pacman314159/OISP-Drone-Research/firmware/FC_v01/graphify-out/2026-10-23/GRAPH_REPORT.md

# Graph Report - FC_v01  (2026-10-23)

## Corpus Check
- 937 files · ~997,079 words
- Verdict: corpus is large enough that graph structure adds value.
- Unclassified: 425 file(s) not represented in the graph (top: .S 259, (none) 68, .defaults 16)

## Summary
- 7746 nodes · 16134 edges · 385 communities (295 shown, 90 thin omitted)
- Extraction: 85% EXTRACTED · 15% INFERRED · 0% AMBIGUOUS · INFERRED: 2412 edges (avg confidence: 0.85)
- Token cost: 0 input · 0 output

## Graph Freshness
- Built from commit: `1df59b29`
- Run `git rev-parse HEAD` and compare to check if the graph is stale.
- Run `graphify update .` after code changes (no API cost).

## Community Hubs (Navigation)
- dsp_err.h
- dsps_fft2r_sc16_ansi.c
- WS2812
- Mat
- string
- Image3DMatrix
- ESP32_I2C_ASYNC
- INA226
- Zettel 0013: Unified HAL_SPI Abstraction, 100 Hz Snapshot Logging & Multi-Rate MicroSD Storage
- BMP180
- FC_v01 Firmware Architecture & Structure Specification
- dl_tensor_base.cpp
- dl_image_define.hpp
- app.cpp
- Magnetometer Full Rotated Ellipsoid Calibration via SIMD-Accelerated Symmetric Gradient Descent
- Zettel 0016: Layer 4 Core Directory Compaction, Submodule Consolidation & Task Renaming Specification
- ESP32_SPI
- fsm.cpp
- Zettel 0032: Dual-Core 7-State Quaternion Extended Kalman Filter (EKF), SIMD Hardware Acceleration, Unit-Sphere Geomagnetic Fusion, and Inter-Task Attitude Ring Buffers
- HMC5883L
- stdint
- TensorBase
- tst_parser.cpp
- test_mat_sub_f32.cpp
- SDCardDriver
- Zettel 0008: Layer 4 LPF Filter & Calibration Task Architecture
- ipc.h
- dsps_fird_init_s16.c
- Vec3
- Attitude Outer Loop Task (100Hz)
- ekf
- MPU6050
- matrix.h
- ArgsType
- LowPassFilter2ndOrder
- kalman_filter_demo.cpp
- HAL_PulseRX
- dl_image_pixel_cvt_traits.hpp
- BlePowerPacket
- cJSON_bool
- HAL_Flash
- unity.c
- init_display.c
- ble_driver.cpp
- ESP-DSP Applications Layout
- arithArgsType
- Pad
- ESP-DSP Basic Math Example Guide
- cJSON.c
- RakefileHelpers
- HAL_PWM
- 3d_kalman_demo.cpp
- dsps_biquad_gen_f32.c
- cbor.h
- RingBuffer
- Firmware Coding Conventions & Architecture Rules
- IMU 9-DOF Sensor Fusion via Kalman Filter
- ESP-DSP Library Overview
- ESP-DSP FFT Window Example Guide
- Usage
- ESP-DSP SIMD Assembly Optimization
- ConvArgsType
- cstdint
- math
- ConvArgsType
- DetectPostprocessor
- unity.h
- cJSON_Delete
- tst_tojson.cpp
- m_test_data_s
- Zettel 0000: Firmware 5-Layer Architectural Decision & Directory Layout
- dl_module_lut.hpp
- elemwiseArgsType
- FC_v01 Architectural & Codebase Context Analysis Skill
- Rect
- sd_logger_task.cpp
- Zettel 0002: System 4 Priority Levels & Target-Agnostic HAL Decision
- FbsModel
- Zettel 0001: Centralized Task Config, Middleware ISR Callbacks & RMT PPM Decoding Decision
- rgb8882hsv
- ESP-DSP Examples Overview and Structure
- ESP-DSP FIR Filter Example Guide
- dl_module_base.hpp
- dl_image_jpeg.cpp
- PRelu
- resizeArgsType
- CPU Logo Converted 3D Matrix Image
- HSVTablesSingleton
- FFT
- cJSON_Utils.c
- Dual-Channel Audio FFT Processing Flow
- ESP-DSP Library Component Specification
- dl_audio_common.cpp
- dl_image_ppa.hpp
- module_forward_dual_core
- .get_element_ptr
- M5Stack CoreS3 Kalman Demo Component Registration
- build_all.sh
- value_to_pretty
- dspi_dotprod_off_s16_ansi
- dspi_dotprod_off_s8_ansi
- dspi_dotprod_off_u16_ansi
- dspi_dotprod_off_u8_ansi
- dspi_dotprod_s16_ansi
- dspi_dotprod_s8_ansi
- dspi_dotprod_u16_ansi
- dspi_dotprod_u8_ansi
- dspi_dotprod_f32_ansi
- dspi_dotprod_off_f32_ansi
- Model
- PixelKernel
- algorithm
- compile_finalize.py
- dsps_biquad_f32_ansi
- dl_model_base.cpp
- dl_base_add2d.cpp
- tst_Encoder
- Toolset Customization
- dl_base_div.cpp
- TensorInfo
- cborparser.c
- parse_number.c
- DetectImpl
- dsps_add_s16_ansi.c
- dl_base_sub2d.cpp
- dl_memory_manager.hpp
- fbs_loader.cpp
- bmp_file_header_t
- bmp_info_header_t
- SpeechFeatureConfig
- dl_fft_s16.c
- dsps_sub_s8_ansi.c
- dsps_sub_f32_ansi.c
- FeatImpl
- dl_detect_postprocessor.hpp
- dsps_dotprod.h
- compilersupport_p.h
- encoder/data.cpp
- ImageTransformer
- PoolArgsType
- dl_image_color_common.hpp
- FC_v01 CMake Project
- I2C1 Bus Mutex Guard
- Spectrum Box Lite CMake Project Definition
- dl_fbank.cpp
- MemoryChunk
- Usage
- .operator()
- cborencoder.c
- dl_fft_base.c
- HardSigmoid
- MemoryManagerGreedy
- cbortojson.c
- main
- AveragePool
- DataBase
- dl_power_of_two
- assembly.h
- LessOrEqual
- validate_value
- Dequantize
- ClsPostprocessor
- cJSON_Compare
- ClsImpl
- Integer Less Than / Greater Than
- ekf_imu13states.cpp
- process_frame
- cborinternal_p.h
- json2cbor.c
- dl_rfft_s32_run
- MULSHIFT32
- dl_base_max2d.cpp
- LSTM
- ESP32_PWM_LEDC
- parse_examples.c
- GRU
- dl_tool.hpp
- encodeVariant
- FbsLoader
- MP3Decode
- CMpaDecObj
- dumprecursive
- LpNormalization
- dl_base_conv_loop.cpp
- ReduceBase
- DualCoreWorkerRuntime
- ImagePreprocessor
- Transpose
- UnityToJUnit
- Arrays
- Each Equal (Arrays to Single Value)
- MatMulArgs
- dl_conv_args.hpp
- Matrix
- flash.cpp
- dl_base_norm.cpp
- Resize
- FeatImagePreprocessor
- ThrowTheSwitch.org Coding Standard
- Background and Overview
- dl_base_activate_output.hpp
- Latency
- pack_espdl_models.py
- MaxPool
- dl_model_context.cpp
- RMSNormalization
- dl_tool.cpp
- bitstream.c
- ActivationLUT
- Integer Ranges (of all sizes)
- SigmoidLUT
- LayerNormalization
- dl_module_reduce_log_sum_exp.hpp
- NormQuant<QuantType, 3>
- xy_map_t
- dl_fft2r_sc16_ansi.c
- dl_module_matmul.hpp
- dl_base_dwconv_loop.cpp
- dl_math.hpp
- Concat
- ScatterND
- ReduceMean
- unity_to_junit.py
- cJSON_Minify
- The Assertions in All Their Blessed Glory
- requantizeArgsType
- Slice
- ESP-DL
- ble_ota_uploader.py
- dl_base_avg_pool2d.cpp
- dl_module_reduce_base.hpp
- HAL_SPI
- Signed and Unsigned Integers (of all sizes)
- ESP-DL Audio Processing Module
- dl_base_min2d.cpp
- dl_base_mul2d.cpp
- array
- FbankS32
- dl_base_leakyrelu.cpp
- ReduceProd
- quant_type_to_string
- dl_base_prelu.cpp
- RGB8882RGB565
- Elu
- ParseOutput
- Double (If enabled)
- Floating Point (If enabled)
- Overview of the Documents
- dl_c_conv_tail.cpp
- Div
- Mod
- Less
- .print
- print_value.c
- Options accepted by generate_test_runner.rb:
- dl_base_pad.cpp
- dl_math_matrix.cpp
- Max
- And
- dl_base_relu.cpp
- HardSwish
- Greater
- GreaterOrEqual
- Sqrt
- Module
- Mul
- Not
- Swish
- ModelContext
- ReduceL2
- ReduceLogSum
- ReduceMin
- ReduceSum
- ReduceSumSquare
- feature_t
- Xor
- result_t
- LyraT Audio Processing Demo Guide
- dl_recognition_database.cpp
- dl_base_greater.cpp
- dl_base_pow.cpp
- dl_base_xor.cpp
- package.json
- dl_base_reduce.cpp
- UnityModuleGenerator
- Bmp180Calib
- RGB5652Gray<RGB565BE, RGBSwap, void>
- dl_audio_wav.cpp
- CBOR Example
- UnityTestSummary
- dl_base_pool2d.hpp
- dl_base_dotprod.cpp
- dl_base_isa.hpp
- Gray2Gray<ExtraProcess>
- RGB8882RGB888<RGBSwap, ExtraProcess>
- YUYV2Gray<YUYVOrUYVY, ExtraProcess>
- parse_simple_yaml
- pytest_cbor.py
- Boolean
- XtensaConvParams
- GlobalAveragePool
- esp_dsp.h
- RGB5652Gray<RGB565BE, RGBSwap, ExtraProcess>
- RGB5652HSV<RGB565BE, RGBSwap, ExtraProcess>
- RGB8882Gray<RGBSwap, ExtraProcess>
- YUYV2RGB888<YUYVOrUYVY, RGBSwap, ExtraProcess>
- bg_t
- Min
- Zettel 0015: BLE OTA Lifecycle Architecture, Resource Stewardship & Host Stack Decoupling
- ESP-DSP Complex FFT Example Guide
- misc_tests.c
- cJSON
- Masked and Bit-level Assertions
- dl_base_shape.cpp
- Gray2Gray<void>
- RGB5652RGB565
- RGB8882RGB888<RGBSwap, void>
- YUYV2Gray<YUYVOrUYVY, void>
- Or
- Sigmoid
- Sub
- ExponentInfo
- DecodeHuffman
- RGB5652RGB888<RGB565BE, RGBSwap, ExtraProcess>
- LogFileHeader
- dl_base_max_pool2d.cpp
- print_number.c
- YUYV2HSV<YUYVOrUYVY, ExtraProcess>
- dl_fft2r_sc16_dif_ansi.c
- Zettel 0007: SystemView Instrumentation & RTOS Profiling Conventions
- Security Policy
- RakefileHelpers
- Security Policy
- Building
- chmorgan__esp-libhelix-mp3/README.md
- update-docs.sh
- afl-prepare-linux.sh
- afl.sh script
- ossfuzz.sh
- dsps_conv_f32_ref
- FbsLoader::calc_package_sha256
- hand_gesture_cls_postprocessor.cpp
- dl_base_greaterorequal.cpp
- imagenet_cls_postprocessor.cpp
- dl_base_max.cpp
- RGB5652RGB888<RGB565BE, RGBSwap, void>
- dl_image_draw.cpp
- dsps_resampler_ph.c
- m5stack_core_s3/apps/3d_graphics/main/3d_graphics_demo.cpp
- dl_base_equal.cpp
- dl_base_min.cpp
- dl_base_mod.cpp
- dl_base_or.cpp
- dl_base_sub.cpp
- mem_info_s
- ChannelTracker
- dsps_add_s8_ansi.c
- dsps_add_f32_ansi.c
- dsps_mul_s8_ansi.c
- dsps_mul_f32_ansi.c
- dsps_sub_s16_ansi.c
- dspm_mult_ex_f32_ansi.c

## God Nodes (most connected - your core abstractions)
1. `Module` - 168 edges
2. `ModelContext` - 163 edges
3. `TensorBase` - 146 edges
4. `FbsModel` - 137 edges
5. `cJSON_Delete()` - 118 edges
6. `Mat` - 98 edges
7. `ArgsType` - 83 edges
8. `ConvArgsType` - 74 edges
9. `arithArgsType` - 73 edges
10. `ConvArgsType` - 71 edges

## Surprising Connections (you probably didn't know these)
- `EKF Process & UpdateRefMeasurement Recursion` --semantically_similar_to--> `EKF Roll & Pitch Task (100Hz)`  [INFERRED] [semantically similar]
  managed_components/espressif__esp-dsp/modules/kalman/ekf_imu13states/docs/README.md → documents/RTOS Architecture.pdf
- `4. Cross-References & Traceability` --references--> `motor_task()`  [INFERRED]
  documents/notes/0034-motorDriverLedcHalQuadxActuatorTaskArchitecture.md → src/core/actuator/motor_tasks.cpp
- `Zero Dynamic Allocation Flight Rule` --implements--> `accel_gyro_daq_task()`  [INFERRED]
  .agents/AGENTS.md → src/core/sensor/daq_tasks.cpp
- `System Life Cycle Document (Placeholder)` --conceptually_related_to--> `dspm_mult_ex_f32_aexx_functionality_in_cycle()`  [INFERRED]
  documents/System Life Cycle.md → managed_components/espressif__esp-dsp/modules/matrix/mul/test/test_mmult_ex_f32_aexx.cpp
- `Principle 2: Mediator & Composition Root Pattern (GoF)` --references--> `app_disarm_motors()`  [INFERRED]
  documents/notes/0035-emergencyMotorDisarmMediatorAndLawOfDemeterDecision.md → src/app/app.cpp

## Import Cycles
- None detected.

## Hyperedges (group relationships)
- **Cascaded Attitude Control Architecture** — documents_rtos_architecture_attitude_outer_loop, documents_rtos_architecture_attitude_inner_loop, documents_rtos_architecture_motor_mixer [EXTRACTED 0.95]
- **IMU Multi-Sensor Fusion Pipeline** — documents_rtos_architecture_accel_gyro_calib_filter, documents_rtos_architecture_mag_calib_filter, documents_rtos_architecture_ekf_roll_pitch, documents_rtos_architecture_ekf_yaw [EXTRACTED 0.95]
- **Sensor Data Acquisition and Ring Buffer Decoupling** — documents_rtos_architecture_accel_gyro_daq, documents_rtos_architecture_mag_daq, documents_rtos_architecture_baro_daq, documents_rtos_architecture_ring_buffer_newest_index_rule [EXTRACTED 0.95]
- **ESP-DSP Azure IoT Kit 3D Graphics Visualization Flow** — managed_components_espressif__esp_dsp_applications_azure_board_apps_apps_3d_graphics_3d_graphics_demo_animation, managed_components_espressif__esp_dsp_applications_azure_board_apps_apps_3d_graphics_3d_graphics_matrix_rendering, managed_components_espressif__esp_dsp_applications_azure_board_apps_apps_3d_graphics_readme_app_guide [EXTRACTED 1.00]
- **ESP-DSP Azure IoT Kit Kalman Filter Visualization Flow** — managed_components_espressif__esp_dsp_applications_azure_board_apps_apps_kalman_filter_kalman_filter_demo_animation, managed_components_espressif__esp_dsp_applications_azure_board_apps_apps_kalman_filter_kalman_filter_attitude_estimation, managed_components_espressif__esp_dsp_applications_azure_board_apps_apps_kalman_filter_readme_imu_sensor_fusion [EXTRACTED 1.00]
- **ESP-DSP Core Digital Signal Processing Primitives** — managed_components_espressif__esp_dsp_readme_matrix_operations, managed_components_espressif__esp_dsp_readme_fft, managed_components_espressif__esp_dsp_readme_iir_filter, managed_components_espressif__esp_dsp_readme_fir_filter, managed_components_espressif__esp_dsp_readme_vector_math, managed_components_espressif__esp_dsp_readme_kalman_filter [EXTRACTED 1.00]
- **Dual-Microphone Real-Time Audio Visualizer Pipeline** — managed_components_espressif__esp_dsp_applications_spectrum_box_lite_readme_overview, managed_components_espressif__esp_dsp_applications_spectrum_box_lite_readme_audio_pipeline, managed_components_espressif__esp_dsp_applications_spectrum_box_lite_main_idf_component_lvgl_dep [EXTRACTED 1.00]
- **ESP-DSP 3D Matrix Transformation and Projection Pipeline** — managed_components_espressif__esp_dsp_applications_azure_board_apps_readme_mat_3d_projection, managed_components_espressif__esp_dsp_applications_azure_board_apps_graphics_img_to_3d_matrix_example_readme_img_to_3d_pipeline, managed_components_espressif__esp_dsp_applications_m5stack_core_s3_apps_3d_graphics_main_cmakelists_component [INFERRED 0.95]
- **ESP-DSP Digital Filtering and Estimation Examples** — managed_components_espressif__esp_dsp_examples_fir_readme_windowed_sinc_fir, managed_components_espressif__esp_dsp_examples_iir_readme_biquad_iir_filter, managed_components_espressif__esp_dsp_examples_kalman_readme_13_state_ekf [INFERRED 0.95]
- **ESP-DSP IMU Kalman Filter Sensor Fusion Demonstrations** — managed_components_espressif__esp_dsp_readme_kalman_filter, managed_components_espressif__esp_dsp_applications_azure_board_apps_apps_kalman_filter_readme_imu_sensor_fusion, managed_components_espressif__esp_dsp_applications_m5stack_core_s3_apps_kalman_filter_readme_bmi270_bmm150_fusion [INFERRED 0.95]
- **ESP-DSP SIMD Vector and Matrix Operations Examples** — managed_components_espressif__esp_dsp_examples_dotprod_readme_vector_dot_product, managed_components_espressif__esp_dsp_examples_basic_math_readme_vector_multiplication, managed_components_espressif__esp_dsp_examples_conv2d_readme_2d_convolution, managed_components_espressif__esp_dsp_examples_matrix_cmakelists_matrix_acceleration, managed_components_espressif__esp_dsp_readme_simd_assembly_optimization [INFERRED 0.95]
- **ESP-DSP Frequency Analysis and FFT Windowing Examples** — managed_components_espressif__esp_dsp_examples_fft_readme_complex_fft_split, managed_components_espressif__esp_dsp_examples_fft4real_readme_real_fft, managed_components_espressif__esp_dsp_examples_fft_window_readme_windowing_functions, managed_components_espressif__esp_dsp_readme_fft [INFERRED 0.95]

## Communities (385 total, 90 thin omitted)

### Community 0 - "dsp_err.h"
Cohesion: 0.04
Nodes (13): dspi_conv_f32_ansi(), dsps_ccorr_f32_ansi(), dsps_conv_f32_ansi(), dsps_corr_f32_ansi(), dsps_cplx2real_fc32_ae32_(), dsps_addc_f32_ansi(), dsps_mulc_s16_ansi(), dsps_sqrt_f32_ansi() (+5 more)

### Community 1 - "dsps_fft2r_sc16_ansi.c"
Cohesion: 0.06
Nodes (43): microphone_read_task(), app_main(), ShowIIRfilter(), dsp_is_power_of_two(), dsp_power_of_two(), dsps_bit_rev_sc16_ansi(), dsps_cplx2real_sc16_ansi(), dsps_cplx2reC_sc16() (+35 more)

### Community 2 - "WS2812"
Cohesion: 0.05
Nodes (44): status_led_task(), Color, b, g, r, get_palette_color(), WS2812, brightness (+36 more)

### Community 3 - "Mat"
Cohesion: 0.04
Nodes (64): ekf::dFdq(), ekf::dFdq_inv(), ekf::eul2rotm(), ekf::qProduct(), ekf::quat2eul(), ekf::quat2rotm(), ekf::rotm2eul(), ekf::SkewSym4x4() (+56 more)

### Community 4 - "string"
Cohesion: 0.08
Nodes (20): "ekf_imu13states functionality gyro and magn", "ekf_imu13states functionality gyro only", "dspm_add_f32_ae32 benchmark", "dspm_add_f32_ae32 functionality", "dspm_add_f32_ansi benchmark", "dspm_add_f32_ansi functionality", "dspm_addc_f32_ansi benchmark", "Mat class " (+12 more)

### Community 5 - "Image3DMatrix"
Cohesion: 0.09
Nodes (6): convert_img(), create_matrix(), fromat_comas_spaces(), Image3DMatrix, main(), ouptput_files_gen()

### Community 6 - "ESP32_I2C_ASYNC"
Cohesion: 0.09
Nodes (22): ESP32_I2C_ASYNC, ESP32_I2C_ASYNC::ESP32_I2C_ASYNC(), _frequency_hz, init, _initialized, _port, read_reg_async, read_reg_multi_async (+14 more)

### Community 7 - "INA226"
Cohesion: 0.08
Nodes (31): INA226, calibrate, _current_lsb_ma, _dev_addr, get_all_data, get_all_data_raw, INA226::INA226(), init (+23 more)

### Community 8 - "Zettel 0013: Unified HAL_SPI Abstraction, 100 Hz Snapshot Logging & Multi-Rate MicroSD Storage"
Cohesion: 0.15
Nodes (11): 4-Digit Incremental File Scheme (LOG_0001.BIN) & LogFileHeader, Zettel 0013: Unified HAL_SPI Abstraction, 100 Hz Snapshot Logging & Multi-Rate MicroSD Storage, 512-Byte Self-Describing Sector-Aligned Binary Log Header (LogFileHeader), Hardware USER Button 3-Second Hold Graceful Shutdown Protocol, Zettel 0018: MicroSD Flight Logging Architecture, POSIX Metadata Sync, User Button Shutdown & Binary Log Specification, Multi-Rate Binary Telemetry Timestamp Alignment and Interpolation, Universal Flight Data Analyzer Offline Multi-Channel Processing Pipeline, Zettel 0019: Universal Flight Data Analyzer Architecture, Binary Telemetry 4-Byte Struct Alignment & Offline Multi-Rate Signal Processing Pipeline (+3 more)

### Community 9 - "BMP180"
Cohesion: 0.12
Nodes (18): baro_daq_task(), BMP180, _b5, BMP180::BMP180(), calculate_b5, calculate_pressure, calculate_temperature, _calib (+10 more)

### Community 10 - "FC_v01 Firmware Architecture & Structure Specification"
Cohesion: 0.17
Nodes (7): Deterministic Periodic Delay Policy via vTaskDelayUntil, ESP-DSP Hardware SIMD Primitive Integration, ESP32-S3 RMT Hardware PPM RC Receiver Decoding, Layer 1 SIMD HAL Zero-Fallback Hardware Purity Rule, FC_v01 Firmware Architecture & Structure Specification, Centralized Task Parameter Enums in config.h, Firmware Structure Zettelkasten Traceability Index

### Community 11 - "dl_tensor_base.cpp"
Cohesion: 0.09
Nodes (25): analyze_transpose_2d(), dtype_sizeof(), dtype_to_string(), _flip(), is_compact_row_major(), is_nan(), quantize(), _slice() (+17 more)

### Community 12 - "dl_image_define.hpp"
Cohesion: 0.10
Nodes (14): read_bmp(), write_bmp(), write_bmp_base(), align_up(), get_pix_byte_size(), get_pix_channel_num(), img_s, data (+6 more)

### Community 13 - "app.cpp"
Cohesion: 0.06
Nodes (21): Dedicated Task Mapping in src/core/telemetry/ble_telem_tasks.cpp, app_start(), fsm_init(), motor_task(), user_button_init(), ekf_roll_pitch_task(), ekf_yaw_task(), calib_save_to_nvs() (+13 more)

### Community 14 - "Magnetometer Full Rotated Ellipsoid Calibration via SIMD-Accelerated Symmetric Gradient Descent"
Cohesion: 0.14
Nodes (15): Empirical Flight Data Calibration Results & Universal Flight Analyzer Verification, ESP32-S3 128-Bit PIE SIMD Vector Dot Product Acceleration, Multivariate Analytical Gradient Derivation for Ellipsoid Optimization, Magnetometer Full Rotated Ellipsoid Calibration via SIMD-Accelerated Symmetric Gradient Descent, Real-Time Flight Loop Matrix-Vector Ellipsoid Correction, 6-Parameter Symmetric Soft-Iron Matrix Formulation, 3D Rotated Ellipsoid to Unit-Sphere Mapping Formulation, Time-Sliced SIMD Adam Gradient Descent Optimizer for Ellipsoid Fitting (+7 more)

### Community 15 - "Zettel 0016: Layer 4 Core Directory Compaction, Submodule Consolidation & Task Renaming Specification"
Cohesion: 0.13
Nodes (14): Centralized UUID Service & Characteristic Series (include/config.h), Zettel 0009: Distinct BLE GATT Characteristic UUID Isolation per Telemetry & OTA Stream Decision, Centralized Frequency Floor (BLE_TELEM_MIN_PACKET_FREQ_HZ = 10), Zettel 0010: BLE Minimum Packet Frequency and Dual-Trigger Transmission Protocol, Dynamic User-Configured Sample Stride Architecture in FCDatMon, Zettel 0011: Variable BLE Telemetry Packet Parsing and Zero-Handshake Design, Layer 4 Core Consolidation into 6 Unified Functional Domains, Zettel 0016: Layer 4 Core Directory Compaction, Submodule Consolidation & Task Renaming Specification (+6 more)

### Community 16 - "ESP32_SPI"
Cohesion: 0.15
Nodes (16): ESP32_SPI, ESP32_SPI::ESP32_SPI(), get_free_bytes, get_total_bytes, init, _initialized, is_card_inserted, is_fatfs_mounted (+8 more)

### Community 17 - "fsm.cpp"
Cohesion: 0.13
Nodes (32): Rule 5: Immediate Emergency Motor Disarm & FSM Integration, 3. Core Architectural Decisions & Governing Principles, Principle 1: Law of Demeter (Principle of Least Knowledge), Principle 2: Mediator & Composition Root Pattern (GoF), Principle 3: Single Responsibility Principle (SRP), Principle 4: Fail-Safe Defaults (Saltzer & Schroeder / Aviation Safety), app_disarm_motors(), check_match_policy() (+24 more)

### Community 18 - "Zettel 0032: Dual-Core 7-State Quaternion Extended Kalman Filter (EKF), SIMD Hardware Acceleration, Unit-Sphere Geomagnetic Fusion, and Inter-Task Attitude Ring Buffers"
Cohesion: 0.11
Nodes (19): Zettel 0003: Layer 1 SIMD HAL Architecture & Zero-Fallback Rule, ESP-DSP Multi-Type SIMD Integration, Layer 1 hal_simd Multi-Type Hardware SIMD Acceleration (float, int16_t, int8_t), Zettel 0004: Multi-Type SIMD Acceleration & ESP-DSP Build Integration, Persistent Storage of Sensor Calibration Offsets and Matrices in NVS Flash, Layer 1 Target-Decoupled HAL_Flash and Layer 2 FlashStorageDriver, Hardware SIMD Vector Hadamard Product Sensor Bias and Scale Correction, Zettel 0024: Internal Flash NVS Storage HAL, FlashStorageDriver & Diagonal Soft-Iron SIMD Calibration Persistence (+11 more)

### Community 19 - "HMC5883L"
Cohesion: 0.10
Nodes (17): Real-Time Flight Loop Calibration (m_calib = W * (m_raw - v0)), HMC5883L, _dev_addr, get_all_data, get_all_data_raw, HMC5883L::HMC5883L(), init, _inv_mag_sens (+9 more)

### Community 20 - "stdint"
Cohesion: 0.05
Nodes (17): image_3d_matrix_s, matrix_len, audio_read_task(), convert_float2short(), convert_short2float(), digitalLimiter(), convert_to_rgb(), image_display_task() (+9 more)

### Community 21 - "TensorBase"
Cohesion: 0.03
Nodes (39): cjson_array_foreach_should_loop_over_arrays(), forward_template(), Gather, m_axis, m_indices, forward_template(), forward_template(), Reshape (+31 more)

### Community 22 - "tst_parser.cpp"
Cohesion: 0.04
Nodes (79): cbor_error_string(), addChunkedStringData(), addColumns(), addEmptyContainersData(), addFixedData(), addIntegers(), addMapMixedData(), addNonChunkedStringsData() (+71 more)

### Community 23 - "test_mat_sub_f32.cpp"
Cohesion: 0.16
Nodes (28): System Life Cycle Document (Placeholder), Copy, Get, getROI, inverse, pinv, test_assert_check_area_mat_mat(), test_assert_equal_mat_mat() (+20 more)

### Community 24 - "SDCardDriver"
Cohesion: 0.12
Nodes (20): Autonomous 100 Hz Periodic Task & Zero-Overhead Ring Buffer Snapshot Draining (sd_logger_task), append_packet(), sd_logger_task(), SDCardDriver, _bytes_written, _cd_pin, close, _cs_pin (+12 more)

### Community 25 - "Zettel 0008: Layer 4 LPF Filter & Calibration Task Architecture"
Cohesion: 0.15
Nodes (11): BLE Characteristic UUID Isolation Reference, Dual Execution Engine (SIMD vs Scalar LPF), IPC Clean Variable Naming & Ring Buffer Consolidation, Layer 4 DSP Filter & Calibration Scoping Rule, Zettel 0008: Layer 4 LPF Filter & Calibration Task Architecture, Harmonized Sensor Ring Buffer Architecture (accel, gyro, mag), Unification of Barometer Pressure Ring Buffer, Zettel 0022: Unified Pressure Ring Buffer, Filtered Sensor Variable Consolidation & Phantom Attitude Task Removal (+3 more)

### Community 26 - "ipc.h"
Cohesion: 0.06
Nodes (26): CalibReportMsg, current_step, progress_pct, status, target, timestamp_us, FlashStorageDriver, LedCommand (+18 more)

### Community 27 - "dsps_fird_init_s16.c"
Cohesion: 0.06
Nodes (16): dsps_16_array_rev(), dsps_fird_init_s16(), dsps_fird_s16_aexx_free(), dsps_firmr_init_s16(), dsps_fir_f32_ansi(), dsps_fir_f32_free(), dsps_fir_init_f32(), dsps_firmr_init_f32() (+8 more)

### Community 28 - "Vec3"
Cohesion: 0.12
Nodes (23): Layer 4 Matrix<T, ROWS, COLS> Template Architecture, Unified Matrix<T, ROWS, COLS> Template Architecture, AttitudeEKF, AttitudeEKF::AttitudeEKF(), _earth_bx, _earth_bz, get_euler_angles, get_gyro_bias (+15 more)

### Community 29 - "Attitude Outer Loop Task (100Hz)"
Cohesion: 0.12
Nodes (19): Accel Gyro Calib & Filter Task (250Hz), Accel Gyro DAQ Task (500Hz), Altitude & Vz Estimator Task (100Hz), Attitude Inner Loop Task (250Hz, 4 Pri), Attitude Outer Loop Task (100Hz), Barometer Calib & Filter Task, Barometer DAQ Task, EKF Roll & Pitch Task (100Hz) (+11 more)

### Community 30 - "ekf"
Cohesion: 0.06
Nodes (36): image_3d_matrix_kalman_s, ekf13, matrix_len, ekf::RungeKutta(), ekf_imu13states::Test(), ekf_imu13states, accel0, Init (+28 more)

### Community 31 - "MPU6050"
Cohesion: 0.05
Nodes (33): 500 Hz Core IMU Loop Frequency Rule, BLE Telemetry 500 Hz Non-Blocking Data Flow, GyroTelemetrySample IPC Data Contract, 5-Layer Decoupled Firmware Architecture, Layer 1: Platform HAL & Hardware Target Drivers, Layer 2: Sensor & Peripheral Drivers Layer, Layer 4: Flight Core & Algorithms Layer, Layer 5: Application Layer (+25 more)

### Community 32 - "matrix.h"
Cohesion: 0.28
Nodes (8): dot(), hadamard(), inverse3x3(), Matrix, norm(), norm_sq(), normalize(), operator+()

### Community 33 - "ArgsType"
Cohesion: 0.03
Nodes (64): ArgsType, activation_alpha, activation_alpha_ptr, activation_shift, activation_type, auto_split, bias_element, c_div_x_1 (+56 more)

### Community 34 - "LowPassFilter2ndOrder"
Cohesion: 0.09
Nodes (26): Tustin Bilinear 1st-Order Low-Pass Filter State (LowPassFilter1stOrder), ButterworthFilter, LowPassFilter1stOrder, a, b, initialized, x_prev, y_prev (+18 more)

### Community 35 - "kalman_filter_demo.cpp"
Cohesion: 0.18
Nodes (14): app_fbm320_init(), app_mag3110_init(), app_main(), app_ssd1306_init(), display_3d_image(), draw_3d_image(), get_initial_pressure(), get_pressure_task() (+6 more)

### Community 36 - "HAL_PulseRX"
Cohesion: 0.09
Nodes (21): PktRc, channels, _pad, timestamp_us, type, FS_iA6B, FS_iA6B::FS_iA6B(), init (+13 more)

### Community 37 - "dl_image_pixel_cvt_traits.hpp"
Cohesion: 0.02
Nodes (96): hsv_mask_extra_traits, hsv_mask_extra_traits<DL_IMAGE_PIX_CVT_BGR565BE2HSV_MASK, Across>, hsv_mask_extra_traits<DL_IMAGE_PIX_CVT_BGR565LE2HSV_MASK, Across>, hsv_mask_extra_traits<DL_IMAGE_PIX_CVT_BGR8882HSV_MASK, Across>, hsv_mask_extra_traits<DL_IMAGE_PIX_CVT_RGB565BE2HSV_MASK, Across>, hsv_mask_extra_traits<DL_IMAGE_PIX_CVT_RGB565LE2HSV_MASK, Across>, hsv_mask_extra_traits<DL_IMAGE_PIX_CVT_RGB8882HSV_MASK, Across>, hsv_mask_extra_traits<DL_IMAGE_PIX_CVT_UYVY2HSV_MASK, Across> (+88 more)

### Community 38 - "BlePowerPacket"
Cohesion: 0.25
Nodes (6): BlePowerPacket, current_ma, energy_mah, power_mw, timestamp, voltage_mv

### Community 39 - "cJSON_bool"
Cohesion: 0.19
Nodes (23): buffer_skip_whitespace(), cJSON_ParseWithLengthOpts(), cJSON_PrintBuffered(), compare_double(), ensure(), get_decimal_point(), parse_array(), parse_hex4() (+15 more)

### Community 40 - "HAL_Flash"
Cohesion: 0.16
Nodes (14): FlashStorageDriver, calculate_crc32, erase_namespace, erase_record, init, _initialized, read_record, write_record (+6 more)

### Community 41 - "unity.c"
Cohesion: 0.08
Nodes (63): announceTestRun(), groupSelected(), isOverrun(), release_memory(), selected(), testSelected(), unity_calloc(), unity_free() (+55 more)

### Community 42 - "init_display.c"
Cohesion: 0.19
Nodes (9): bsp_display_lcd_init(), bsp_enable_feature(), bsp_i2c_init(), bsp_spi_init(), display_init(), dsp_display_brightness_init(), dsp_display_new(), dsp_display_start_with_config() (+1 more)

### Community 43 - "ble_driver.cpp"
Cohesion: 0.08
Nodes (24): Layer 4 Task Identity Preservation (TASK_BLE_OTA_ID), app_suspend_all_tasks(), ble_ota_task(), BleTelemetryChannel, _last_ingested_ts, _last_send_tick, _mask_bit, _payload_buf (+16 more)

### Community 45 - "ESP-DSP Applications Layout"
Cohesion: 0.24
Nodes (11): esp-dsp-azure-board-app-3d-graphics Project, Azure 3D Graphics Demo Application Guide, ImgTo3D Generation Example Guide, ImgTo3D 2D to 3D Matrix Generator Pipeline, ESP-DSP Azure IoT Kit Demo Applications, ESP-DSP Mat Matrix 3D Projection & Transformation, esp-dsp-m5stack-3d-graphics Project, M5Stack Core S3 3D Graphics Main Component (+3 more)

### Community 46 - "arithArgsType"
Cohesion: 0.04
Nodes (49): arithArgsType, activation_alpha, activation_alpha_ptr, activation_shift, activation_type, c_div_2x_1, c_div_x_1, c_left_x_1 (+41 more)

### Community 47 - "Pad"
Cohesion: 0.18
Nodes (5): Pad, m_constant_value, m_mode, m_pads, pad

### Community 48 - "ESP-DSP Basic Math Example Guide"
Cohesion: 0.15
Nodes (11): ESP-DSP Basic Math Example Project, ESP-DSP Basic Math Main Component, ESP-DSP Basic Math Component Dependency Manifest, ESP-DSP Basic Math Example Guide, ESP-DSP Vector Multiplication Operations (dsps_mul_f32, dsps_mulc_f32), ESP-DSP Dot Product Example Project, ESP-DSP Dot Product Main Component, ESP-DSP Dot Product Component Dependency Manifest (+3 more)

### Community 49 - "cJSON.c"
Cohesion: 0.09
Nodes (78): add_item_to_array(), add_item_to_object(), case_insensitive_strcmp(), cast_away_const(), cJSON_AddItemReferenceToArray(), cJSON_AddItemReferenceToObject(), cJSON_AddItemToArray(), cJSON_AddItemToObject() (+70 more)

### Community 50 - "RakefileHelpers"
Cohesion: 0.05
Nodes (9): colour_print(), colour_puts(), ColourCommandLine, report(), UnityTestRunnerGenerator, TypeSanitizer, UnityTestSummary, RakefileHelpers (+1 more)

### Community 51 - "HAL_PWM"
Cohesion: 0.07
Nodes (35): 1. Metadata & Scope, 2. Problem Statement & Motivation, 3. Core Architectural Decisions, 4. Cross-References & Traceability, Rule 1: Layer 1 Platform HAL Abstraction (`HAL_PWM` & `ESP32_PWM_LEDC`), Rule 2: Layer 2 Motor Peripheral Driver (`MotorDriver`), Rule 3: Layer 3 Inter-Task IPC (`IndiControllerOutput`), Rule 4: Layer 4 Actuator Domain (`src/core/actuator/motor_tasks.cpp/.h`) (+27 more)

### Community 52 - "3d_kalman_demo.cpp"
Cohesion: 0.10
Nodes (25): ESP-DSP Changelog Document, app_main(), app_ssd1306_init(), dispaly_esp_text(), display_3d_image(), draw_3d_image_task(), init_3d_matrix_struct(), init_perspective_matrix() (+17 more)

### Community 53 - "dsps_biquad_gen_f32.c"
Cohesion: 0.26
Nodes (12): audio_process_task(), buttons_process_task(), dsps_biquad_gen_allpass180_f32(), dsps_biquad_gen_allpass360_f32(), dsps_biquad_gen_bpf0db_f32(), dsps_biquad_gen_bpf_f32(), dsps_biquad_gen_highShelf_f32(), dsps_biquad_gen_hpf_f32() (+4 more)

### Community 54 - "cbor.h"
Cohesion: 0.11
Nodes (47): dumpbytes(), example_dump_cbor_buffer(), indent(), _cbor_encoder_get_buffer_pointer(), cbor_value_begin_string_iteration(), cbor_value_copy_byte_string(), cbor_value_copy_text_string(), cbor_value_dup_byte_string() (+39 more)

### Community 55 - "RingBuffer"
Cohesion: 0.23
Nodes (3): RingBuffer, _buffer, _head

### Community 56 - "Firmware Coding Conventions & Architecture Rules"
Cohesion: 0.15
Nodes (12): Firmware Coding Conventions & Architecture Rules, Single-Line Control Flow & No-Space Bracing Style, Centralized Task Parameters Rule, Coding Conventions & Architecture Rules, Explicit Physical SI Units Rule, SystemView Tracing & RTOS Timing Conventions, FreeRTOS Task Scoping Architecture Rule, Max Ducson (Chief Mechatronics Engineer) (+4 more)

### Community 57 - "IMU 9-DOF Sensor Fusion via Kalman Filter"
Cohesion: 0.17
Nodes (12): ESP32-Azure IoT Kit 3D Graphics Demo Animation, 3D Matrix Transformation and Projection on LCD, esp-dsp-azure-board-app-kalman-filter Project, Real-Time 3D Attitude Estimation and Sensor Fusion Display, ESP32-Azure IoT Kit Kalman Filter IMU Demo Animation, Azure Kalman Filter Main Component, Azure Kalman Filter IDF Component Manifest, Azure Kalman Filter Demo Application Guide (+4 more)

### Community 58 - "ESP-DSP Library Overview"
Cohesion: 0.25
Nodes (8): ESP-DSP Pre-Commit Hook Configurations, Azure 3D Graphics Main Component, Azure 3D Graphics IDF Component Manifest, LyraT Audio App Project, LyraT Audio Main Component, LyraT Audio IDF Component Manifest, ESP-DSP Contribution Guide, ESP-DSP Library Overview

### Community 59 - "ESP-DSP FFT Window Example Guide"
Cohesion: 0.15
Nodes (11): ESP-DSP Real Input FFT Example Project, ESP-DSP Real Input FFT Main Component, ESP-DSP Real Input FFT Component Dependency Manifest, ESP-DSP Real Input FFT Example Guide, Real Input Fast Fourier Transform (dsps_fft4r_fc32), ESP-DSP FFT Window Example Project, ESP-DSP FFT Window Main Component, ESP-DSP FFT Window Component Dependency Manifest (+3 more)

### Community 60 - "Usage"
Cohesion: 0.08
Nodes (24): Building, C Standard, Case Sensitivity, Caveats, Character Encoding, cJSON, CMake, copying the source (+16 more)

### Community 61 - "ESP-DSP SIMD Assembly Optimization"
Cohesion: 0.29
Nodes (5): ESP-DSP 2D Convolution Example Project, ESP-DSP 2D Convolution Main Component, ESP-DSP 2D Convolution Component Dependency Manifest, ESP-DSP 2D Convolution Image Processing (dspi_conv_f32), ESP-DSP 2D Convolution Example Guide

### Community 62 - "ConvArgsType"
Cohesion: 0.03
Nodes (65): ConvArgsType, activation_alpha, activation_alpha_ptr, activation_shift, activation_type, auto_split, bias_element, c_div_x_1 (+57 more)

### Community 63 - "cstdint"
Cohesion: 0.05
Nodes (32): Layer 3: Middleware & Centralized Inter-Task IPC Layer, Centralized Inter-Task IPC in Layer 3 (src/middleware/), FlashRecordHeader, crc32, magic, payload_len, schema_ver, BleAttQuatPacket (+24 more)

### Community 64 - "math"
Cohesion: 0.04
Nodes (27): WinMain(), void(), AssertEqualExampleStruct(), app_main(), process_and_show(), app_main(), app_main(), app_main() (+19 more)

### Community 65 - "ConvArgsType"
Cohesion: 0.03
Nodes (85): can_split_conv_width(), conv_1x1_body_view(), conv_buffer_bytes(), conv_each_1x1_pad(), conv_feature_bytes(), conv_filter_bytes(), conv_full_window_end(), conv_has_padding() (+77 more)

### Community 66 - "DetectPostprocessor"
Cohesion: 0.15
Nodes (8): DetectPostprocessor, m_box_list, m_image_preprocessor, m_model, m_nms_thr, m_score_thr, m_top_k, postprocess

### Community 67 - "unity.h"
Cohesion: 0.05
Nodes (59): reset(), sort_tests(), assert_is_array(), assert_not_array(), assert_parse_array(), parse_array_should_not_parse_non_arrays(), parse_array_should_parse_arrays_with_multiple_elements(), parse_array_should_parse_arrays_with_one_element() (+51 more)

### Community 68 - "cJSON_Delete"
Cohesion: 0.06
Nodes (84): cJSON_AddArrayToObject(), cJSON_AddBoolToObject(), cJSON_AddFalseToObject(), cJSON_AddNullToObject(), cJSON_AddNumberToObject(), cJSON_AddObjectToObject(), cJSON_AddRawToObject(), cJSON_AddStringToObject() (+76 more)

### Community 69 - "tst_tojson.cpp"
Cohesion: 0.08
Nodes (40): addByteStringsData(), addColumns(), addEmptyContainersData(), addFixedData(), addNonJsonData(), addTextStringsData(), compareMetaData(), compareOne_real() (+32 more)

### Community 70 - "m_test_data_s"
Cohesion: 0.18
Nodes (11): m_test_data_s, A_start_col, A_start_row, B_start_col, B_start_row, C_start_col, C_start_row, k (+3 more)

### Community 71 - "Zettel 0000: Firmware 5-Layer Architectural Decision & Directory Layout"
Cohesion: 0.17
Nodes (9): Custom Dual OTA Partition Scheme (8MB Layout), Project: FC_v01 Firmware & 5-Layer RTOS Architecture, 5-Layer Decoupled RTOS Architecture Project Scope, Centralized Interface Contracts (config.h, ipc.h, ble_driver.h), Sarah Thueson (Embedded Software Architect), 5-Layer Decoupled Firmware Architecture Decision, FreeRTOS Task Scoping Restricted to Layer 4 (core/) or Layer 5 (app/), Zettel 0000: Firmware 5-Layer Architectural Decision & Directory Layout (+1 more)

### Community 72 - "dl_module_lut.hpp"
Cohesion: 0.03
Nodes (22): Clip, forward_template(), Exp, forward_template(), forward_template(), forward_template(), LeakyRelu, alpha (+14 more)

### Community 73 - "elemwiseArgsType"
Cohesion: 0.08
Nodes (50): elemwise_add(), elemwise_and(), elemwise_div(), calculate_elemwise_stride(), elemwise_loop_1d(), elemwise_loop_2d(), elemwise_loop_3d(), elemwise_loop_4d() (+42 more)

### Community 74 - "FC_v01 Architectural & Codebase Context Analysis Skill"
Cohesion: 0.25
Nodes (7): Graphify Knowledge Graph Rule, Graphify Query Before Grep Rule, FC_v01 Architectural & Codebase Context Analysis Skill, Codebase Graph Traversal Workflow, Zettelkasten Note Vault & ADR Scan Workflow, Workflow: analyze-context, analyze-context Execution Pipeline

### Community 75 - "Rect"
Cohesion: 0.12
Nodes (17): a, b, app_main(), ekf_imu13states::StateXdot(), SkewSym4x4, Rect, areaRect, height (+9 more)

### Community 76 - "sd_logger_task.cpp"
Cohesion: 0.04
Nodes (42): PktAttEuler, euler, timestamp_us, type, PktAttQuat, q, timestamp_us, type (+34 more)

### Community 77 - "Zettel 0002: System 4 Priority Levels & Target-Agnostic HAL Decision"
Cohesion: 0.11
Nodes (16): Adam Optimizer Monotonic Convergence & 3-Plane Projection Verification, Quadric Mean Squared Error Cost Function e(v0, W), Magnetometer Full Rotated Ellipsoid Calibration via SIMD-Accelerated Symmetric Gradient Descent, ESP32-S3 128-Bit SIMD Inner-Loop Acceleration (Vec4f Alignment), Multivariate Matrix Calculus Gradient Derivations for v0 and W, Hard-Iron Bias and Soft-Iron Distortion Problem Formulation, 6-Parameter Symmetric Soft-Iron Matrix Formulation (9-Parameter General Ellipsoid), Centralized Inter-Task Communication in src/middleware/ipc.h and ipc.cpp (+8 more)

### Community 78 - "FbsModel"
Cohesion: 0.04
Nodes (47): FbsModel, clear_map, get_graph_inputs, get_graph_outputs, get_model_doc_string, get_model_metadata_prop, get_model_name, get_model_size (+39 more)

### Community 79 - "Zettel 0001: Centralized Task Config, Middleware ISR Callbacks & RMT PPM Decoding Decision"
Cohesion: 0.10
Nodes (20): Zettel 0001: Centralized Task Config, Middleware ISR Callbacks & RMT PPM Decoding Decision, Centralized Enum Task Parameter Declarations (include/config.h), Zettel 0006: Centralized Task Parameter Enums & Direct Driver Passing, Deterministic Bitmask Event-Driven State Transition Engine, Pre-Flight Sensor Health Verification and Stationary Detection Gating, Non-Blocking User Button ISR and Decoupled FreeRTOS Queue Event Flow, Zettel 0020: Finite State Machine Backbone, Pre-Flight Sensor Checks & Active Calibration Architecture, Multi-Rate Timestamp Freshness and Inter-Arrival Latency Verification (+12 more)

### Community 80 - "rgb8882hsv"
Cohesion: 0.11
Nodes (8): rgb8882hsv(), yuv2rgb888(), RGB8882HSV<RGBSwap, void>, dst_bpp, src_bpp, YUYV2RGB888<YUYVOrUYVY, RGBSwap, void>, dst_bpp, src_bpp

### Community 81 - "ESP-DSP Examples Overview and Structure"
Cohesion: 0.20
Nodes (10): ESP-DSP Extended Kalman Filter Example Project, ESP-DSP Extended Kalman Filter Main Component, ESP-DSP Extended Kalman Filter Component Dependency Manifest, 13-State Extended Kalman Filter for IMU Attitude Estimation, ESP-DSP Extended Kalman Filter Example Guide, ESP-DSP Matrix Multiply and Inversion SIMD Operations (dspm_mult_f32), ESP-DSP Matrix Operations Example Project, ESP-DSP Examples Overview and Structure (+2 more)

### Community 82 - "ESP-DSP FIR Filter Example Guide"
Cohesion: 0.29
Nodes (6): ESP-DSP FIR Filter Example Project, ESP-DSP FIR Filter Main Component, ESP-DSP FIR Filter Component Dependency Manifest, ESP-DSP FIR Filter Example Guide, Windowed-Sinc Finite Impulse Response (FIR) Filter with Decimation (dsps_fird_f32), ESP-DSP Finite Impulse Response (FIR) Filter

### Community 83 - "dl_module_base.hpp"
Cohesion: 0.07
Nodes (5): lut_s8(), lut_s8_c(), depth_to_space_crd(), depth_to_space_dcr(), space_to_depth()

### Community 84 - "dl_image_jpeg.cpp"
Cohesion: 0.18
Nodes (8): hw_decode_jpeg(), hw_encode_jpeg(), hw_encode_jpeg_base(), read_jpeg(), sw_decode_jpeg(), sw_encode_jpeg(), sw_encode_jpeg_base(), write_jpeg()

### Community 85 - "PRelu"
Cohesion: 0.16
Nodes (3): forward_template(), PRelu, m_alpha

### Community 86 - "resizeArgsType"
Cohesion: 0.06
Nodes (44): bilinear_weight_q14(), dequant_inline(), get_resize_operation_args(), linear_coeffs(), load_resize_nearest_2x2_c1_s8(), load_resize_nearest_c1_s8(), quant_inline(), resize() (+36 more)

### Community 87 - "CPU Logo Converted 3D Matrix Image"
Cohesion: 0.33
Nodes (6): CPU Logo Converted 3D Matrix Image, Monochrome CPU Microcontroller Dot-Matrix Representation, CPU Logo Inverted Color Monochromatic Preview (64x64), Inverted Monochromatic Dot-Matrix Display Buffer, 2D Chip Graphic Input for 3D Matrix Transformation, CPU Microcontroller 2D Logo Source Image (PNG)

### Community 88 - "HSVTablesSingleton"
Cohesion: 0.09
Nodes (13): HSVTablesSingleton, hsv_shift, m_hdiv_table, m_sdiv_table, RGB5652HSV<RGB565BE, RGBSwap, void>, dst_bpp, src_bpp, RGB8882HSV<RGBSwap, ExtraProcess> (+5 more)

### Community 89 - "FFT"
Cohesion: 0.10
Nodes (12): FFT, clearing_, cv_, fft_f32_handles, fft_s16_handles, fft_s32_handles, in_flight_, m_caps (+4 more)

### Community 90 - "cJSON_Utils.c"
Cohesion: 0.16
Nodes (41): cJSON_free(), cJSON_IsArray(), cJSON_malloc(), apply_patch(), cJSONUtils_AddPatchToArray(), cJSONUtils_ApplyPatches(), cJSONUtils_ApplyPatchesCaseSensitive(), cJSONUtils_FindPointerFromObjectTo() (+33 more)

### Community 91 - "Dual-Channel Audio FFT Processing Flow"
Cohesion: 0.40
Nodes (4): LVGL Graphics Integration for Spectrum Display, Spectrum Box Lite Component Dependencies, Dual-Channel Audio FFT Processing Flow, ESP32-S3-BOX-Lite Spectrum Demo Overview

### Community 92 - "ESP-DSP Library Component Specification"
Cohesion: 0.40
Nodes (4): Matrix Example Component Manifest, ESP-DSP Library Component Specification, Main Firmware Component Build Configuration, Firmware ESP-DSP Component Dependency

### Community 93 - "dl_audio_common.cpp"
Cohesion: 0.10
Nodes (23): dl_rfft_f32_deinit(), dl_rfft_f32_init(), hz2mel(), mel2hz(), mel_dotprod(), mel_filter_deinit(), mel_filter_init(), mel_filter_q30_deinit() (+15 more)

### Community 94 - "dl_image_ppa.hpp"
Cohesion: 0.15
Nodes (3): get_ppa_scale(), register_ppa_srm_client(), resize_ppa()

### Community 95 - "module_forward_dual_core"
Cohesion: 0.04
Nodes (26): ConvOpArgs, m_args, forward_args, Conv, activation, is_bias_reseted, m_dilations, m_fn (+18 more)

### Community 96 - ".get_element_ptr"
Cohesion: 0.04
Nodes (15): insert, MemoryManagerGreedy::alloc_internal_tensor(), MemoryManagerGreedy::alloc_tensor(), sort_memory_list(), forward_template(), Log, LogSoftmax, m_axis (+7 more)

### Community 97 - "M5Stack CoreS3 Kalman Demo Component Registration"
Cohesion: 0.50
Nodes (3): M5Stack CoreS3 Kalman Demo Component Registration, M5Stack CoreS3 Board Support Package Dependency, M5Stack CoreS3 Kalman Demo Component Manifest

### Community 98 - "build_all.sh"
Cohesion: 0.83
Nodes (3): build_for_targets(), die(), build_all.sh script

### Community 99 - "value_to_pretty"
Cohesion: 0.17
Nodes (13): cbor_value_to_pretty_stream(), container_to_pretty(), convertToUint64(), get_indicator(), hexDump(), printRecursionLimit(), resolve_indicator(), cbor_fprintf() (+5 more)

### Community 110 - "Model"
Cohesion: 0.07
Nodes (25): Model, build, get_input, get_intermediate, get_output, load, m_doc_string, m_execution_plan (+17 more)

### Community 111 - "PixelKernel"
Cohesion: 0.07
Nodes (29): c, bind_thunk(), hsv_param_t, max, min, set, make_hsv_mask_extra_kernel(), make_hsv_mask_extra_kernel_impl() (+21 more)

### Community 112 - "algorithm"
Cohesion: 0.11
Nodes (25): conv_c_requant_s16(), conv_c_requant_s16_i32(), conv_c_scratch_alloc(), conv_c_sum_from_sh(), conv2d_11cn(), conv2d_1x1_s16_fast(), conv2d_1x1_s8_fast(), conv2d_33cn() (+17 more)

### Community 113 - "compile_finalize.py"
Cohesion: 0.12
Nodes (27): _c_intern(), conv_rule_slots(), conv_select_rows(), conv_slot_name(), intern_names(), kernel_if(), kernel_name_set(), kernel_symbol_list() (+19 more)

### Community 114 - "dsps_biquad_f32_ansi"
Cohesion: 0.33
Nodes (3): dsps_biquad_f32_ansi(), main(), test_iir_biquad()

### Community 115 - "dl_model_base.cpp"
Cohesion: 0.06
Nodes (28): get_memory_info, get_metadata_prop, get_module_info, print_module_info, gen_sep_str(), Model::build(), Model::get_input(), Model::get_intermediate() (+20 more)

### Community 116 - "dl_base_add2d.cpp"
Cohesion: 0.18
Nodes (5): add2d(), add2d_11c(), add2d_11c_rescale(), load_add2d_11c_s16(), load_add2d_11c_s8()

### Community 117 - "tst_Encoder"
Cohesion: 0.10
Nodes (24): addColumns(), addStringsData(), raw(), compare(), encodeOne(), tst_Encoder, arrays, arraysAndMaps_data (+16 more)

### Community 118 - "Toolset Customization"
Cohesion: 0.05
Nodes (38): C Standards, Compilers and Microcontrollers, Floating Point Types, Getting Into The Guts, Happy Porting, Integer Types, `main()`, `RUN_TEST`, The Options (+30 more)

### Community 119 - "dl_base_div.cpp"
Cohesion: 0.31
Nodes (5): c_impl_div_1_n(), c_impl_div_n_1(), c_impl_div_n_n(), create_div_lut(), get_elemwise_div_args()

### Community 120 - "TensorInfo"
Cohesion: 0.06
Nodes (20): TensorInfo, call_times, create_tensor, dtype, exponent, internal_offset, is_internal, m_follower_clean_tensor (+12 more)

### Community 121 - "cborparser.c"
Cohesion: 0.18
Nodes (31): cbor_value_is_container(), advance_bytes(), advance_internal(), advance_recursive(), cbor_parser_init(), cbor_parser_init_reader(), cbor_value_advance(), cbor_value_advance_fixed() (+23 more)

### Community 122 - "parse_number.c"
Cohesion: 0.26
Nodes (10): assert_is_number(), assert_parse_big_number(), assert_parse_number(), parse_number_should_parse_big_numbers(), parse_number_should_parse_negative_integers(), parse_number_should_parse_negative_reals(), parse_number_should_parse_positive_integers(), parse_number_should_parse_positive_reals() (+2 more)

### Community 123 - "DetectImpl"
Cohesion: 0.13
Nodes (13): Detect, get_raw_model, DetectImpl, get_raw_model, m_image_preprocessor, m_model, m_postprocessor, DetectWrapper (+5 more)

### Community 125 - "dl_base_sub2d.cpp"
Cohesion: 0.18
Nodes (5): load_sub2d_11c_s16(), load_sub2d_11c_s8(), sub2d(), sub2d_11c(), sub2d_11c_rescale()

### Community 126 - "dl_memory_manager.hpp"
Cohesion: 0.22
Nodes (3): MemoryManagerBase, alignment, alloc

### Community 127 - "fbs_loader.cpp"
Cohesion: 0.17
Nodes (18): create_fbs_model(), fbs_aes_crypt_ctr(), FbsLoader::FbsLoader(), FbsLoader::get_model_format(), FbsLoader::get_model_name(), FbsLoader::get_model_num(), FbsLoader::get_package_sha256(), FbsLoader::get_package_version() (+10 more)

### Community 128 - "bmp_file_header_t"
Cohesion: 0.33
Nodes (6): bmp_file_header_t, file_size, file_type, offset_data, reserved1, reserved2

### Community 129 - "bmp_info_header_t"
Cohesion: 0.17
Nodes (12): bmp_info_header_t, bit_count, colors_important, colors_used, compression, height, planes, size (+4 more)

### Community 130 - "SpeechFeatureConfig"
Cohesion: 0.05
Nodes (35): get_frame_num(), next_power_of_2(), Spectrogram, m_cache, m_fft_config, m_win_func, print_speech_feature_config(), SpeechFeatureBase (+27 more)

### Community 131 - "dl_fft_s16.c"
Cohesion: 0.13
Nodes (15): dl_is_power_of_two(), dl_fft_table_acquire(), dl_fft_table_release(), dl_fft_f32_deinit(), dl_fft_f32_init(), dl_fft_f32_run(), dl_ifft_f32_run(), dl_fft_s16_deinit() (+7 more)

### Community 134 - "FeatImpl"
Cohesion: 0.09
Nodes (22): Feat, get_feat_len, get_raw_model, run, FeatImpl, get_feat_len, get_raw_model, m_image_preprocessor (+14 more)

### Community 135 - "dl_detect_postprocessor.hpp"
Cohesion: 0.06
Nodes (29): dequantize(), ESPDetPostProcessor, ESPDetPostProcessor::parse_stage(), postprocess, MNPPostprocessor, MNPPostprocessor::parse_stage(), postprocess, MSRPostprocessor (+21 more)

### Community 136 - "dsps_dotprod.h"
Cohesion: 0.09
Nodes (7): dsps_dotprod_s16_ansi(), dsps_dp_s8_ansi(), dsps_dotprod_f32_ansi(), dsps_dotprode_f32_ansi(), dspm_mult_mxn_1xm_int8_ansi(), dspm_mult_s16_ansi(), dspm_mult_f32_ansi()

### Community 137 - "compilersupport_p.h"
Cohesion: 0.08
Nodes (9): _cbor_value_dup_string(), add_check_overflow(), mul_check_overflow(), open_memstream(), write_to_buffer(), dumpFile(), main(), printerror() (+1 more)

### Community 138 - "encoder/data.cpp"
Cohesion: 0.11
Nodes (24): addArraysAndMaps(), addFixedData(), addHalfFloat(), Float16Standin, val, IndeterminateLengthArray, IndeterminateLengthMap, make_ilarray() (+16 more)

### Community 139 - "ImageTransformer"
Cohesion: 0.12
Nodes (28): pix_cvt_is_2pix(), ImageTransformer, cvt_color, cvt_color_border, ensure_kernel, fill_warp_offset, gen_bg, gen_xy_map (+20 more)

### Community 140 - "PoolArgsType"
Cohesion: 0.06
Nodes (33): PoolArgsType, avg_pool_area, avg_pool_area_inv, c_div_x_1, c_remainder, filter_height, filter_width, input_channel (+25 more)

### Community 141 - "dl_image_color_common.hpp"
Cohesion: 0.14
Nodes (11): Gray2Gray, RGB5652Gray, RGB5652HSV, RGB5652RGB888, RGB8882Gray, RGB8882HSV, RGB8882RGB888, YUYV2Gray (+3 more)

### Community 145 - "dl_fbank.cpp"
Cohesion: 0.20
Nodes (13): ln_u64_q36(), mulhu(), sqrt_u64_q8(), bit_len32(), bit_len64(), process_frame_int16, linear_to_s16(), ln_add_q36() (+5 more)

### Community 146 - "MemoryChunk"
Cohesion: 0.09
Nodes (17): MemoryChunk, alignment, extend, is_free, merge_free_chunk, offset, size, tensor (+9 more)

### Community 147 - "Usage"
Cohesion: 0.14
Nodes (14): C Standard, Case Sensitivity, Caveats, Character Encoding, Deep Nesting Of Arrays And Objects, Duplicate Object Members, Example, Floating Point Numbers (+6 more)

### Community 148 - ".operator()"
Cohesion: 0.55
Nodes (6): extract_channel1_from_rgb565be(), extract_channel1_from_rgb565le(), extract_channel2_from_rgb565be(), extract_channel2_from_rgb565le(), extract_channel3_from_rgb565be(), extract_channel3_from_rgb565le()

### Community 149 - "cborencoder.c"
Cohesion: 0.19
Nodes (25): cbor_encode_double(), advance_ptr(), append_byte_to_buffer(), append_to_buffer(), cbor_encode_byte_string(), cbor_encode_floating_point(), cbor_encode_int(), cbor_encode_negative_int() (+17 more)

### Community 150 - "dl_fft_base.c"
Cohesion: 0.13
Nodes (17): dl_array_max_q_f32(), dl_bitrev2r_sc16(), dl_bitrev2r_sc16_ansi(), dl_fft_cfg_round(), dl_float_to_short(), dl_rfft_post_proc_sc16(), dl_rfft_post_proc_sc16_ansi(), dl_rfft_pre_proc_sc16() (+9 more)

### Community 151 - "HardSigmoid"
Cohesion: 0.18
Nodes (3): HardSigmoid, alpha, beta

### Community 152 - "MemoryManagerGreedy"
Cohesion: 0.11
Nodes (18): MemoryManagerGreedy, alloc, alloc_internal_tensor, alloc_tensor, free, free_memory_list, free_tensor, get_tensor_info_from_fbs (+10 more)

### Community 153 - "cbortojson.c"
Cohesion: 0.22
Nodes (18): cbor_value_at_end(), cbor_value_get_type(), cbor_value_to_json(), add_value_metadata(), append_hex(), array_to_json(), cbor_value_to_json_advance(), dump_bytestring_base16() (+10 more)

### Community 154 - "main"
Cohesion: 0.15
Nodes (12): DebugMemCheckEndPoint(), DebugMemCheckFree(), DebugMemCheckInit(), DebugMemCheckStartPoint(), FillReadBuffer(), main(), CalcTimeDifference(), FreeTimer() (+4 more)

### Community 155 - "AveragePool"
Cohesion: 0.15
Nodes (6): AveragePool, m_ceil_mode, m_kernel_shape, m_pads, m_strides, forward_template()

### Community 156 - "DataBase"
Cohesion: 0.18
Nodes (6): DataBase, cal_similarity, m_db_path, m_feats, m_meta, query_feat

### Community 157 - "dl_power_of_two"
Cohesion: 0.16
Nodes (18): dl_bitrev2r_fc32_ansi(), dl_fft2r_fc32_ansi(), dl_gen_bitrev2r_table(), dl_gen_fft2r_table_f32(), dl_gen_rfft_table_f32(), dl_ifft2r_fc32_ansi(), dl_rfft_post_proc_fc32_ansi(), dl_rfft_pre_proc_fc32_ansi() (+10 more)

### Community 158 - "assembly.h"
Cohesion: 0.20
Nodes (8): MADD64(), SAR64(), SHL64(), FDCT32(), ClipToShort(), PolyphaseMono(), PolyphaseStereo(), Subband()

### Community 160 - "validate_value"
Cohesion: 0.33
Nodes (9): cbor_value_validate(), validate_container(), validate_floating_point(), validate_number(), validate_simple_type(), validate_tag(), validate_utf8_string(), validate_value() (+1 more)

### Community 161 - "Dequantize"
Cohesion: 0.15
Nodes (7): CLZ(), Dequantize(), DequantBlock(), DequantChannel(), IntensityProcMPEG1(), IntensityProcMPEG2(), MidSideProc()

### Community 162 - "ClsPostprocessor"
Cohesion: 0.14
Nodes (12): ClsPostprocessor, ClsPostprocessor::ClsPostprocessor(), m_cat_names, m_cls_result, m_model_output, m_need_softmax, m_output, m_score_thr (+4 more)

### Community 163 - "cJSON_Compare"
Cohesion: 0.15
Nodes (18): cJSON_Compare(), cjson_compare_should_compare_arrays(), cjson_compare_should_compare_booleans(), cjson_compare_should_compare_invalid_as_not_equal(), cjson_compare_should_compare_null(), cjson_compare_should_compare_null_pointer_as_not_equal(), cjson_compare_should_compare_numbers(), cjson_compare_should_compare_objects() (+10 more)

### Community 164 - "ClsImpl"
Cohesion: 0.14
Nodes (13): Cls, get_raw_model, ClsImpl, get_raw_model, m_image_preprocessor, m_model, m_postprocessor, ClsWrapper (+5 more)

### Community 165 - "Integer Less Than / Greater Than"
Cohesion: 0.08
Nodes (25): Integer Less Than / Greater Than, `TEST_ASSERT_GREATER_THAN_HEX16 (threshold, actual)`, `TEST_ASSERT_GREATER_THAN_HEX32 (threshold, actual)`, `TEST_ASSERT_GREATER_THAN_HEX8 (threshold, actual)`, `TEST_ASSERT_GREATER_THAN_INT16 (threshold, actual)`, `TEST_ASSERT_GREATER_THAN_INT32 (threshold, actual)`, `TEST_ASSERT_GREATER_THAN_INT8 (threshold, actual)`, `TEST_ASSERT_GREATER_THAN_INT (threshold, actual)` (+17 more)

### Community 166 - "ekf_imu13states.cpp"
Cohesion: 0.17
Nodes (13): m, app_main(), ekf::CovariancePrediction(), ekf::rotm2quat(), SIGN(), ekf_imu13states::Init(), ekf_imu13states::LinearizeFG(), ekf_imu13states::TestFull() (+5 more)

### Community 167 - "process_frame"
Cohesion: 0.15
Nodes (14): apply_preemphasis(), apply_window(), compute_energy(), compute_spectrum(), Fbank, m_cache, m_fft_config, m_mel_filter (+6 more)

### Community 168 - "cborinternal_p.h"
Cohesion: 0.20
Nodes (14): cbor_encode_float_as_half_float(), can_read_bytes(), copy_current_position(), encode_half(), extract_number_checked(), read_bytes(), read_bytes_unchecked(), read_uint16() (+6 more)

### Community 169 - "json2cbor.c"
Cohesion: 0.18
Nodes (19): app_main(), cbor_encode_boolean(), cbor_encode_float(), cbor_encode_half_float(), cbor_encode_null(), cbor_encode_text_stringz(), cbor_encode_undefined(), cbor_encoder_get_buffer_size() (+11 more)

### Community 170 - "dl_rfft_s32_run"
Cohesion: 0.09
Nodes (23): dl_bitrev2r_sc32_ansi(), dl_fft2r_sc32_dif_ansi(), dl_gen_fft_table_sc32(), dl_rfft_post_proc_sc32_ansi(), half_even(), mulh_s32(), to_q31(), ESP32-C5 fft benchmark(dl_fft v0.8.0): (+15 more)

### Community 171 - "MULSHIFT32"
Cohesion: 0.31
Nodes (11): FASTABS(), MULSHIFT32(), AntiAlias(), FreqInvertRescale(), HybridTransform(), idct9(), IMDCT(), imdct12() (+3 more)

### Community 172 - "dl_base_max2d.cpp"
Cohesion: 0.18
Nodes (4): load_max2d_11c_s16(), load_max2d_11c_s8(), max2d(), max2d_11c()

### Community 173 - "LSTM"
Cohesion: 0.10
Nodes (13): LSTM, m_c_prev, m_direction_num, m_first_step, m_gate_exponent, m_gates, m_h_prev, m_hidden_cache (+5 more)

### Community 174 - "ESP32_PWM_LEDC"
Cohesion: 0.15
Nodes (10): ESP32_PWM_LEDC, _channel_initialized, _freq_hz, init_channel, init_timer, _resolution_bits, set_duty_ticks, set_pulse_us (+2 more)

### Community 175 - "parse_examples.c"
Cohesion: 0.16
Nodes (19): cJSON_ParseWithLength(), read_file(), do_test(), file_test10_should_be_parsed_and_printed(), file_test11_should_be_parsed_and_printed(), file_test1_should_be_parsed_and_printed(), file_test2_should_be_parsed_and_printed(), file_test3_should_be_parsed_and_printed() (+11 more)

### Community 176 - "GRU"
Cohesion: 0.10
Nodes (12): GRU, m_direction_num, m_first_step, m_gate_exponent, m_gates, m_h_prev, m_hidden_cache, m_hidden_size (+4 more)

### Community 177 - "dl_tool.hpp"
Cohesion: 0.13
Nodes (8): operator==(), PSRAMAllocator, rebind, round(), round_half_even(), round_half_up(), set_value(), truncate()

### Community 178 - "encodeVariant"
Cohesion: 0.18
Nodes (13): cbor_encoder_get_extra_bytes_needed(), cbor_encoder_init(), cbor_encoder_close_container_checked(), encodeVariant(), isOomError(), toString(), illegalSimpleType, shortBuffer (+5 more)

### Community 179 - "FbsLoader"
Cohesion: 0.10
Nodes (16): FbsLoader, calc_package_sha256, get_model_format, get_model_location_string, get_model_name, get_model_num, get_package_sha256, get_package_size (+8 more)

### Community 180 - "MP3Decode"
Cohesion: 0.17
Nodes (13): MP3ClearBadFrame(), MP3Decode(), MP3FindFreeSync(), MP3FindSyncWord(), MP3FreeDecoder(), MP3GetLastFrameInfo(), MP3GetNextFrameInfo(), MP3InitDecoder() (+5 more)

### Community 181 - "CMpaDecObj"
Cohesion: 0.10
Nodes (14): CMpaDecObj, DecodeFrame_v, GetPCMInfo_v, GetSamplesPerFrame_n, Init_n, m_bTrustPackets, m_bUseFrameSize, m_lastMP3FrameInfo (+6 more)

### Community 182 - "dumprecursive"
Cohesion: 0.17
Nodes (10): dumpbytes(), dumprecursive(), indent(), main(), readfile(), cbor_value_get_half_float(), cbor_value_is_half_float(), decode_half() (+2 more)

### Community 183 - "LpNormalization"
Cohesion: 0.16
Nodes (5): compute_quant_inv_norm(), compute_quant_inv_norm_strided(), LpNormalization, m_axis, m_p

### Community 184 - "dl_base_conv_loop.cpp"
Cohesion: 0.22
Nodes (13): conv2d(), conv_loop_c(), conv_loop_c_body(), conv_loop_c_grid(), conv_loop_pie(), conv_loop_pie_body(), conv_loop_pie_grid(), conv_loop_pie_tiled() (+5 more)

### Community 185 - "ReduceBase"
Cohesion: 0.14
Nodes (6): ReduceBase, m_axes_reduce_flag, m_keepdims, m_op_type, reduce(), ReduceMax

### Community 186 - "DualCoreWorkerRuntime"
Cohesion: 0.09
Nodes (16): DualCoreWorkerRuntime, args, completion, completion_buffer, dispatch_mutex, dispatch_mutex_buffer, op, task_args (+8 more)

### Community 187 - "ImagePreprocessor"
Cohesion: 0.15
Nodes (14): ImagePreprocessor, enable_letterbox, get_border_left, get_border_top, get_crop_area_top_left_x, get_crop_area_top_left_y, get_model_input, get_resize_scale_x (+6 more)

### Community 188 - "Transpose"
Cohesion: 0.18
Nodes (3): Transpose, m_perm, transpose

### Community 190 - "Arrays"
Cohesion: 0.11
Nodes (19): Arrays, `TEST_ASSERT_EQUAL_HEX16_ARRAY (expected, actual, num_elements)`, `TEST_ASSERT_EQUAL_HEX32_ARRAY (expected, actual, num_elements)`, `TEST_ASSERT_EQUAL_HEX64_ARRAY (expected, actual, num_elements)`, `TEST_ASSERT_EQUAL_HEX8_ARRAY (expected, actual, num_elements)`, `TEST_ASSERT_EQUAL_HEX_ARRAY (expected, actual, num_elements)`, `TEST_ASSERT_EQUAL_INT16_ARRAY (expected, actual, num_elements)`, `TEST_ASSERT_EQUAL_INT32_ARRAY (expected, actual, num_elements)` (+11 more)

### Community 191 - "Each Equal (Arrays to Single Value)"
Cohesion: 0.11
Nodes (19): Each Equal (Arrays to Single Value), `TEST_ASSERT_EACH_EQUAL_HEX16 (expected, actual, num_elements)`, `TEST_ASSERT_EACH_EQUAL_HEX32 (expected, actual, num_elements)`, `TEST_ASSERT_EACH_EQUAL_HEX64 (expected, actual, num_elements)`, `TEST_ASSERT_EACH_EQUAL_HEX8 (expected, actual, num_elements)`, `TEST_ASSERT_EACH_EQUAL_HEX (expected, actual, num_elements)`, `TEST_ASSERT_EACH_EQUAL_INT16 (expected, actual, num_elements)`, `TEST_ASSERT_EACH_EQUAL_INT32 (expected, actual, num_elements)` (+11 more)

### Community 192 - "MatMulArgs"
Cohesion: 0.18
Nodes (15): matmul(), matmul_c(), MatMulArgs, a_stride, activation, b_stride, c_stride, k (+7 more)

### Community 193 - "dl_conv_args.hpp"
Cohesion: 0.15
Nodes (16): conv_1x1_body_view(), conv_buffer_bytes(), conv_each_1x1_pad(), conv_feature_bytes(), conv_filter_bytes(), conv_has_padding(), conv_is_1x1(), conv_ptr_add() (+8 more)

### Community 194 - "Matrix"
Cohesion: 0.12
Nodes (10): Matrix, diagonal, h, inverse, matmul, slice, transpose, w (+2 more)

### Community 195 - "flash.cpp"
Cohesion: 0.15
Nodes (8): ESP32_Flash, erase_key, erase_namespace, init, _initialized, _partition_name, read_blob, write_blob

### Community 196 - "dl_base_norm.cpp"
Cohesion: 0.36
Nodes (9): rms_float_bits(), rms_mul24(), rms_mul_int(), rms_norm(), rms_norm_int_emulated(), rms_round_half_up(), scale_round(), scale_round_impl() (+1 more)

### Community 197 - "Resize"
Cohesion: 0.12
Nodes (7): forward_template(), Resize, m_align_corners, m_cache, m_resize_mode, m_scales, m_sizes

### Community 198 - "FeatImagePreprocessor"
Cohesion: 0.22
Nodes (4): FeatImagePreprocessor, m_image_preprocessor, preprocess, s_std_ldks_112

### Community 199 - "ThrowTheSwitch.org Coding Standard"
Cohesion: 0.11
Nodes (17): Braces, C and C++ Details, Case, Case, Comments, Consistent, Descriptive, Documentation (+9 more)

### Community 200 - "Background and Overview"
Cohesion: 0.11
Nodes (17): Advanced Asserting: Details On Tricky Assertions, Assertion Conventions and Configurations, Background and Overview, Configuration, Floating Point Support Is Optional, How do the EQUAL assertions work for FLOAT and DOUBLE?, How do we deal with targets with non-standard int sizes?, Maximum Data Type Width Is Configurable (+9 more)

### Community 201 - "dl_base_activate_output.hpp"
Cohesion: 0.40
Nodes (7): arith_output_leakyrelu(), arith_output_prelu(), arith_output_relu(), output_leakyrelu(), output_linear(), output_prelu(), output_relu()

### Community 202 - "Latency"
Cohesion: 0.12
Nodes (10): get_cycle(), Latency, count, next, period, queue, size, sum (+2 more)

### Community 203 - "pack_espdl_models.py"
Cohesion: 0.18
Nodes (6): collect_model_files(), get_model_format(), pack_models(), pack_models_pdl3(), read_data(), struct_pack_string()

### Community 204 - "MaxPool"
Cohesion: 0.14
Nodes (6): forward_template(), MaxPool, m_ceil_mode, m_filter_shape, m_padding, m_strides

### Community 205 - "dl_model_context.cpp"
Cohesion: 0.17
Nodes (10): get_tensor, ModelContext::add_tensor(), ModelContext::get_parameter_memory_size(), ModelContext::get_tensor(), ModelContext::get_tensor_index(), ModelContext::get_variable_index(), ModelContext::get_variable_memory_size(), ModelContext::has_tensor() (+2 more)

### Community 206 - "RMSNormalization"
Cohesion: 0.20
Nodes (3): RMSNormalization, m_axis, m_epsilon

### Community 207 - "dl_tool.cpp"
Cohesion: 0.17
Nodes (6): calloc_aligned(), malloc_aligned(), memory_addr_type(), shift_and_round(), shift_and_round_half_even(), shift_and_round_half_up()

### Community 208 - "bitstream.c"
Cohesion: 0.26
Nodes (8): CalcBitsUsed(), GetBits(), RefillBitstreamCache(), SetBitstreamPointer(), UnpackSideInfo(), UnpackScaleFactors(), UnpackSFMPEG1(), UnpackSFMPEG2()

### Community 209 - "ActivationLUT"
Cohesion: 0.14
Nodes (7): func, ActivationLUT, m_quant_max, m_quant_min, m_table, get_activation_function(), gen_lut_8bit()

### Community 210 - "Integer Ranges (of all sizes)"
Cohesion: 0.12
Nodes (16): Integer Ranges (of all sizes), `TEST_ASSERT_HEX16_WITHIN (delta, expected, actual)`, `TEST_ASSERT_HEX32_WITHIN (delta, expected, actual)`, `TEST_ASSERT_HEX64_WITHIN (delta, expected, actual)`, `TEST_ASSERT_HEX8_WITHIN (delta, expected, actual)`, `TEST_ASSERT_HEX_WITHIN (delta, expected, actual)`, `TEST_ASSERT_INT16_WITHIN (delta, expected, actual)`, `TEST_ASSERT_INT32_WITHIN (delta, expected, actual)` (+8 more)

### Community 211 - "SigmoidLUT"
Cohesion: 0.14
Nodes (10): sigmoid(), SigmoidLUT, m_quant_max, m_quant_min, m_table, tanh(), TanhLUT, m_quant_max (+2 more)

### Community 212 - "LayerNormalization"
Cohesion: 0.16
Nodes (5): forward_template(), LayerNormalization, m_axis, m_epsilon, m_stash_type

### Community 213 - "dl_module_reduce_log_sum_exp.hpp"
Cohesion: 0.16
Nodes (5): reduce(), reduce_op_exp_add, reduce_op_exp_add<V_T, int8_t>, ReduceLogSumExp, m_exp_table

### Community 214 - "NormQuant<QuantType, 3>"
Cohesion: 0.15
Nodes (10): NormQuant<QuantType, 1>, channels, m_lut1, m_lut_32, NormQuant<QuantType, 3>, channels, m_lut1, m_lut2 (+2 more)

### Community 215 - "xy_map_t"
Cohesion: 0.13
Nodes (13): xy_map_t, dirty, geom, inv_scale_x, inv_scale_y, scale_x, scale_y, x (+5 more)

### Community 216 - "dl_fft2r_sc16_ansi.c"
Cohesion: 0.32
Nodes (12): dl_cplx2real_sc16_hp_ansi(), dl_cplx2reC_sc16(), dl_fft2r_sc16_ansi(), dl_fft2r_sc16_hp_ansi(), dl_gen_fft_table_sc16(), dl_ifft2r_sc16_ansi(), dl_ifft2r_sc16_hp_ansi(), dl_xtfixed_bf_1() (+4 more)

### Community 217 - "dl_module_matmul.hpp"
Cohesion: 0.11
Nodes (14): dl_conv_bind_from_args(), dl_conv_ensure_kernels(), dl_conv_key_from_args(), dl_conv_pack_key(), dl_conv_sel_row, key, slot0, slot1 (+6 more)

### Community 218 - "dl_base_dwconv_loop.cpp"
Cohesion: 0.16
Nodes (11): depthwise_conv2d(), dwconv_loop_c(), dwconv_loop_c_body(), dwconv_loop_c_grid(), dwconv_loop_pie(), dwconv_loop_pie_body(), dwconv_loop_pie_grid(), dwconv_update_tie_offsets() (+3 more)

### Community 219 - "dl_math.hpp"
Cohesion: 0.23
Nodes (9): acos(), asin(), atan(), atan2(), dfl_integral(), power(), root_newton(), softmax() (+1 more)

### Community 220 - "Concat"
Cohesion: 0.15
Nodes (6): Concat, axis, copy_nums, loop_times, n_dims, forward_template()

### Community 221 - "ScatterND"
Cohesion: 0.15
Nodes (5): forward_template(), ScatterND, m_n_slices, m_reduction, m_slice_size

### Community 224 - "cJSON_Minify"
Cohesion: 0.21
Nodes (12): cJSON_Minify(), minify_string(), skip_multiline_comment(), skip_oneline_comment(), cjson_minify_should_minify_json(), cjson_minify_should_not_loop_infinitely(), cjson_minify_should_not_modify_strings(), cjson_minify_should_not_overflow_buffer() (+4 more)

### Community 225 - "The Assertions in All Their Blessed Glory"
Cohesion: 0.14
Nodes (14): Basic Fail and Ignore, Structs and Strings, `TEST_ASSERT_EQUAL_HEX16 (expected, actual)`, `TEST_ASSERT_EQUAL_HEX32 (expected, actual)`, `TEST_ASSERT_EQUAL_HEX64 (expected, actual)`, `TEST_ASSERT_EQUAL_HEX8 (expected, actual)`, `TEST_ASSERT_EQUAL_HEX (expected, actual)`, `TEST_ASSERT_EQUAL_MEMORY (expected, actual, len)` (+6 more)

### Community 226 - "requantizeArgsType"
Cohesion: 0.16
Nodes (11): get_requantize_operation_args(), load_requantize_linear_func(), requantize_linear(), requantizeArgsType, in_size_remainder, input_element, out_size_remainder, output_element (+3 more)

### Community 227 - "Slice"
Cohesion: 0.18
Nodes (6): Slice, m_axes, m_end, m_start, m_step, slice

### Community 228 - "ESP-DL"
Cohesion: 0.14
Nodes (13): Audio Processing (`audio/`), Core Components (`dl/`), Dual Core Scheduling, Efficient Operator Implementation, ESP-DL, ESP-DL Standard Model Format, [esp-ppq](https://github.com/espressif/esp-ppq), FlatBuffers Loader (`fbs_loader/`) (+5 more)

### Community 229 - "ble_ota_uploader.py"
Cohesion: 0.20
Nodes (3): BleOtaUploader, find_firmware_binary(), main()

### Community 230 - "dl_base_avg_pool2d.cpp"
Cohesion: 0.28
Nodes (8): avg_pool2d(), avgpool2d_hwc(), avgpool2d_hwc_sum(), load_avg_pool2d_hwc1_s16(), load_avg_pool2d_hwc1_s8(), scale_tie728_s16_qacc_8x40(), scale_tie728_s8_qacc_8x20(), sign_extend_20bit()

### Community 231 - "dl_module_reduce_base.hpp"
Cohesion: 0.27
Nodes (7): reduce(), reduce_l1(), reduce_l2(), reduce_max(), reduce_min(), reduce_sum(), try_inner()

### Community 232 - "HAL_SPI"
Cohesion: 0.17
Nodes (11): Unified HAL_SPI Abstraction & Shared Bus Decoupling (Layer 1), HAL_SPI, get_free_bytes, get_total_bytes, init, is_card_inserted, is_fatfs_mounted, mount_fatfs (+3 more)

### Community 233 - "Signed and Unsigned Integers (of all sizes)"
Cohesion: 0.15
Nodes (13): Signed and Unsigned Integers (of all sizes), `TEST_ASSERT_EQUAL (expected, actual)`, `TEST_ASSERT_EQUAL_INT16 (expected, actual)`, `TEST_ASSERT_EQUAL_INT32 (expected, actual)`, `TEST_ASSERT_EQUAL_INT64 (expected, actual)`, `TEST_ASSERT_EQUAL_INT8 (expected, actual)`, `TEST_ASSERT_EQUAL_INT (expected, actual)`, `TEST_ASSERT_EQUAL_UINT16 (expected, actual)` (+5 more)

### Community 234 - "ESP-DL Audio Processing Module"
Cohesion: 0.15
Nodes (12): Audio Common Functions, Common Audio Utilities, Configuration, Directory Structure, ESP-DL Audio Processing Module, Fbank (Filter Bank), Features, License (+4 more)

### Community 235 - "dl_base_min2d.cpp"
Cohesion: 0.18
Nodes (4): load_min2d_11c_s16(), load_min2d_11c_s8(), min2d(), min2d_11c()

### Community 236 - "dl_base_mul2d.cpp"
Cohesion: 0.18
Nodes (4): load_mul2d_11c_s16(), load_mul2d_11c_s8(), mul2d(), mul2d_11c()

### Community 237 - "array"
Cohesion: 0.12
Nodes (15): array, is_valid_hsv_thr(), HSV2HSVMask, dst_bpp, h_across_zero, m_hsv_max, m_hsv_min, src_bpp (+7 more)

### Community 238 - "FbankS32"
Cohesion: 0.17
Nodes (10): FbankS32, m_buf, m_eps_exp, m_eps_mant, m_fft_s32, m_log_eps_q36, m_mel_filter, m_power_bits (+2 more)

### Community 239 - "dl_base_leakyrelu.cpp"
Cohesion: 0.28
Nodes (4): leakyrelu(), leakyrelu_11c(), load_leakyrelu_11cn_s16(), load_leakyrelu_11cn_s8()

### Community 240 - "ReduceProd"
Cohesion: 0.19
Nodes (3): reduce(), reduce_op_mul, ReduceProd

### Community 241 - "quant_type_to_string"
Cohesion: 0.05
Nodes (12): DepthToSpace, m_blocksize, m_mode, Equal, forward_template(), StreamingCache, m_cache, m_cache_bytes (+4 more)

### Community 242 - "dl_base_prelu.cpp"
Cohesion: 0.28
Nodes (4): load_prelu_11cn_s16(), load_prelu_11cn_s8(), prelu(), prelu_11c()

### Community 243 - "RGB8882RGB565"
Cohesion: 0.15
Nodes (7): rgb8882rgb565(), RGB8882RGB565, dst_bpp, src_bpp, YUYV2RGB565, dst_bpp, src_bpp

### Community 244 - "Elu"
Cohesion: 0.17
Nodes (3): Elu, m_alpha, forward_template()

### Community 246 - "Double (If enabled)"
Cohesion: 0.17
Nodes (12): Double (If enabled), `TEST_ASSERT_DOUBLE_IS_DETERMINATE (actual)`, `TEST_ASSERT_DOUBLE_IS_INF (actual)`, `TEST_ASSERT_DOUBLE_IS_NAN (actual)`, `TEST_ASSERT_DOUBLE_IS_NEG_INF (actual)`, `TEST_ASSERT_DOUBLE_IS_NOT_DETERMINATE (actual)`, `TEST_ASSERT_DOUBLE_IS_NOT_INF (actual)`, `TEST_ASSERT_DOUBLE_IS_NOT_NAN (actual)` (+4 more)

### Community 247 - "Floating Point (If enabled)"
Cohesion: 0.17
Nodes (12): Floating Point (If enabled), `TEST_ASSERT_EQUAL_FLOAT_ARRAY (expected, actual, num_elements)`, `TEST_ASSERT_EQUAL_FLOAT (expected, actual)`, `TEST_ASSERT_FLOAT_IS_DETERMINATE (actual)`, `TEST_ASSERT_FLOAT_IS_INF (actual)`, `TEST_ASSERT_FLOAT_IS_NAN (actual)`, `TEST_ASSERT_FLOAT_IS_NEG_INF (actual)`, `TEST_ASSERT_FLOAT_IS_NOT_DETERMINATE (actual)` (+4 more)

### Community 248 - "Overview of the Documents"
Cohesion: 0.17
Nodes (11): How to Build and Run A Test File, How to Create A Test File, Overview of the Documents, Overview of the Folders, Unity Assertions Cheat Sheet, Unity Assertions reference, Unity Configuration Guide, Unity - Getting Started (+3 more)

### Community 249 - "dl_c_conv_tail.cpp"
Cohesion: 0.22
Nodes (11): ConvArgsType, buffer_0000_leakyrelu(), buffer_0000_linear(), buffer_0000_prelu(), buffer_0000_relu(), buffer_bias_leakyrelu(), buffer_bias_linear(), buffer_bias_prelu() (+3 more)

### Community 250 - "Div"
Cohesion: 0.16
Nodes (3): Div, m_args, forward_template()

### Community 251 - "Mod"
Cohesion: 0.16
Nodes (3): forward_template(), Mod, m_fmod

### Community 254 - "print_value.c"
Cohesion: 0.31
Nodes (9): assert_print_value(), print_value_should_print_array(), print_value_should_print_false(), print_value_should_print_null(), print_value_should_print_number(), print_value_should_print_object(), print_value_should_print_string(), print_value_should_print_true() (+1 more)

### Community 255 - "Options accepted by generate_test_runner.rb:"
Cohesion: 0.18
Nodes (10): `:enforce_strict_ordering`, `generate_test_runner.rb`, `:includes`, Options accepted by generate_test_runner.rb:, `:plugins`, `:suite_setup`, `:suite_teardown`, Unity Helper Scripts (+2 more)

### Community 256 - "dl_base_pad.cpp"
Cohesion: 0.47
Nodes (6): get_pad_shape(), pad1D(), pad2D(), pad3D(), pad4D(), pad_head_and_tail()

### Community 257 - "dl_math_matrix.cpp"
Cohesion: 0.38
Nodes (8): get_affine_transform(), get_perspective_transform(), get_similarity_transform(), Matrix<T>::diagonal(), Matrix<T>::inverse(), Matrix<T>::matmul(), Matrix<T>::slice(), Matrix<T>::transpose()

### Community 260 - "dl_base_relu.cpp"
Cohesion: 0.28
Nodes (4): load_relu_11cn_s16(), load_relu_11cn_s8(), relu(), relu_11c()

### Community 265 - "Module"
Cohesion: 0.03
Nodes (19): Module, inplace, m_inputs_index, m_outputs_index, name, quant_type, run, Flatten (+11 more)

### Community 269 - "ModelContext"
Cohesion: 0.04
Nodes (25): ModelContext, add_tensor, get_parameter_memory_size, get_tensor_index, get_variable_index, get_variable_memory_size, has_tensor, m_internal_root (+17 more)

### Community 275 - "feature_t"
Cohesion: 0.29
Nodes (6): activation_shell(), arith_operation_shell(), conv_operation_shell(), dwconv_operation_shell(), get_activation_args(), get_arith_operation_args()

### Community 277 - "result_t"
Cohesion: 0.17
Nodes (8): greater_box(), result_t, box, category, keypoint, mask, mask_coeff, score

### Community 278 - "LyraT Audio Processing Demo Guide"
Cohesion: 0.22
Nodes (8): LyraT Audio Processing Demo Guide, ESP-DSP IIR Biquad Equalizer & Digital Limiter, ESP-DSP IIR Filter Example Project, ESP-DSP IIR Filter Main Component, ESP-DSP IIR Filter Component Dependency Manifest, Biquad IIR Filter with Q-Factor Tuning (dsps_biquad_f32, dsps_biquad_gen_lpf_f32), ESP-DSP IIR Filter Example Guide, ESP-DSP Infinite Impulse Response (IIR) Filter

### Community 279 - "dl_recognition_database.cpp"
Cohesion: 0.35
Nodes (9): clear_all_feats, clear_all_feats_in_memory, create_empty_database_in_storage, DataBase::DataBase(), delete_feat, delete_last_feat, enroll_feat, load_database_from_storage (+1 more)

### Community 280 - "dl_base_greater.cpp"
Cohesion: 0.60
Nodes (3): c_impl_greater_1_n(), c_impl_greater_n_1(), c_impl_greater_n_n()

### Community 281 - "dl_base_pow.cpp"
Cohesion: 0.60
Nodes (3): c_impl_pow_1_n(), c_impl_pow_n_1(), c_impl_pow_n_n()

### Community 282 - "dl_base_xor.cpp"
Cohesion: 0.60
Nodes (3): c_impl_xor_1_n(), c_impl_xor_n_1(), c_impl_xor_n_n()

### Community 283 - "package.json"
Cohesion: 0.22
Nodes (8): bugs, description, homepage, keywords, license, name, repository, version

### Community 286 - "Bmp180Calib"
Cohesion: 0.17
Nodes (12): Bmp180Calib, ac1, ac2, ac3, ac4, ac5, ac6, b1 (+4 more)

### Community 287 - "RGB5652Gray<RGB565BE, RGBSwap, void>"
Cohesion: 0.40
Nodes (3): RGB5652Gray<RGB565BE, RGBSwap, void>, dst_bpp, src_bpp

### Community 288 - "dl_audio_wav.cpp"
Cohesion: 0.39
Nodes (5): decode_wav(), print_audio_info(), read_int16(), read_int32(), read_tag()

### Community 289 - "CBOR Example"
Cohesion: 0.25
Nodes (7): Build and Flash, CBOR Example, Example Output, Hardware Required, How to use example, Overview, Troubleshooting

### Community 291 - "dl_base_pool2d.hpp"
Cohesion: 0.32
Nodes (3): avg_pool_shell(), get_pool_args(), max_pool_shell()

### Community 292 - "dl_base_dotprod.cpp"
Cohesion: 0.32
Nodes (3): dotprod(), dotprod_c(), mat_vec_dotprod()

### Community 293 - "dl_base_isa.hpp"
Cohesion: 0.10
Nodes (18): c_impl_add_1_n(), c_impl_add_n_1(), c_impl_add_n_n(), c_impl_and_1_n(), c_impl_and_n_1(), c_impl_and_n_n(), c_impl_less_1_n(), c_impl_less_n_1() (+10 more)

### Community 294 - "Gray2Gray<ExtraProcess>"
Cohesion: 0.29
Nodes (3): Gray2Gray<ExtraProcess>, dst_bpp, src_bpp

### Community 295 - "RGB8882RGB888<RGBSwap, ExtraProcess>"
Cohesion: 0.29
Nodes (3): RGB8882RGB888<RGBSwap, ExtraProcess>, dst_bpp, src_bpp

### Community 296 - "YUYV2Gray<YUYVOrUYVY, ExtraProcess>"
Cohesion: 0.29
Nodes (3): YUYV2Gray<YUYVOrUYVY, ExtraProcess>, dst_bpp, src_bpp

### Community 297 - "parse_simple_yaml"
Cohesion: 0.21
Nodes (10): canonicalize_ops(), collect_spec_files(), _parse_flow_list(), _parse_scalar(), parse_simple_yaml(), parse_block(), resolve_srcs(), _strip_comment() (+2 more)

### Community 299 - "Boolean"
Cohesion: 0.29
Nodes (7): Boolean, `TEST_ASSERT (condition)`, `TEST_ASSERT_FALSE (condition)`, `TEST_ASSERT_NOT_NULL (pointer)`, `TEST_ASSERT_NULL (pointer)`, `TEST_ASSERT_TRUE (condition)`, `TEST_ASSERT_UNLESS (condition)`

### Community 300 - "XtensaConvParams"
Cohesion: 0.29
Nodes (7): XtensaConvParams, init_hi, init_lo, loops, relu_lo, sar, wq

### Community 302 - "esp_dsp.h"
Cohesion: 0.06
Nodes (13): dsps_dct_f32(), dsps_dct_f32_ref(), dsps_dct_inv_f32(), dsps_dct_inverce_f32_ref(), dsps_dctiv_f32(), dsps_dstiv_f32(), dsps_fird_s16_ansi(), dsps_firmr_s16_ansi() (+5 more)

### Community 303 - "RGB5652Gray<RGB565BE, RGBSwap, ExtraProcess>"
Cohesion: 0.33
Nodes (3): RGB5652Gray<RGB565BE, RGBSwap, ExtraProcess>, dst_bpp, src_bpp

### Community 304 - "RGB5652HSV<RGB565BE, RGBSwap, ExtraProcess>"
Cohesion: 0.33
Nodes (3): RGB5652HSV<RGB565BE, RGBSwap, ExtraProcess>, dst_bpp, src_bpp

### Community 305 - "RGB8882Gray<RGBSwap, ExtraProcess>"
Cohesion: 0.14
Nodes (7): rgb8882gray(), RGB8882Gray<RGBSwap, ExtraProcess>, dst_bpp, src_bpp, RGB8882Gray<RGBSwap, void>, dst_bpp, src_bpp

### Community 306 - "YUYV2RGB888<YUYVOrUYVY, RGBSwap, ExtraProcess>"
Cohesion: 0.33
Nodes (3): YUYV2RGB888<YUYVOrUYVY, RGBSwap, ExtraProcess>, dst_bpp, src_bpp

### Community 307 - "bg_t"
Cohesion: 0.29
Nodes (7): bg_t, dirty, ori, ori_n, pix, pix_size, same

### Community 309 - "Zettel 0015: BLE OTA Lifecycle Architecture, Resource Stewardship & Host Stack Decoupling"
Cohesion: 0.14
Nodes (10): Driver Isolation & Explicit Notification APIs (send_ble_*_notification), Client-Side ATT MTU Adaptation & Error Unblocking, Zettel 0015: BLE OTA Lifecycle Architecture, Resource Stewardship & Host Stack Decoupling, 1. Metadata & Scope, 2. Problem Statement & Context, 3. Dependency Mapping & Graphify Subgraph Analysis, 4. Audit Findings & Resolution, Affected Translation Units & Architectural Constraints: (+2 more)

### Community 310 - "ESP-DSP Complex FFT Example Guide"
Cohesion: 0.33
Nodes (5): ESP-DSP Complex FFT Example Project, ESP-DSP Complex FFT Main Component, ESP-DSP Complex FFT Component Dependency Manifest, Complex FFT with Real Spectrum Splitting (dsps_cplx2reals_split), ESP-DSP Complex FFT Example Guide

### Community 311 - "misc_tests.c"
Cohesion: 0.12
Nodes (25): cJSON_CreateBool(), cJSON_CreateFalse(), cJSON_CreateNull(), cJSON_CreateNumber(), cJSON_CreateString(), cJSON_CreateStringReference(), cJSON_CreateTrue(), cJSON_New_Item() (+17 more)

### Community 312 - "cJSON"
Cohesion: 0.33
Nodes (4): cJSON, Enjoy cJSON!, License, Table of contents

### Community 313 - "Masked and Bit-level Assertions"
Cohesion: 0.33
Nodes (6): Masked and Bit-level Assertions, `TEST_ASSERT_BIT_HIGH (bit, actual)`, `TEST_ASSERT_BIT_LOW (bit, actual)`, `TEST_ASSERT_BITS_HIGH (mask, actual)`, `TEST_ASSERT_BITS_LOW (mask, actual)`, `TEST_ASSERT_BITS (mask, expected, actual)`

### Community 314 - "dl_base_shape.cpp"
Cohesion: 0.47
Nodes (3): get_multidirectional_broadcasting_shape(), get_slice_shape(), get_unidirectional_broadcasting_shape()

### Community 315 - "Gray2Gray<void>"
Cohesion: 0.33
Nodes (3): Gray2Gray<void>, dst_bpp, src_bpp

### Community 316 - "RGB5652RGB565"
Cohesion: 0.33
Nodes (3): RGB5652RGB565, dst_bpp, src_bpp

### Community 317 - "RGB8882RGB888<RGBSwap, void>"
Cohesion: 0.33
Nodes (3): RGB8882RGB888<RGBSwap, void>, dst_bpp, src_bpp

### Community 318 - "YUYV2Gray<YUYVOrUYVY, void>"
Cohesion: 0.33
Nodes (3): YUYV2Gray<YUYVOrUYVY, void>, dst_bpp, src_bpp

### Community 322 - "ExponentInfo"
Cohesion: 0.22
Nodes (4): ExponentInfo, m_exponent, m_exponents, m_size

### Community 323 - "DecodeHuffman"
Cohesion: 0.60
Nodes (3): DecodeHuffman(), DecodeHuffmanPairs(), DecodeHuffmanQuads()

### Community 324 - "RGB5652RGB888<RGB565BE, RGBSwap, ExtraProcess>"
Cohesion: 0.33
Nodes (3): RGB5652RGB888<RGB565BE, RGBSwap, ExtraProcess>, dst_bpp, src_bpp

### Community 325 - "LogFileHeader"
Cohesion: 0.18
Nodes (11): LogFileHeader, board_name, boot_timestamp_us, circular_head_sector, limit_policy, magic, max_file_size_bytes, registered_packets_mask (+3 more)

### Community 328 - "print_number.c"
Cohesion: 0.31
Nodes (7): assert_print_number(), print_number_should_print_negative_integers(), print_number_should_print_negative_reals(), print_number_should_print_positive_integers(), print_number_should_print_positive_reals(), print_number_should_print_zero(), void()

### Community 329 - "YUYV2HSV<YUYVOrUYVY, ExtraProcess>"
Cohesion: 0.33
Nodes (3): YUYV2HSV<YUYVOrUYVY, ExtraProcess>, dst_bpp, src_bpp

### Community 330 - "dl_fft2r_sc16_dif_ansi.c"
Cohesion: 0.29
Nodes (9): dl_fft2r_sc16_dif(), dl_fft2r_sc16_dif_ansi(), dl_fft2r_sc16_dif_hp(), dl_fft2r_sc16_dif_hp_ansi(), dl_gen_dif_fft_table(), dl_ifft2r_sc16_dif(), dl_ifft2r_sc16_dif_ansi(), dl_ifft2r_sc16_dif_hp() (+1 more)

### Community 331 - "Zettel 0007: SystemView Instrumentation & RTOS Profiling Conventions"
Cohesion: 0.22
Nodes (7): Heinz Guderian (RTOS & DSP Lead), OpenOCD Dual-Core Trace Capture Syntax & Sizing Sweet Spot, Python SystemView Profiling & Visualization Suite (/analyzers), Standardized RTOS Timing Analysis Rules, Dual-Core Flight Loop Steady-State Benchmarks, Sub-Slice Fragmentation vs Full-Loop Boundary Timing Analysis, Zettel 0007: SystemView Instrumentation & RTOS Profiling Conventions

### Community 333 - "Security Policy"
Cohesion: 0.50
Nodes (3): Reporting a Vulnerability, Security Policy, Supported Versions

### Community 343 - "Building"
Cohesion: 0.33
Nodes (6): Building, CMake, copying the source, Makefile, Meson, Vcpkg

### Community 360 - "FbsLoader::calc_package_sha256"
Cohesion: 0.53
Nodes (5): FbsLoader::calc_package_sha256(), sha256_finish(), sha256_free(), sha256_init(), sha256_update()

### Community 362 - "dl_base_greaterorequal.cpp"
Cohesion: 0.60
Nodes (3): c_impl_greaterorequal_1_n(), c_impl_greaterorequal_n_1(), c_impl_greaterorequal_n_n()

### Community 364 - "dl_base_max.cpp"
Cohesion: 0.60
Nodes (3): c_impl_max_1_n(), c_impl_max_n_1(), c_impl_max_n_n()

### Community 365 - "RGB5652RGB888<RGB565BE, RGBSwap, void>"
Cohesion: 0.40
Nodes (3): RGB5652RGB888<RGB565BE, RGBSwap, void>, dst_bpp, src_bpp

### Community 369 - "dl_base_equal.cpp"
Cohesion: 0.60
Nodes (3): c_impl_equal_1_n(), c_impl_equal_n_1(), c_impl_equal_n_n()

### Community 371 - "dl_base_min.cpp"
Cohesion: 0.60
Nodes (3): c_impl_min_1_n(), c_impl_min_n_1(), c_impl_min_n_n()

### Community 372 - "dl_base_mod.cpp"
Cohesion: 0.60
Nodes (3): c_impl_mod_1_n(), c_impl_mod_n_1(), c_impl_mod_n_n()

### Community 373 - "dl_base_or.cpp"
Cohesion: 0.60
Nodes (3): c_impl_or_1_n(), c_impl_or_n_1(), c_impl_or_n_n()

### Community 374 - "dl_base_sub.cpp"
Cohesion: 0.60
Nodes (3): c_impl_sub_1_n(), c_impl_sub_n_1(), c_impl_sub_n_n()

### Community 375 - "mem_info_s"
Cohesion: 0.40
Nodes (4): mem_info_s, flash, internal, psram

### Community 378 - "ChannelTracker"
Cohesion: 0.50
Nodes (3): ChannelTracker, has_logged, last_ts

## Knowledge Gaps
- **1790 isolated node(s):** `m_pDec`, `m_pDecL1`, `m_pDecL2`, `m_pDecL3`, `m_lastMP3FrameInfo` (+1785 more)
  These have ≤1 connection - possible missing edges or undocumented components. (Counts symbols only; 3059 node(s) total have ≤1 connection when file, concept and rationale nodes are included.)
- **90 thin communities (<3 nodes) omitted from report** — run `graphify query` to explore isolated nodes.

## Suggested Questions
_Questions this graph is uniquely positioned to answer:_

- **Why does `TensorBase` connect `TensorBase` to `FeatImpl`, `dl_detect_postprocessor.hpp`, `dl_tensor_base.cpp`, `ModelContext`, `MemoryChunk`, `feature_t`, `dl_recognition_database.cpp`, `DataBase`, `ClsPostprocessor`, `dl_base_pool2d.hpp`, `LSTM`, `Pad`, `GRU`, `LpNormalization`, `ReduceBase`, `ImagePreprocessor`, `Transpose`, `math`, `ConvArgsType`, `ExponentInfo`, `Matrix`, `Resize`, `dl_module_lut.hpp`, `elemwiseArgsType`, `dl_model_context.cpp`, `RMSNormalization`, `PRelu`, `resizeArgsType`, `module_forward_dual_core`, `.get_element_ptr`, `requantizeArgsType`, `Slice`, `ESP-DL`, `dl_module_reduce_base.hpp`, `Model`, `quant_type_to_string`, `dl_model_base.cpp`, `dl_base_div.cpp`, `TensorInfo`?**
  _High betweenness centrality (0.121) - this node is a cross-community bridge._
- **Why does `memset` connect `TensorBase` to `Mat`, `ImageTransformer`, `ModelContext`, `dl_fbank.cpp`, `SDCardDriver`, `main`, `matrix.h`, `cJSON_Compare`, `cJSON_bool`, `process_frame`, `unity.c`, `GRU`, `cJSON.c`, `3d_kalman_demo.cpp`, `CMpaDecObj`, `misc_tests.c`, `unity.h`, `print_number.c`, `Rect`, `cborparser.c`, `parse_number.c`, `print_value.c`?**
  _High betweenness centrality (0.071) - this node is a cross-community bridge._
- **Why does `Module` connect `Module` to `Max`, `And`, `HardSwish`, `Greater`, `GreaterOrEqual`, `Sqrt`, `Mul`, `Not`, `Swish`, `ModelContext`, `ReduceL2`, `ReduceLogSum`, `ReduceMin`, `ReduceSum`, `ReduceSumSquare`, `Xor`, `TensorBase`, `HardSigmoid`, `MemoryManagerGreedy`, `AveragePool`, `LessOrEqual`, `GlobalAveragePool`, `LSTM`, `Pad`, `GRU`, `Min`, `LpNormalization`, `ReduceBase`, `DualCoreWorkerRuntime`, `Transpose`, `Or`, `Sigmoid`, `Sub`, `Resize`, `dl_module_lut.hpp`, `MaxPool`, `FbsModel`, `RMSNormalization`, `dl_module_base.hpp`, `LayerNormalization`, `PRelu`, `dl_module_reduce_log_sum_exp.hpp`, `Concat`, `ScatterND`, `ReduceMean`, `module_forward_dual_core`, `.get_element_ptr`, `Slice`, `ESP-DL`, `Model`, `ReduceProd`, `quant_type_to_string`, `dl_model_base.cpp`, `Elu`, `TensorInfo`, `Div`, `Mod`, `Less`, `.print`?**
  _High betweenness centrality (0.063) - this node is a cross-community bridge._
- **Are the 34 inferred relationships involving `TensorBase` (e.g. with `MemoryManagerGreedy::alloc_internal_tensor()` and `MemoryManagerGreedy::alloc_tensor()`) actually correct?**
  _`TensorBase` has 34 INFERRED edges - model-reasoned connections that need verification._
- **What connects `m_pDec`, `m_pDecL1`, `m_pDecL2` to the rest of the system?**
  _1790 weakly-connected nodes found - possible documentation gaps or missing edges._
- **Should `dsp_err.h` be split into smaller, more focused modules?**
  _Cohesion score 0.04055245371730826 - nodes in this community are weakly interconnected._
- **Should `dsps_fft2r_sc16_ansi.c` be split into smaller, more focused modules?**
  _Cohesion score 0.058653846153846154 - nodes in this community are weakly interconnected._
