pacman314159/OISP-Drone-Research/research_docs/Closing the gap between Stability and Schedulability presentation.pdf

## Jinkyu Lee

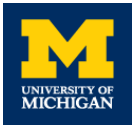
[picture p3: figure]
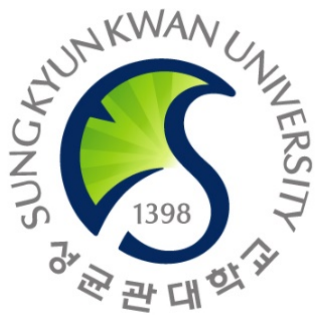
[picture p4: figure]

Sungkyunkwan University (SKKU)

## Closing the Gap between Stability and Schedulability: A New Task Model for Cyber-Physical systems

## Hoon Sung Chwa and Kang G. Shin

University of Michigan

## Cyber-Physical Systems

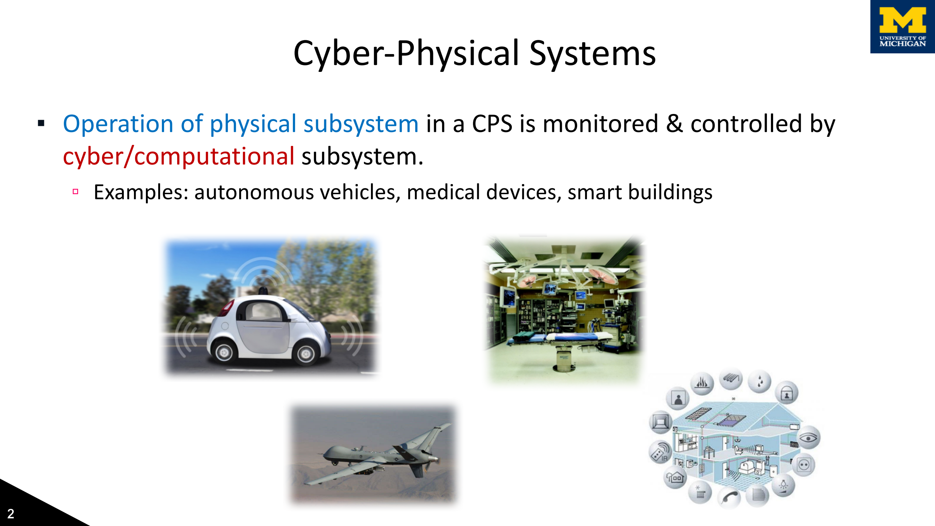
[picture p5: page 2]

- Operation of physical subsystem in a CPS is monitored & controlled by cyber/computational subsystem.
- Examples: autonomous vehicles, medical devices, smart buildings

## Cyber-Physical Systems

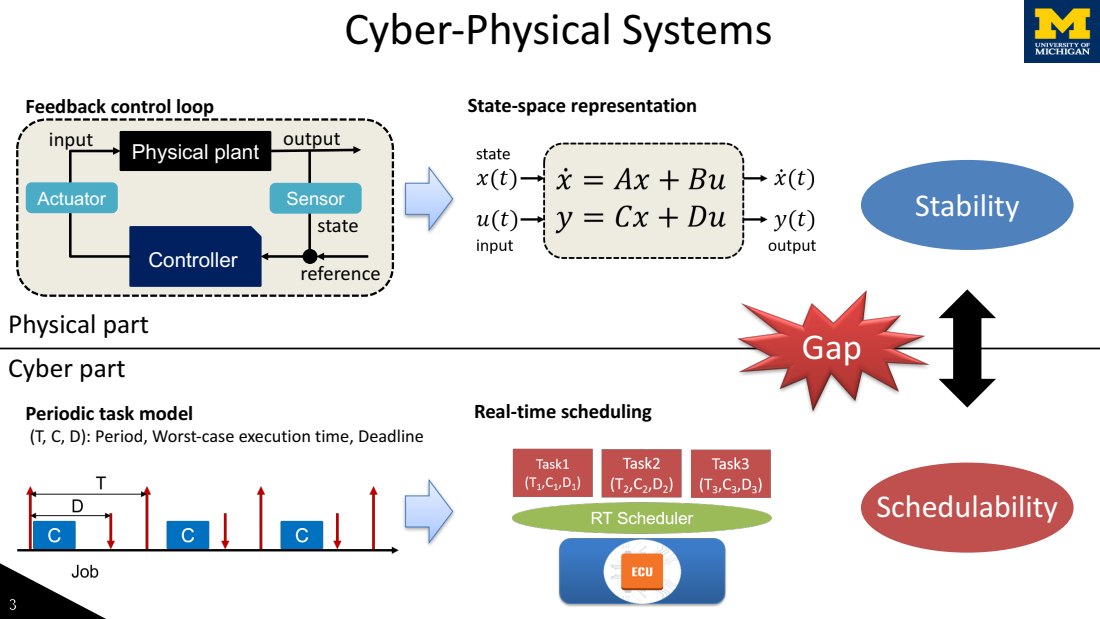
[picture p6: page 3]
Physical plant; Controller; reference; Actuator; Sensor; state; input; output; Stability; Schedulability; Physical part; Cyber part; Gap

Feedback control loop

State-space representation

Real-time scheduling

Periodic task model
(T, C, D): Period, Worst-case execution time, Deadline

## Motivation

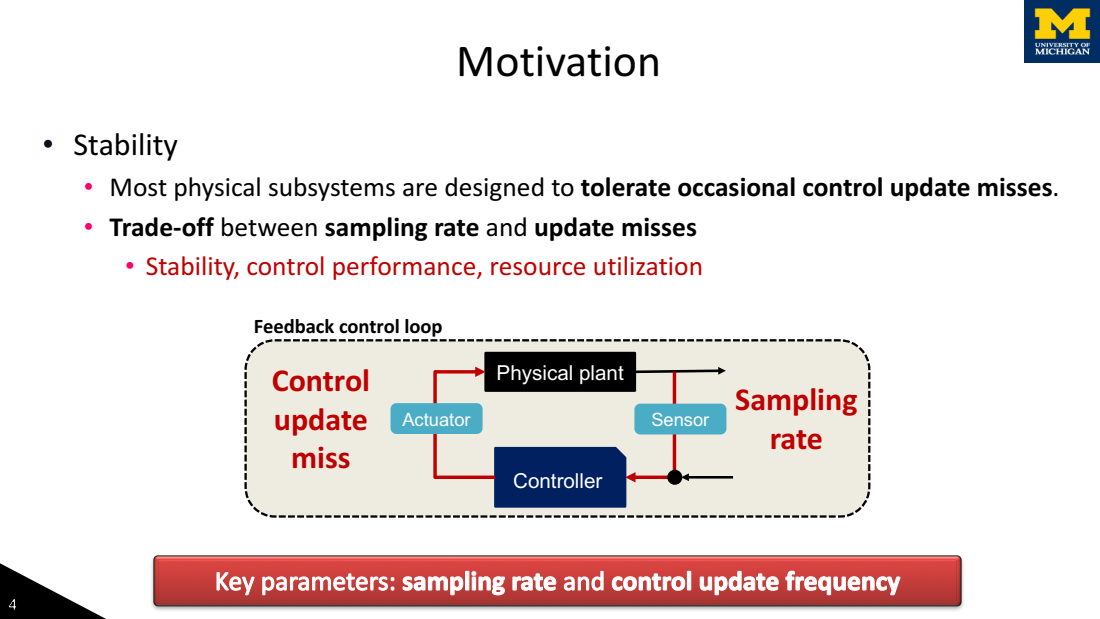
[picture p7: page 4]
Physical plant; Controller; Actuator; Sensor; Sampling; rate

• Stability
• Most physical subsystems are designed to tolerate occasional control update misses.
• Trade-off between sampling rate and update misses
• Stability, control performance, resource utilization

Feedback control loop
Control
update
miss

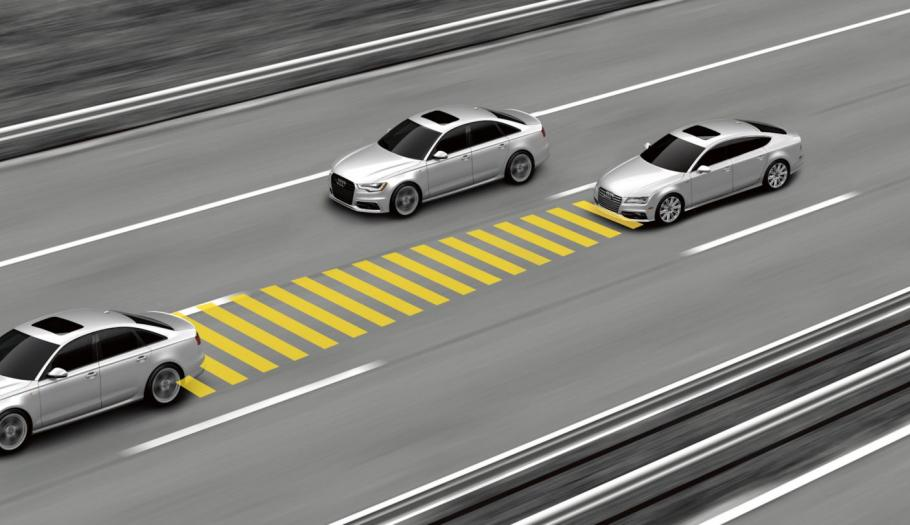
[picture p8: figure]

- Adaptive Cruise Control (ACC)
- Goal: maintain a safe distance

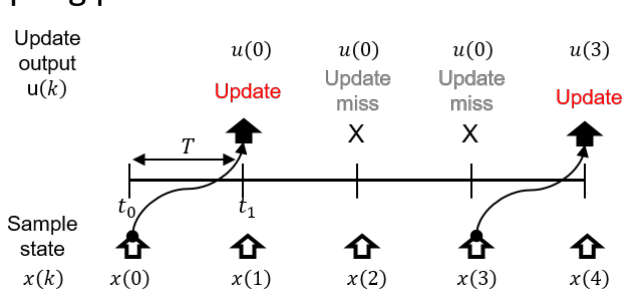
[picture p9: figure]
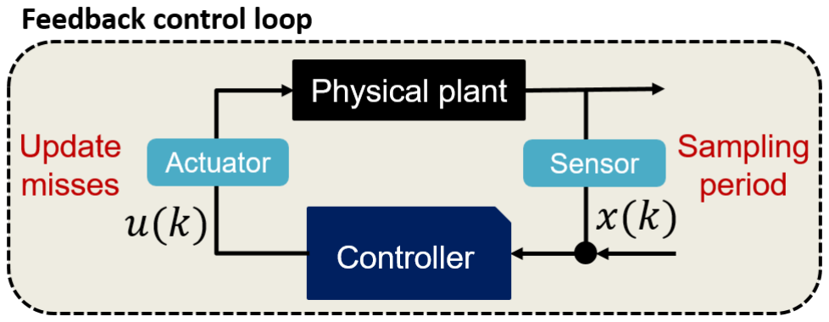
[picture p10: figure]

- Input: inter-vehicle distance (δ), velocity (∆v)
- Output: vehicle acceleration (a) <speed control>
- Periodic (feedback) control loop
- Sampling period: T

## Case Study: ADAS system

## Case Study: ADAS system

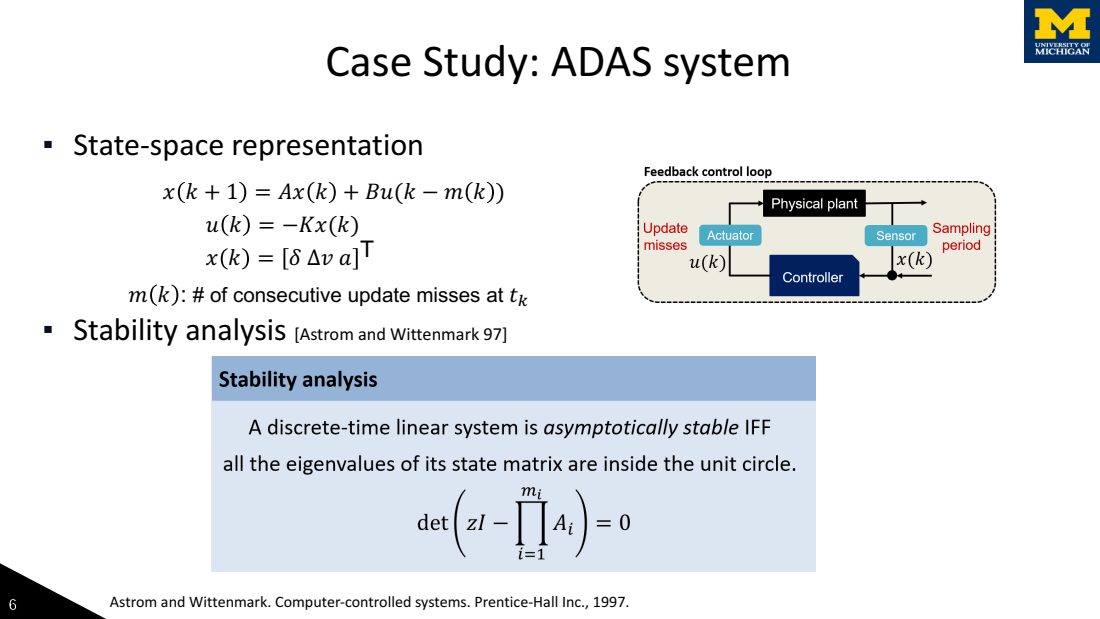
[picture p11: page 6]

▪ State-space representation

m k : # of consecutive update misses at t5

▪ Stability analysis [Astrom and Wittenmark 97]

Astrom and Wittenmark. Computer-controlled systems. Prentice-Hall Inc., 1997.

- Stability region

## Observation

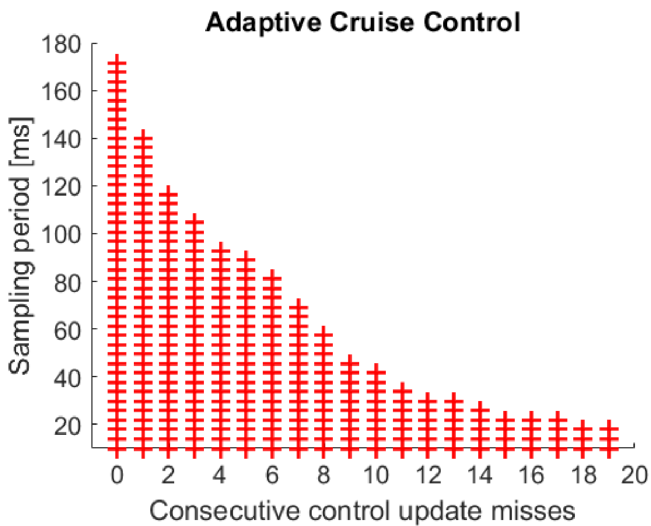
[picture p12: figure]

- Stability region

## Observation

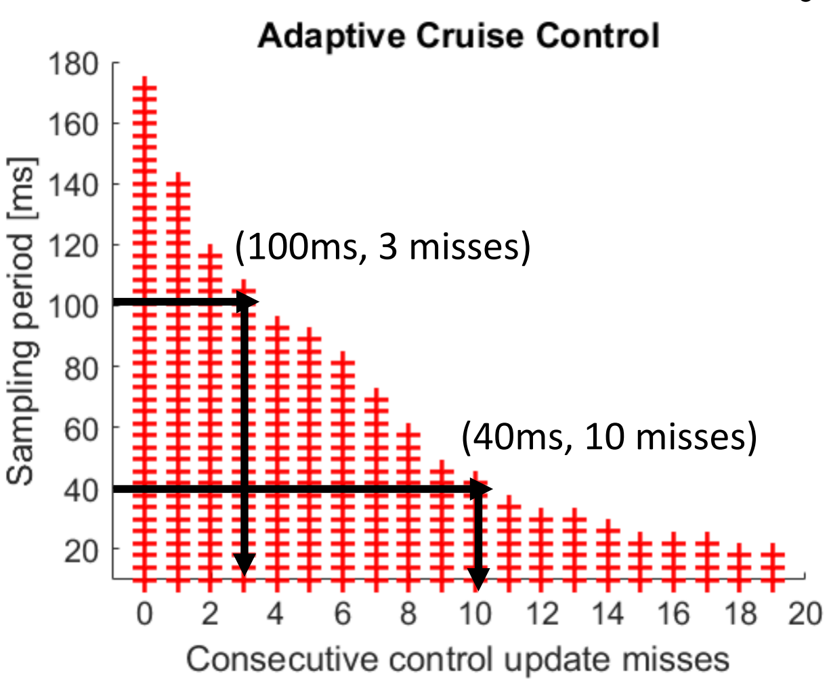
[picture p13: figure]
(100ms, 3 misses); (40ms, 10 misses)

- Shorter sampling period ->
more tolerable consecutive control update misses

- Stability region

## Observation

- Shorter sampling period ->
more tolerable consecutive control update misses

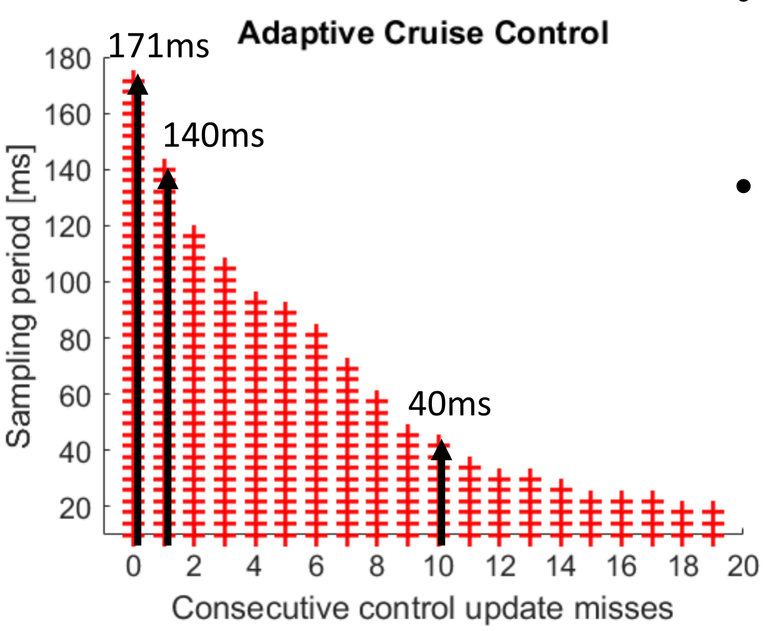
[picture p14: figure]

- Shorter period allowing more update misses -> Stability guarantee with much fewer resources

When m=0,

171ms

When m=1,

(1+1)140 = 280ms

When m=10,

(10+1) 40 = 440ms

Effective control update period

(m: consecutive control update misses)

- Stability region

## Observation

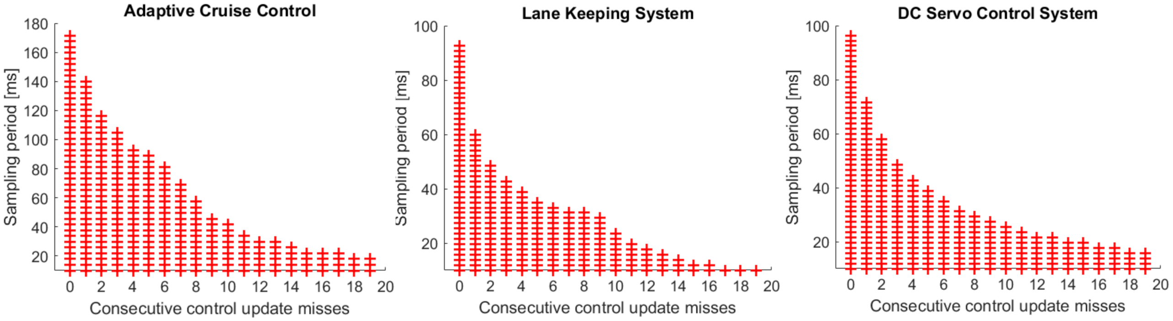
[picture p15: figure]

- Control performance (standard quadratic performance index)
- Deviation from the desired state

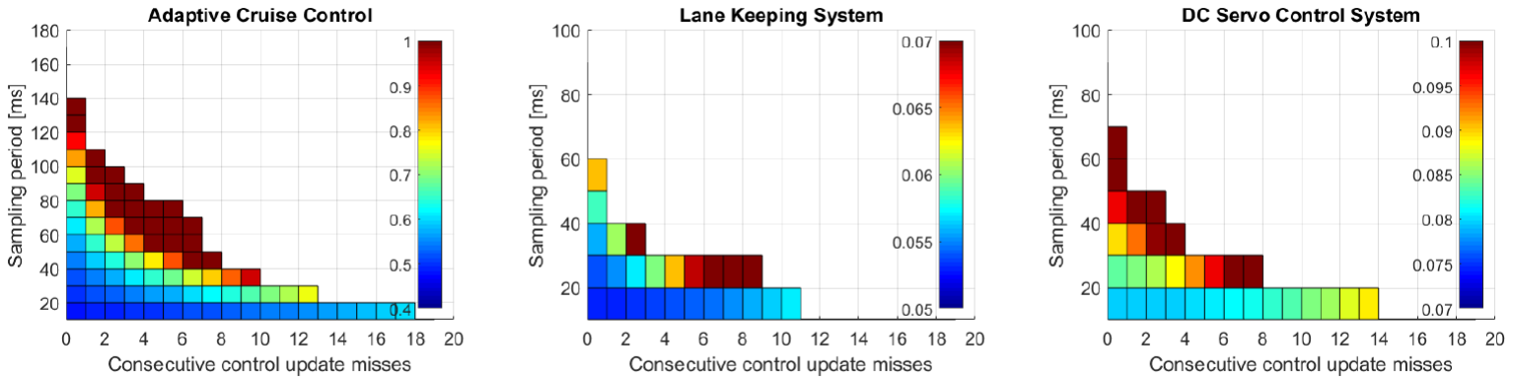
[picture p16: figure]

- Control performance degrades as both the sampling period and # update misses increase.

## Observation

## Observation

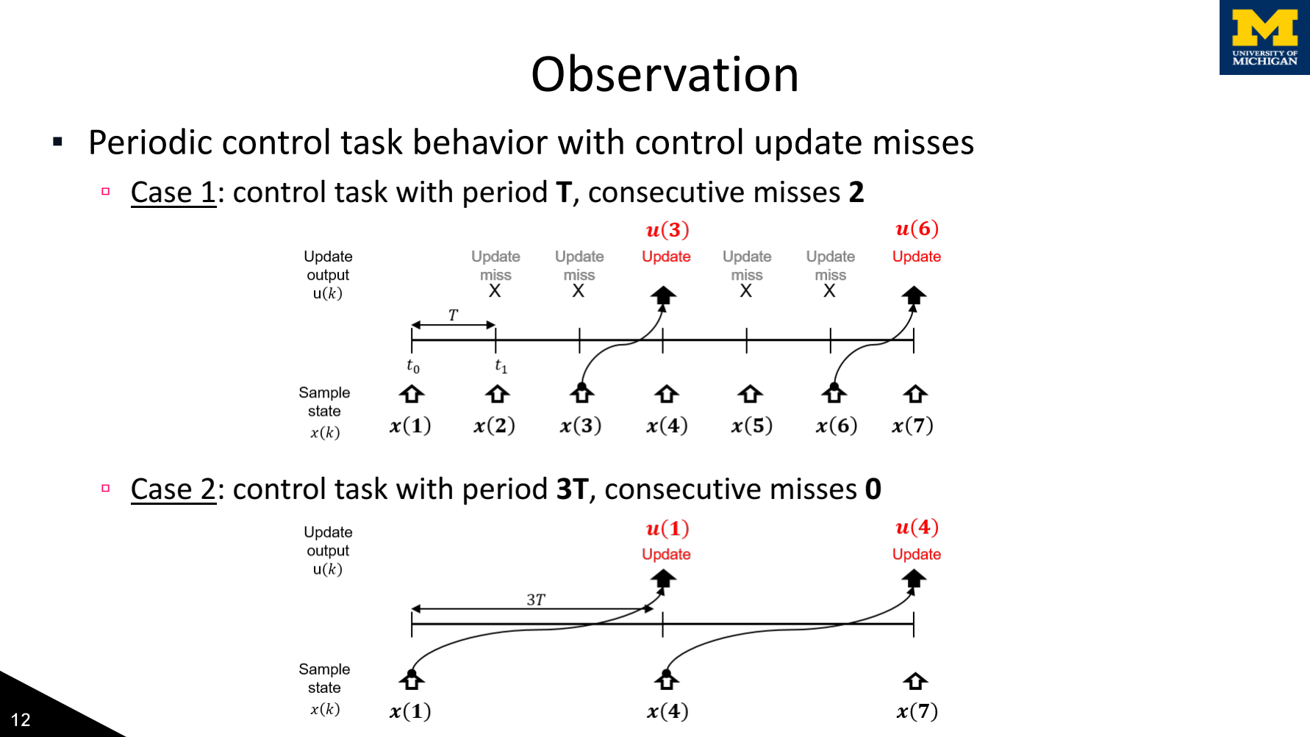
[picture p17: page 12]

- Periodic control task behavior with control update misses
- Case 1: control task with period T, consecutive misses 2
- Case 2: control task with period 3T, consecutive misses 0

## Implication

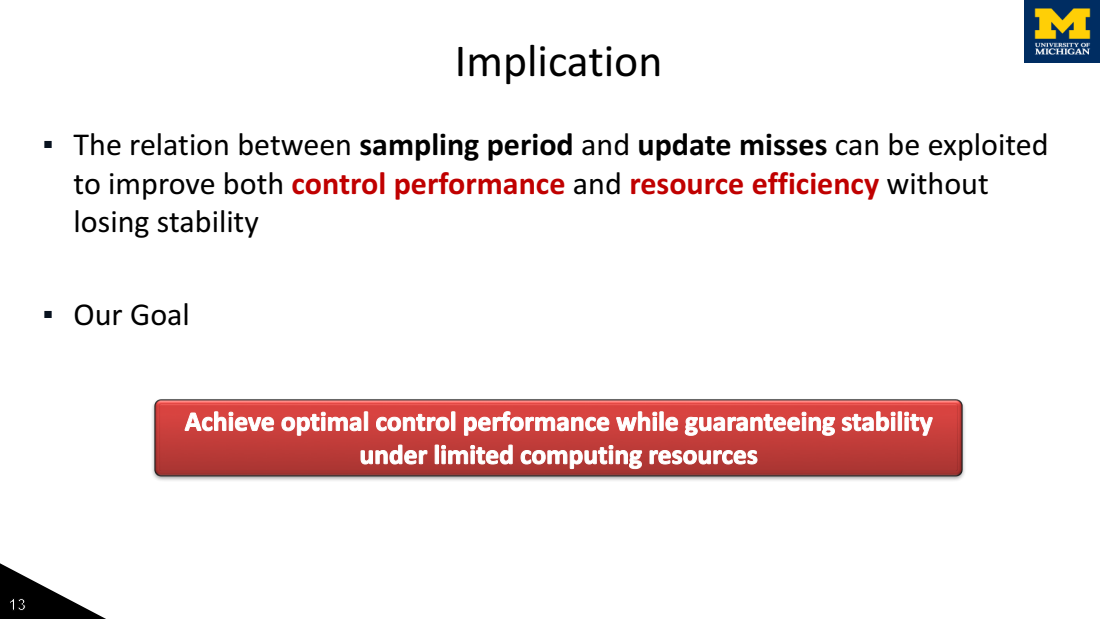
[picture p18: page 13]
▪ Our Goal

▪ The relation between sampling period and update misses can be exploited
to improve both control performance and resource efficiency without
losing stability

- Control-schedule co-design
- Optimal period assignment to maximize control performance
- Online period-adjustment schemes
- Assumption: strict hard guarantee of every deadline
- Fault-tolerant scheduling
- Relaxation of strict hard real-time guarantees
- (m,k)-firm deadline, skip-over model, weakly-hard task model
- Allow occasional control signal drops or skipping jobs
- Assumption: fixed or given task periods

## State of the Art

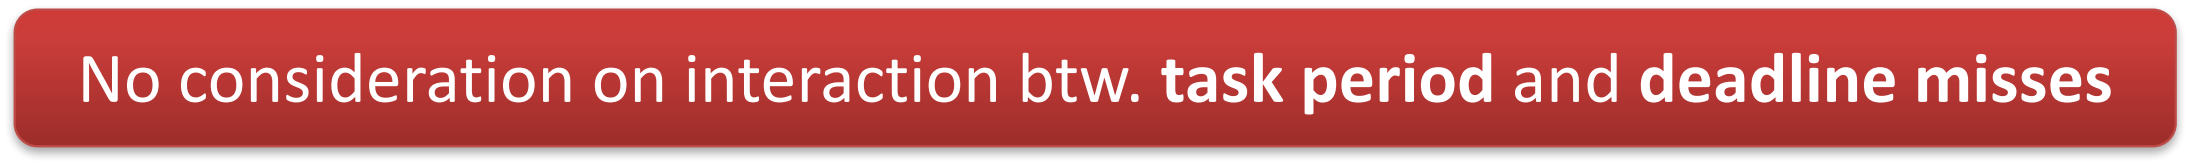
[picture p19: figure]

No consideration on interaction btw. task period and deadline misses

[Seto et al. 96] [Bini and Cervin 08] [Xu et al. 15] [Cervin et al. 04]
[Wu et al. 10] [Aminifar et al. 12] [Palopoli et al. 02] [Khatib et al. 17] [Cervin et al. 02] [Marti et al. 04] [Castane et al. 06]

[Palopoli et al. 00] [Branicky et al. 02] [Kauer et al. 14] [Goswami et al. 14] [Soudbakhsh et al. 13] [Majumdar et al. 11] [Yoshimoto et al. 11]

## Our Approach

New CPS task model

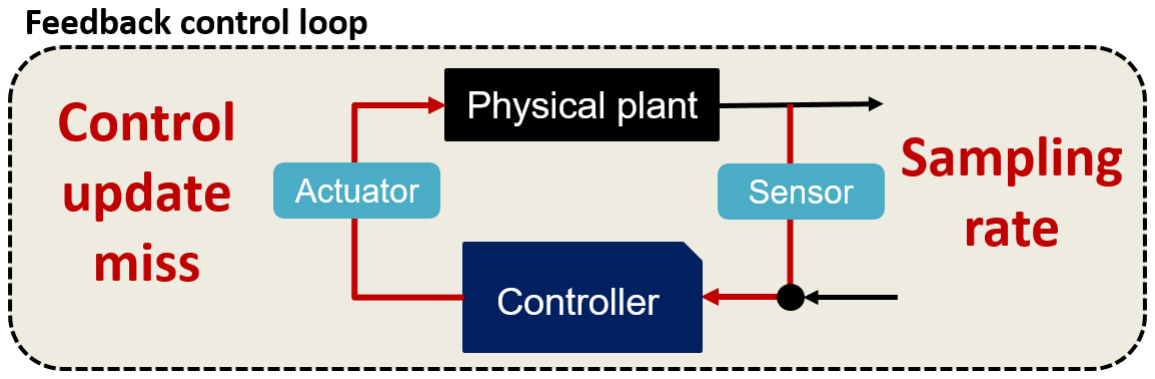
[picture p20: figure]

New scheduling mechanism

- captures the trade-off between sampling period and control update misses ü Stability, control performance
- Determines task periods and manage deadline misses
ü Improves control performance without losing stability
ü Utilizes limited resources efficiently

- For each control task τ7

## New CPS Task Model

(T7, C7,D7)

Classical
real-time task model
({(m7,[T7

=7> m7 , T7

=?@(m7)])}, C7,D7)

New
CPS task model

m7: maximum tolerable consecutive deadline misses

Generalize

Stable pair

- For a given set of control tasks,
- Step 1 [offline parameter assignment]
- Determine τ7: m7, T7, C7,D7 | ({(m7,[T7 =7> m7 , T7

=?@(m7)])}, C7,D7)
guaranteeing stability
- Step 2 [online state-aware scheduling]
- Generate actual schedule by dynamically controlling deadline misses (≤ m7)
- Consider plant state to maximize control performance without losing stability

## Problem

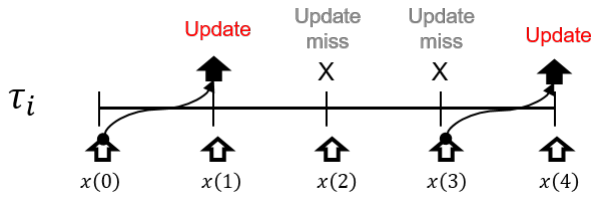
[picture p21: figure]

- How to find a stable parameter assignment?
- How to find a performance-optimal parameter assignment among stable parameter assignments?

## Offline Parameter Assignment

## Offline Parameter Assignment

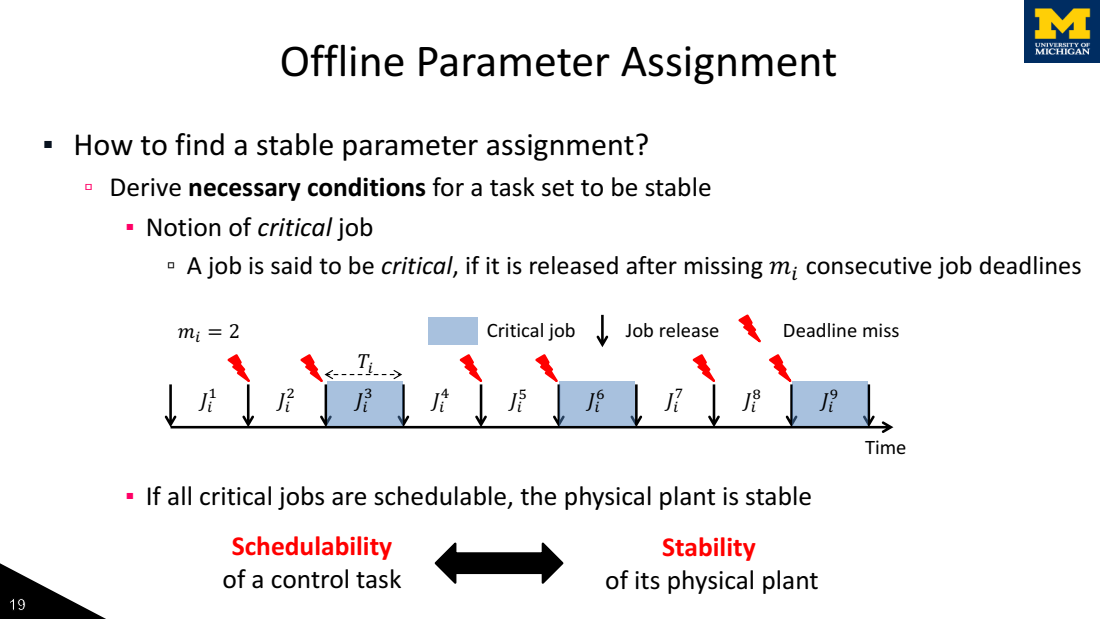
[picture p22: page 19]
Time; Critical job; Job release; Deadline miss

▪ How to find a stable parameter assignment?
▫ Derive necessary conditions for a task set to be stable
▪ Notion of critical job
▫ A job is said to be critical, if it is released after missing m7 consecutive job deadlines

▪ If all critical jobs are schedulable, the physical plant is stable

Schedulability
of a control task

Stability
of its physical plant

## Offline Parameter Assignment

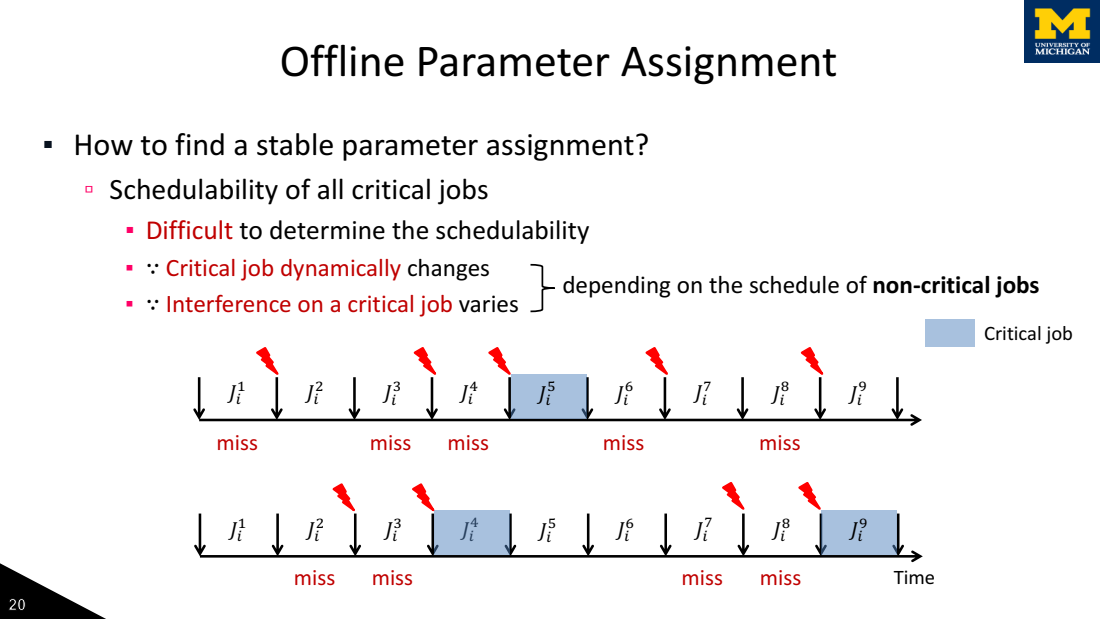
[picture p23: page 20]
Time; miss; Critical job

▪ How to find a stable parameter assignment?
▫ Schedulability of all critical jobs
▪ Difficult to determine the schedulability
▪ ∵ Critical job dynamically changes
▪ ∵ Interference on a critical job varies

depending on the schedule of non-critical jobs

## Offline Parameter Assignment

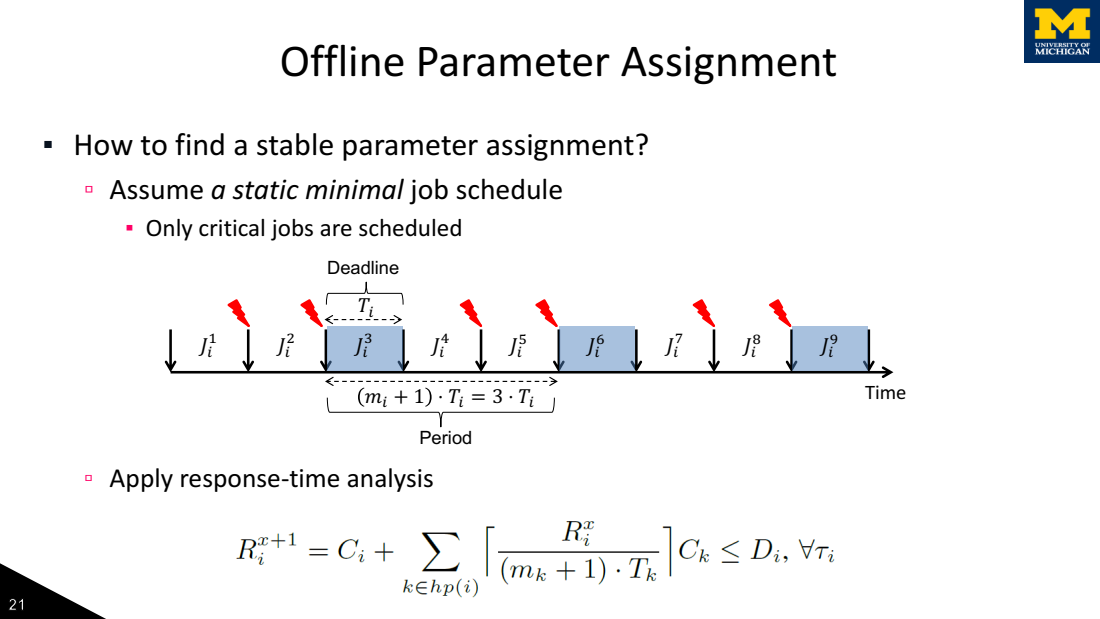
[picture p24: page 21]
Time; Period; Deadline T7

▪ How to find a stable parameter assignment?
▫ Assume a static minimal job schedule
▪ Only critical jobs are scheduled

▫ Apply response-time analysis

- How to find a performance-optimal parameter assignment among stable parameter assignments?
- Optimization problem

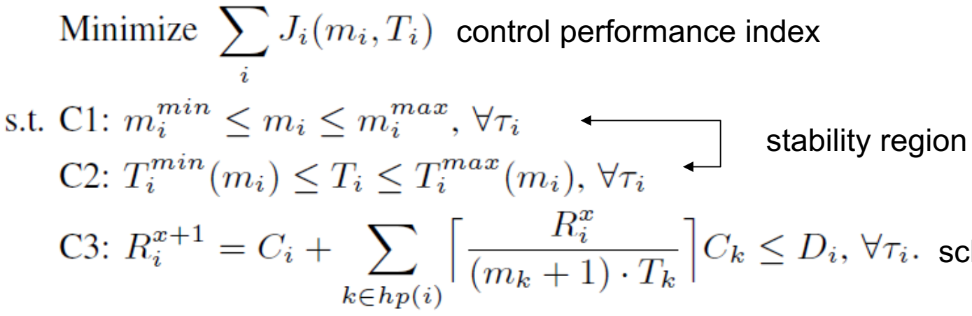
[picture p25: figure]
control performance index; stability region

- Exponentially increasing search space
- Two-step approach

## Offline Parameter Assignment

schedulability of critical jobs

## State-aware Online Scheduling

- Upon JOB-RELEASE or JOB-COMPLETION
- Maintain two types of queue: ready queue and wait queue
- Check the possibility of executing non-critical jobs

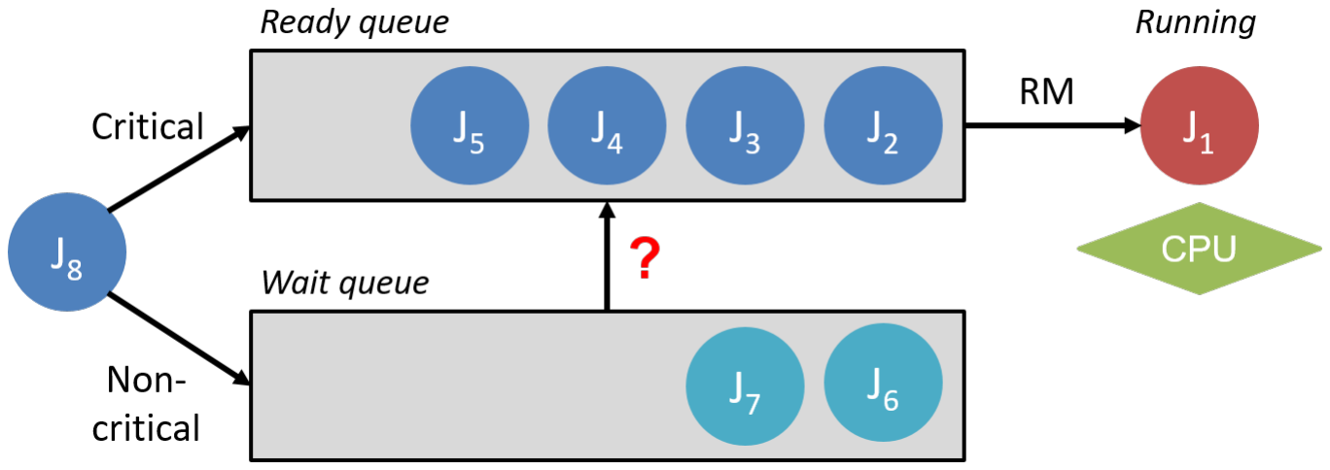
[picture p26: figure]

## State-aware Online Scheduling

- How to ensure deadline guarantees of all critical jobs?
- Challenge
- Infinite number of critical jobs will be released in future
- Synchronous release is no longer the critical instant
- Our approach
- Prove that sufficient to check only one critical job that will be released earliest
- Develop schedulability analysis

- Autonomous vehicle control system
- Adaptive cruise control, lane keeping control, DC-servo control
- 3 control tasks + hard real-time tasks

## Evaluation

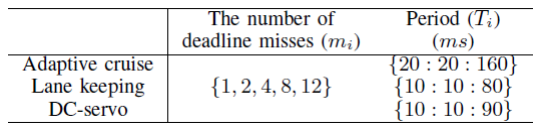
[picture p27: figure]

- Comparison

## Evaluation

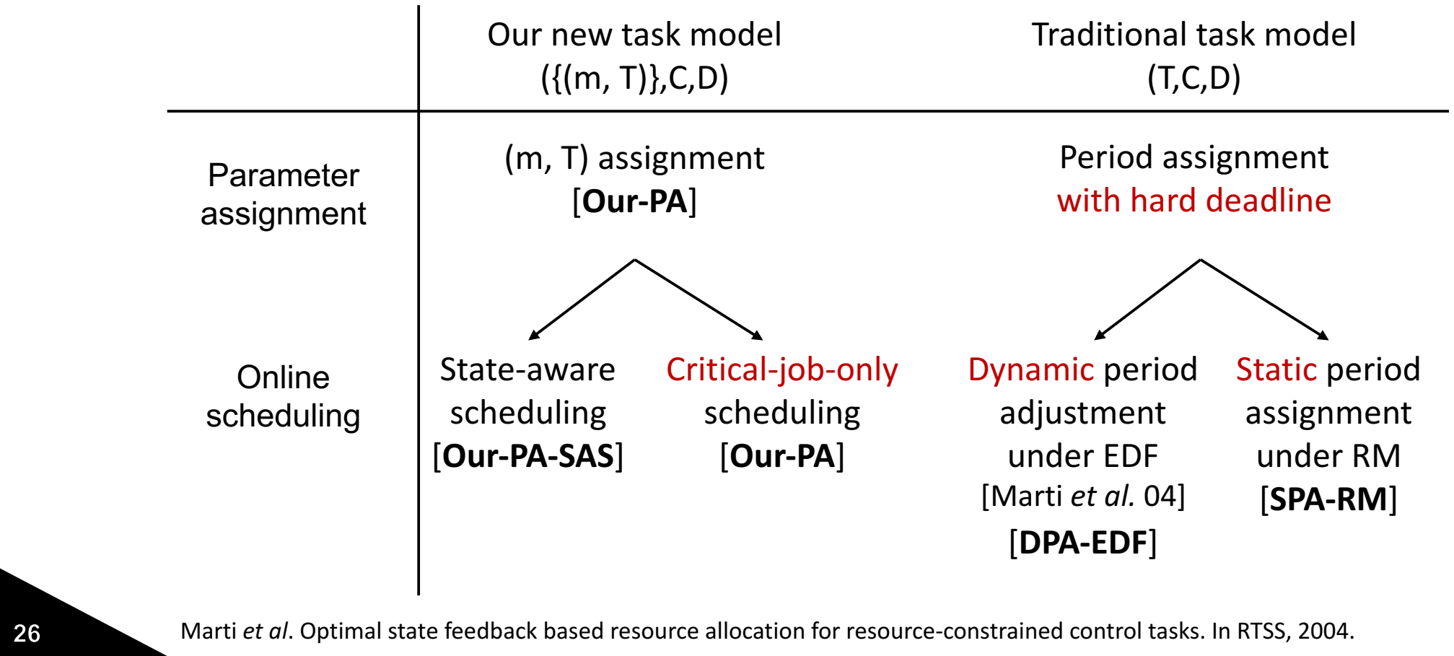
[picture p28: figure]
[Marti et al. 04]; Our new task model ({(m, T)},C,D); Traditional task model (T,C,D); Parameter assignment; Period assignment with hard deadline; (m, T) assignment [Our-PA]; Online scheduling; State-aware scheduling [Our-PA-SAS]; Critical-job-only scheduling [Our-PA]; Dynamic period adjustment under EDF; [DPA-EDF]; Static period assignment under RM [SPA-RM]

Marti et al. Optimal state feedback based resource allocation for resource-constrained control tasks. In RTSS, 2004.

- Evaluation criteria
- Scheduling performance (cyber part)
- The number of task sets schedulable by the proposed technique

## Evaluation

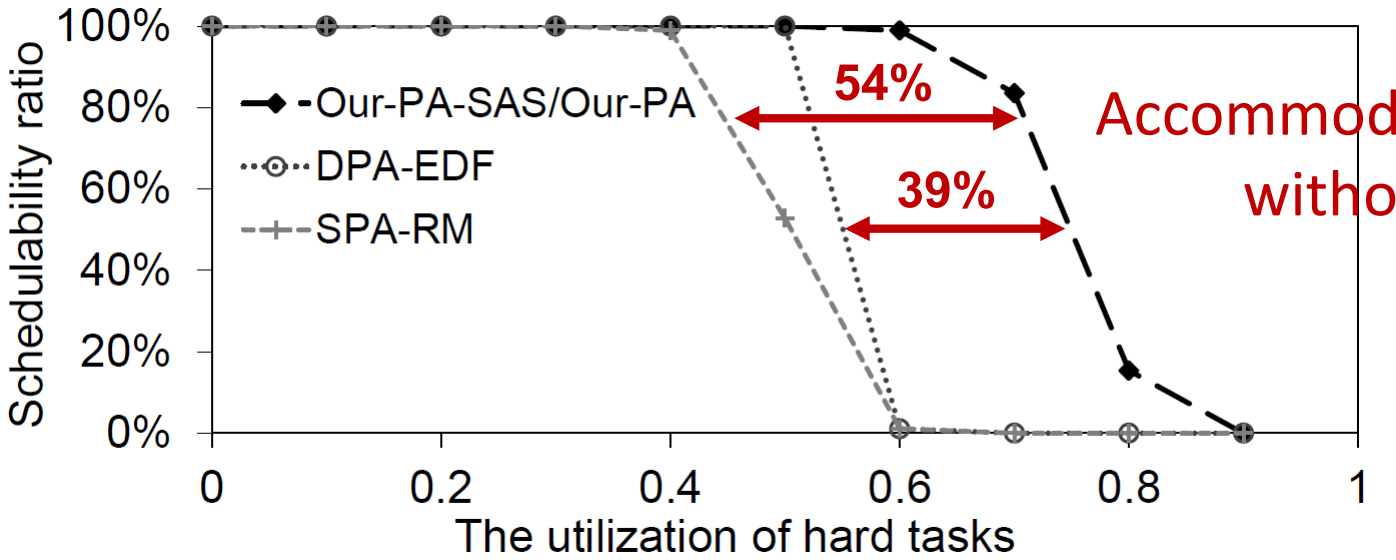
[picture p29: figure]

Accommodate more control tasks without losing stability

## Evaluation

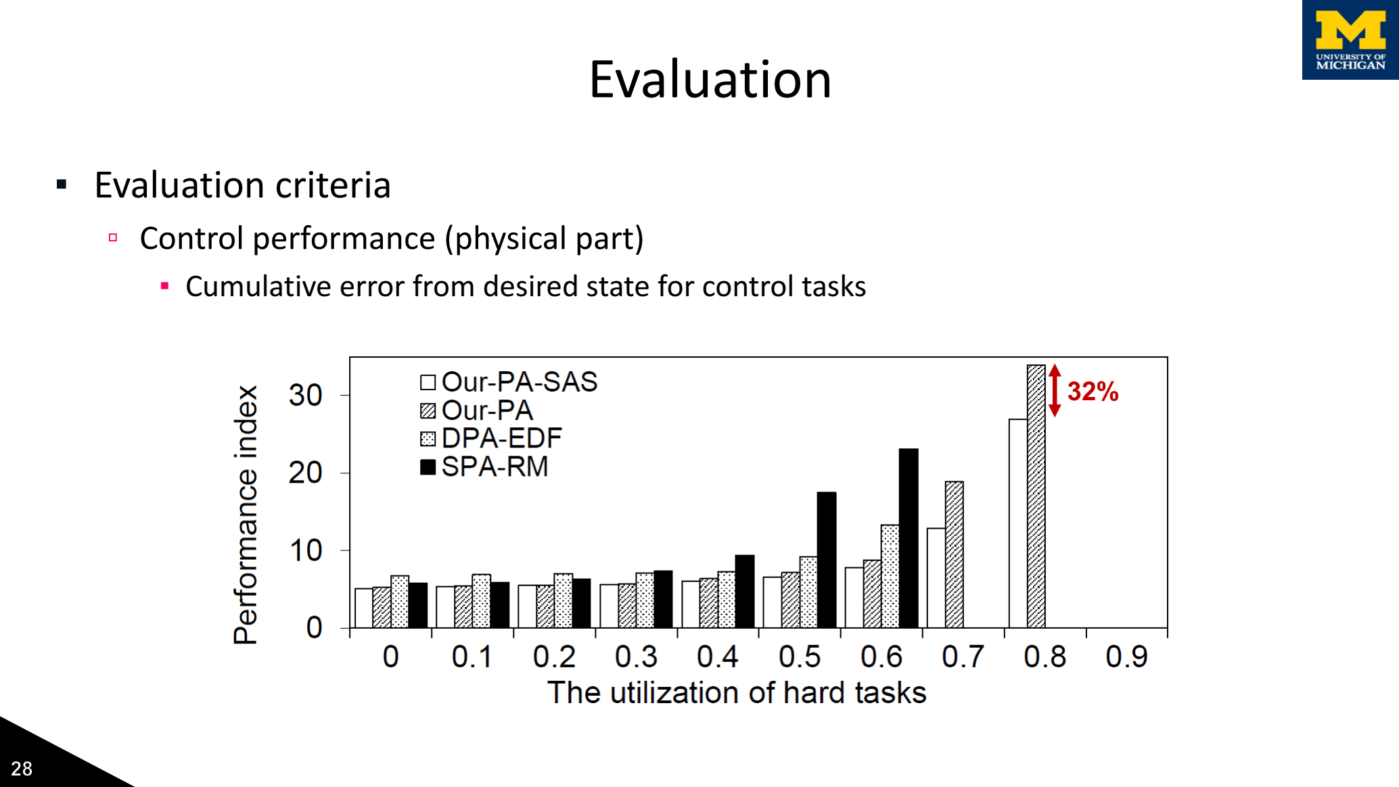
[picture p30: page 28]

- Evaluation criteria
- Control performance (physical part)
- Cumulative error from desired state for control tasks

32%

## Summary

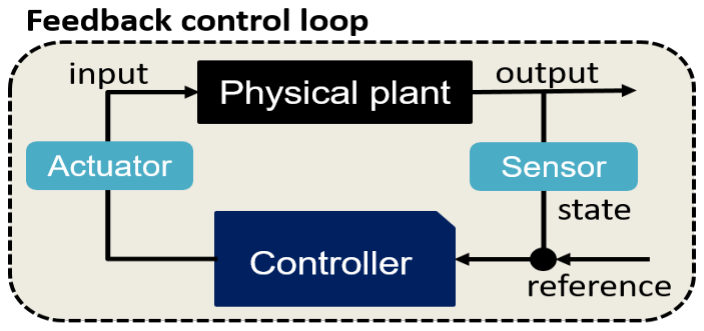
[picture p31: figure]
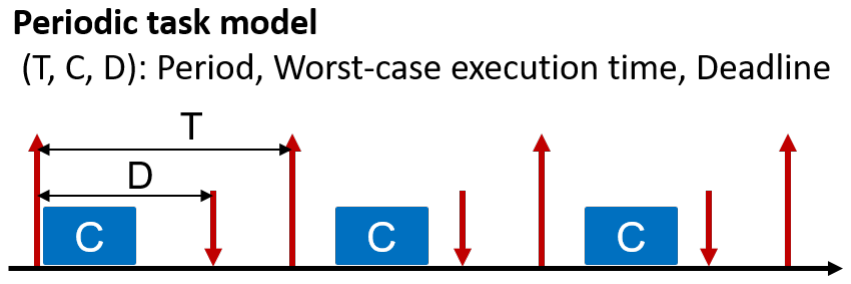
[picture p32: figure]

GAP

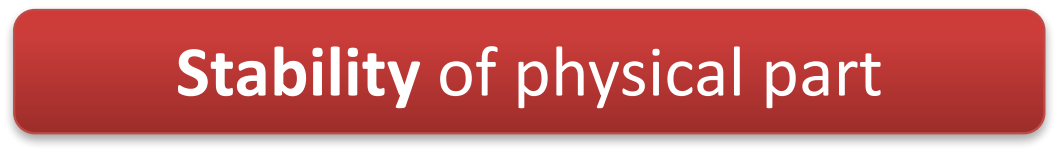
[picture p33: figure]
Stability of physical part
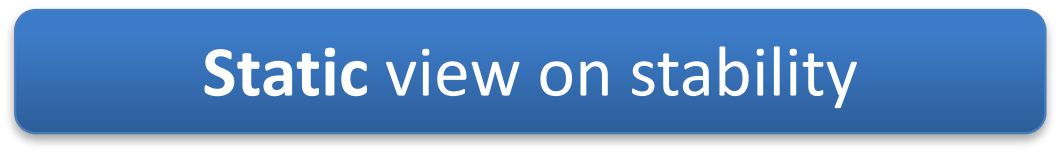
[picture p34: figure]
Static view on stability

<Physical part> | <Cyber part>
Tolerable update misses | No deadline miss allowed

Identify key parameters and their relationship Propose a new task model that captures the relationship Improve both control performance and resource utilization

## Reference

Seto et al. On task schedulability in real-time control systems. In RTSS, 1996.
Bini and Cervin. Delay-aware period assignment in control systems. In RTSS, 2008.
Xu et al. Exploiting job response-time information in the co-design of real-time control systems. In RTCSA, 2015.
Cervin et al. The jitter margin and its application in the design of real-time control systems. In RTCSA, 2004.
Wu et al. Parameter selection for real-time controllers in resource-constrained systems. In IEEE Transactions on Industrial Informatics, 2010. Aminifar et al. Designing high-quality embedded control systems with guaranteed stability. In RTSS, 2012.
Palopoli et al. Synthesis of robust control systems under resource constraints. In HSCC, 2002.
Khatib et al. Scheduling of embedded controllers under timing contracts. In HSCC, 2017.
Cervin et al. Feedback-feedforward scheduling of control tasks. In Real-Time Systems, 2002.
Marti et al. Optimal state feedback based resource allocation for resource-constrained control tasks. In RTSS, 2004.
Castane et al. Resource management for control tasks based on the transient dynamics of closed-loop systems. In ECRTS, 2006. Palopoli et al. Real-time control system analysis: an integrated approach. In RTSS, 2000.
Branicky et al. Scheduling and feedback co-design for networked control systems. In CDC, 2002.
Kauer et al. Fault-tolerant control synthesis and verification of distributed embedded systems. In DATE, 2014.
Goswami et al. Relaxing signal delay constraints in distributed embedded controllers. In IEEE Transactions on Control Systems Technology, 2014. Soudbakhsh et al. Co-design of control and platform with dropped signals. In ICCPS, 2013.
Majumdar et al. Performance-aware scheduler synthesis for control systems. In EMSOFT, 2011.
Yoshimoto et al. Optimal arbitration of control tasks by job skipping in cyber-physical systems. In ICCPS, 2011.

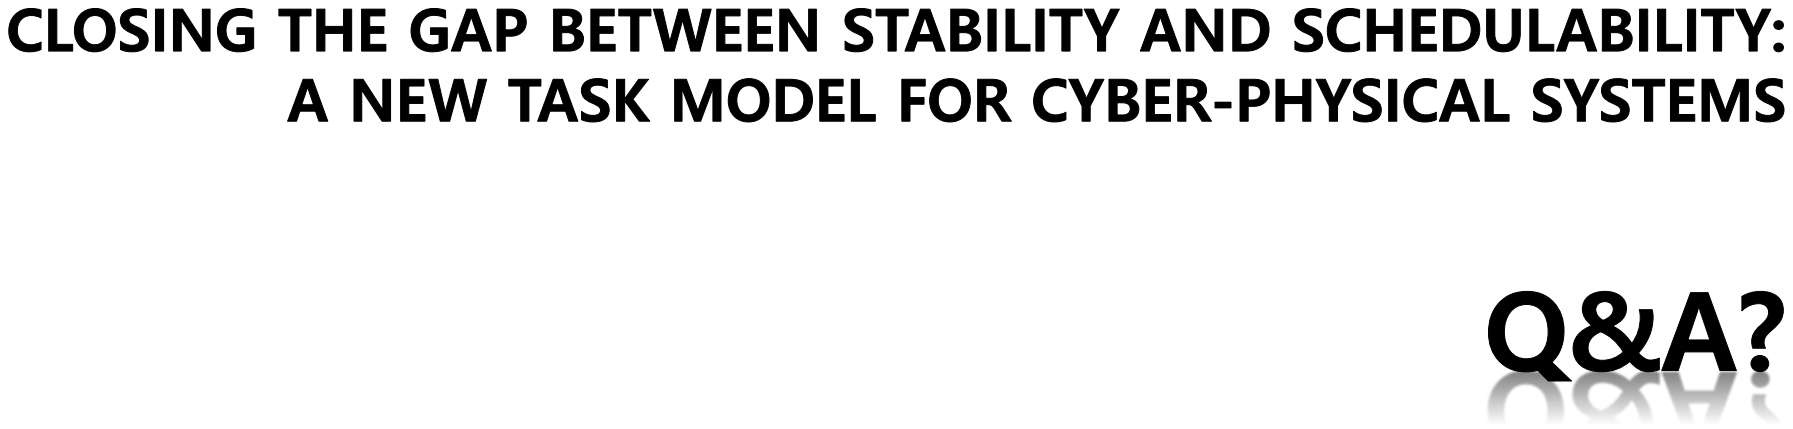
[picture p35: page 31]

- A linear system is asymptotically stable if all trajectories converge to the origin
- For any initial state x kS ,

## Stability

x k → 0 as k → ∞

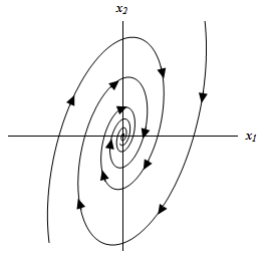
[picture p36: figure]

## State-aware Online Scheduling

- Which non-critical job to execute?
- Consider current state errors
- In steady state, no benefit by executing a non-critical job
- In transient state, control performance improvement by quick reaction to perturbation
- Choose a job with the largest error first

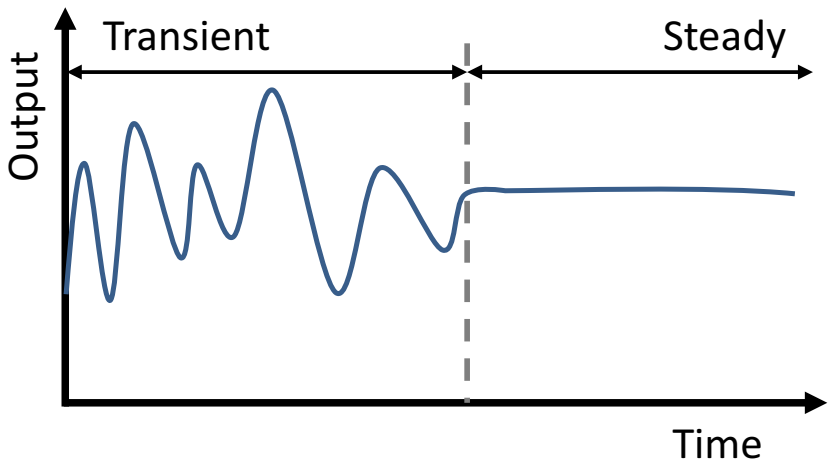
[picture p37: figure]
Time; Transient; Steady; Output

- Evaluation criteria
- Scheduling performance (cyber part)
- The number of task sets schedulable without losing stability
- Control performance (physical part)
- The sum of performance measures for control tasks
- Task set generation
- 3 control tasks + hard real-time tasks

## Evaluation
