pacman314159/OISP-Drone-Research/analyzers/baro_dist_oss0.png

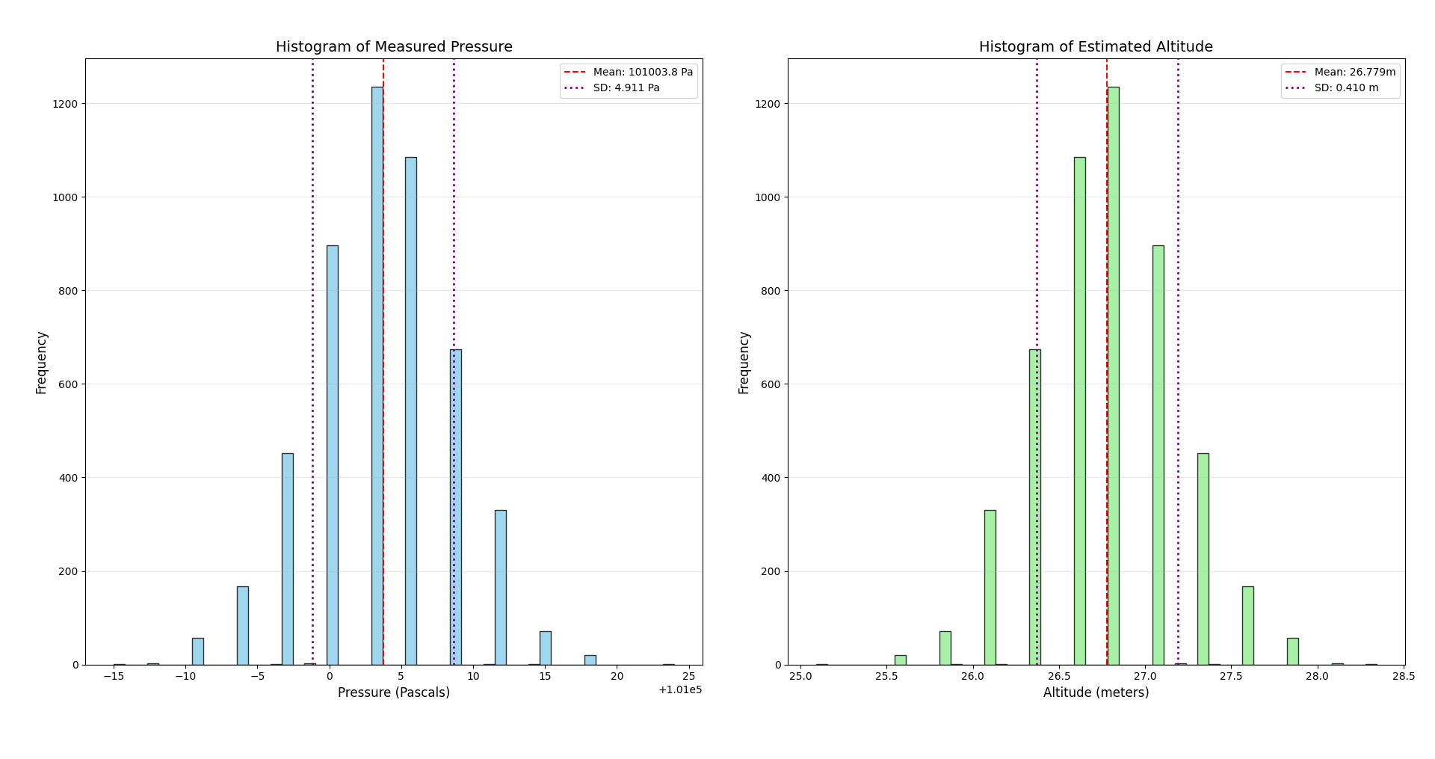
analyzers/baro_dist_oss0.png
