pacman314159/OISP-Drone-Research/analyzers/baro_dist_oss3.png

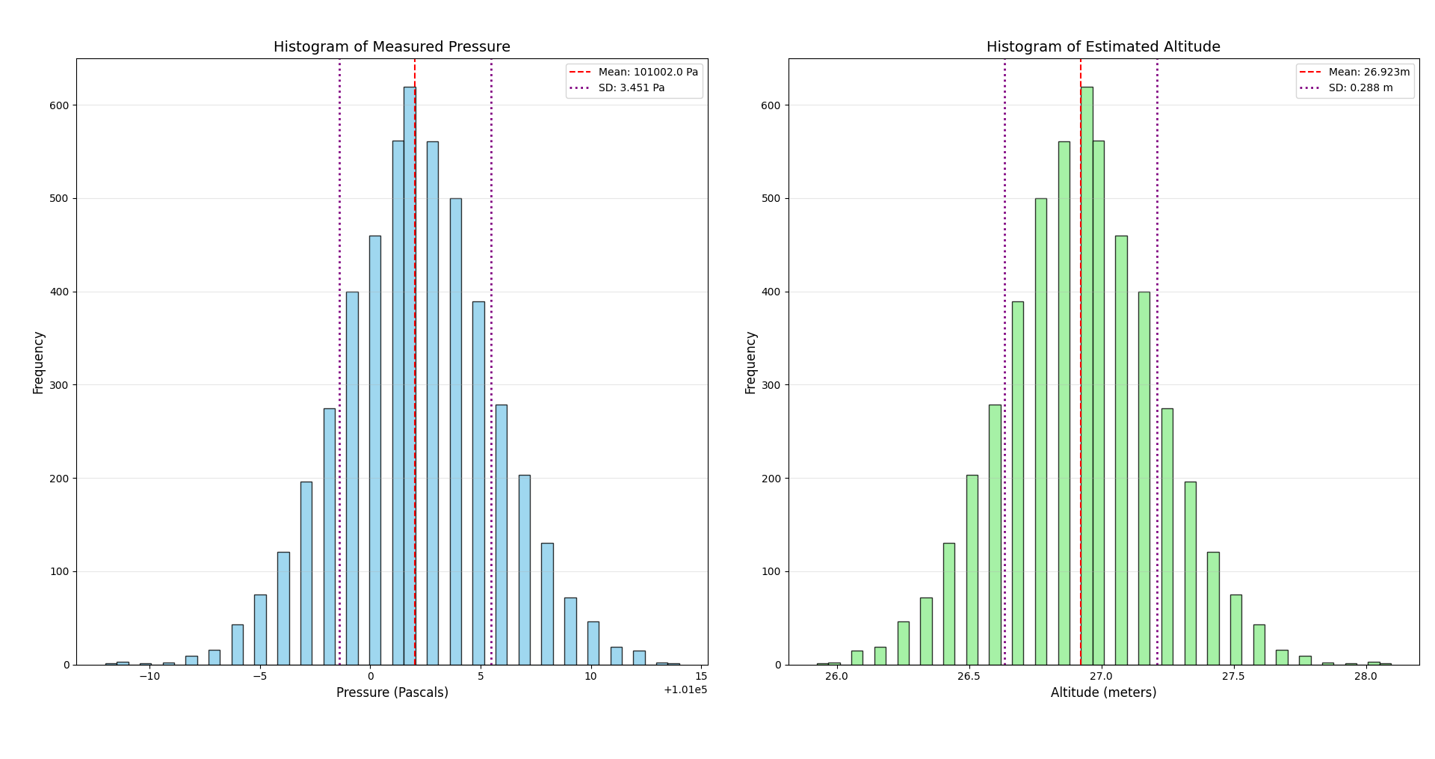
analyzers/baro_dist_oss3.png
