pacman314159/OISP-Drone-Research/analyzers/baro_fft_oss3.png

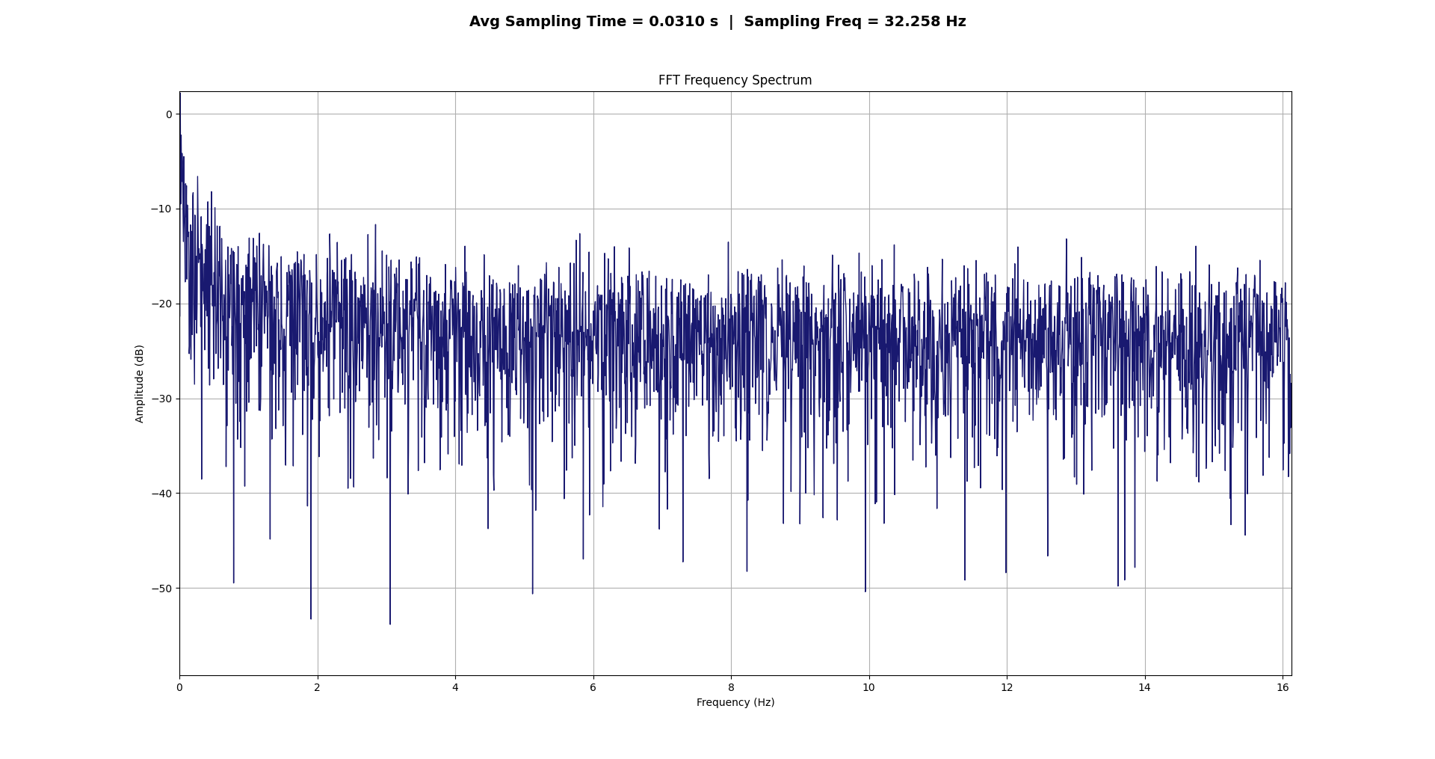
analyzers/baro_fft_oss3.png
