pacman314159/OISP-Drone-Research/analyzers/img/0000-FFT-Gyro_filt.png

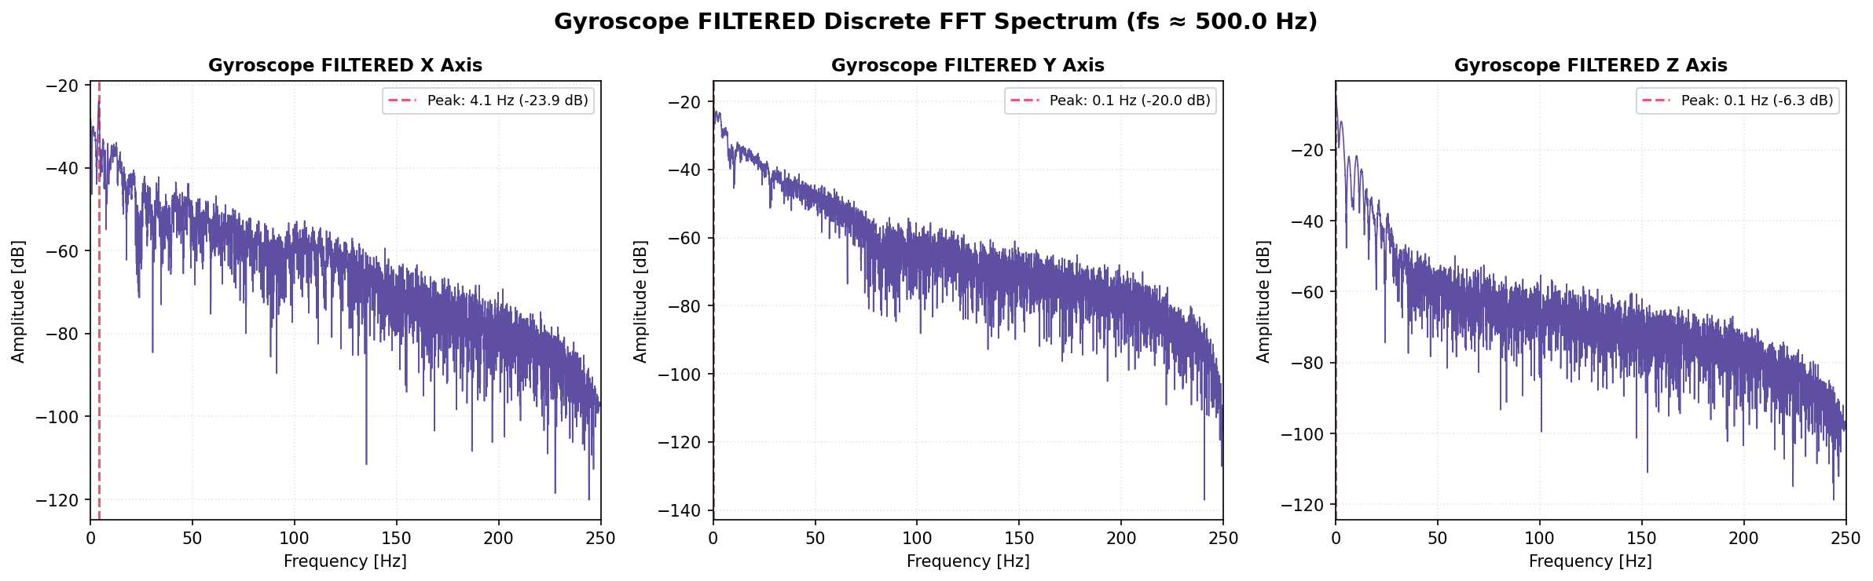
analyzers/img/0000-FFT-Gyro_filt.png
