pacman314159/OISP-Drone-Research/analyzers/img/0000-HIST-Mag_filt.png

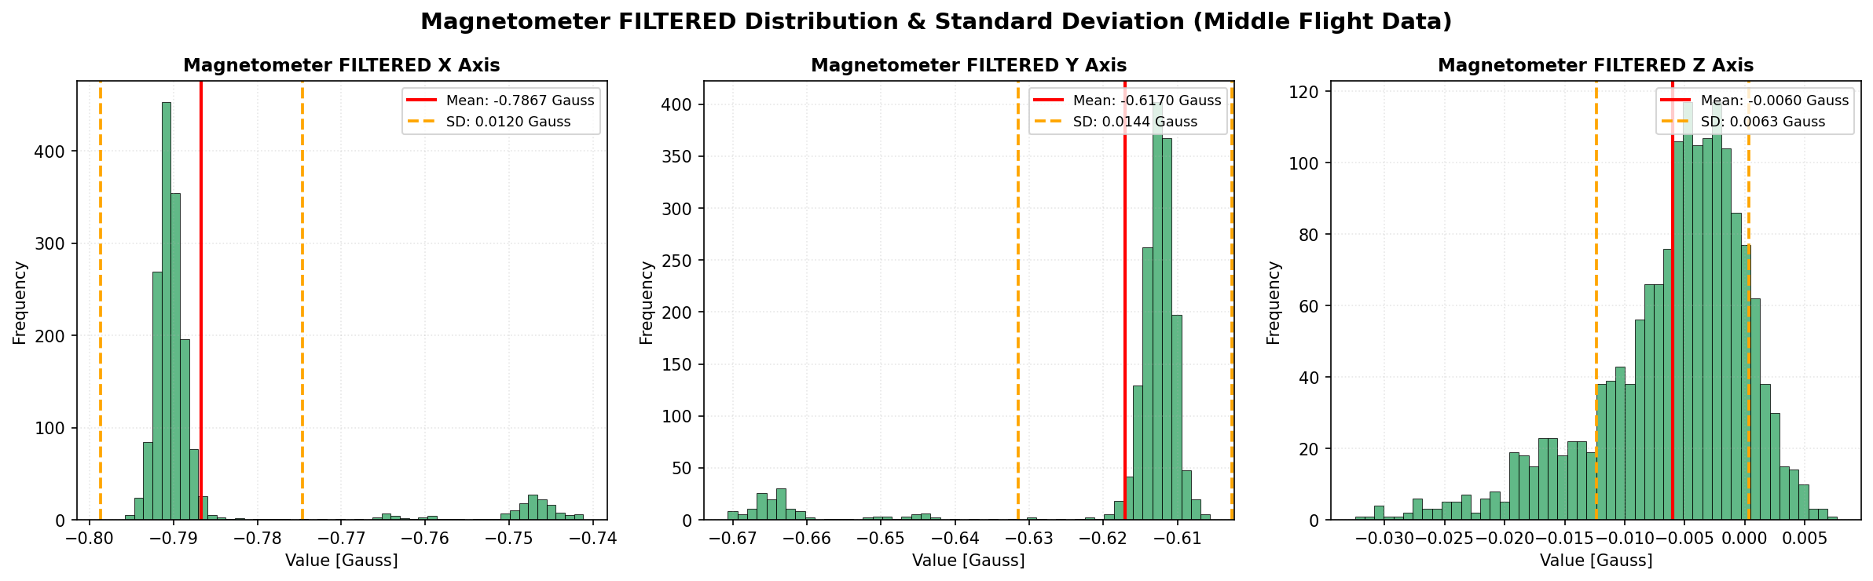
analyzers/img/0000-HIST-Mag_filt.png
