pacman314159/OISP-Drone-Research/analyzers/img/0001-FFT-Gyro_raw.png

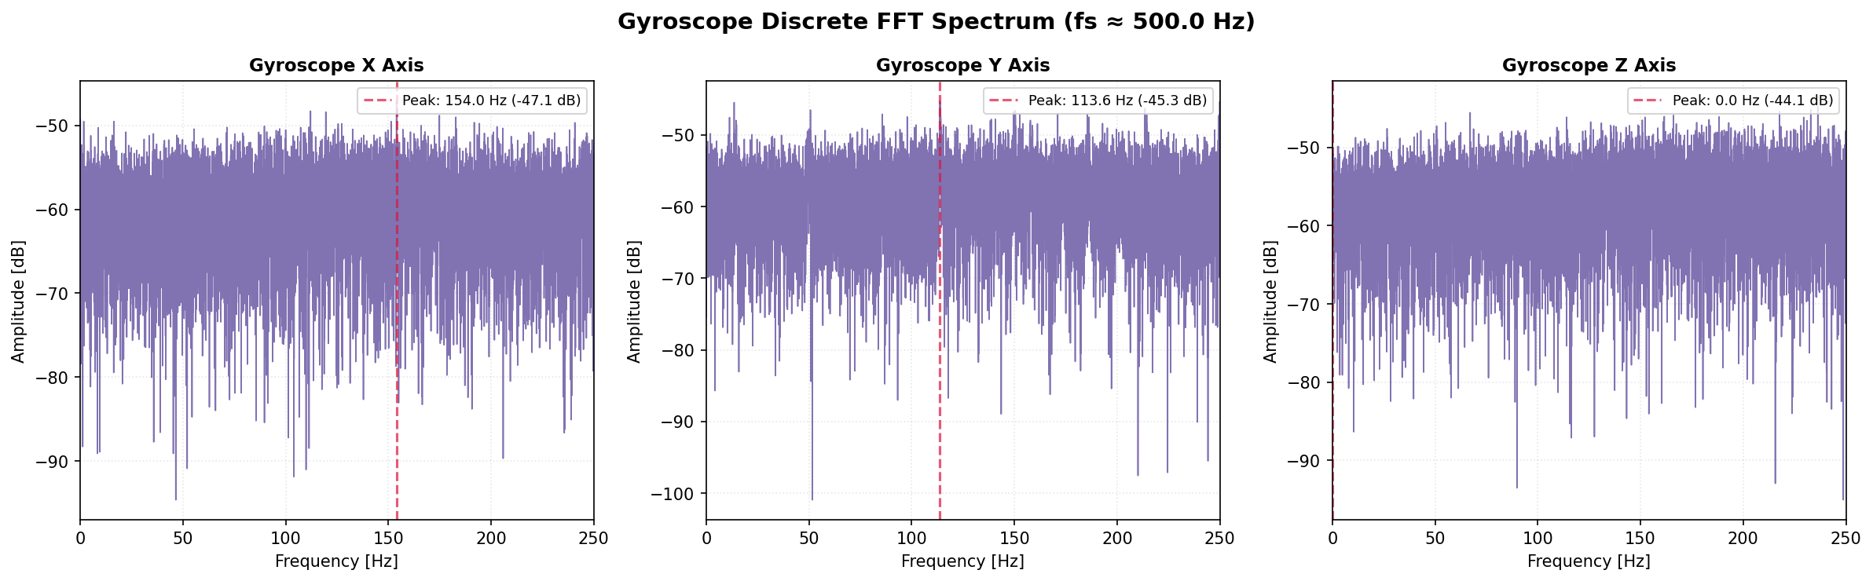
analyzers/img/0001-FFT-Gyro_raw.png
