pacman314159/OISP-Drone-Research/analyzers/img/0001-FFT-Mag_filt.png

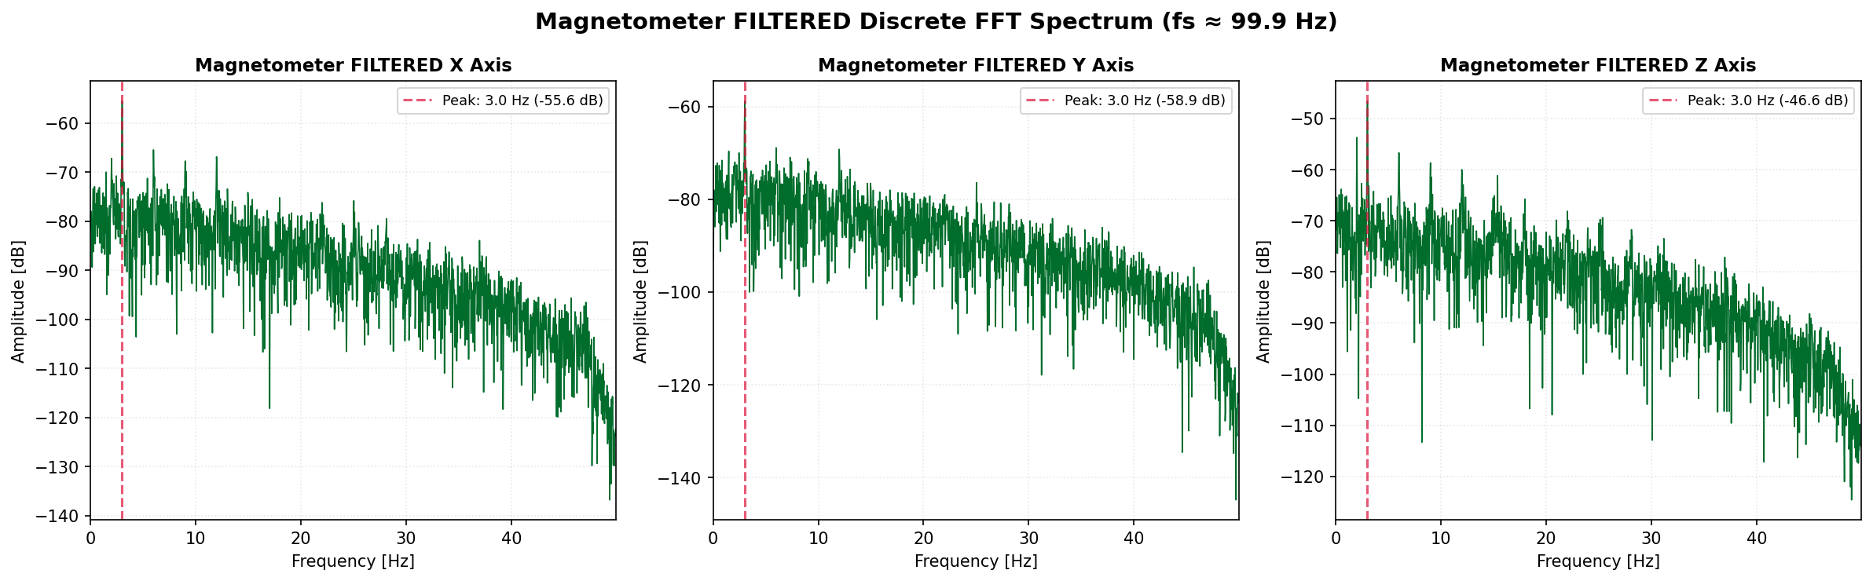
analyzers/img/0001-FFT-Mag_filt.png
