pacman314159/OISP-Drone-Research/analyzers/img/0001-HIST-Accel_raw.png

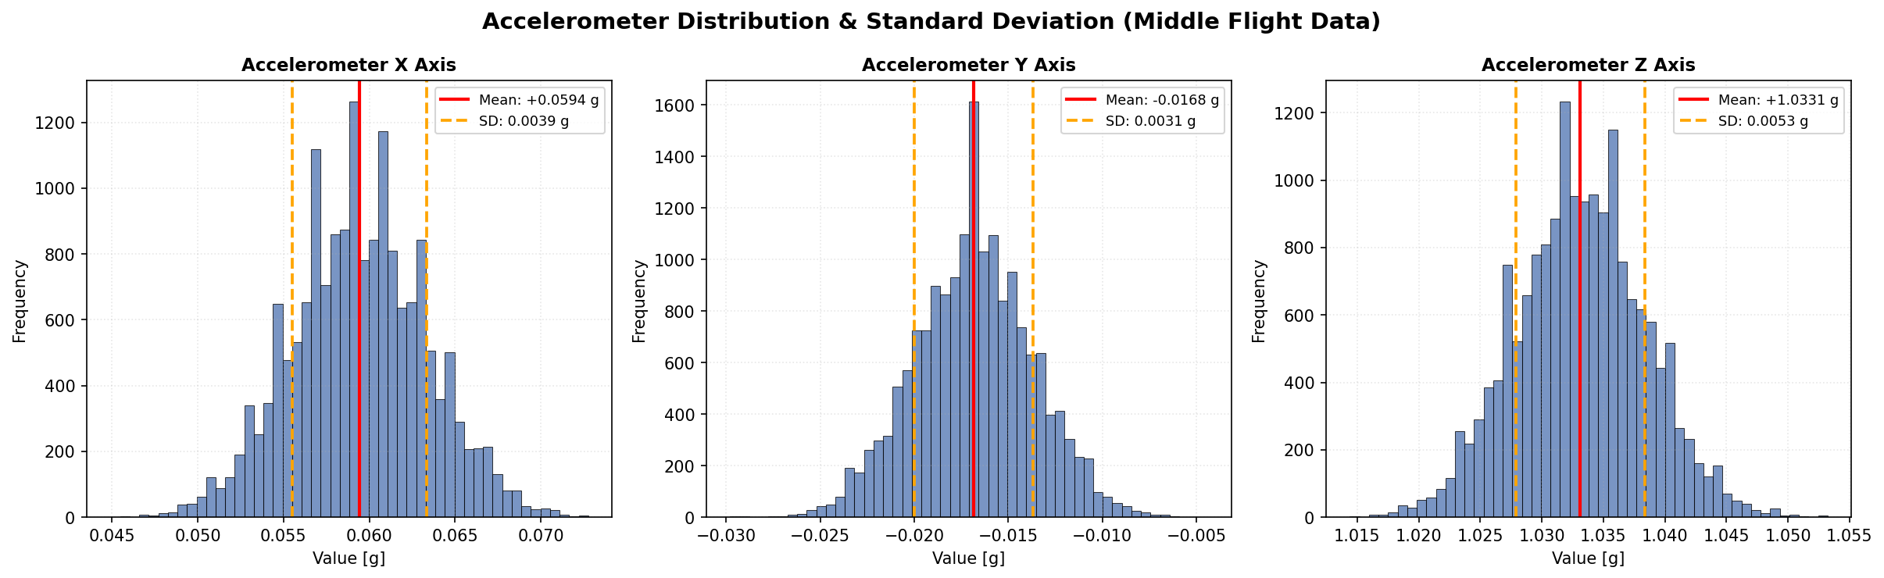
analyzers/img/0001-HIST-Accel_raw.png
