pacman314159/OISP-Drone-Research/analyzers/img/0001-HIST-Gyro_filt.png

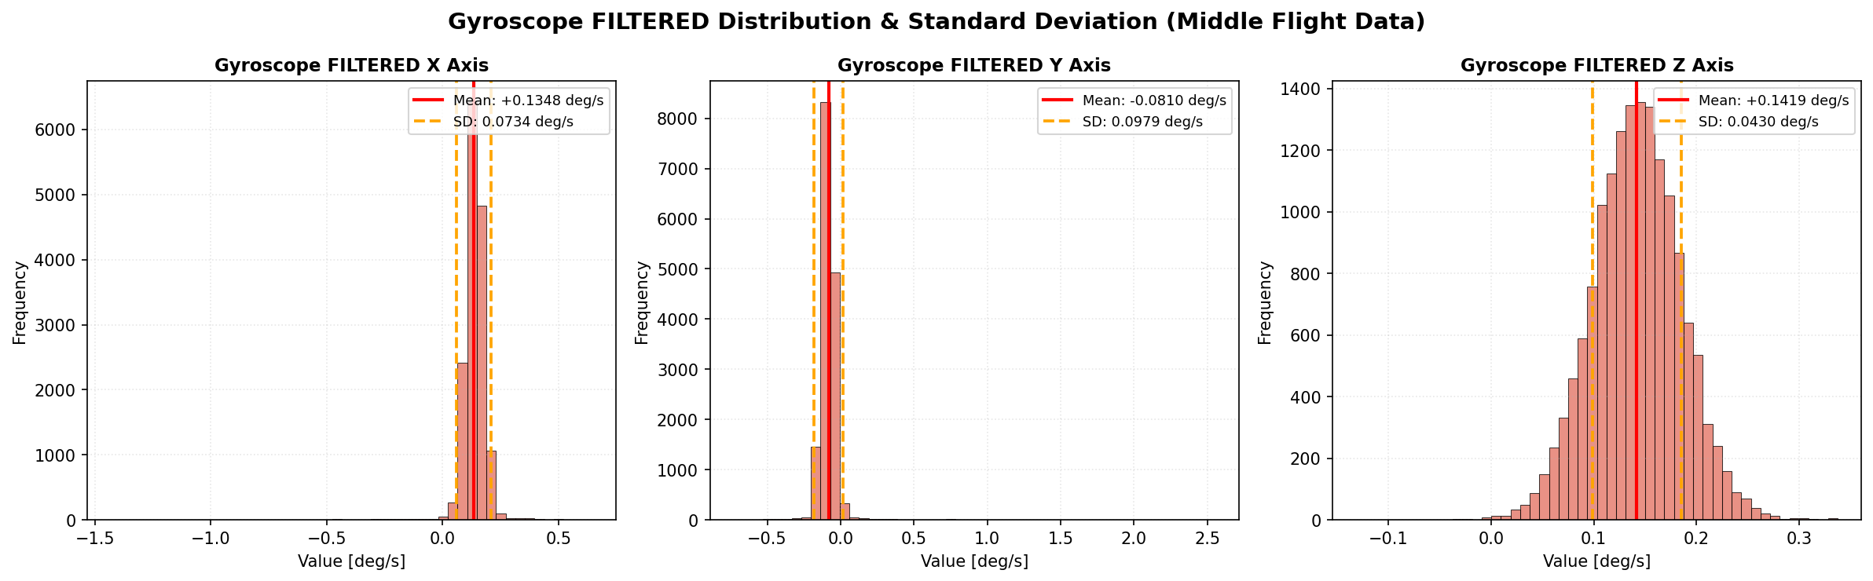
analyzers/img/0001-HIST-Gyro_filt.png
