pacman314159/OISP-Drone-Research/analyzers/img/0002-TIME-Accel_raw.png

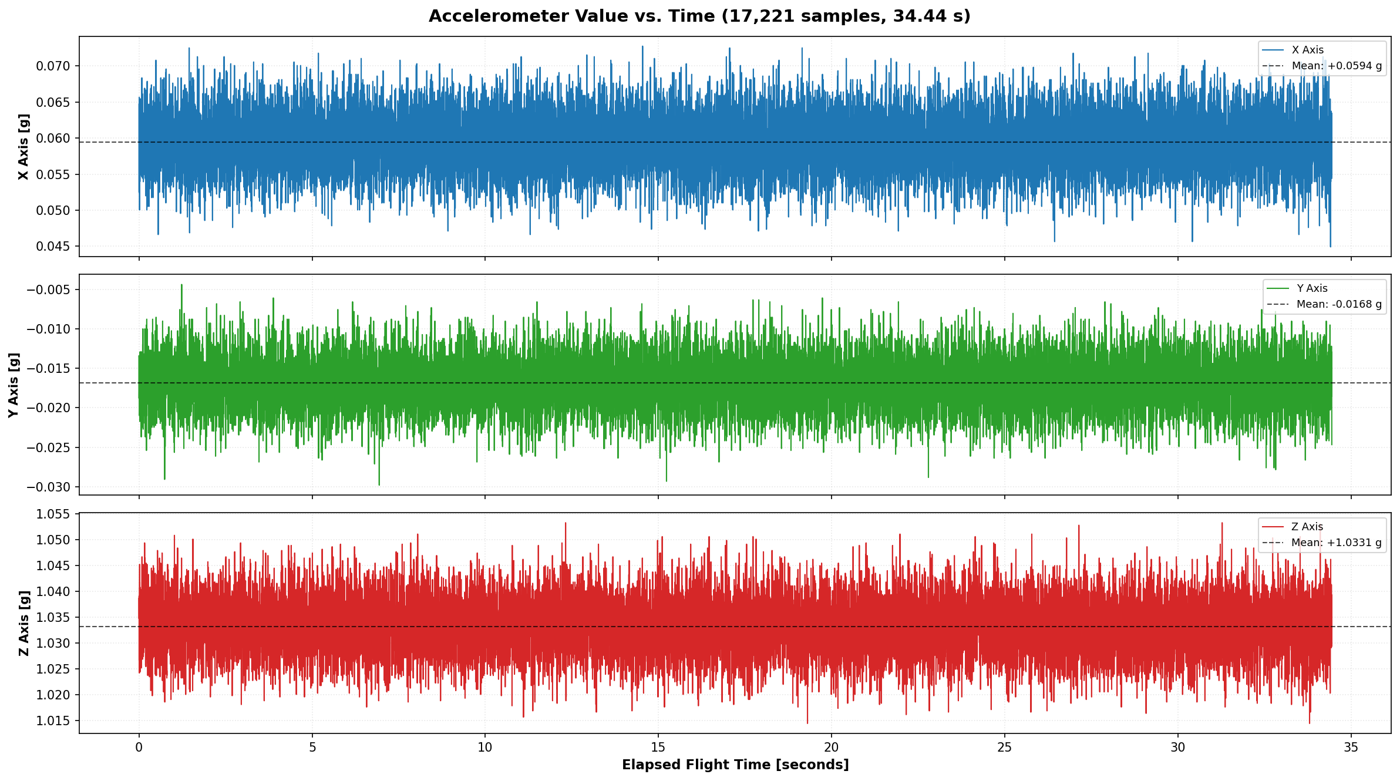
analyzers/img/0002-TIME-Accel_raw.png
