pacman314159/OISP-Drone-Research/analyzers/img/0002-TIME-Gyro_raw.png

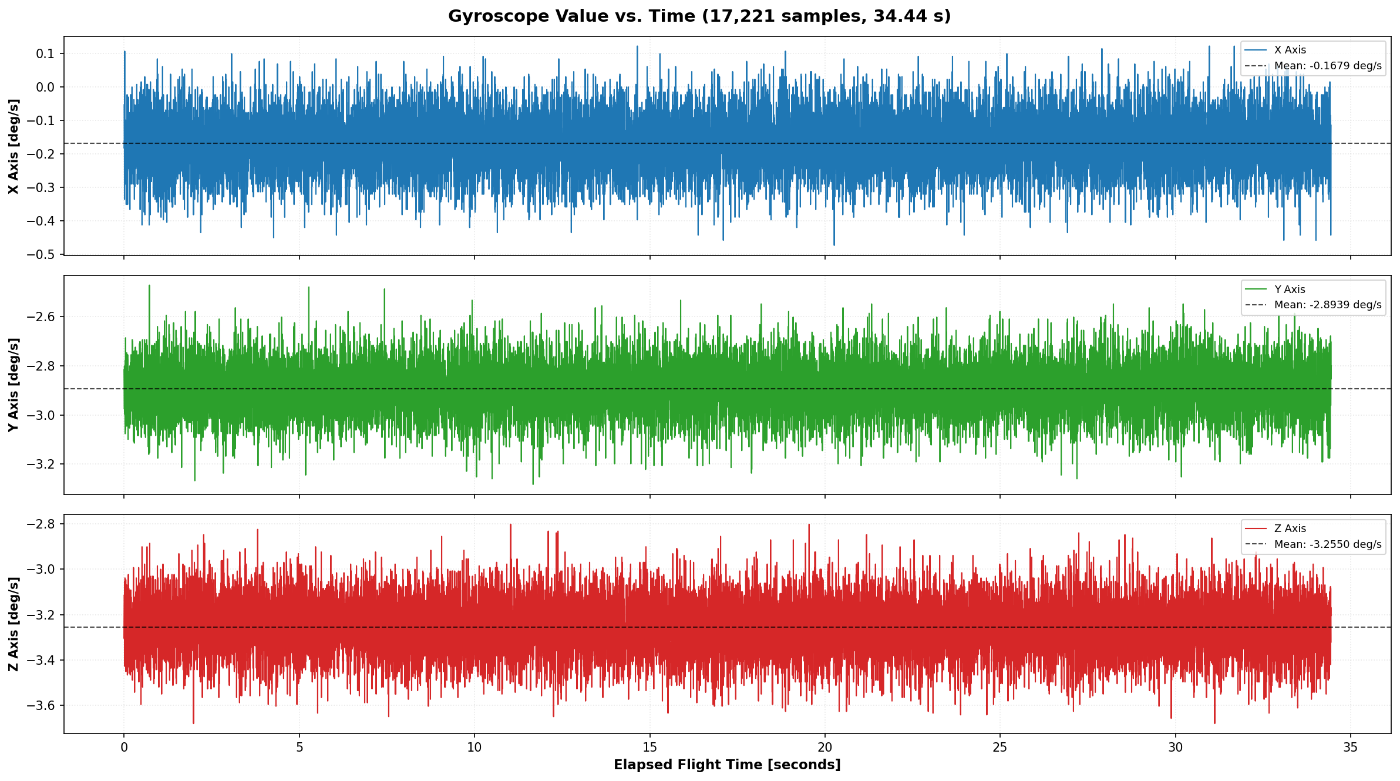
analyzers/img/0002-TIME-Gyro_raw.png
