pacman314159/OISP-Drone-Research/analyzers/img/0002-TIME-Mag_raw.png

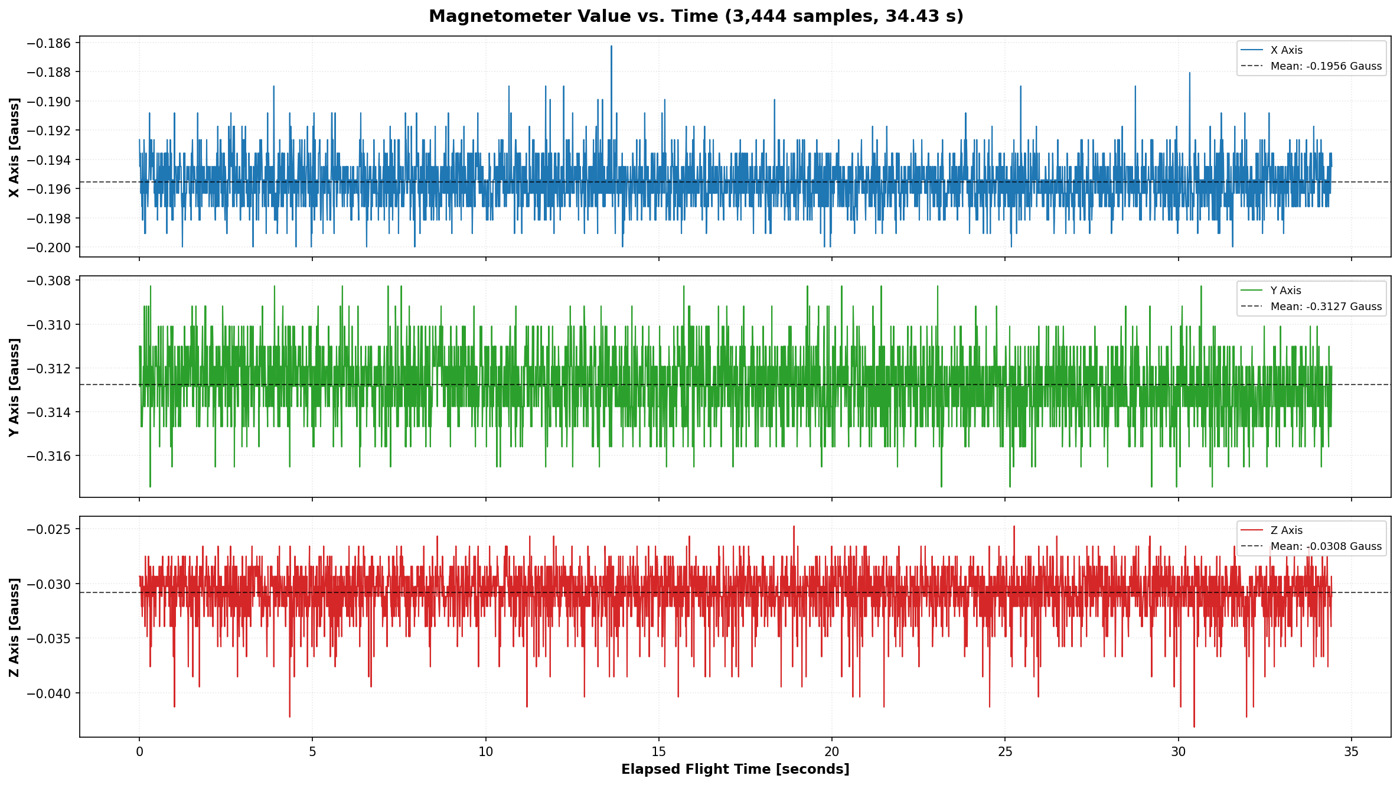
analyzers/img/0002-TIME-Mag_raw.png
