pacman314159/OISP-Drone-Research/analyzers/img/0003-TIME-Accel_raw.png

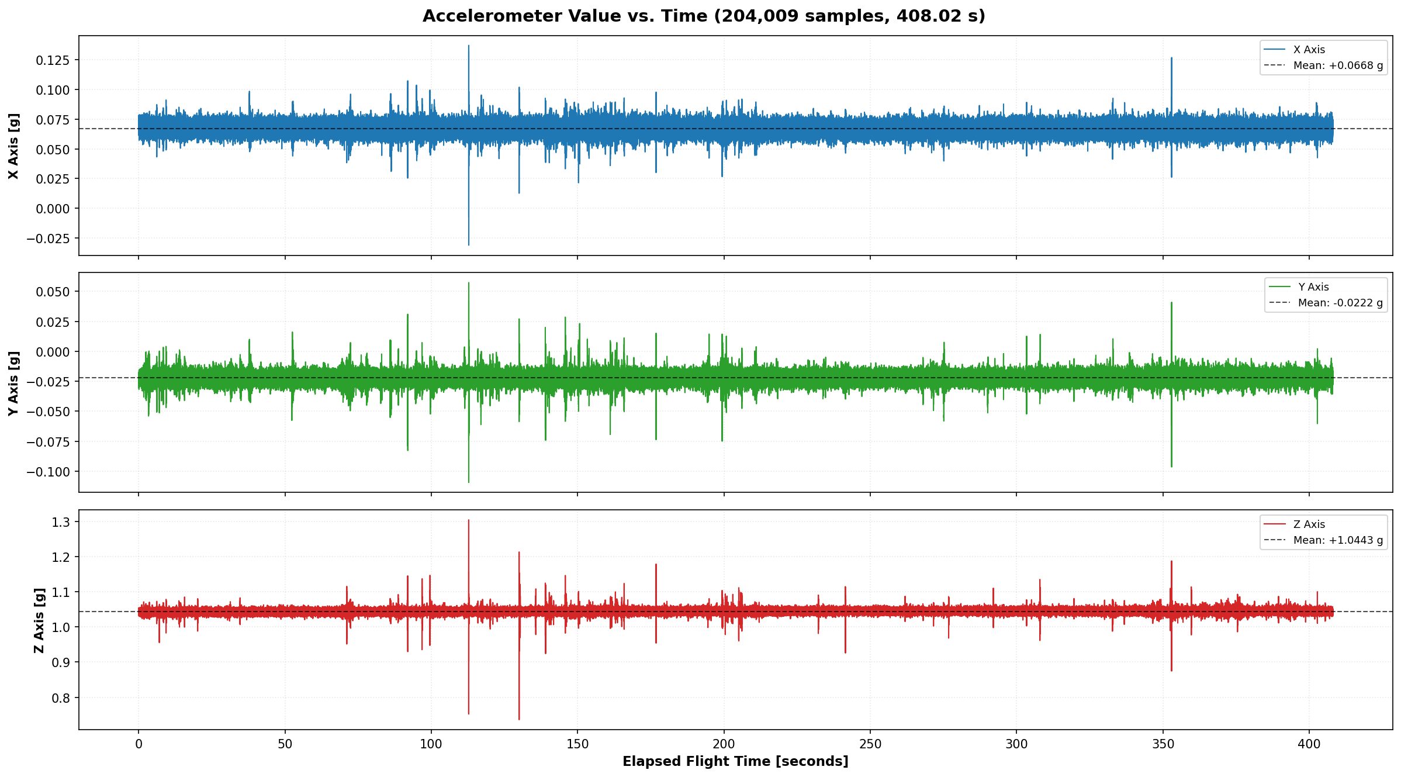
analyzers/img/0003-TIME-Accel_raw.png
