pacman314159/OISP-Drone-Research/analyzers/img/0005-TIME-Accel_raw.png

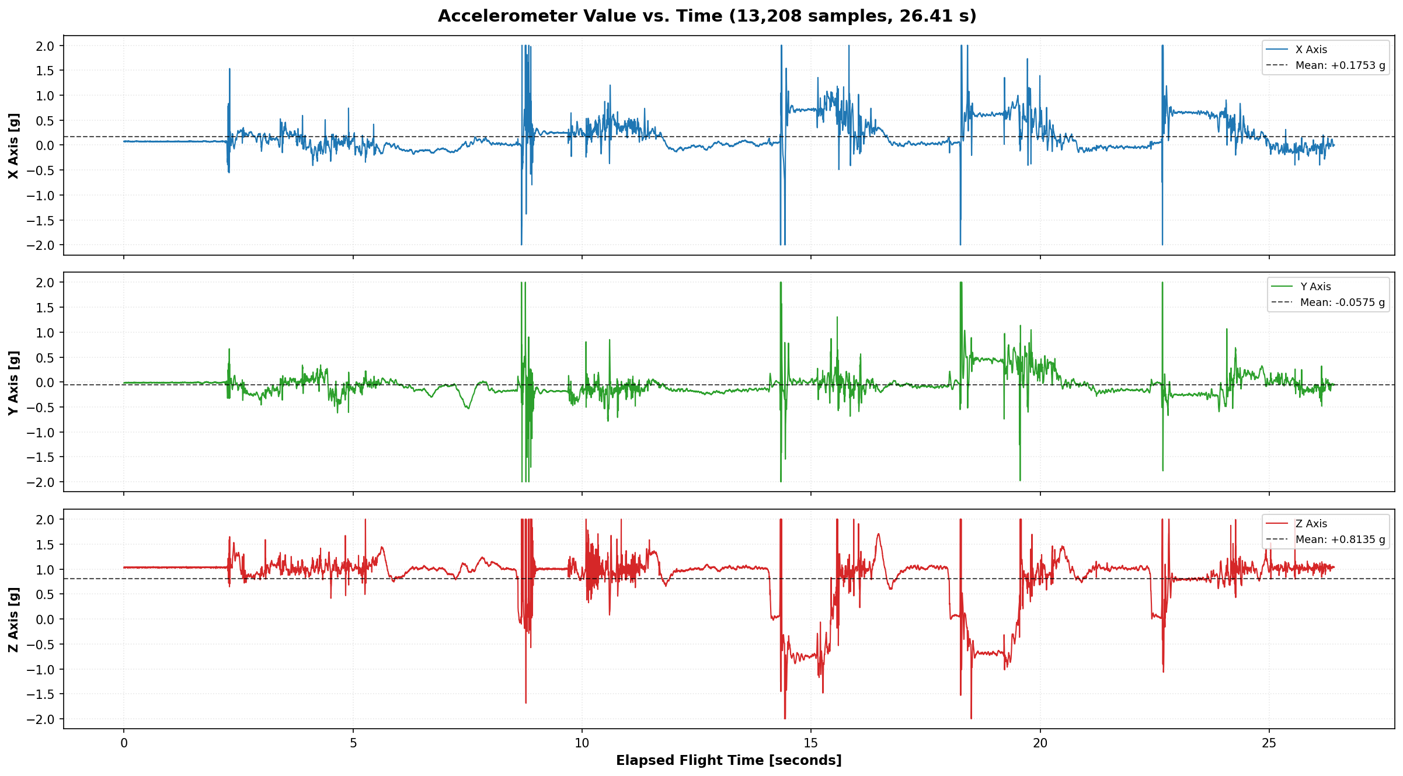
analyzers/img/0005-TIME-Accel_raw.png
