pacman314159/OISP-Drone-Research/analyzers/img/0008-PROJ-Mag_raw.png

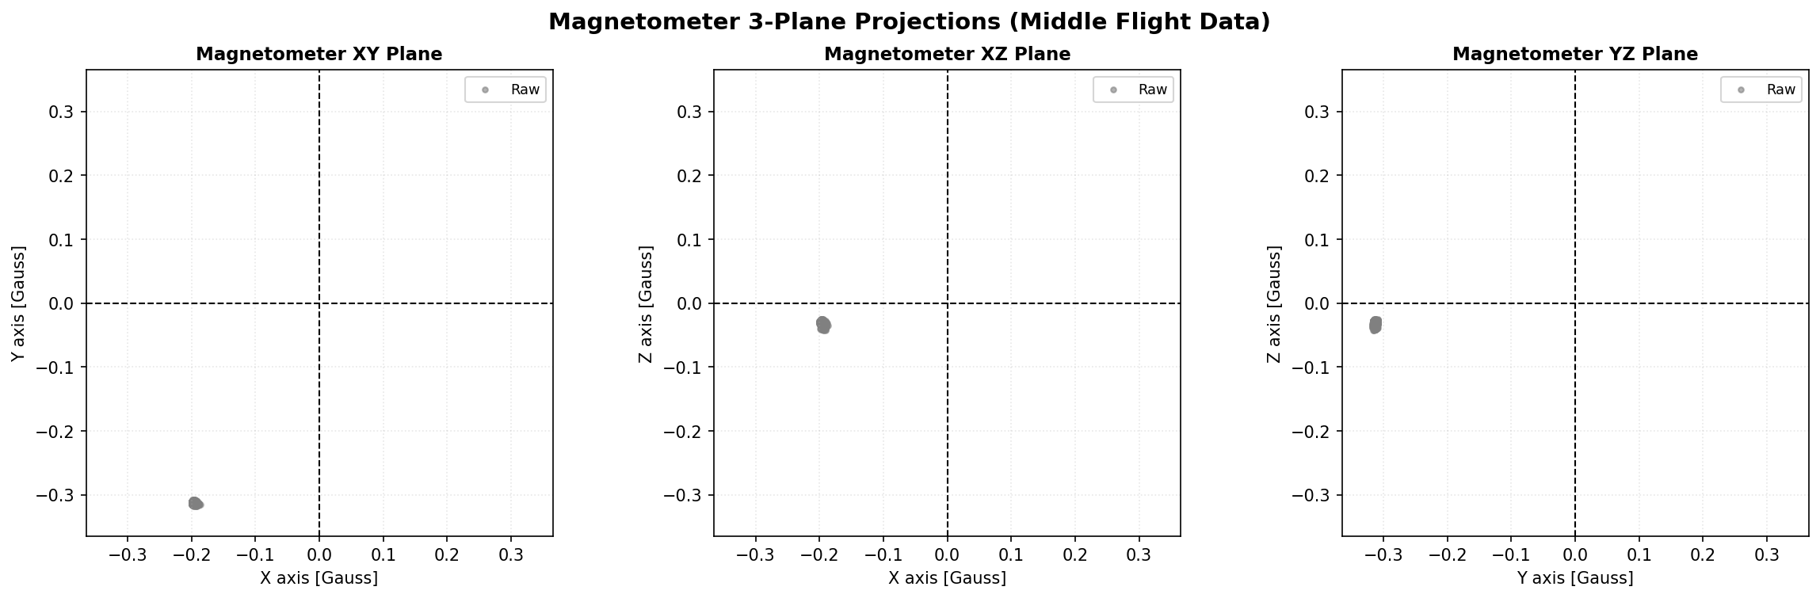
analyzers/img/0008-PROJ-Mag_raw.png
