pacman314159/OISP-Drone-Research/analyzers/img/0011-FFT-Mag_raw.png

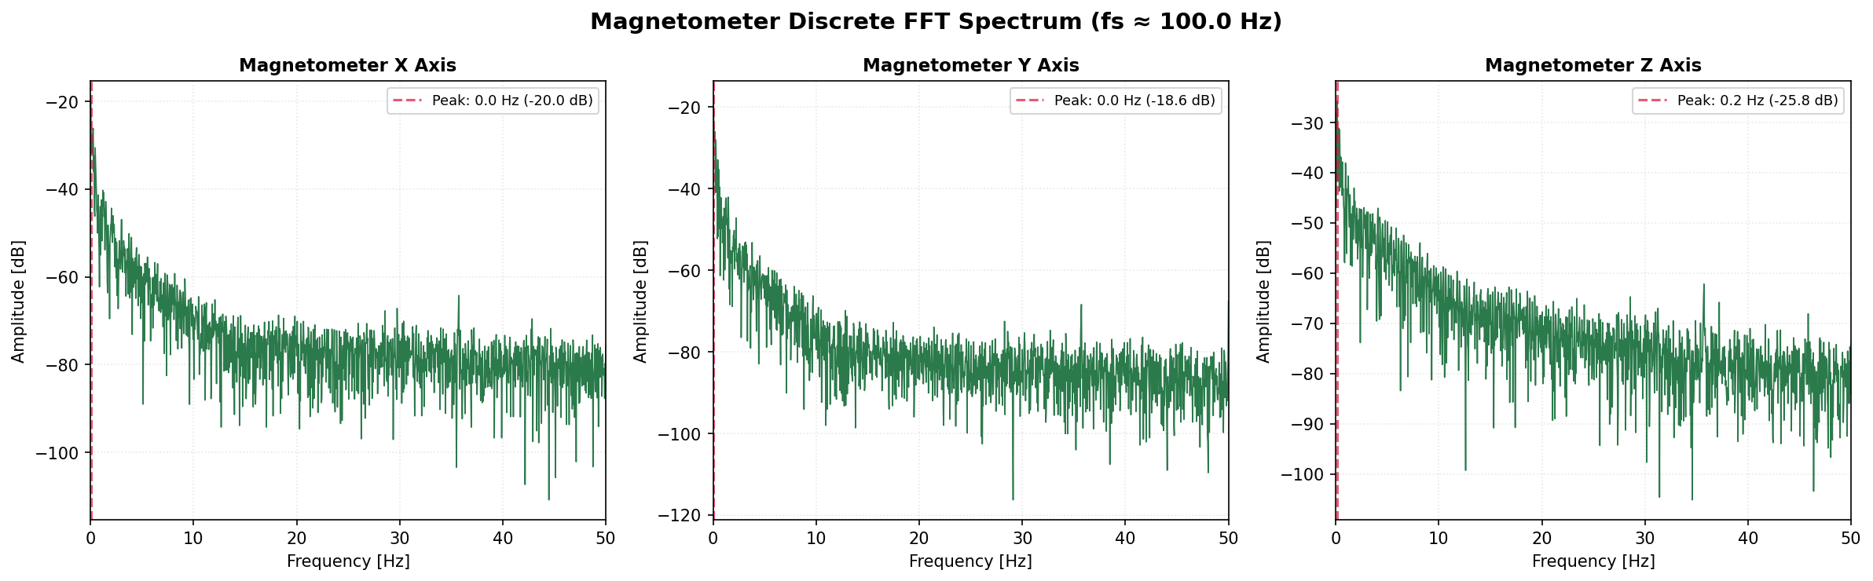
analyzers/img/0011-FFT-Mag_raw.png
