pacman314159/OISP-Drone-Research/analyzers/imu_dist.png

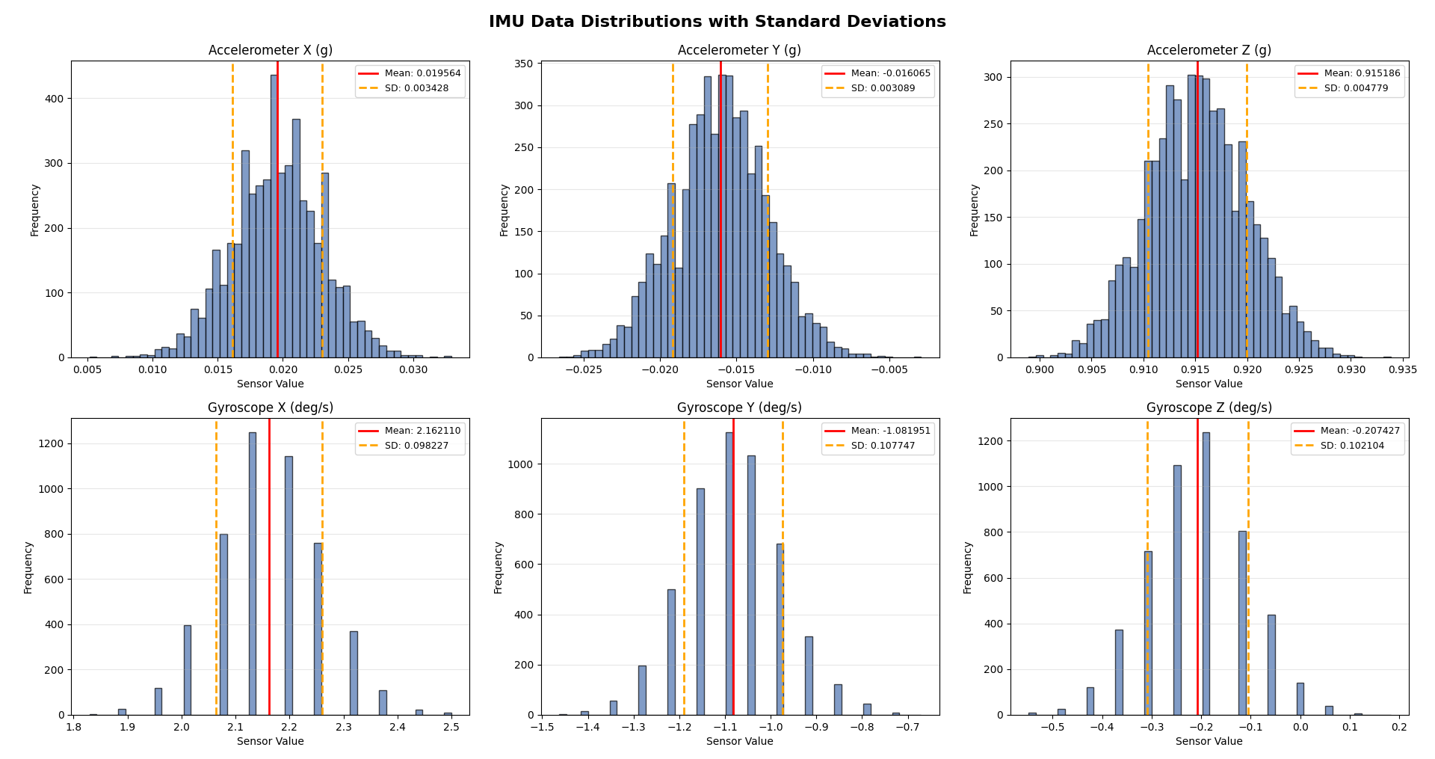
analyzers/imu_dist.png
