pacman314159/OISP-Drone-Research/analyzers/imu_fft_1.png

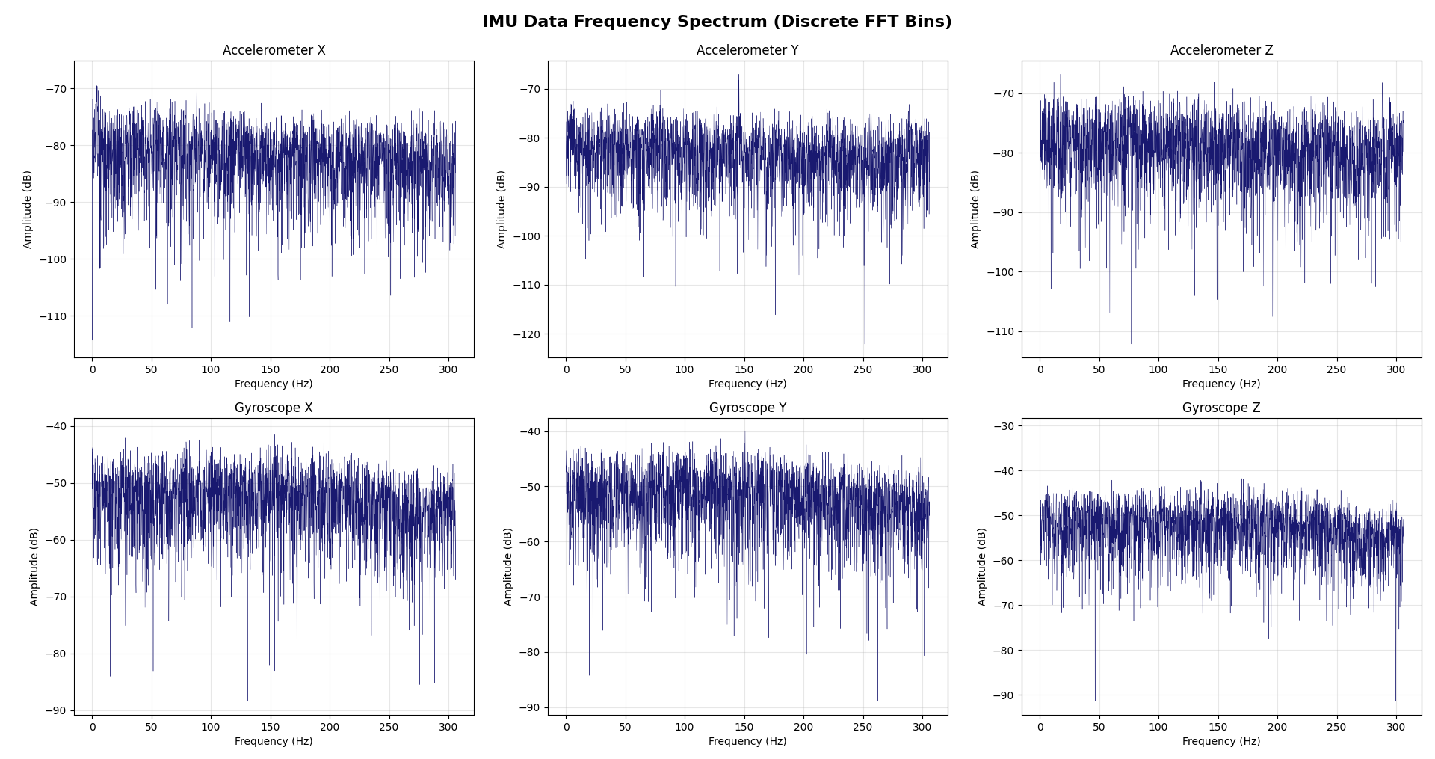
analyzers/imu_fft_1.png
