pacman314159/OISP-Drone-Research/analyzers/mag_dist.png

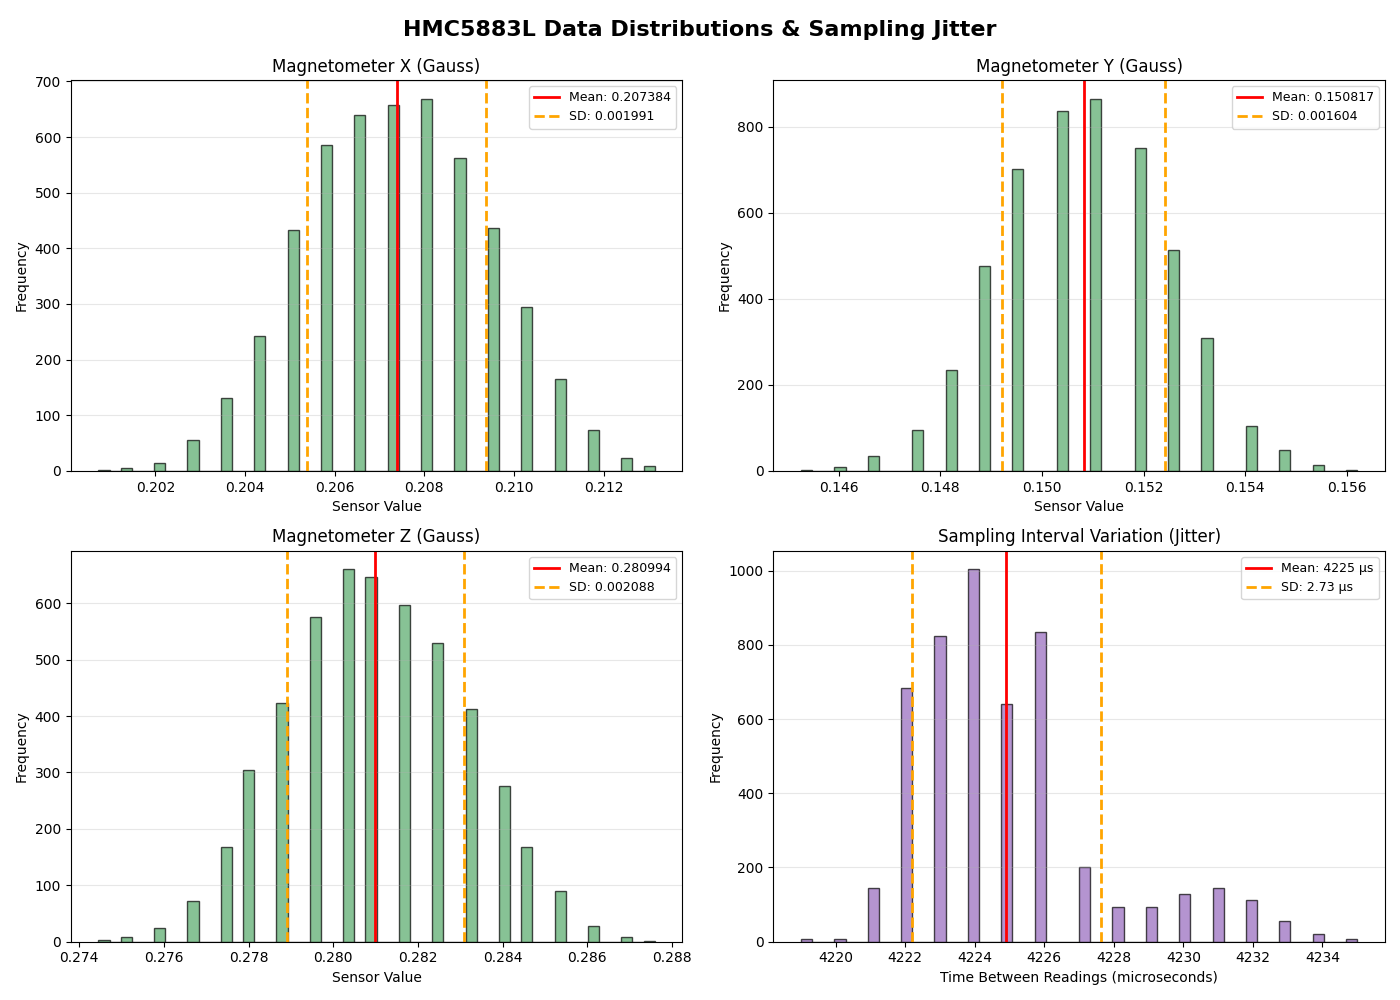
analyzers/mag_dist.png
