pacman314159/OISP-Drone-Research/analyzers/mag_fft.png

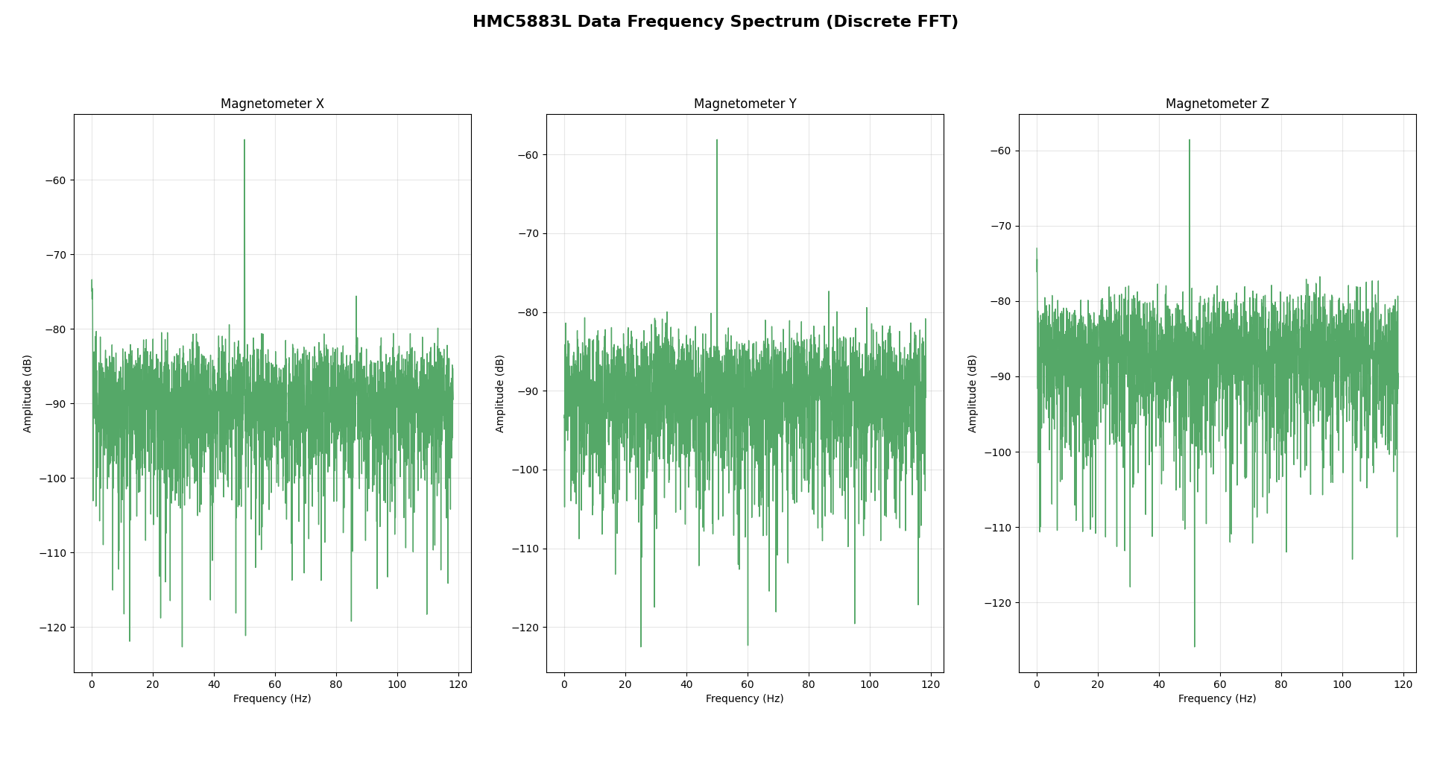
analyzers/mag_fft.png
