pacman314159/OISP-Drone-Research/analyzers/SysView data/sysview_analysis_plot.png

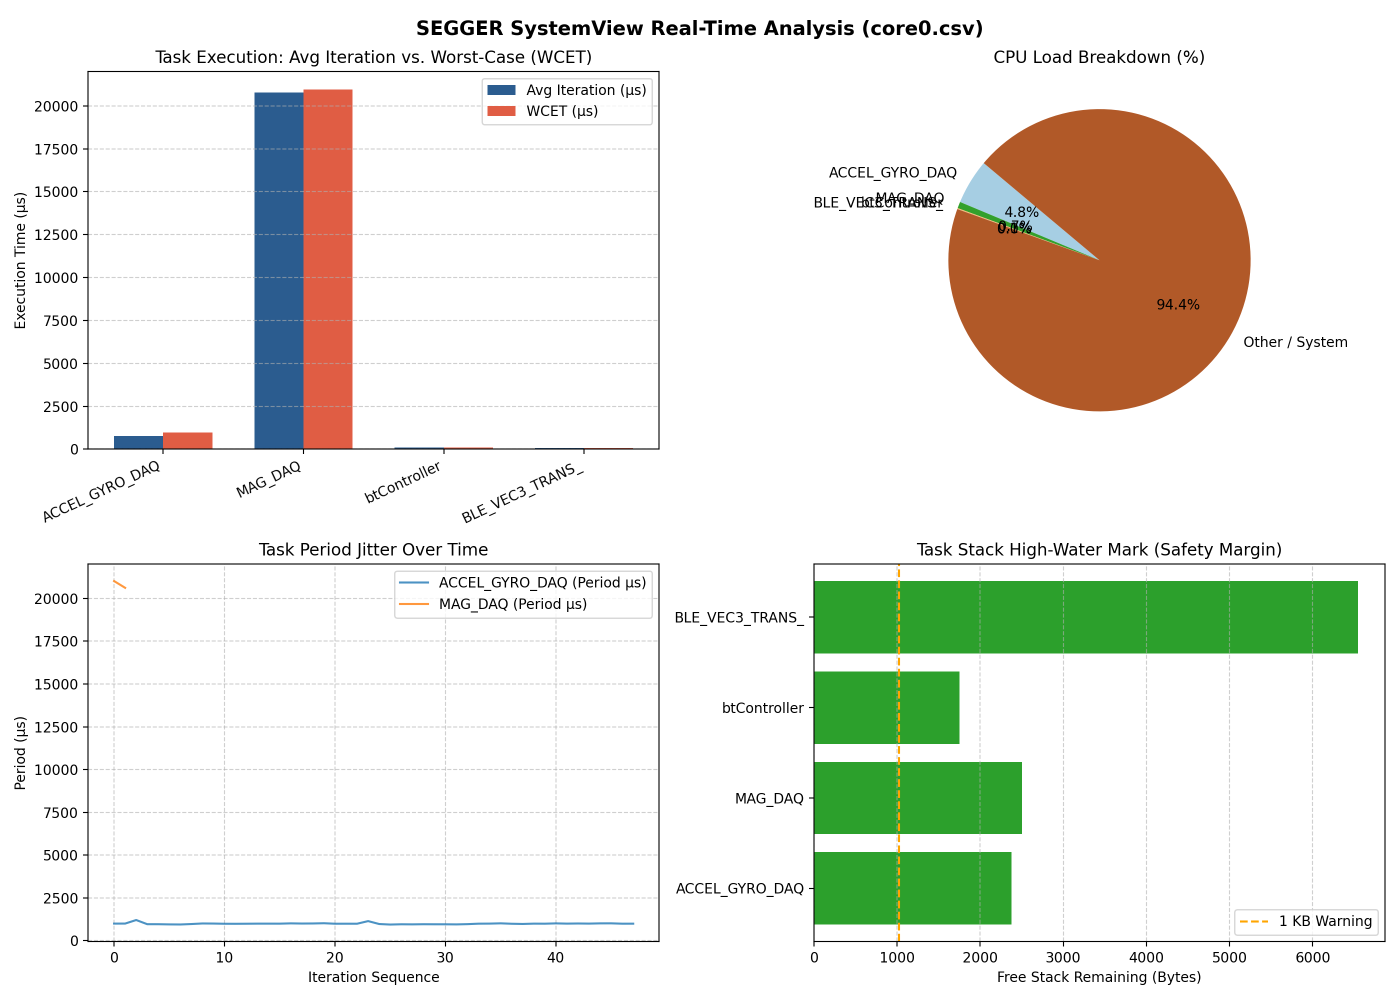
analyzers/SysView data/sysview_analysis_plot.png
