pacman314159/OISP-Drone-Research/analyzers/SysView data/sysview_dual_core_plot.png

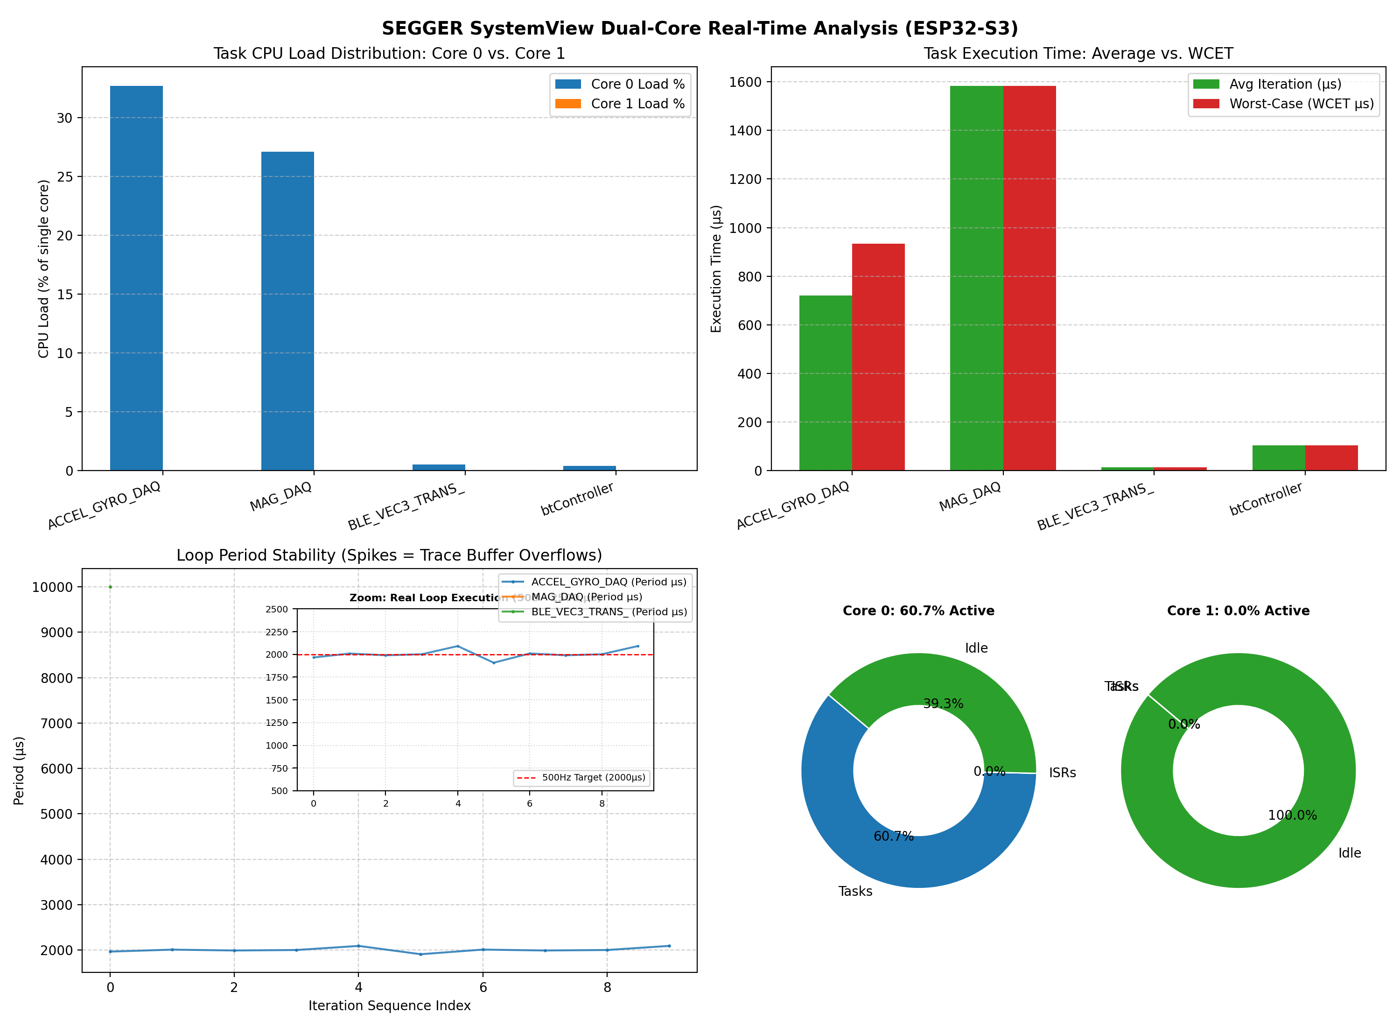
analyzers/SysView data/sysview_dual_core_plot.png
