pacman314159/OISP-Drone-Research/analyzers/SysView data/task_timing_histograms.png

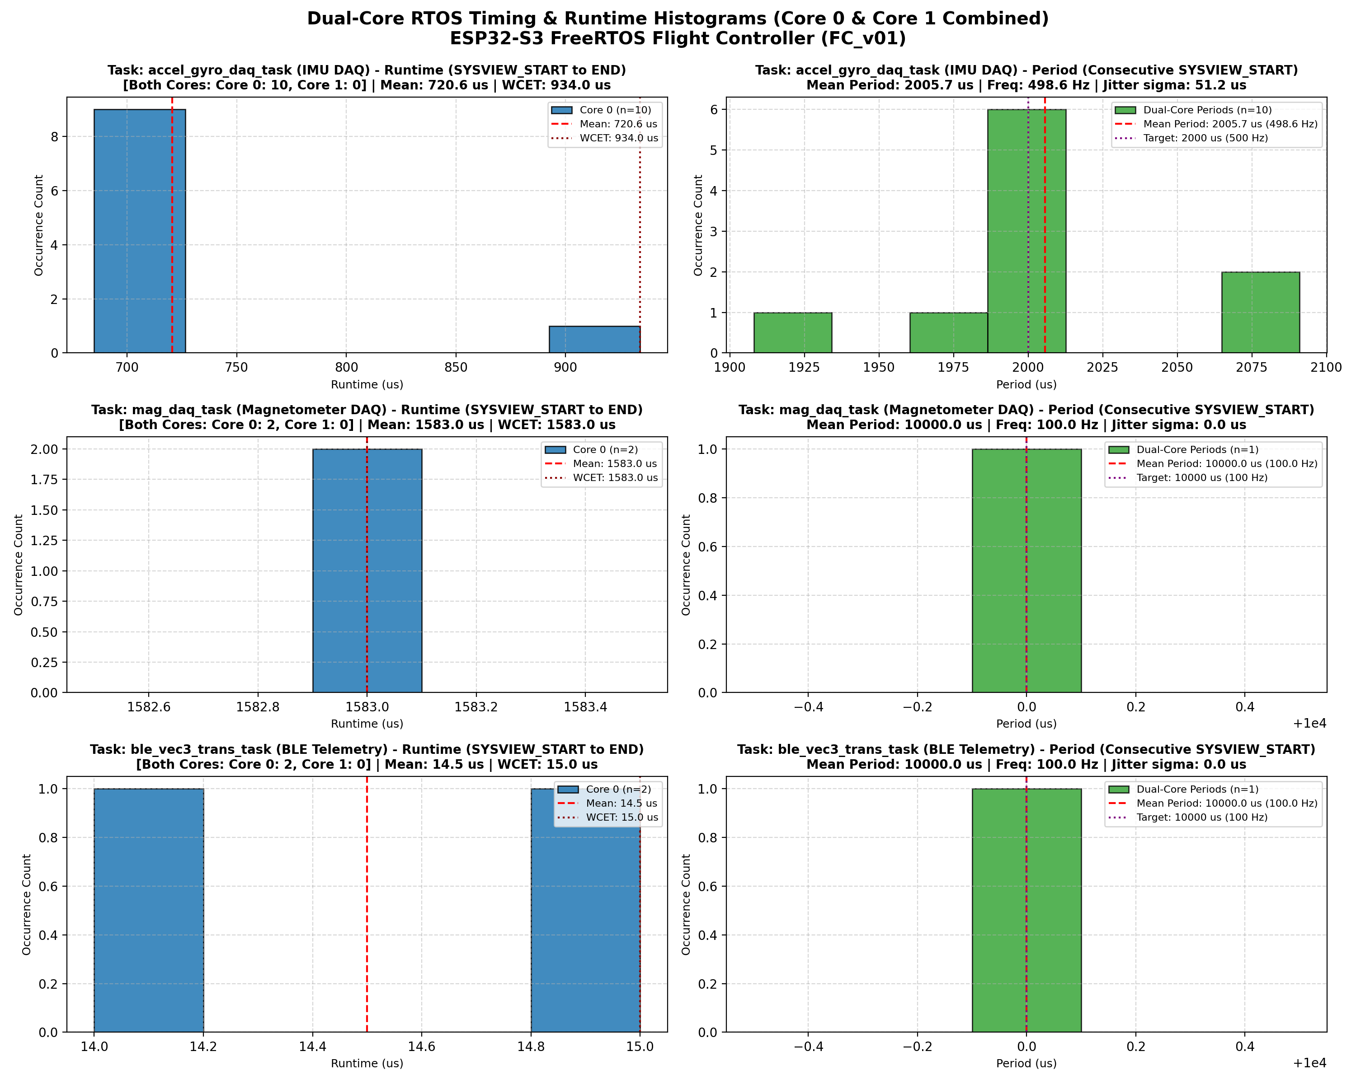
analyzers/SysView data/task_timing_histograms.png
