pacman314159/OISP-Drone-Research/datasheets/Adafruit_Esp32.webp

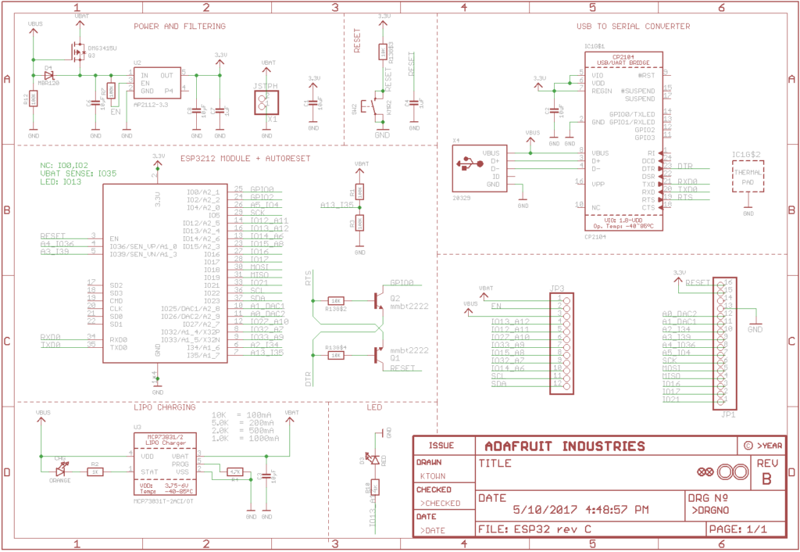
datasheets/Adafruit_Esp32.webp
