pacman314159/OISP-Drone-Research/datasheets/adafruit_products_LC709x_sch.png

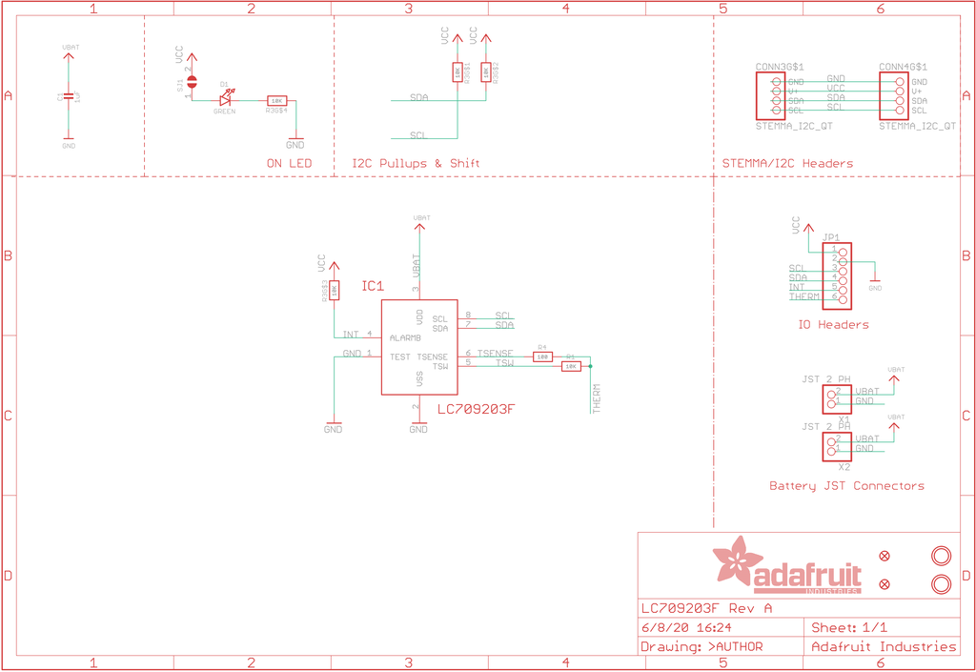
datasheets/adafruit_products_LC709x_sch.png
