pacman314159/OISP-Drone-Research/pcb/FC_v02/FC_v02.csv

Reference | Qty | Value | DNP | Exclude from BOM | Exclude from Board | Footprint | Datasheet | Supplier
Q1,Q2 | 2 | SS8050 |  |  |  | Package_TO_SOT_SMD:SOT-23 | https://ngspice.sourceforge.io/docs/ngspice-html-manual/manual.xhtml#cha_BJTs | https://www.thegioiic.com/ss8050-y1-transistor-npn-25v-1-5a-3-chan-sot-23
Q3 | 1 | Si2301 |  |  |  | Package_TO_SOT_SMD:SOT-23 | https://ngspice.sourceforge.io/docs/ngspice-html-manual/manual.xhtml#cha_MOSFETs | https://www.thegioiic.com/si2301ds-mosfet-kenh-p-20v-2-3a-sot-23-3
U4 | 1 | DW01A |  |  |  | Package_TO_SOT_SMD:SOT-23-6 | https://hmsemi.com/downfile/DW01A.PDF | https://www.thegioiic.com/dw01a-ic-bao-ve-pin-1-cell-sot-23-6
U6 | 1 | AP2112K-3.3 |  |  |  | Package_TO_SOT_SMD:SOT-23-5 | https://www.diodes.com/assets/Datasheets/AP2112.pdf | https://shopee.vn/Set-10-Linh-Ki%E1%BB%87n-%C4%90i%E1%BB%87n-T%E1%BB%AD-AP2112K-3.3-SOT23-5-AP2112K-3.3TRG1-3.3V-0.6A-SOT25-2112-AP2112-AP2113K-AP2112-3.3-AP2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
U1 | 1 | USBLC6-2SC6 |  |  |  | Package_TO_SOT_SMD:SOT-23-6 | https://www.st.com/resource/en/datasheet/usblc6-2.pdf | https://icdayroi.com/usblc6-2sc6-tvs-diode-5-25v-17v-sot23-6
D2,D3 | 2 | 1N5819 |  |  |  | Diode_SMD:D_SOD-123 |  | https://icdayroi.com/diode-1n5819-sod123-size-1206
U9 | 1 | esp32s3_wroom1 |  |  |  | RF_Module:ESP32-S3-WROOM-1 |  | https://hshop.vn/mach-thu-phat-wifi-ble-soc-esp32-s3-esp32-s3-wroom-1-chinh-hang-espressif
J14 | 1 | Micro_SD_Card_Det1 |  |  |  | Local Footprints:Micro_SD_Card_Socket | https://datasheet.lcsc.com/lcsc/2110151630_XKB-Connectivity-XKTF-015-N_C381082.pdf | https://chipn24.com/socket-the-nho-microsd-v1-co-lo-xo-id1466.html
U7 | 1 | ME6211C33M5 |  |  |  | Package_TO_SOT_SMD:SOT-23-5 | https://www.lcsc.com/datasheet/lcsc_datasheet_2304140030_MICRONE-Nanjing-Micro-One-Elec-ME6211C33R5G_C235316.pdf | https://chipn24.com/ic-dan-me6211-sot23-5-smd-me6211c33m5g-n-6211-s2rc-s2si-3-3v-500ma-id4966.html
U5 | 1 | 8205 |  |  |  | Package_TO_SOT_SMD:TSOT-23-6 |  | https://chipn24.com/ic-dan-8205s-sot-23-6-smd-fs8205-8205-id2095.html
J1 | 1 | USB_C_Receptacle_USB2.0_16P |  |  |  | Connector_USB:USB_C_Receptacle_GCT_USB4105-xx-A_16P_TopMnt_Horizontal | https://www.usb.org/sites/default/files/documents/usb_type-c.zip | https://chipn24.com/dau-usb-type-c-v1-16p-usb-3-1-truyen-tai-hd-16p-han-board-co-4-chan-dau-jack-usb-han-board-id6292.html
R6 | 1 | 47K5 |  |  |  | Resistor_SMD:R_0603_1608Metric |  | https://chipn24.com/50-con-dien-tro-dan-smd-0402-47k-1-id10754.html
R5 | 1 | 22K1 |  |  |  | Resistor_SMD:R_0603_1608Metric |  | https://chipn24.com/50-con-dien-tro-dan-smd-0402-22k-1-id10746.html
D1 | 1 | BAT54C |  |  |  | Package_TO_SOT_SMD:SOT-23 | http://www.diodes.com/_files/datasheets/ds11005.pdf | https://chipn24.com/25-con-diode-schottky-dan-bat54c-kl3-sot-23-200ma-30v-id7944.html
SW3 | 1 | RST |  |  |  | Local Footprints:SW_Push_3x4x2.5mm |  | https://chipn24.com/10-cai-nut-nhan-2-chan-3x6x2-5mm-smd-dan-trang-id5582.html
SW2 | 1 | USER |  |  |  | Local Footprints:SW_Push_3x4x2.5mm |  | https://chipn24.com/10-cai-nut-nhan-2-chan-3x6x2-5mm-smd-dan-trang-id5582.html
SW1 | 1 | BOOT |  |  |  | Local Footprints:SW_Push_3x4x2.5mm |  | https://chipn24.com/10-cai-nut-nhan-2-chan-3x6x2-5mm-smd-dan-trang-id5582.html
U8 | 1 | Ai-Thinker-Ra-02 |  |  |  | RF_Module:Ai-Thinker-Ra-01-LoRa | http://wiki.ai-thinker.com/_media/lora/docs/c048ps01a1_ra-02_product_specification_v1.1.pdf
U3 | 1 | GY-87 |  |  |  | Local Footprints:GY-87
U2 | 1 | CP2102 |  |  |  | Package_DFN_QFN:QFN-28-1EP_5x5mm_P0.5mm_EP3.25x3.25mm_ThermalVias
R25,R26 | 2 | 0R |  |  |  | Resistor_SMD:R_0603_1608Metric
R16,R18,R19,R24 | 4 | 22R |  |  |  | Resistor_SMD:R_0603_1608Metric
R15 | 1 | 1K |  |  |  | Resistor_SMD:R_0603_1608Metric
R14 | 1 | 330R |  |  |  | Resistor_SMD:R_0603_1608Metric
R13 | 1 | 100R |  |  |  | Resistor_SMD:R_0603_1608Metric
R3,R4,R7 | 3 | 5K1 |  |  |  | Resistor_SMD:R_0603_1608Metric
R1,R2,R8,R9,R10,R11,R12,R17,R20,R21,R22,R23,R27,R28,R29 | 15 | 10K |  |  |  | Resistor_SMD:R_0603_1608Metric
J13 | 1 | JST1.25 |  |  |  | Local Footprints:JST_1.25mm_RA_SMD_2P
J9,J10,J11 | 3 | 2.54mm |  |  |  | Local Footprints:_PinSocket_1x07_P2.54mm_Vertical
J8 | 1 | JST1.25 |  |  |  | Local Footprints:JST_1.25mm_RA_SMD_8P
J6,J12 | 2 | JST1.25 |  |  |  | Local Footprints:JST_1.25mm_RA_SMD_4P
J2,J3,J4,J5 | 4 | JST1.25 |  |  |  | Local Footprints:JST_1.25mm_RA_SMD_3P
D5 | 1 | WS2812B-2020 |  |  |  | LED_SMD:LED_WS2812B-2020_PLCC4_2.0x2.0mm | https://cdn-shop.adafruit.com/product-files/4684/4684_WS2812B-2020_V1.3_EN.pdf
D4 | 1 | Red |  |  |  | LED_SMD:LED_0805_2012Metric
C17 | 1 | 1u |  |  |  | Capacitor_SMD:C_0603_1608Metric
C15 | 1 | 100u |  |  |  | Capacitor_Tantalum_SMD:CP_EIA-3216-10_Kemet-I
C13 | 1 | 22u |  |  |  | Capacitor_SMD:C_0805_2012Metric
C7,C8 | 2 | 22u |  |  |  | Capacitor_Tantalum_SMD:CP_EIA-3216-10_Kemet-I
C4,C9,C10 | 3 | 10u |  |  |  | Capacitor_SMD:C_0805_2012Metric
C1,C2,C5,C6,C11,C12,C14,C16,C18,C19,C20,C21 | 12 | 0.1u |  |  |  | Capacitor_SMD:C_0603_1608Metric
