pacman314159/OISP-Drone-Research/3d_models/Full_body/SYS-ASM-0000-Main.stp

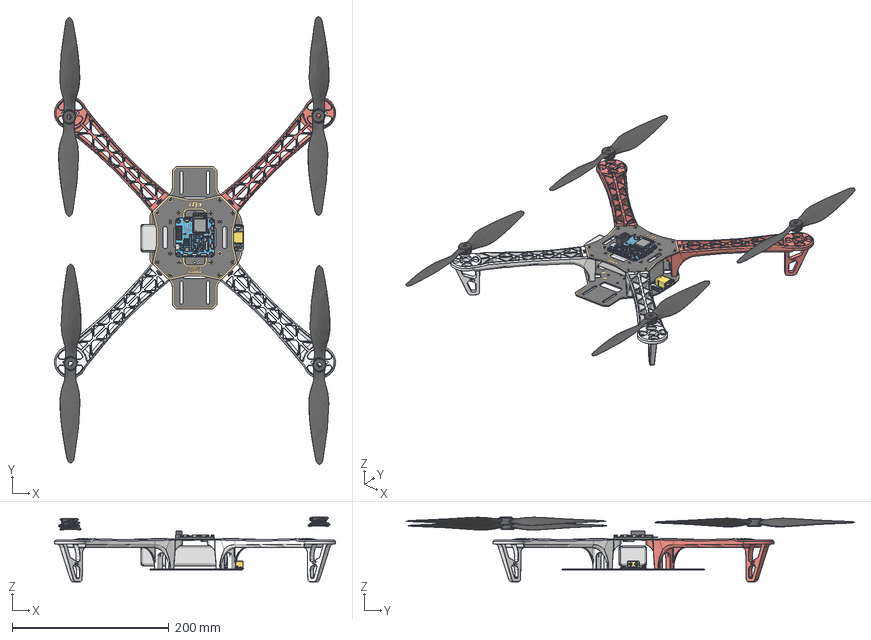
[picture p85: CAD file, 2026-10-13]
3d_models/Full_body/SYS-ASM-0000-Main.stp
358.5 x 571.7 x 82.5 mm
AVI-PRT-5001-Propeller_10x45 x 4
FlameWheel_F450_Base_Top
FlameWheel_F450_Base_Bottom
FlameWheel_F450_Arm_Red x 2
R_0402_1005Metric x 6
C_0402_1005Metric x 3
TSSOP-10_3x3mm_P0.5mm
R_2512_6332Metric x 2
D_SMA
XT60PW-M
Molex_PicoBlade_53261-0471_1x04-1MP_P1.25mm_Horizontal
Power_Monitor_pad
Power_Monitor_silkscreen
Power_Monitor_soldermask
Power_Monitor_soldermask_1
Power_Monitor_PCB
Lipo 3S Battery
Molex_PicoBlade_53261-0371_1x03-1MP_P1.25mm_Horizontal x 4
PinSocket_1x07_P2.54mm_Vertical x 3
WS2812B-2020
R_0603_1608Metric_1 x 29
SW_Push_1P1T_NO_CK_KMR2 x 3
C_0603_1608Metric x 6
QFN-24-1EP_4x4mm_P0.5mm_EP2.7x2.7mm
SOT-23-5
SOT-23 x 2
LED_0603_1608Metric
BMP180
QFN-16-1EP_3x3mm_P0.5mm_EP1.7x1.7mm
CP_EIA-1608-10_AVX-L
R_0603_1608Metric x 6
C_0805_2012Metric x 4
GY87_10DOF_IMU_pad
GY87_10DOF_IMU_silkscreen
GY87_10DOF_IMU_soldermask
GY87_10DOF_IMU_PCB
Molex_PicoBlade_53261-0471_1x04-1MP_P1.25mm_Horizontal_1 x 2
C_0603_1608Metric_1 x 13
ESP32-S3-WROOM-1
LED_0805_2012Metric
Molex_PicoBlade_53261-0771_1x07-1MP_P1.25mm_Horizontal
Molex_PicoBlade_53261-0271_1x02-1MP_P1.25mm_Horizontal
SOT-23-6 x 2
USB_C_Receptacle_GCT_USB4105-xx-A_16P_TopMnt_Horizontal
SOT-23_1 x 4
C_0805_2012Metric_1 x 4
Case^MicroSD_Socket
Insert^MicroSD_Socket
Brace^MicroSD_Socket
Spring^MicroSD_Socket
Lid^MicroSD_Socket
Pin_Middle^MicroSD_Socket x 5
Pin_Short^MicroSD_Socket
Pin_Long^MicroSD_Socket x 2
MicroSD_Card^MicroSD_Socket
Pin_CardIn^MicroSD_Socket
Ra-02 LoRa
SOT-23-5_1 x 2
D_SOD-123 x 2
CP_EIA-3216-10_Kemet-I x 3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
