pacman314159/OISP-Drone-Research/pcb/FC_v02/local_3dmodels/GY87_10DOF_IMU_NoPin.stp

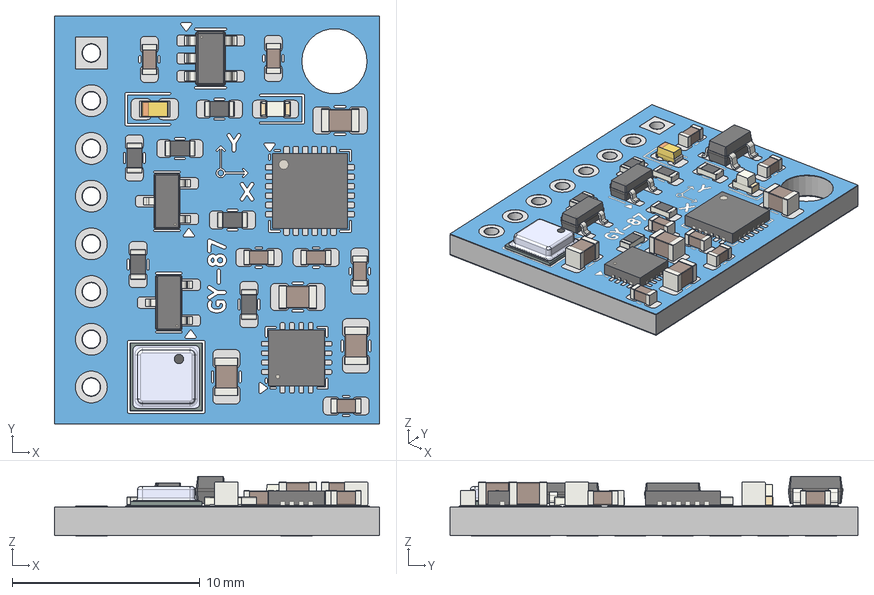
[picture p86: CAD file, 2026-07-18]
pcb/FC_v02/local_3dmodels/GY87_10DOF_IMU_NoPin.stp
17.3 x 21.7 x 3.22 mm
C_0603_1608Metric x 6
QFN-24-1EP_4x4mm_P0.5mm_EP2.7x2.7mm
SOT-23-5
SOT-23 x 2
LED_0603_1608Metric
BMP180
QFN-16-1EP_3x3mm_P0.5mm_EP1.7x1.7mm
CP_EIA-1608-10_AVX-L
R_0603_1608Metric x 6
C_0805_2012Metric x 4
GY87_10DOF_IMU_pad
GY87_10DOF_IMU_silkscreen
GY87_10DOF_IMU_soldermask
GY87_10DOF_IMU_PCB
