pacman314159/OISP-Drone-Research/pcb/Power_Monitor/local_3dmodels/XT60PW.STEP

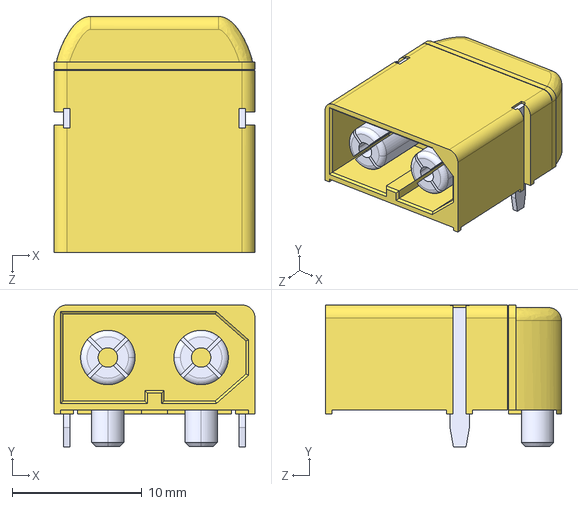
[picture p87: CAD file, 2026-07-30]
pcb/Power_Monitor/local_3dmodels/XT60PW.STEP
15.5 x 10.9 x 18.2 mm
