pacman314159/OISP-Drone-Research/pcb/Power_Monitor/Power_Monitor.step

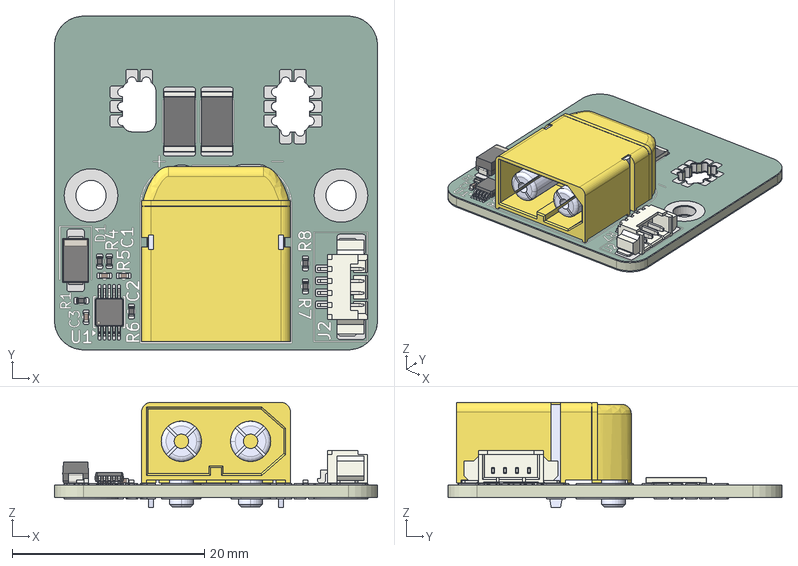
[picture p88: CAD file, 2026-09-13]
pcb/Power_Monitor/Power_Monitor.step
33.6 x 34.7 x 10.9 mm
R_0402_1005Metric x 6
C_0402_1005Metric x 3
TSSOP-10_3x3mm_P0.5mm
R_2512_6332Metric x 2
D_SMA
XT60PW-M
Molex_PicoBlade_53261-0471_1x04-1MP_P1.25mm_Horizontal
Power_Monitor_pad
Power_Monitor_silkscreen
Power_Monitor_soldermask x 2
Power_Monitor_PCB
