pacman314159/OISP-Drone-Research/pcb/FC_v02/local_3dmodels/MicroSD_Socket.STEP

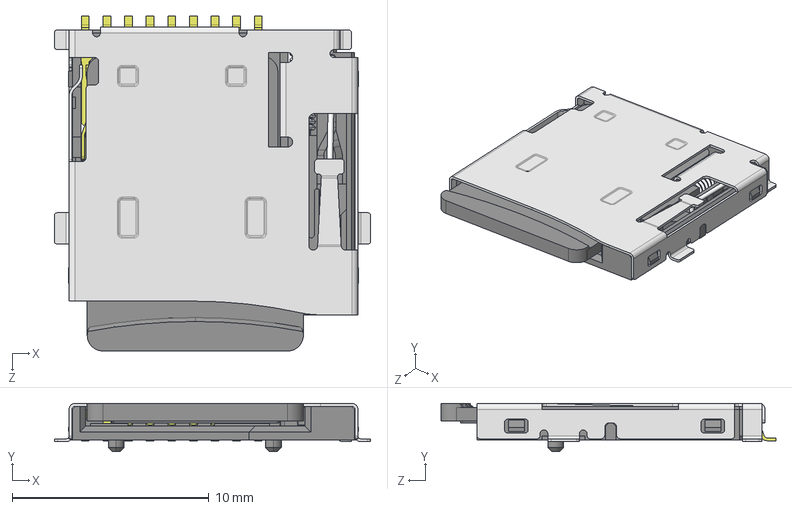
[picture p89: CAD file, 2026-07-18]
pcb/FC_v02/local_3dmodels/MicroSD_Socket.STEP
16.1 x 2.45 x 17.0 mm
Case^MicroSD_Socket
Insert^MicroSD_Socket
Brace^MicroSD_Socket
Spring^MicroSD_Socket
Lid^MicroSD_Socket
Pin_Middle^MicroSD_Socket x 5
Pin_Short^MicroSD_Socket
Pin_Long^MicroSD_Socket x 2
MicroSD_Card^MicroSD_Socket
Pin_CardIn^MicroSD_Socket
