pacman314159/OISP-Drone-Research/pcb/Power_Monitor/local_3dmodels/WS2812B-2020.STEP

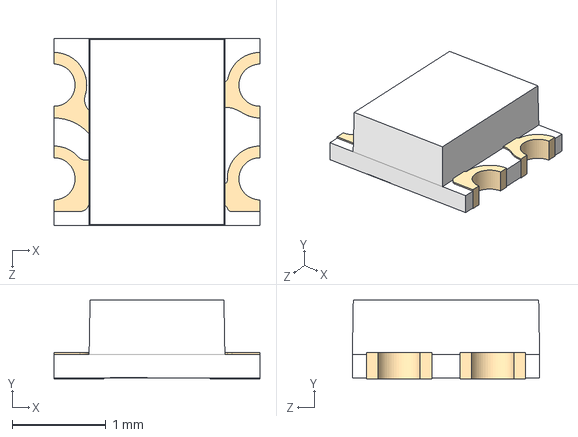
[picture p90: CAD file, 2026-07-18]
pcb/Power_Monitor/local_3dmodels/WS2812B-2020.STEP
2.20 x 0.84 x 2.00 mm
