pacman314159/OISP-Drone-Research/3d_models/Full_body/Propeller 10x45.STEP

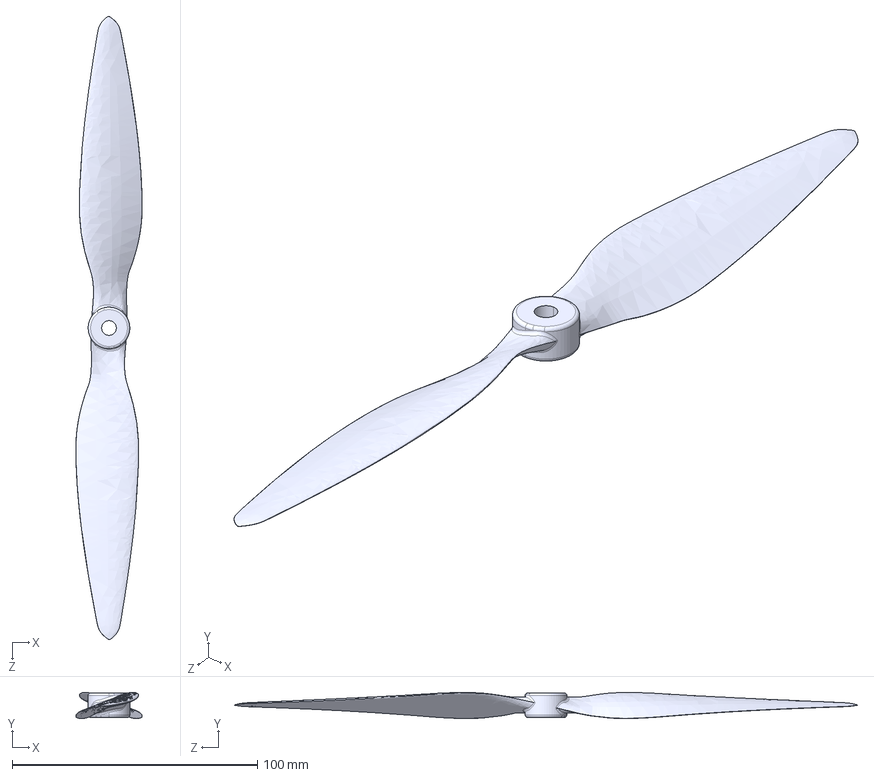
[picture p91: CAD file, 2026-07-30]
3d_models/Full_body/Propeller 10x45.STEP
27.0 x 10.6 x 254.0 mm
