pacman314159/OISP-Drone-Research/3d_models/Plate test.step

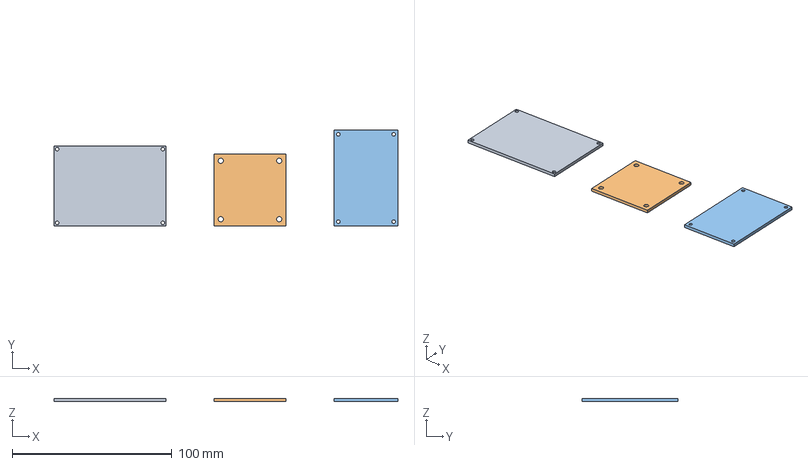
[picture p92: CAD file, 2026-07-22]
3d_models/Plate test.step
215.0 x 60.0 x 2.00 mm
