pacman314159/OISP-Drone-Research/pcb/FC_v02/local_3dmodels/Ra-02 LoRa.STEP

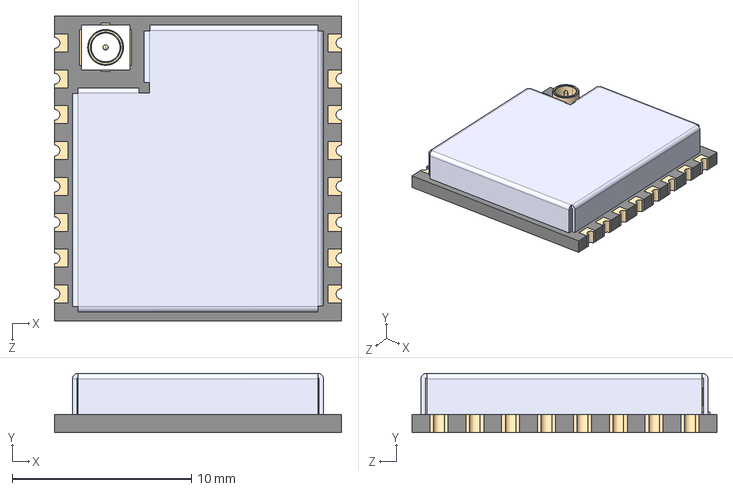
[picture p93: CAD file, 2026-07-18]
pcb/FC_v02/local_3dmodels/Ra-02 LoRa.STEP
16.0 x 3.30 x 17.0 mm
