pacman314159/OISP-Drone-Research/3d_models/Stand - hello side.step

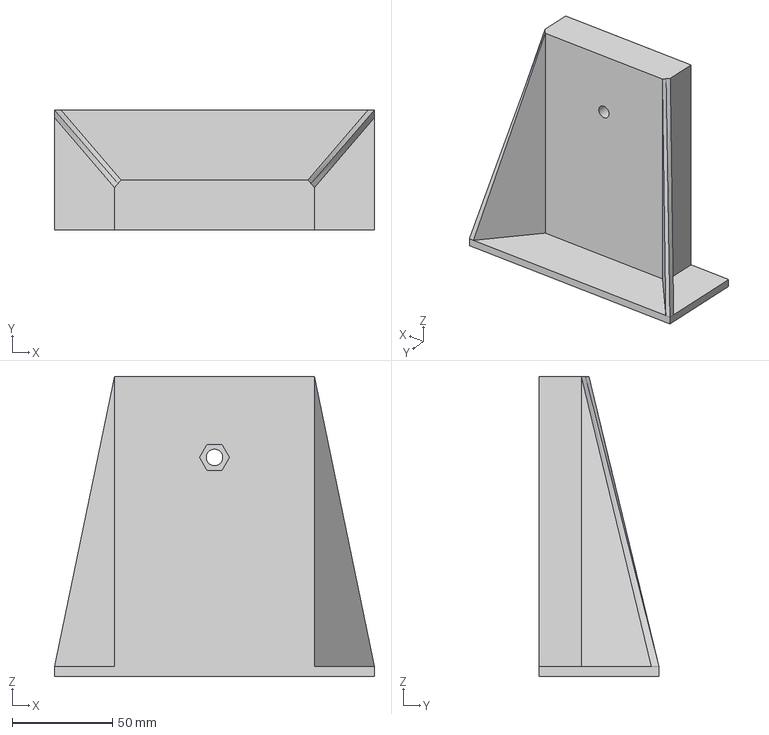
[picture p94: CAD file, 2026-07-22]
3d_models/Stand - hello side.step
160.0 x 60.0 x 150.0 mm
