pacman314159/OISP-Drone-Research/pcb/FC_v02/local_3dmodels/QFN28_5x5mm_P0.5mm.step

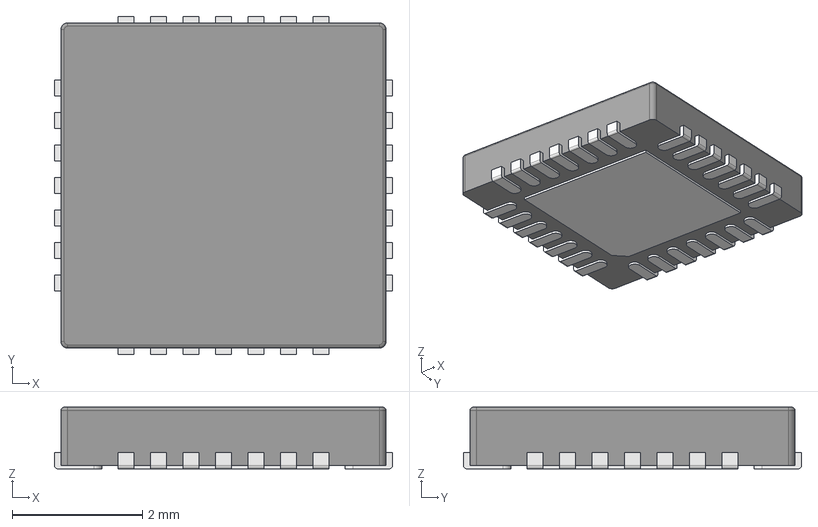
[picture p96: CAD file, 2026-07-18]
pcb/FC_v02/local_3dmodels/QFN28_5x5mm_P0.5mm.step
5.20 x 5.20 x 0.95 mm
