pacman314159/OISP-Drone-Research/3d_models/Mount Plate Test.step

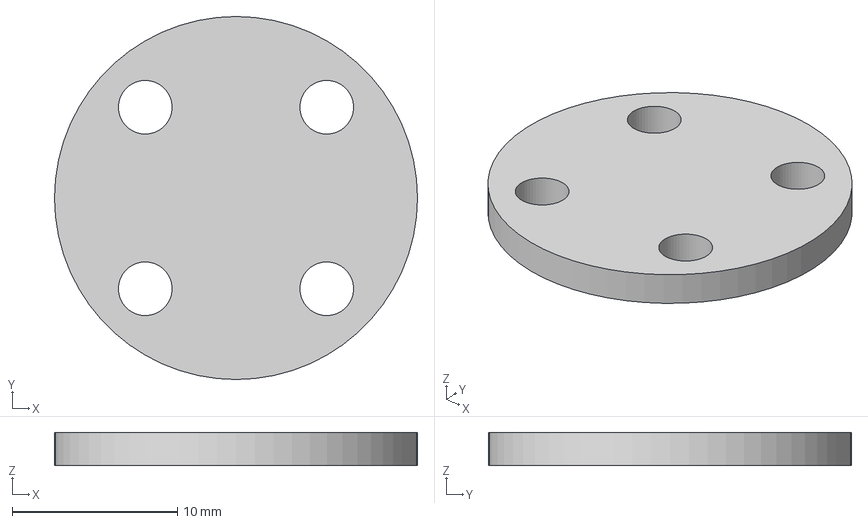
[picture p97: CAD file, 2026-07-22]
3d_models/Mount Plate Test.step
22.0 x 22.0 x 2.00 mm
