pacman314159/OISP-Drone-Research/3d_models/TestFace.step

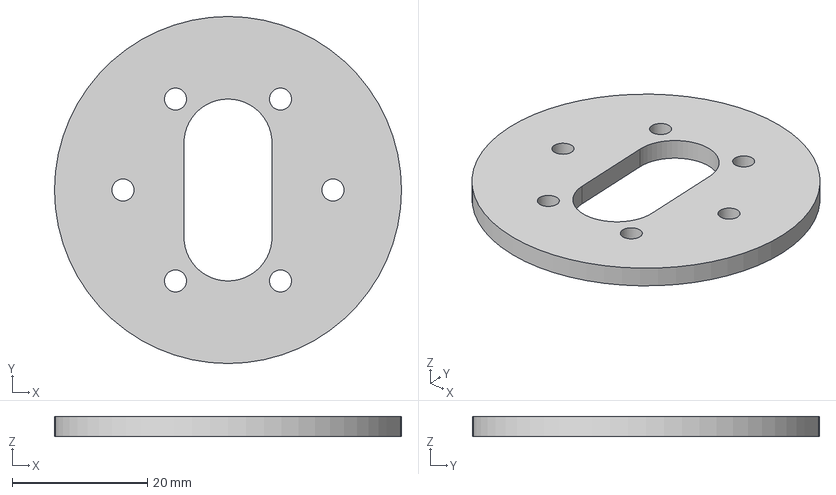
[picture p98: CAD file, 2026-07-22]
3d_models/TestFace.step
51.2 x 51.2 x 3.00 mm
