pacman314159/OISP-Drone-Research/3d_models/Top.step

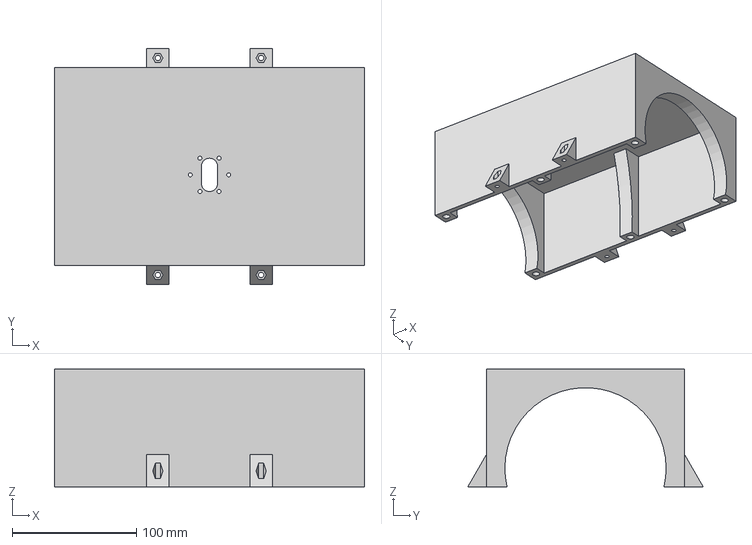
[picture p99: CAD file, 2026-07-22]
3d_models/Top.step
250.0 x 190.0 x 95.0 mm
