pacman314159/OISP-Drone-Research/3d_models/V31.step

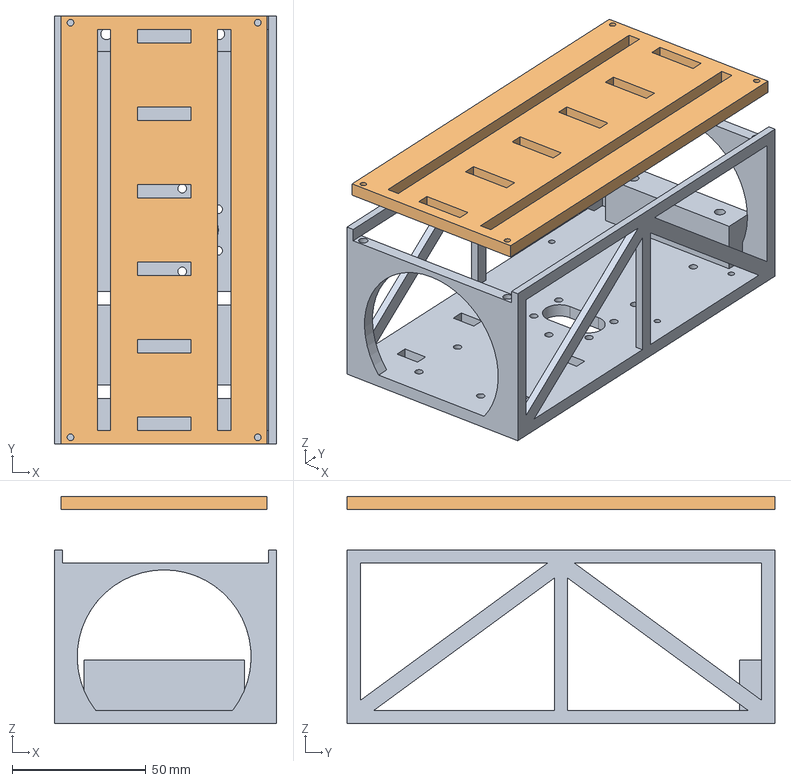
[picture p101: CAD file, 2026-07-22]
3d_models/V31.step
83.0 x 160.0 x 85.0 mm
