pacman314159/OISP-Drone-Research/3d_models/Design 2.step

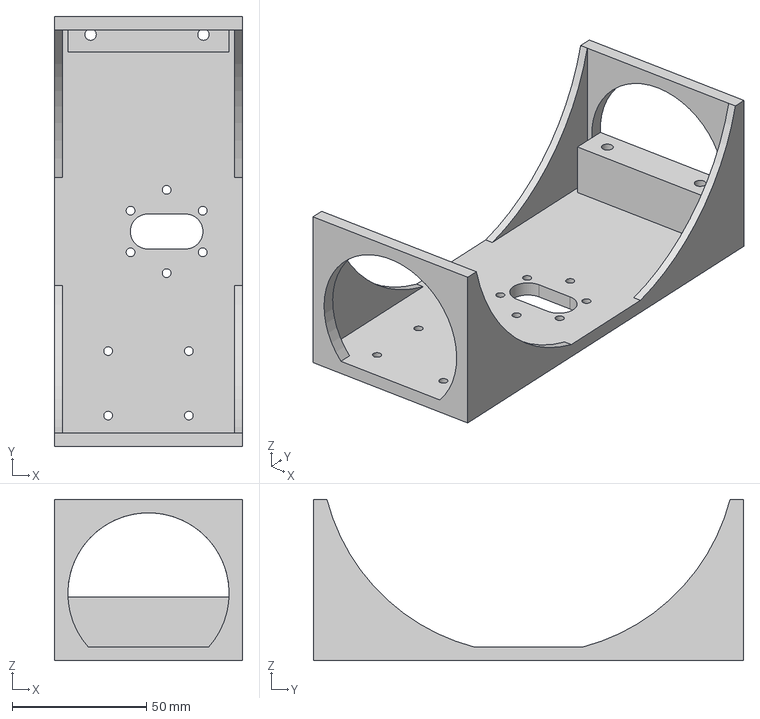
[picture p102: CAD file, 2026-07-18]
3d_models/Design 2.step
70.0 x 160.0 x 60.0 mm
