pacman314159/OISP-Drone-Research/3d_models/Bottom.step

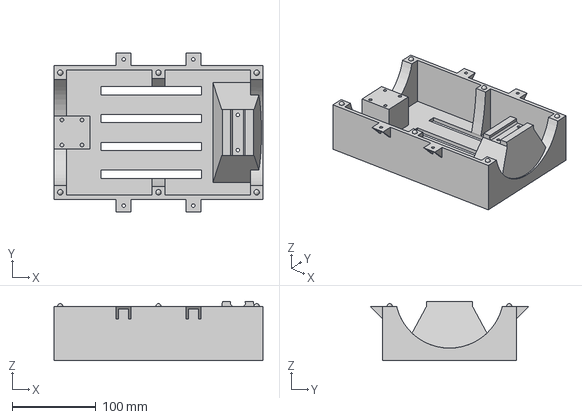
[picture p103: CAD file, 2026-07-18]
3d_models/Bottom.step
250.0 x 190.0 x 71.0 mm
