pacman314159/OISP-Drone-Research/(list of files, cad)

Other CAD files:
3d_models/Bottom.gcode.3mf
3d_models/Full_body/Power_Monitor.step
3d_models/Top.gcode.3mf
3d_models/Calib_base/Antivibration_ball.ipt
3d_models/Calib_base/Assembly1.iam
3d_models/Calib_base/Base.ipt
3d_models/Calib_base/FC_v02.iam
3d_models/Calib_base/FC_v02/FC_v02/BMP180.ipt
3d_models/Calib_base/FC_v02/FC_v02/Brace^MicroSD_Socket.ipt
3d_models/Calib_base/FC_v02/FC_v02/CP_EIA-1608-10_AVX-L.ipt
3d_models/Calib_base/FC_v02/FC_v02/CP_EIA-3216-10_Kemet-I.ipt
3d_models/Calib_base/FC_v02/FC_v02/C_0603_1608Metric.ipt
3d_models/Calib_base/FC_v02/FC_v02/C_0603_1608Metric_1.ipt
3d_models/Calib_base/FC_v02/FC_v02/C_0805_2012Metric.ipt
3d_models/Calib_base/FC_v02/FC_v02/C_0805_2012Metric_1.ipt
3d_models/Calib_base/FC_v02/FC_v02/Case^MicroSD_Socket.ipt
3d_models/Calib_base/FC_v02/FC_v02/D_SOD-123.ipt
3d_models/Calib_base/FC_v02/FC_v02/ESP32-S3-WROOM-1.ipt
3d_models/Calib_base/FC_v02/FC_v02/FC_v02_PCB.ipt
3d_models/Calib_base/FC_v02/FC_v02/FC_v02_pad.ipt
3d_models/Calib_base/FC_v02/FC_v02/FC_v02_silkscreen.ipt
3d_models/Calib_base/FC_v02/FC_v02/FC_v02_silkscreen_1.ipt
3d_models/Calib_base/FC_v02/FC_v02/FC_v02_soldermask.ipt
3d_models/Calib_base/FC_v02/FC_v02/FC_v02_soldermask_1.ipt
3d_models/Calib_base/FC_v02/FC_v02/GY87_10DOF_IMU_NoPin.iam
3d_models/Calib_base/FC_v02/FC_v02/GY87_10DOF_IMU_PCB.ipt
3d_models/Calib_base/FC_v02/FC_v02/GY87_10DOF_IMU_pad.ipt
3d_models/Calib_base/FC_v02/FC_v02/GY87_10DOF_IMU_silkscreen.ipt
3d_models/Calib_base/FC_v02/FC_v02/GY87_10DOF_IMU_soldermask.ipt
3d_models/Calib_base/FC_v02/FC_v02/Insert^MicroSD_Socket.ipt
3d_models/Calib_base/FC_v02/FC_v02/LED_0603_1608Metric.ipt
3d_models/Calib_base/FC_v02/FC_v02/LED_0805_2012Metric.ipt
3d_models/Calib_base/FC_v02/FC_v02/Lid^MicroSD_Socket.ipt
3d_models/Calib_base/FC_v02/FC_v02/MicroSD_Card^MicroSD_Socket.ipt
3d_models/Calib_base/FC_v02/FC_v02/MicroSD_Socket.iam
3d_models/Calib_base/FC_v02/FC_v02/Molex_PicoBlade_53261-0271_1x02-1MP_P1.25mm_Horizontal.ipt
3d_models/Calib_base/FC_v02/FC_v02/Molex_PicoBlade_53261-0371_1x03-1MP_P1.25mm_Horizontal.ipt
3d_models/Calib_base/FC_v02/FC_v02/Molex_PicoBlade_53261-0471_1x04-1MP_P1.25mm_Horizontal.ipt
3d_models/Calib_base/FC_v02/FC_v02/Molex_PicoBlade_53261-0771_1x07-1MP_P1.25mm_Horizontal.ipt
3d_models/Calib_base/FC_v02/FC_v02/Part 1.ipt
3d_models/Calib_base/FC_v02/FC_v02/Part 10.ipt
3d_models/Calib_base/FC_v02/FC_v02/Part 11.ipt
3d_models/Calib_base/FC_v02/FC_v02/Part 12.ipt
3d_models/Calib_base/FC_v02/FC_v02/Part 13.ipt
3d_models/Calib_base/FC_v02/FC_v02/Part 14.ipt
3d_models/Calib_base/FC_v02/FC_v02/Part 15.ipt
3d_models/Calib_base/FC_v02/FC_v02/Part 16.ipt
3d_models/Calib_base/FC_v02/FC_v02/Part 17.ipt
3d_models/Calib_base/FC_v02/FC_v02/Part 18.ipt
3d_models/Calib_base/FC_v02/FC_v02/Part 19.ipt
3d_models/Calib_base/FC_v02/FC_v02/Part 1_1.ipt
3d_models/Calib_base/FC_v02/FC_v02/Part 2.ipt
3d_models/Calib_base/FC_v02/FC_v02/Part 20.ipt
3d_models/Calib_base/FC_v02/FC_v02/Part 21.ipt
3d_models/Calib_base/FC_v02/FC_v02/Part 22.ipt
3d_models/Calib_base/FC_v02/FC_v02/Part 23.ipt
3d_models/Calib_base/FC_v02/FC_v02/Part 24.ipt
3d_models/Calib_base/FC_v02/FC_v02/Part 25.ipt
3d_models/Calib_base/FC_v02/FC_v02/Part 26.ipt
3d_models/Calib_base/FC_v02/FC_v02/Part 27.ipt
3d_models/Calib_base/FC_v02/FC_v02/Part 28.ipt
3d_models/Calib_base/FC_v02/FC_v02/Part 29.ipt
3d_models/Calib_base/FC_v02/FC_v02/Part 3.ipt
3d_models/Calib_base/FC_v02/FC_v02/Part 4.ipt
3d_models/Calib_base/FC_v02/FC_v02/Part 5.ipt
3d_models/Calib_base/FC_v02/FC_v02/Part 6.ipt
3d_models/Calib_base/FC_v02/FC_v02/Part 7.ipt
3d_models/Calib_base/FC_v02/FC_v02/Part 8.ipt
3d_models/Calib_base/FC_v02/FC_v02/Part 9.ipt
3d_models/Calib_base/FC_v02/FC_v02/PinSocket_1x07_P2.54mm_Vertical.ipt
3d_models/Calib_base/FC_v02/FC_v02/Pin_CardIn^MicroSD_Socket.ipt
3d_models/Calib_base/FC_v02/FC_v02/Pin_Long^MicroSD_Socket.ipt
3d_models/Calib_base/FC_v02/FC_v02/Pin_Middle^MicroSD_Socket.ipt
3d_models/Calib_base/FC_v02/FC_v02/Pin_Short^MicroSD_Socket.ipt
3d_models/Calib_base/FC_v02/FC_v02/QFN-16-1EP_3x3mm_P0.5mm_EP1.7x1.7mm.ipt
3d_models/Calib_base/FC_v02/FC_v02/QFN-24-1EP_4x4mm_P0.5mm_EP2.7x2.7mm.ipt
3d_models/Calib_base/FC_v02/FC_v02/QFN28_5x5mm_P0.5mm.iam
3d_models/Calib_base/FC_v02/FC_v02/R_0603_1608Metric.ipt
3d_models/Calib_base/FC_v02/FC_v02/R_0603_1608Metric_1.ipt
3d_models/Calib_base/FC_v02/FC_v02/Ra-02 LoRa.ipt
3d_models/Calib_base/FC_v02/FC_v02/SOT-23-5.ipt
3d_models/Calib_base/FC_v02/FC_v02/SOT-23-5_1.ipt
3d_models/Calib_base/FC_v02/FC_v02/SOT-23-6.ipt
3d_models/Calib_base/FC_v02/FC_v02/SOT-23.ipt
3d_models/Calib_base/FC_v02/FC_v02/SOT-23_1.ipt
3d_models/Calib_base/FC_v02/FC_v02/SW_Push_1P1T_NO_CK_KMR2.ipt
3d_models/Calib_base/FC_v02/FC_v02/Spring^MicroSD_Socket.ipt
3d_models/Calib_base/FC_v02/FC_v02/TSOT-23-6.ipt
3d_models/Calib_base/FC_v02/FC_v02/USB_C_Receptacle_GCT_USB4105-xx-A_16P_TopMnt_Horizontal.ipt
3d_models/Calib_base/FC_v02/FC_v02/WS2812B-2020.ipt
3d_models/Calib_base/Hex_M3x8mm.ipt
3d_models/Calib_base/Main.iam
3d_models/Calib_base/OldVersions/Antivibration_ball.0001.ipt
3d_models/Calib_base/OldVersions/Main.0002.iam
3d_models/Full_body/AVI-PRT-5001-Propeller_10x45.ipt
3d_models/Full_body/FC_v02/FC_v02/BMP180.ipt
3d_models/Full_body/FC_v02/FC_v02/Brace^MicroSD_Socket.ipt
3d_models/Full_body/FC_v02/FC_v02/CP_EIA-1608-10_AVX-L.ipt
3d_models/Full_body/FC_v02/FC_v02/CP_EIA-3216-10_Kemet-I.ipt
3d_models/Full_body/FC_v02/FC_v02/C_0603_1608Metric.ipt
3d_models/Full_body/FC_v02/FC_v02/C_0603_1608Metric_1.ipt
3d_models/Full_body/FC_v02/FC_v02/C_0805_2012Metric.ipt
3d_models/Full_body/FC_v02/FC_v02/C_0805_2012Metric_1.ipt
3d_models/Full_body/FC_v02/FC_v02/Case^MicroSD_Socket.ipt
3d_models/Full_body/FC_v02/FC_v02/D_SOD-123.ipt
3d_models/Full_body/FC_v02/FC_v02/ESP32-S3-WROOM-1.ipt
3d_models/Full_body/FC_v02/FC_v02/FC_v02_PCB.ipt
3d_models/Full_body/FC_v02/FC_v02/FC_v02_pad.ipt
3d_models/Full_body/FC_v02/FC_v02/FC_v02_silkscreen.ipt
3d_models/Full_body/FC_v02/FC_v02/FC_v02_silkscreen_1.ipt
3d_models/Full_body/FC_v02/FC_v02/FC_v02_soldermask.ipt
3d_models/Full_body/FC_v02/FC_v02/FC_v02_soldermask_1.ipt
3d_models/Full_body/FC_v02/FC_v02/GY87_10DOF_IMU_NoPin.iam
3d_models/Full_body/FC_v02/FC_v02/GY87_10DOF_IMU_PCB.ipt
3d_models/Full_body/FC_v02/FC_v02/GY87_10DOF_IMU_pad.ipt
3d_models/Full_body/FC_v02/FC_v02/GY87_10DOF_IMU_silkscreen.ipt
3d_models/Full_body/FC_v02/FC_v02/GY87_10DOF_IMU_soldermask.ipt
3d_models/Full_body/FC_v02/FC_v02/Insert^MicroSD_Socket.ipt
3d_models/Full_body/FC_v02/FC_v02/LED_0603_1608Metric.ipt
3d_models/Full_body/FC_v02/FC_v02/LED_0805_2012Metric.ipt
3d_models/Full_body/FC_v02/FC_v02/Lid^MicroSD_Socket.ipt
3d_models/Full_body/FC_v02/FC_v02/MicroSD_Card^MicroSD_Socket.ipt
3d_models/Full_body/FC_v02/FC_v02/MicroSD_Socket.iam
3d_models/Full_body/FC_v02/FC_v02/Molex_PicoBlade_53261-0271_1x02-1MP_P1.25mm_Horizontal.ipt
3d_models/Full_body/FC_v02/FC_v02/Molex_PicoBlade_53261-0371_1x03-1MP_P1.25mm_Horizontal.ipt
3d_models/Full_body/FC_v02/FC_v02/Molex_PicoBlade_53261-0471_1x04-1MP_P1.25mm_Horizontal.ipt
3d_models/Full_body/FC_v02/FC_v02/Molex_PicoBlade_53261-0771_1x07-1MP_P1.25mm_Horizontal.ipt
3d_models/Full_body/FC_v02/FC_v02/Part 1.ipt
3d_models/Full_body/FC_v02/FC_v02/Part 10.ipt
3d_models/Full_body/FC_v02/FC_v02/Part 11.ipt
3d_models/Full_body/FC_v02/FC_v02/Part 12.ipt
3d_models/Full_body/FC_v02/FC_v02/Part 13.ipt
3d_models/Full_body/FC_v02/FC_v02/Part 14.ipt
3d_models/Full_body/FC_v02/FC_v02/Part 15.ipt
3d_models/Full_body/FC_v02/FC_v02/Part 16.ipt
3d_models/Full_body/FC_v02/FC_v02/Part 17.ipt
3d_models/Full_body/FC_v02/FC_v02/Part 18.ipt
3d_models/Full_body/FC_v02/FC_v02/Part 19.ipt
3d_models/Full_body/FC_v02/FC_v02/Part 1_1.ipt
3d_models/Full_body/FC_v02/FC_v02/Part 2.ipt
3d_models/Full_body/FC_v02/FC_v02/Part 20.ipt
3d_models/Full_body/FC_v02/FC_v02/Part 21.ipt
3d_models/Full_body/FC_v02/FC_v02/Part 22.ipt
3d_models/Full_body/FC_v02/FC_v02/Part 23.ipt
3d_models/Full_body/FC_v02/FC_v02/Part 24.ipt
3d_models/Full_body/FC_v02/FC_v02/Part 25.ipt
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
