pacman314159/OISP-Drone-Research/firmware/EKF-sensor-fusion/test/README

#include <Arduino.h>
#include <Wire.h>
#include "math/Matrix.h"
#include "sensor/GY87_MPU6050.h"
#include "sensor/GY87_HMC5883L.h"

// ==========================================
// 1. HARDWARE OBJECTS
// ==========================================
GY87_MPU6050 mpu;
GY87_HMC5883L mag;

// ==========================================
// 2. GLOBAL EKF MEMORY (Persistent Variables)
// ==========================================
Vector7 x;  // State Vector [q0, q1, q2, q3, bx, by, bz]
Matrix<7,7> P;  // Covariance Matrix
Matrix<7,7> Q;  // Process Noise
Matrix<3,3> Ra; // Accel Noise
Matrix<3,3> Rm; // Mag Noise

// Earth's Reference Magnetic Field (To be tuned/calculated)
float earth_bx = 1.0f; 
float earth_bz = 0.0f;

// RTOS Mutex and Handles
SemaphoreHandle_t ekfMutex;
TaskHandle_t TaskPilot_Handle;
TaskHandle_t TaskNav_Handle;

// ==========================================
// 3. EKF MATH FUNCTIONS
// ==========================================

void predict(float dt, Vector3 gyro_raw) {
    float q0 = x(0,0), q1 = x(1,0), q2 = x(2,0), q3 = x(3,0);
    float dt2 = dt / 2.0f;

    // 1. Calculate True Gyro (Raw - Bias)
    float wx = (gyro_raw(0,0) * 0.0174533f) - x(4,0); 
    float wy = (gyro_raw(1,0) * 0.0174533f) - x(5,0);
    float wz = (gyro_raw(2,0) * 0.0174533f) - x(6,0);

    // 2. Predict State (x)
    x(0,0) = q0 - dt2*wx*q1 - dt2*wy*q2 - dt2*wz*q3;
    x(1,0) = q1 + dt2*wx*q0 - dt2*wy*q3 + dt2*wz*q2;
    x(2,0) = q2 + dt2*wx*q3 + dt2*wy*q0 - dt2*wz*q1;
    x(3,0) = q3 - dt2*wx*q2 + dt2*wy*q1 + dt2*wz*q0;

    // 3. Calculate Jacobian (F_mat instead of F)
    Matrix<7,7> F_mat = Matrix<7,7>::identity();
    F_mat(0,1) = -dt2*wx; F_mat(0,2) = -dt2*wy; F_mat(0,3) = -dt2*wz; F_mat(0,4) =  dt2*q1; F_mat(0,5) =  dt2*q2; F_mat(0,6) =  dt2*q3;
    F_mat(1,0) =  dt2*wx; F_mat(1,2) =  dt2*wz; F_mat(1,3) = -dt2*wy; F_mat(1,4) = -dt2*q0; F_mat(1,5) =  dt2*q3; F_mat(1,6) = -dt2*q2;
    F_mat(2,0) =  dt2*wy; F_mat(2,1) = -dt2*wz; F_mat(2,3) =  dt2*wx; F_mat(2,4) = -dt2*q3; F_mat(2,5) = -dt2*q0; F_mat(2,6) =  dt2*q1;
    F_mat(3,0) =  dt2*wz; F_mat(3,1) =  dt2*wy; F_mat(3,2) = -dt2*wx; F_mat(3,4) =  dt2*q2; F_mat(3,5) = -dt2*q1; F_mat(3,6) = -dt2*q0;

    // 4. Update Covariance (P)
    P = (F_mat * P * F_mat.transpose()) + Q;
}

void updateAccel(Vector3 z_a) {
    float q0 = x(0,0), q1 = x(1,0), q2 = x(2,0), q3 = x(3,0);

    // 1. Calculate Expected Read (h_a)
    Vector3 h_a = {
        2.0f * (q1*q3 - q0*q2),
        2.0f * (q0*q1 + q2*q3),
        q0*q0 - q1*q1 - q2*q2 + q3*q3
    };

    // 2. Calculate Jacobian (H_a)
    Matrix<3,7> Ha = Matrix<3,7>::zeros();
    Ha(0,0) = -2.0f*q2; Ha(0,1) =  2.0f*q3; Ha(0,2) = -2.0f*q0; Ha(0,3) =  2.0f*q1;
    Ha(1,0) =  2.0f*q1; Ha(1,1) =  2.0f*q0; Ha(1,2) =  2.0f*q3; Ha(1,3) =  2.0f*q2;
    Ha(2,0) =  2.0f*q0; Ha(2,1) = -2.0f*q1; Ha(2,2) = -2.0f*q2; Ha(2,3) =  2.0f*q3;

    // 3. Calculate Kalman Gain (K_a)
    Vector3 y_a = z_a - h_a;
    Matrix<3,3> S = (Ha * P * Ha.transpose()) + Ra;
    Matrix<7,3> K = P * Ha.transpose() * S.inverse3x3();

    // 4. Update State and Covariance
    x = x + (K * y_a);
    P = (Matrix<7,7>::identity() - (K * Ha)) * P;
}

void updateMag(Vector3 z_m) {
    float q0 = x(0,0), q1 = x(1,0), q2 = x(2,0), q3 = x(3,0);
    float bx = earth_bx, bz = earth_bz;

    // 1. Calculate Expected Read (h_m)
    Vector3 h_m = {
        bx*(q0*q0 + q1*q1 - q2*q2 - q3*q3) + 2.0f*bz*(q1*q3 - q0*q2),
        2.0f*bx*(q1*q2 - q0*q3) + 2.0f*bz*(q0*q1 + q2*q3),
        2.0f*bx*(q0*q2 + q1*q3) + bz*(q0*q0 - q1*q1 - q2*q2 + q3*q3)
    };

    // 2. Calculate Jacobian (H_m)
    Matrix<3,7> Hm = Matrix<3,7>::zeros();
    Hm(0,0) = 2.0f*bx*q0 - 2.0f*bz*q2; Hm(0,1) = 2.0f*bx*q1 + 2.0f*bz*q3; Hm(0,2) = -2.0f*bx*q2 - 2.0f*bz*q0; Hm(0,3) = -2.0f*bx*q3 + 2.0f*bz*q1;
    Hm(1,0) = -2.0f*bx*q3 + 2.0f*bz*q1; Hm(1,1) = 2.0f*bx*q2 + 2.0f*bz*q0; Hm(1,2) = 2.0f*bx*q1 + 2.0f*bz*q3; Hm(1,3) = -2.0f*bx*q0 + 2.0f*bz*q2;
    Hm(2,0) = 2.0f*bx*q2 + 2.0f*bz*q0; Hm(2,1) = 2.0f*bx*q3 - 2.0f*bz*q1; Hm(2,2) = 2.0f*bx*q0 - 2.0f*bz*q2; Hm(2,3) = 2.0f*bx*q1 + 2.0f*bz*q3;

    // 3. Calculate Kalman Gain (K_m)
    Vector3 y_m = z_m - h_m;
    Matrix<3,3> S = (Hm * P * Hm.transpose()) + Rm;
    Matrix<7,3> K = P * Hm.transpose() * S.inverse3x3();

    // 4. Update State and Covariance
    x = x + (K * y_m);
    P = (Matrix<7,7>::identity() - (K * Hm)) * P;
}

void normalizeQuaternion() {
    float mag = sqrtf(x(0,0)*x(0,0) + x(1,0)*x(1,0) + x(2,0)*x(2,0) + x(3,0)*x(3,0));
    if(mag > 0.0f) {
        x(0,0) /= mag;
        x(1,0) /= mag;
        x(2,0) /= mag;
        x(3,0) /= mag;
    }
}

// ==========================================
// 4. RTOS TASKS
// ==========================================

// CORE 1: High Speed Pilot Task (500Hz)
void Task_Pilot(void *pvParameters) {
    TickType_t xLastWakeTime = xTaskGetTickCount();
    const TickType_t xFrequency = 2; // 2ms = 500Hz
    float dt = 0.002f;

    while(1) {
        vTaskDelayUntil(&xLastWakeTime, xFrequency);

        if (xSemaphoreTake(ekfMutex, portMAX_DELAY) == pdTRUE) {
            mpu.getRawAll();
            Vector3 gyro = {mpu.getGyroX(), mpu.getGyroY(), mpu.getGyroZ()};

            Vector3 accel = {mpu.getAccX(), mpu.getAccY(), mpu.getAccZ()}; 
            accel.normalize(); // Force Accel Vector to exactly 1G length

            predict(dt, gyro);
            updateAccel(accel);
            normalizeQuaternion();
            
            // 3. Extract Euler Angles for Control WHY IT IS HERE? SEPARATE IT
            float q0 = x(0,0), q1 = x(1,0), q2 = x(2,0), q3 = x(3,0);
            float roll  = atan2f(2.0f*(q0*q1 + q2*q3), q0*q0 - q1*q1 - q2*q2 + q3*q3) * 57.2958f;
            float pitch = asinf(-2.0f*(q1*q3 - q0*q2)) * 57.2958f;
            float yaw   = atan2f(2.0f*(q1*q2 + q0*q3), q0*q0 + q1*q1 - q2*q2 - q3*q3) * 57.2958f;
            
            xSemaphoreGive(ekfMutex);

            // Optional: Print to Serial for Debugging (Stage 3 Test)
            // Serial.printf("Roll: %.2f | Pitch: %.2f | Yaw: %.2f\n", roll, pitch, yaw);
        }
    }
}

// CORE 0: Low Speed Navigator Task (75Hz)
void Task_Navigator(void *pvParameters) {
    TickType_t xLastWakeTime = xTaskGetTickCount();
    const TickType_t xFrequency = 13; // ~13ms = ~75Hz

    // ==== INSIDE Task_Navigator ====
while(1) {
    vTaskDelayUntil(&xLastWakeTime, xFrequency);

    // Only attempt I2C if the mutex is available immediately,
    // don't wait forever if the Pilot is busy.
    if (xSemaphoreTake(ekfMutex, 10 / portTICK_PERIOD_MS) == pdTRUE) {
        
        // ONLY READ if the register says data is actually there
        // This prevents the "hanging" that causes Error -1
        if (mag.isDataReady()) { 
            mag.getRawAll();
            Vector3 mag_vec = {mag.getX(), mag.getY(), mag.getZ()};
            mag_vec.normalize();
            updateMag(mag_vec);
            normalizeQuaternion();
        }
        xSemaphoreGive(ekfMutex);
    }
}
}

// ==========================================
// 5. SETUP & LOOP
// ==========================================
void setup() {
Serial.begin(115200);

    uint8_t SDA_PIN = 8; 
    uint8_t SCL_PIN = 9;

    Wire.begin(SDA_PIN, SCL_PIN);
    Wire.setClock(100000); // 100kHz is safe for breadboard jumper wires!
    delay(50);
    
    // 1. Initialize MPU6050 First
    mpu.init(SDA_PIN, SCL_PIN);
    
    // 2. OPEN THE I2C FIREWALL (CRITICAL FOR GY-87)
    mpu.enableBypass(); 
    delay(100);
    
    // 3. NOW Initialize the Magnetometer
    mag.init(SDA_PIN, SCL_PIN);
    mag.setMeasMode(CONTINUOUS_MODE);
    mag.setOutputRate(RATE_75);
    mag.setGain(FIELD_RANGE_1_3);

    // 2. Initialize EKF Matrices
    x = {1.0f, 0.0f, 0.0f, 0.0f, 0.0f, 0.0f, 0.0f};
    P = Matrix<7,7>::identity() * 0.01f;
    
    Q = Matrix<7,7>::zeros();
    float q_var = 0.0001f; // Trust in gyro orientation
    float b_var = 1e-6f;   // Trust in gyro bias
    for(int i=0; i<4; i++) Q(i,i) = q_var;
    for(int i=4; i<7; i++) Q(i,i) = b_var;

    Ra = Matrix<3,3>::identity() * 0.1f;  // Accel Noise
    Rm = Matrix<3,3>::identity() * 0.5f;  // Mag Noise

    // 3. Start RTOS
    ekfMutex = xSemaphoreCreateMutex();
    
    xTaskCreatePinnedToCore(Task_Pilot, "Pilot", 8192, NULL, 2, &TaskPilot_Handle, 1);
    xTaskCreatePinnedToCore(Task_Navigator, "Nav", 4096, NULL, 1, &TaskNav_Handle, 0);
}

void loop() {
    vTaskDelete(NULL); // Run on RTOS Tasks, disable standard loop
}
