pacman314159/OISP-Drone-Research/firmware/FC_v01/documents/Magnetometer Ellipsoid Calibration.pdf

TITLE Magnetometer Full Rotated Ellipsoid Calibration via SIMD-Accelerated Symmetric Gradient Descent

AUTHOR Drone Research Team / Developer | DATE 2026-10-13 | VERSION 2.0.0 | STATUS Approved & Documented

# Magnetometer Full Rotated Ellipsoid Calibration via SIMD-Accelerated Symmetric Gradient Descent

## 1. Executive Summary & Problem Context

Magnetometers on multirotor airframes (e.g. HMC5883L, QMC5883L, LIS3MDL) experience significant magnetic field contamination:

1. Hard-Iron Distortion: Constant offset bias produced by permanent ferromagnetic airframe parts (screws, motor magnets, battery leads). Shifts the center of the magnetic sphere away from the
origin: | .
2. Soft-Iron Distortion: Induced magnetic field distortion produced by magnetically permeable materials and asymmetrical conductive geometry (ESC copper traces, carbon-fiber weave conductivity, motor stator iron).

Why the Axis-Aligned Model Fails

An axis-aligned ellipsoid model ( | ) assumes zero cross-axis magnetic
coupling. In real flight data (as demonstrated in 3-plane projections), the magnetic point cloud in the XZ and YZ planes is noticeably tilted at non-zero angles.
Forcing an axis-aligned fit onto a tilted ellipsoid causes severe residual heading errors (often | of
yaw drift), destabilizing attitude estimation and navigation.

v0 = [x0, y0, z0]
T
Raw Distorted Measurements | Calibrated Output
(Tilted, Rotated & Offset Ellipsoid) | (Centered Unit/Ref Sphere)
+---+ | * *
/ | \ | <-- Tilted / Cross-Coupled | * | *
/ (x0,y0) \ | * (0,0) *
\ | / | * | *
+---+ | * *
[Hard-Iron Bias + Rotated Soft-Iron Matrix] | [Origin Centered, Uniform Radius]

a

2 +

(x−x0)

2
b

2 +

(y−y0)

2
c

2 =

(z−z0)

2
1

10 –20

∘ | ∘
10/13/26, 8:12 PM | MDHero
tauri.localhost | 1/12

The Solution: 6-Parameter Symmetric Soft-Iron Matrix Formulation

To capture full 3D tilt and non-orthogonal cross-axis distortion without suffering from unobservable 3D
rotation gauge drift, the soft-iron matrix | is parameterized as a symmetric | matrix with 6
independent variables:
Together with the 3 center offset parameters | , this model contains exactly 9
parameters, matching the physical degrees of freedom of a general rotated 3D ellipsoid.

## 2. Mathematical Model & Derivation

### 2.1 The Geometric Model

For a measured raw magnetometer vector | , the hard-iron offset vector is subtracted:

The calibrated magnetic vector is obtained via linear transformation:

The quadric equation defining the ellipsoid surface is:

### 2.2 Objective Function (Mean Squared Error)

Given samples collected during calibration:

W 3 × 3

W = W =

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
v0 = [x0, y0, z0]
T

p = [x, y, z]
T

d = p − v0 =

x − x0
y − y0
z − z0

u

u = Wd =

w11dx + w12dy + w13dz
w12dx + w22dy + w23dz
w13dx + w23dy + w33dz

f^ = ∥u∥ =

### 2 u u =

T d W Wd
T | T | =

WT =W d W d =
T | 2 | 1.0

n

For each sample :

The total Mean Squared Error cost function is:

### 2.3 Multivariate Chain Rule Framework

For any parameter :

### 2.4 Gradient with respect to Hard-Iron Offset

Using matrix calculus on the quadratic form | :
Since | , we have | :
pi = | , i ∈

xi
yi
zi

{1, 2,…, n}

i

di = pi − v0

ui = Wdi

f^
i = ∥ui∥ =

2
ui,x +

2
ui,y +

2
ui,z

2

ri = f^
i − 1.0

e(v0,W) = r =
n

1

i=1

∑

n

i

2 − 1.0
n

1

i=1

∑

n
(f^
i | )

2

θ

=
∂θ

∂e
2r =
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
i = di W d

T 2
i

=
∂di

∂f^
i
2W d

2
i
di = pi − v0 | ∂v =0
∂di | −I

Substituting into the total cost derivative yields:

Factoring the constant matrix out of the summation:

### 2.5 Gradient with respect to Symmetric Matrix

Let us compute the differential of | :
Because | is strictly symmetric, any differential | must also be symmetric ( | ). Projecting
the gradient onto the symmetric matrix space:

Substituting into the cost derivative gives:

Defining the unsymmetric outer-product accumulator matrix | :

Then the gradient for the symmetric matrix is simply:

=
∂v0

∂f^
i −I ⋅ (2W d =

2
i) −2W d =

2
i | −2Wui
∇v0 e = | r −2Wu =
n

2

i=1

∑

n
i ( | i) − W | r u
| n
| 4

i=1

∑

n

i i

W

su = r u ∈

i=1

∑

n
i i R

3 ⟹ ∇v0 e = − Ws
n

4
u

W

f^
i = ui u
T
i

df^
i = 2ui (du ) =
T

i 2ui (dWd ) =
T

i 2 Tr (uidi

T dW)

W | dW | dW = dWT

=
∂W

∂f^
i
uidi +

T (uidi
T ) =

T
uidi +

T diui
T

∇We = r u d + d u
n

2

i=1

∑

n
i ( i i

T
i i

T )

G ∈ R

3×3

G = r u d
i=1

∑

n
i ( i i

T )

## 3. Comprehensive Matrix & Vector Representation

All equations can be expressed in full matrix-vector form across the entire dataset:

### 3.1 Matrices & Dimensions

1. Measurement Matrix | :
2. Center Matrix | :
3. Center-Shifted Difference Matrix | :
4. Calibrated Matrix | : Since | and | :
∇We = | G + G
n

2
(

T )

P ∈ Rn×3

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
V0 ∈ R

n×3

V0 = 1nv0 =
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
D ∈ R

n×3

D = P − V0 =

x1 − x0
x2 − x0
⋮
xn − x0

y1 − y0
y2 − y0
⋮
yn − y0

z1 − z0
z2 − z0
⋮
zn − z0
U ∈ Rn×3 | ui = Wdi | W = WT

U = DW =

u1
T
u2
T
⋮
un
T

5. Residual Vector :

### 3.2 Matrix Accumulations

The sums over the points are exact matrix products:

1. Center Accumulator Vector | :
2. Outer-Product Accumulator Matrix | :

### 3.3 Final Gradient Equations

r ∈ Rn

r = | =

∥u1∥ − 1.0

2
∥u2∥ − 1.0

2
⋮
∥un∥ − 1.0

2

r1
r2
⋮
rn

n

su ∈ R

3

su = U r =
T

∑i=1 r u

n
i i,x
∑i=1 r u

n
i i,y
∑i=1 r u

n
i i,z

G ∈ R³×3

G = U diag(r)D =

T r u d

i=1

∑

n
i ( i i

T )

∇v0 e = − Ws =
n

4
u − W U r
n

4
(

T )

∇We = G + G =
n

2
(

T ) U diag(r)D + D diag(r)U
n

2
(
T | T | )

## 4. Hardware SIMD Acceleration on ESP32-S3

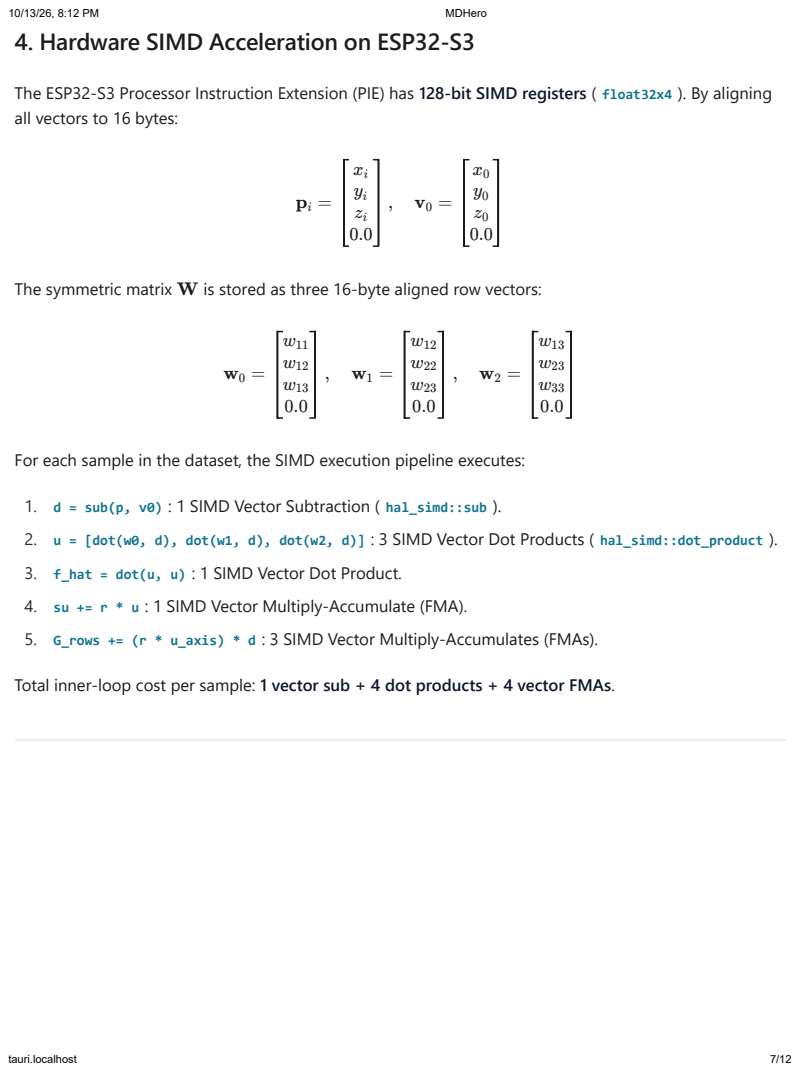
[picture p106: page 7]
The symmetric matrix; is stored as three 16-byte aligned row vectors:

The ESP32-S3 Processor Instruction Extension (PIE) has 128-bit SIMD registers ( float32x4 ). By aligning
all vectors to 16 bytes:

For each sample in the dataset, the SIMD execution pipeline executes:

1. d = sub(p, v0) : 1 SIMD Vector Subtraction ( hal_simd::sub ).

2. u = [dot(w0, d), dot(w1, d), dot(w2, d)] : 3 SIMD Vector Dot Products ( hal_simd::dot_product ).
3. f_hat = dot(u, u) : 1 SIMD Vector Dot Product.
4. su += r * u : 1 SIMD Vector Multiply-Accumulate (FMA).
5. G_rows += (r * u_axis) * d : 3 SIMD Vector Multiply-Accumulates (FMAs).

Total inner-loop cost per sample: 1 vector sub + 4 dot products + 4 vector FMAs.

## 5. Production C++ Implementation for FC_v01

#include "platforms/hal/hal_simd.h"

#include "core/math/matrix.h"

// 16-byte aligned vector matching 128-bit ESP32-S3 PIE struct alignas(16) Vec4f {
float x, y, z, w;
};

struct SymmetricMatrix3x3 {
Vec4f row0; // [w11, w12, w13, 0] Vec4f row1; // [w12, w22, w23, 0] Vec4f row2; // [w13, w23, w33, 0] };

struct RotatedEllipsoidCalibResult {
Vec4f v0; | // Hard-iron bias [x0, y0, z0]
SymmetricMatrix3x3 W; | // Symmetric soft-iron matrix
float final_rmse; | // Root Mean Squared Error
bool converged; | // Convergence status
};

void compute_symmetric_ellipsoid_gradient_simd( const Vec4f* dataset,
size_t n,
const Vec4f& v0,
const SymmetricMatrix3x3& W, Vec4f& grad_v0,
SymmetricMatrix3x3& grad_W,
float& current_mse
){
if(dataset == nullptr || n == 0) return;

Vec4f s_u = { 0.0f, 0.0f, 0.0f, 0.0f }; Vec4f g_row0 = { 0.0f, 0.0f, 0.0f, 0.0f }; Vec4f g_row1 = { 0.0f, 0.0f, 0.0f, 0.0f }; Vec4f g_row2 = { 0.0f, 0.0f, 0.0f, 0.0f }; float total_sq_err = 0.0f;

#if (ENABLE_SIMD_ACCELERATION)

for(size_t i = 0; i < n; ++i){ const Vec4f& p = dataset[i];

Vec4f d = { p.x - v0.x, p.y - v0.y, p.z - v0.z, 0.0f };

Vec4f u = {
hal_simd::dot_product(&W.row0.x, &d.x, 3), hal_simd::dot_product(&W.row1.x, &d.x, 3), hal_simd::dot_product(&W.row2.x, &d.x, 3), 0.0f
};

float f_hat = hal_simd::dot_product(&u.x, &u.x, 3); float r_i = f_hat - 1.0f;
total_sq_err += r_i * r_i;

s_u.x += r_i * u.x;
s_u.y += r_i * u.y;
s_u.z += r_i * u.z;

float rx = r_i * u.x;
float ry = r_i * u.y;
float rz = r_i * u.z;

g_row0.x += rx * d.x; g_row0.y += rx * d.y; g_row0.z += rx * d.z; g_row1.x += ry * d.x; g_row1.y += ry * d.y; g_row1.z += ry * d.z; g_row2.x += rz * d.x; g_row2.y += rz * d.y; g_row2.z += rz * d.z; }
#else

for(size_t i = 0; i < n; ++i){
const Vec4f& p = dataset[i];
float dx = p.x - v0.x, dy = p.y - v0.y, dz = p.z - v0.z;

float ux = W.row0.x * dx + W.row0.y * dy + W.row0.z * dz; float uy = W.row1.x * dx + W.row1.y * dy + W.row1.z * dz; float uz = W.row2.x * dx + W.row2.y * dy + W.row2.z * dz;

float f_hat = ux * ux + uy * uy + uz * uz;
float r_i = f_hat - 1.0f;
total_sq_err += r_i * r_i;

s_u.x += r_i * ux; s_u.y += r_i * uy; s_u.z += r_i * uz;

float rx = r_i * ux, ry = r_i * uy, rz = r_i * uz;
g_row0.x += rx * dx; g_row0.y += rx * dy; g_row0.z += rx * dz; g_row1.x += ry * dx; g_row1.y += ry * dy; g_row1.z += ry * dz; g_row2.x += rz * dx; g_row2.y += rz * dy; g_row2.z += rz * dz;

## 6. Real-Time Flight Loop Calibration

Once calibration determines | and | , subsequent live measurements | are calibrated in real time
in the flight loop via a single matrix-vector multiplication:

If the flight controller desires output in Gauss (or microTesla) rather than normalized unit sphere, multiply by the reference magnetic field magnitude :

Using hal_simd :

}
#endif

current_mse = total_sq_err / static_cast<float>(n);

float scale_v0 = -4.0f / static_cast<float>(n);
grad_v0.x = scale_v0 * (W.row0.x * s_u.x + W.row0.y * s_u.y + W.row0.z * s_u.z); grad_v0.y = scale_v0 * (W.row1.x * s_u.x + W.row1.y * s_u.y + W.row1.z * s_u.z); grad_v0.z = scale_v0 * (W.row2.x * s_u.x + W.row2.y * s_u.y + W.row2.z * s_u.z); grad_v0.w = 0.0f;

float scale_W = 2.0f / static_cast<float>(n);
grad_W.row0 = { scale_W * (g_row0.x + g_row0.x), scale_W * (g_row0.y + g_row1.x), scale_W * (g_row0.z + g_row2.x), 0.0f };
grad_W.row1 = { grad_W.row0.y, scale_W * (g_row1.y + g_row1.y), scale_W * (g_row1.z + g_row2.y), 0.0f };
grad_W.row2 = { grad_W.row0.z, grad_W.row1.z, scale_W * (g_row2.z + g_row2.z), 0.0f };
}
v0 | W | mraw

mcalib = W(mraw − v0)

B0

mcalib_gauss = B0 ⋅ W(mraw − v0)

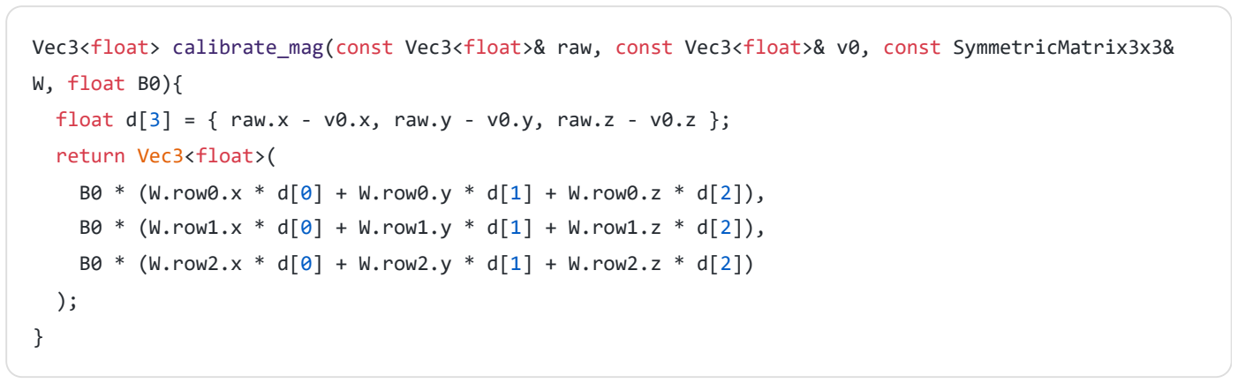
[picture p107: figure]
W, float B0){; return Vec3<float>(

## 7. Empirical Flight Data Calibration Results & Verification

The symmetric gradient descent calibration algorithm was evaluated on middle flight magnetometer
data using universal_flight_analyzer.py (Option 11).

### 7.1 Optimization Convergence (Epoch vs. RMSE)

The optimization converges smoothly under the Adam optimizer and halts automatically when the error
delta satisfies the configured tolerance ( | ):

Vec3<float> calibrate_mag(const Vec3<float>& raw, const Vec3<float>& v0, const SymmetricMatrix3x3&

float d[3] = { raw.x - v0.x, raw.y - v0.y, raw.z - v0.z };

B0 * (W.row0.x * d[0] + W.row0.y * d[1] + W.row0.z * d[2]), B0 * (W.row1.x * d[0] + W.row1.y * d[1] + W.row1.z * d[2]), B0 * (W.row2.x * d[0] + W.row2.y * d[1] + W.row2.z * d[2])

∣ΔRMSE∣ < 10⁻⁶

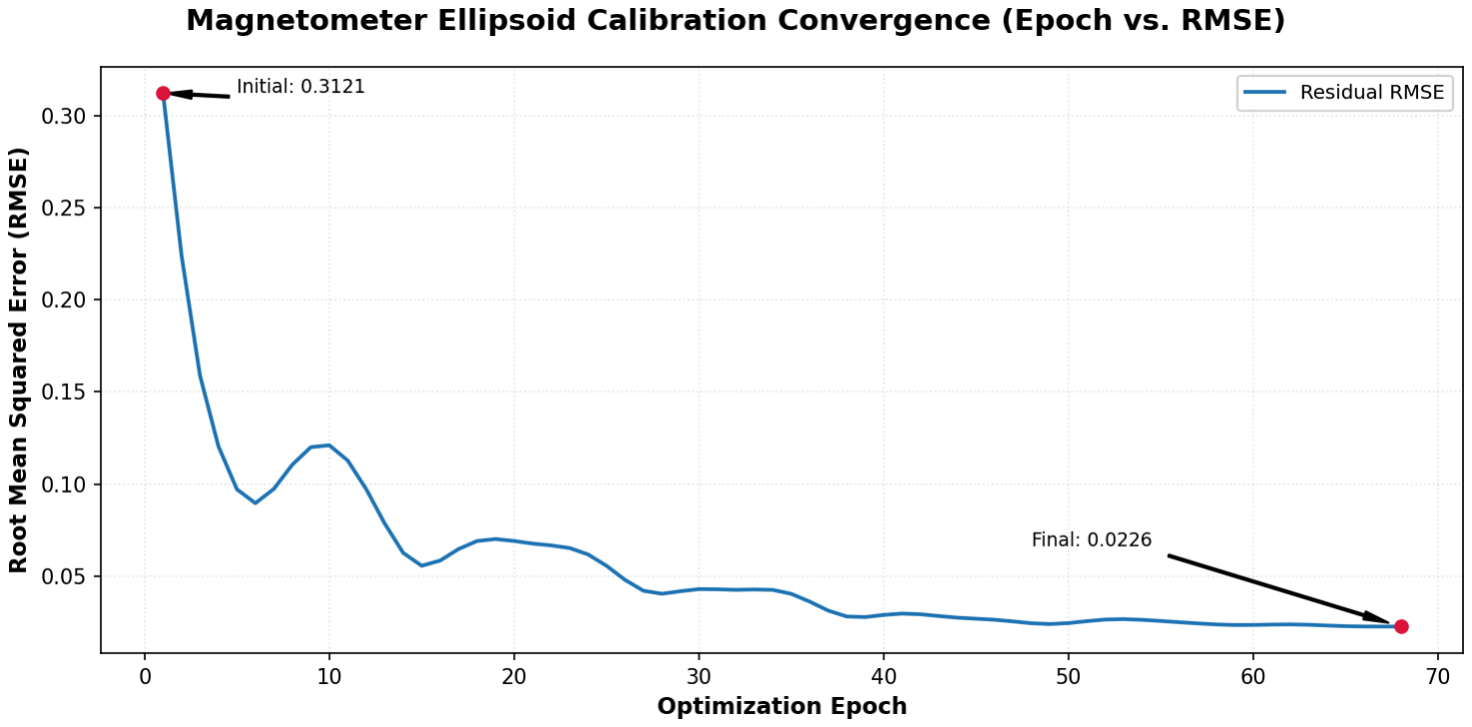
[picture p108: figure]

Monotonic Convergence: Initial isotropic sphere estimation shows high residual error which
decreases monotonically as | and symmetric | adapt.
Early Stopping: The optimizer detects plateauing error curvature and terminates early, preserving computation cycles.

### 7.2 Calibrated vs. Uncalibrated 3-Plane Projections

The figure below compares the raw distorted flight data (gray) against the calibrated measurements (colored) across the XY, XZ, and YZ projection planes, overlaid with the ideal target reference sphere (red dashed circle):

Magnetometer XY Plane: The hard-iron center bias is shifted back to and the eccentric shape is rounded to the target radius.
Magnetometer XZ Plane: The raw tilt (previously rotated by roughly ) is unskewed, aligning the measurements with the circular target boundary.
Magnetometer YZ Plane: Cross-axis coupling between the Y and Z axes is eliminated, producing a spherical distribution.
v0 | W

(0, 0)

25

∘
