pacman314159/OISP-Drone-Research/BLDC Voltage PWM Thrust Test - Copy.png

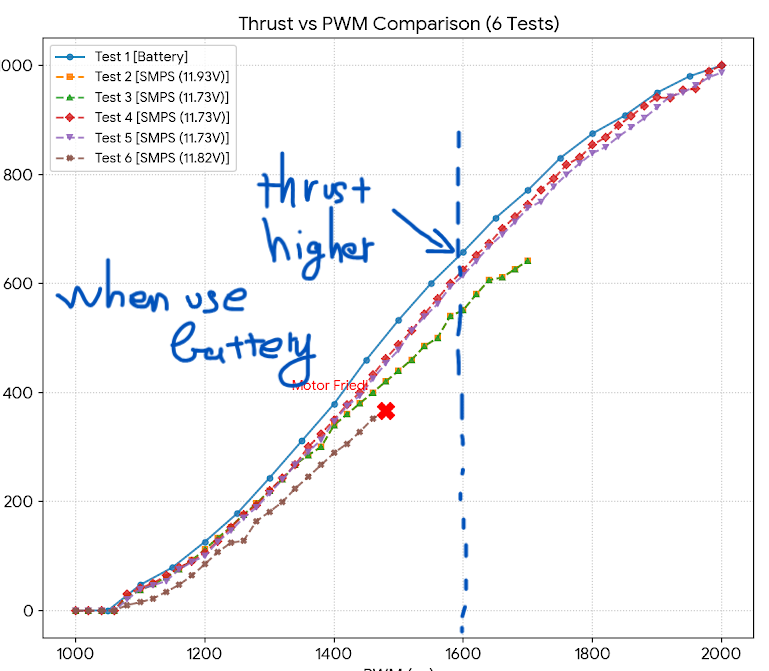
BLDC Voltage PWM Thrust Test - Copy.png
