pacman314159/OISP-Drone-Research/BLDC Voltage PWM Thrust Test.png

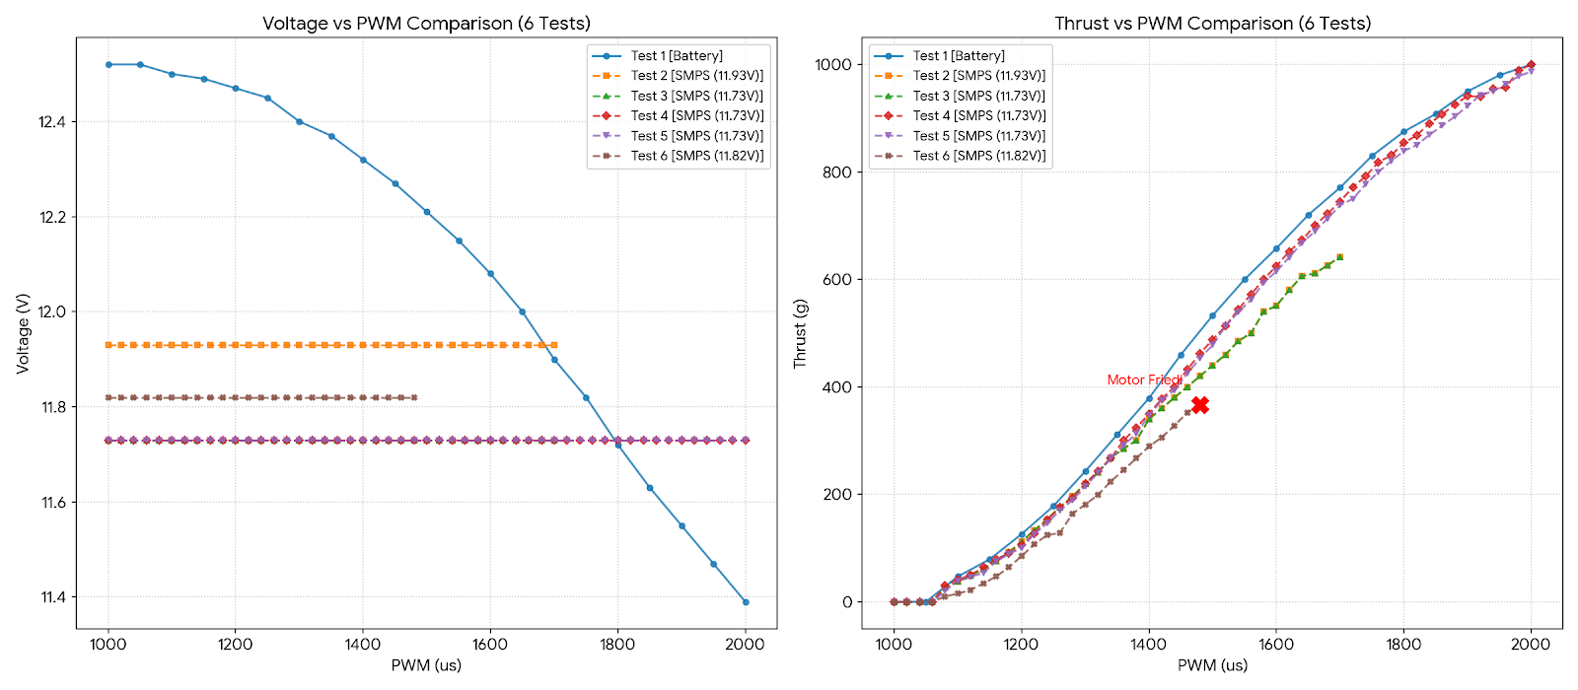
BLDC Voltage PWM Thrust Test.png
