pacman314159/OISP-Drone-Research/research_docs/Timing constrains derivation from Control Theory params.pdf

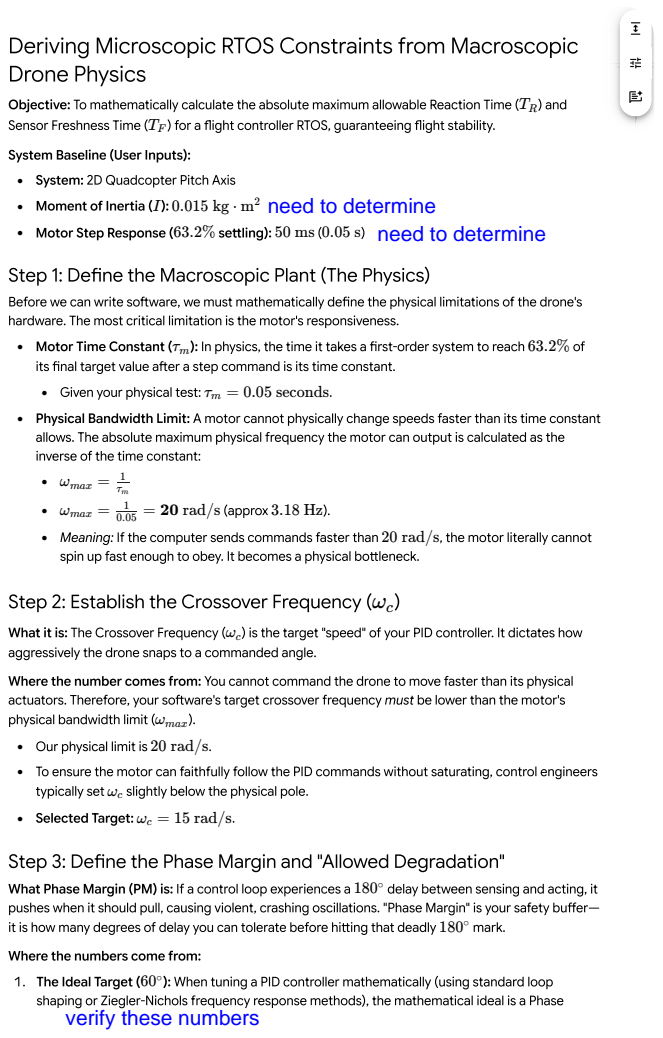
[picture p111: page 1]
τm = 0.05 seconds; ωmax = τm; ωmax = 0.05 = ¹; 20 rad/s; ωmax 20 rad/s; ωc = 15 rad/s

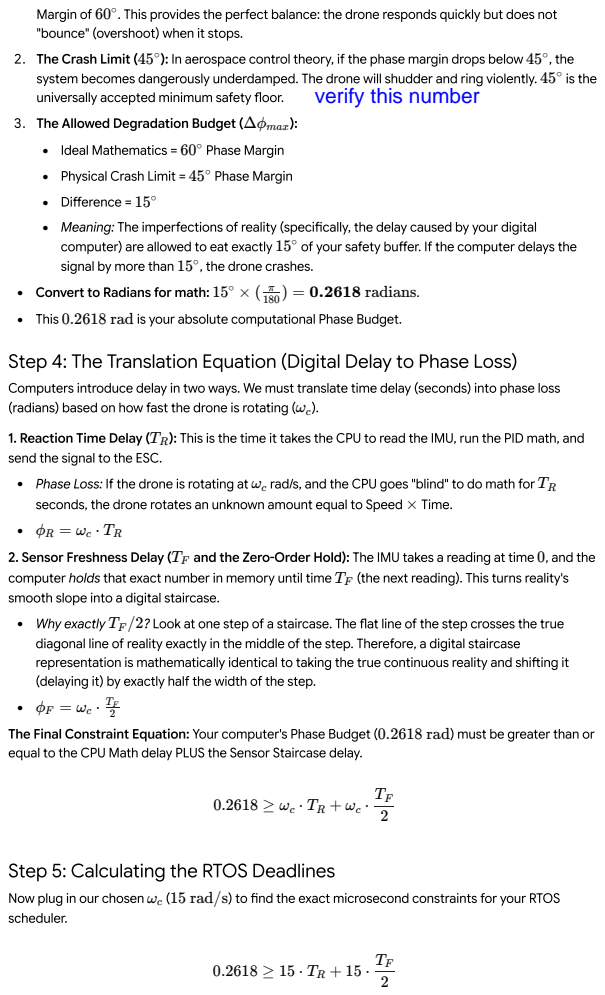
[picture p112: page 2]
Δϕmax; 0.2618 radians; 0.2618 rad; ωc 15 rad/s

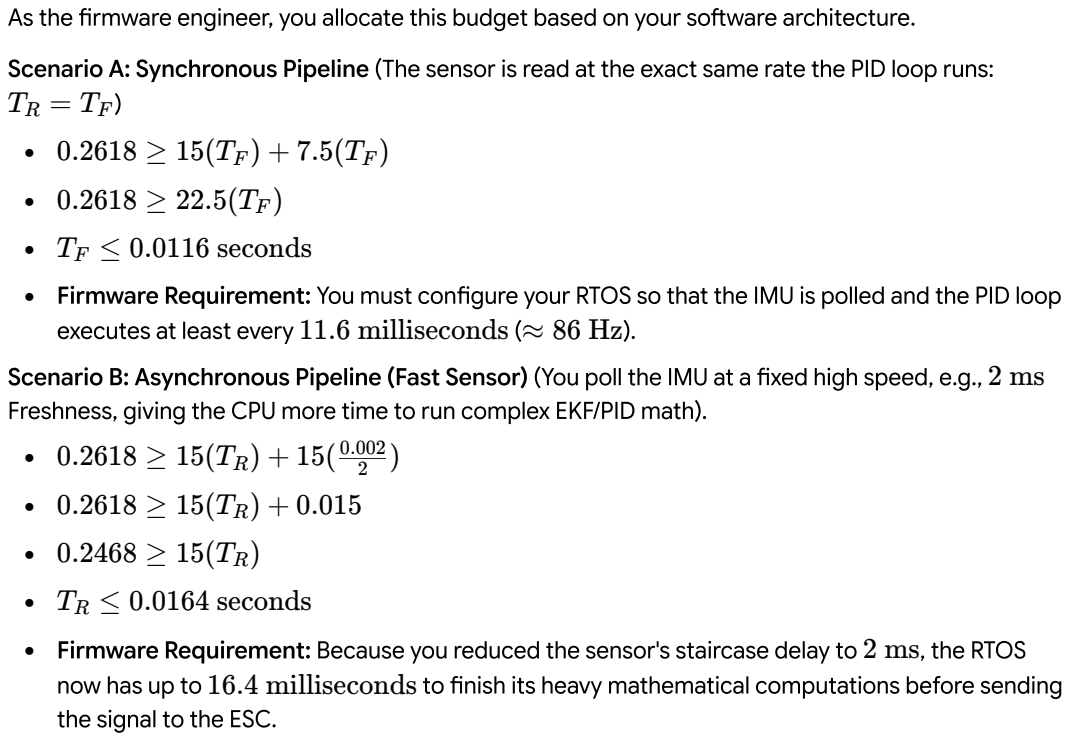
[picture p113: page 3]
TR = TF 0.2618 ≥ 15(TF ) + 7.5(TF ) 0.2618 ≥ 22.5(TF ) TF ≤ 0.0116 seconds; 11.6 milliseconds ≈ 86 Hz; 0.2618 ≥ 15(TR) + 0.015 0.2468 ≥ 15(TR) TR ≤ 0.0164 seconds; 16.4 milliseconds
