pacman314159/OISP-Drone-Research/firmware/FC_v01/documents/RTOS Architecture.pdf

# Conventions

## FLIGHT CONTROL SYSTEM

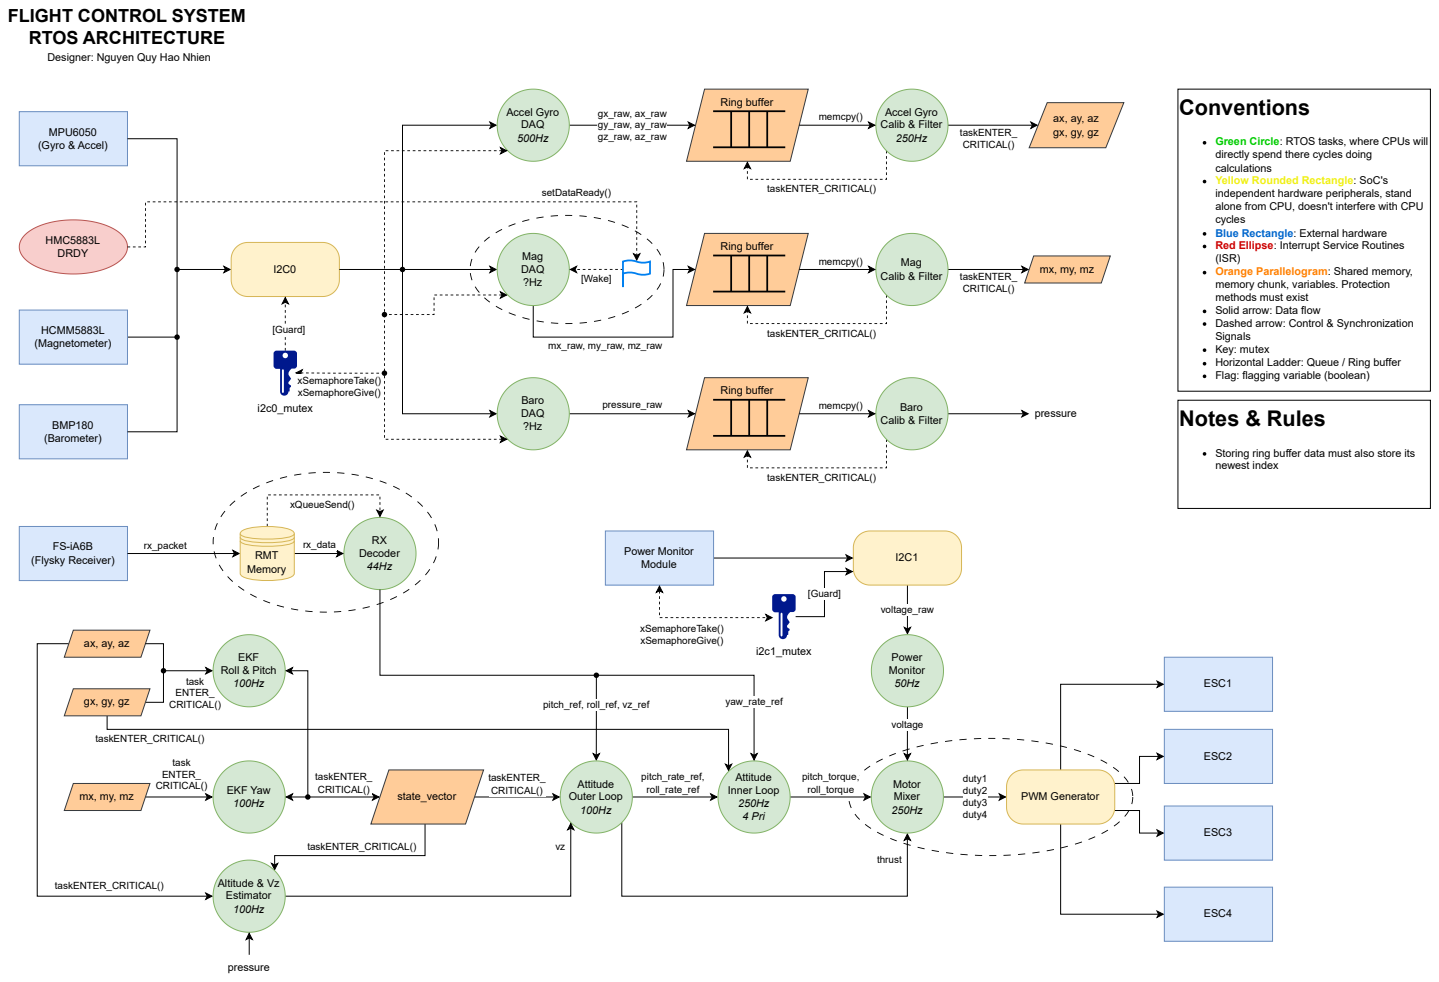
[picture p114: page 1]
task ENTER_ CRITICAL(); taskENTER_CRITICAL(); MPU6050; (Gyro & Accel); HCMM5883L (Magnetometer); BMP180 (Barometer); [Guard]; i2c0_mutex; xSemaphoreTake() xSemaphoreGive(); gx_raw, ax_raw gy_raw, ay_raw gz_raw, az_raw; Accel Gyro DAQ 500Hz; pressure_raw Baro DAQ ?Hz; FS-iA6B (Flysky Receiver); HMC5883L DRDY; setDataReady(); mx_raw, my_raw, mz_raw; Mag DAQ; [Wake]; pitch_ref, roll_ref, vz_ref; RX Decoder 44Hz; rx_packet; rx_data; xQueueSend(); RMT Memory; taskENTER_ CRITICAL()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

Designer: Nguyen Quy Hao Nhien

Green Circle: RTOS tasks, where CPUs will
directly spend there cycles doing
calculations
Yellow Rounded Rectangle: SoC's
independent hardware peripherals, stand
alone from CPU, doesn't interfere with CPU
cycles
Blue Rectangle: External hardware
Red Ellipse: Interrupt Service Routines
(ISR)
Orange Parallelogram: Shared memory,
memory chunk, variables. Protection
methods must exist
Solid arrow: Data flow
Dashed arrow: Control & Synchronization
Signals
Key: mutex
Horizontal Ladder: Queue / Ring buffer
Flag: flagging variable (boolean)
Notes & Rules

Storing ring buffer data must also store its
newest index
