pacman314159/OISP-Drone-Research/pcb/FC_v01/FC_v01.pdf

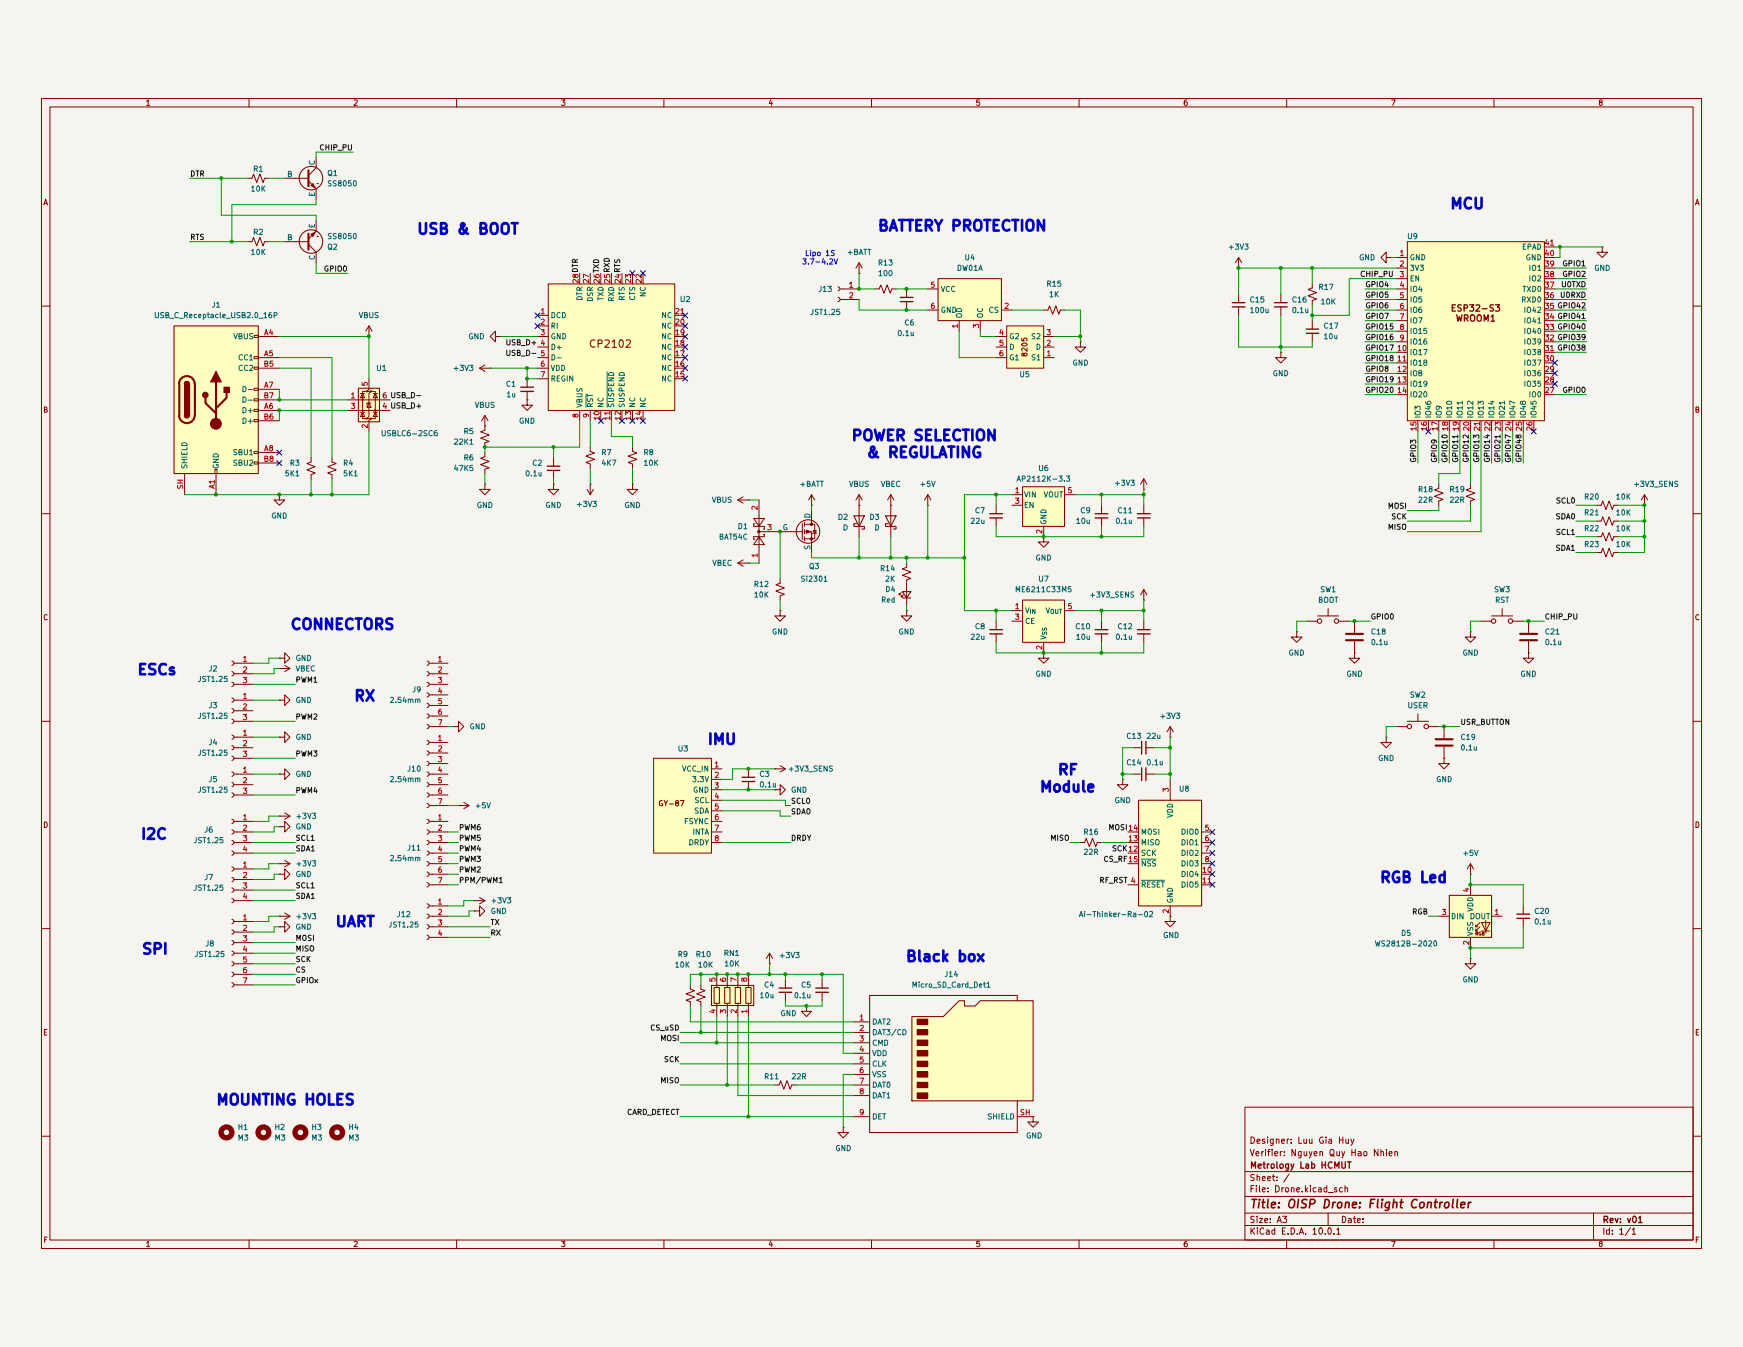
[picture p115: page 1]
