pacman314159/OISP-Drone-Research/pcb/FC_v02/FC_v02.kicad_pcb

## KiCad design pcb/FC_v02/FC_v02.kicad_pcb (2026-10-13)

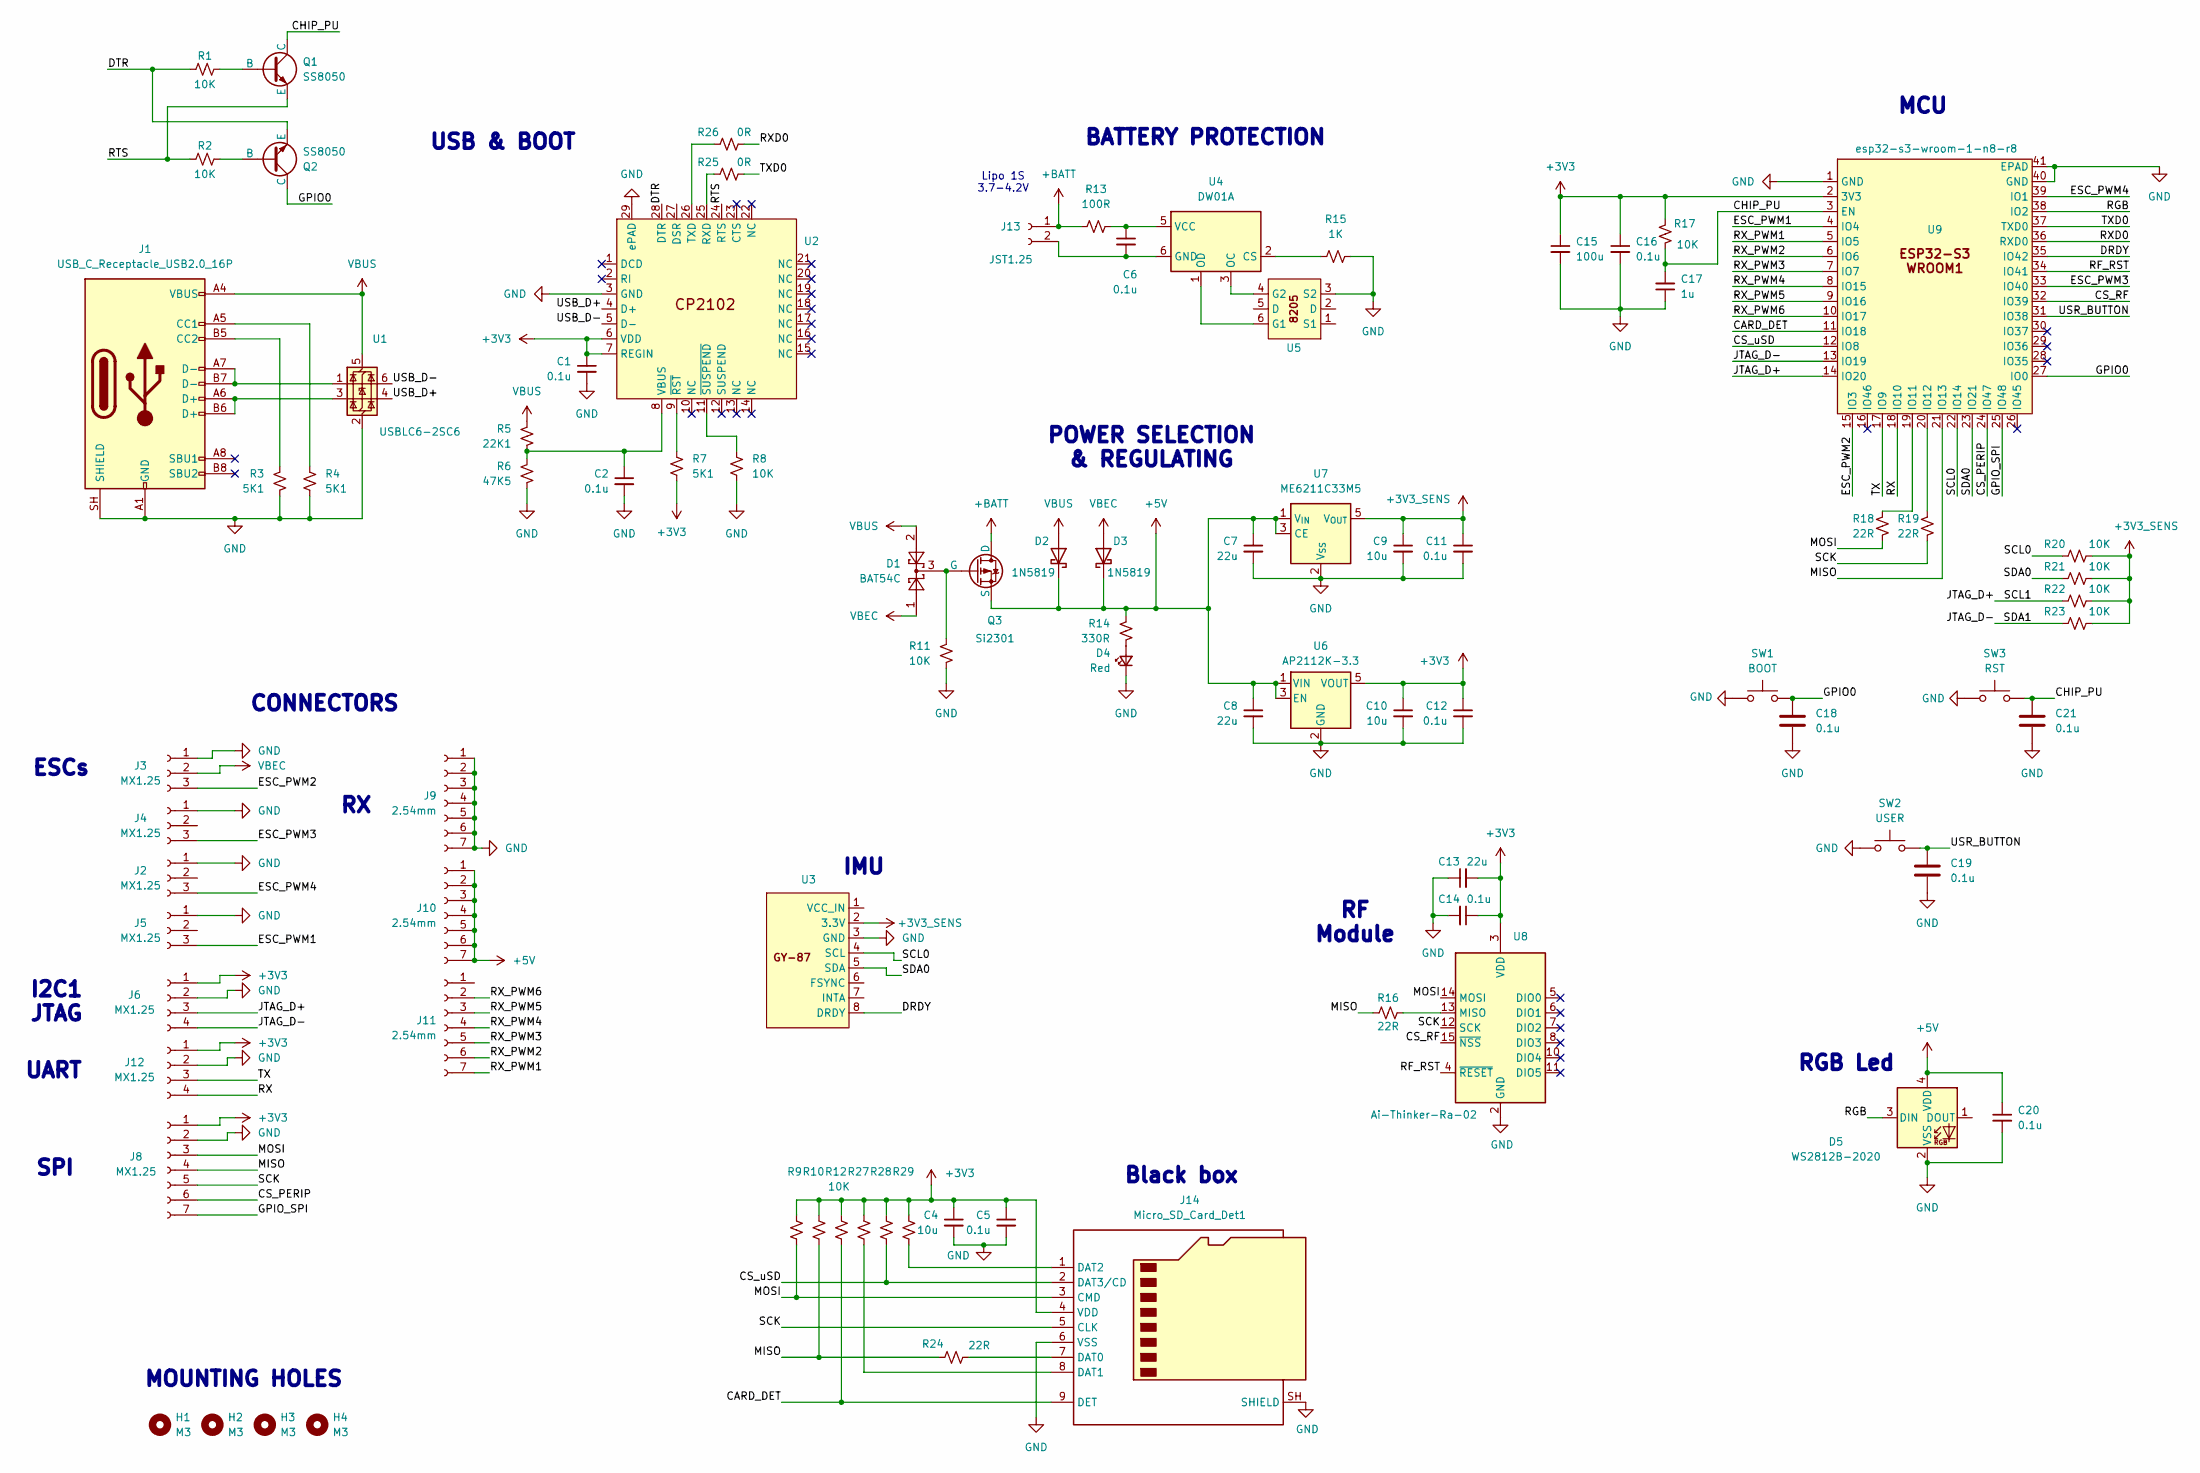
[picture p116: schematic FC_v02.kicad_sch, OISP Flight Controller]

Parts:
C1, C2, C5, C6, C11, C12, C14, C16, C18, C19, C20, C21: 0.1u; C_0603_1608Metric
C4, C9, C10: 10u; C_0805_2012Metric
C7, C8: 22u; CP_EIA-3216-10_Kemet-I
C13: 22u; C_0805_2012Metric
C15: 100u; CP_EIA-3216-10_Kemet-I
C17: 1u; C_0603_1608Metric
D1: BAT54C; SOT-23
D2, D3: 1N5819; D_SOD-123
D4: Red; LED_0805_2012Metric
D5: WS2812B-2020; LED_WS2812B-2020_PLCC4_2.0x2.0mm
H1, H2, H3, H4: M3; MountingHole_3.2mm_M3_DIN965_Pad
J1: USB_C_Receptacle_USB2.0_16P; USB_C_Receptacle_GCT_USB4105-xx-A_16P_TopMnt_Horizontal
J2, J3, J4, J5: MX1.25; MX_1.25mm_RA_SMD_3P
J6, J12: MX1.25; MX_1.25mm_RA_SMD_4P
J8: MX1.25; MX_1.25mm_RA_SMD_8P
J9, J10, J11: 2.54mm; _PinSocket_1x07_P2.54mm_Vertical
J13: JST1.25; MX_1.25mm_RA_SMD_2P
J14: Micro_SD_Card_Det1; Micro_SD_Card_Socket
Q1, Q2: SS8050; SOT-23
Q3: Si2301; SOT-23
R1, R2, R8, R9, R10, R11, R12, R17, R20, R21, R22, R23, R27, R28, R29: 10K; R_0603_1608Metric
R3, R4, R7: 5K1; R_0603_1608Metric
R5: 22K1; R_0603_1608Metric
R6: 47K5; R_0603_1608Metric
R13: 100R; R_0603_1608Metric
R14: 330R; R_0603_1608Metric
R15: 1K; R_0603_1608Metric
R16, R18, R19, R24: 22R; R_0603_1608Metric
R25, R26: 0R; R_0603_1608Metric
SW1: BOOT; SW_Push_3x4x2.5mm
SW2: USER; SW_Push_3x4x2.5mm
SW3: RST; SW_Push_3x4x2.5mm
U1: USBLC6-2SC6; SOT-23-6
U2: CP2102; QFN-28-1EP_5x5mm_P0.5mm_EP3.25x3.25mm_ThermalVias
U3: GY-87
U4: DW01A; SOT-23-6
U5: 8205; TSOT-23-6
U6: AP2112K-3.3; SOT-23-5
U7: ME6211C33M5; SOT-23-5
U8: Ai-Thinker-Ra-02; Ai-Thinker-Ra-01-LoRa
U9: esp32-s3-wroom-1-n8-r8; ESP32-S3-WROOM-1

Connections:
+3V3: C1.1, C4.1, C5.1, C10.1, C12.1, C13.2, C14.1, C15.1, C16.1, J6.1, J8.1, J12.1, J14.4 (VDD), R7.2, R9.1, R10.1, R12.1, R17.1, R27.1, R28.1, R29.1, U2.6 (VDD), U2.7 (REGIN), U6.5 (VOUT), U8.3 (VDD), U9.2 (3V3)
+3V3_SENS: C9.1, C11.1, R20.2, R21.2, R22.2, R23.2, U3.2 (3.3V), U7.5 (V_{OUT})
+5V: C7.1, C8.1, C20.1, D2.1 (K), D3.1 (K), D5.4 (VDD), J10.1, J10.2, J10.3, J10.4, J10.5, J10.6, J10.7, Q3.2 (S), R14.2, U6.1 (VIN), U6.3 (EN), U7.1 (V_{IN}), U7.3 (CE)
+BATT: J13.1, Q3.3 (D), R13.1
/CARD_DET: J14.9 (DET), R12.2, U9.11 (IO18)
/CHIP_PU: C17.2, C21.1, Q1.3 (C), R17.2, SW3.2, U9.3 (EN)
/CS_PERIP: J8.6, U9.24 (IO47)
/CS_RF: U8.15 (~NSS), U9.32 (IO39)
/CS_uSD: J14.2 (DAT3/CD), R28.2, U9.12 (IO8)
/DRDY: U3.8 (DRDY), U9.35 (IO42)
/DTR: Q2.2 (E), R1.1, U2.28 (DTR)
/ESC_PWM1: J5.3, U9.4 (IO4)
/ESC_PWM2: J3.3, U9.15 (IO3)
/ESC_PWM3: J4.3, U9.33 (IO40)
/ESC_PWM4: J2.3, U9.39 (IO1)
/GPIO0: C18.1, Q2.3 (C), SW1.2, U9.27 (IO0)
/GPIO_SPI: J8.7, U9.25 (IO48)
/JTAG_D+: J6.3, R22.1, U9.14 (IO20)
/JTAG_D-: J6.4, R23.1, U9.13 (IO19)
/MISO: J8.4, R10.2, R16.1, R24.1, U9.21 (IO13)
/MOSI: J8.3, J14.3 (CMD), R9.2, R18.2, U8.14 (MOSI)
/RF_RST: U8.4 (~RESET), U9.34 (IO41)
/RGB: D5.3 (DIN), U9.38 (IO2)
/RTS: Q1.2 (E), R2.1, U2.24 (RTS)
/RX: J12.4, U9.18 (IO10)
/RXD0: R26.2, U9.36 (RXD0)
/RX_PWM1: J11.7, U9.5 (IO5)
/RX_PWM2: J11.6, U9.6 (IO6)
/RX_PWM3: J11.5, U9.7 (IO7)
/RX_PWM4: J11.4, U9.8 (IO15)
/RX_PWM5: J11.3, U9.9 (IO16)
/RX_PWM6: J11.2, U9.10 (IO17)
/SCK: J8.5, J14.5 (CLK), R19.2, U8.12 (SCK)
/SCL0: R20.1, U3.4 (SCL), U9.22 (IO14)
/SDA0: R21.1, U3.5 (SDA), U9.23 (IO21)
/TX: J12.3, U9.17 (IO9)
/TXD0: R25.2, U9.37 (TXD0)
/USB_D+: U1.4 (I/O2), U2.4 (D+)
/USB_D-: U1.6 (I/O1), U2.5 (D-)
/USR_BUTTON: C19.1, SW2.2, U9.31 (IO38)
GND: C1.2, C2.2, C4.2, C5.2, C7.2, C8.2, C9.2, C10.2, C11.2, C12.2, C13.1, C14.2, C15.2, C16.2, C17.1, C18.2, C19.2, C20.2, C21.2, D4.1 (K), D5.2 (VSS), J1.A1 (GND), J1.A12 (GND), J1.B1 (GND), J1.B12 (GND), J1.SH (SHIELD), J2.1, J3.1, J4.1, J5.1, J6.2, J8.2, J9.1, J9.2, J9.3, J9.4, J9.5, J9.6, J9.7, J12.2, J14.6 (VSS), J14.SH (SHIELD), R3.2, R4.2, R6.2, R8.2, R11.1, R15.2, SW1.1, SW2.1, SW3.1, U1.2 (GND), U2.3 (GND), U2.29 (ePAD), U3.3 (GND), U5.3 (S2), U6.2 (GND), U7.2 (V_{SS}), U8.1 (GND), U8.2 (GND), U8.9 (GND), U8.16 (GND), U9.1 (GND), U9.40 (GND), U9.41 (EPAD)
unnamed: D4.2 (A), R14.1
unnamed: J1.A5 (CC1), R4.1
unnamed: J1.B5 (CC2), R3.1
unnamed: J1.A6 (D+), J1.B6 (D+), U1.3 (I/O2)
unnamed: J1.A7 (D-), J1.B7 (D-), U1.1 (I/O1)
unnamed: C6.2, J13.2, U4.6 (GND)
unnamed: J14.7 (DAT0), R24.2
unnamed: J14.8 (DAT1), R27.2
unnamed: J14.1 (DAT2), R29.2
unnamed: Q1.1 (B), R1.2
unnamed: Q2.1 (B), R2.2
unnamed: D1.3, Q3.1 (G), R11.2
unnamed: R25.1, U2.25 (RXD)
unnamed: R26.1, U2.26 (TXD)
unnamed: C2.1, R5.2, R6.1, U2.8 (VBUS)
unnamed: R7.1, U2.9 (~RST)
unnamed: R8.1, U2.11 (~SUSPEND)
unnamed: R15.1, U4.2 (CS)
unnamed: U4.3 (OC), U5.4 (G2)
unnamed: U4.1 (OD), U5.6 (G1)
unnamed: C6.1, R13.2, U4.5 (VCC)
unnamed: R16.2, U8.13 (MISO)
unnamed: R18.1, U9.19 (IO11)
unnamed: R19.1, U9.20 (IO12)
VBEC: D1.1, D3.2 (A), J3.2
VBUS: D1.2, D2.2 (A), J1.A4 (VBUS), J1.A9 (VBUS), J1.B4 (VBUS), J1.B9 (VBUS), R5.1, U1.5 (VBUS)

Notes on the sheet:
RF Module
ESCs
IMU
RGB Led
Black box
MCU
POWER SELECTION & REGULATING
USB & BOOT
Lipo 1S 3.7-4.2V
BATTERY PROTECTION
CONNECTORS
MOUNTING HOLES
SPI
I2C1 JTAG
UART

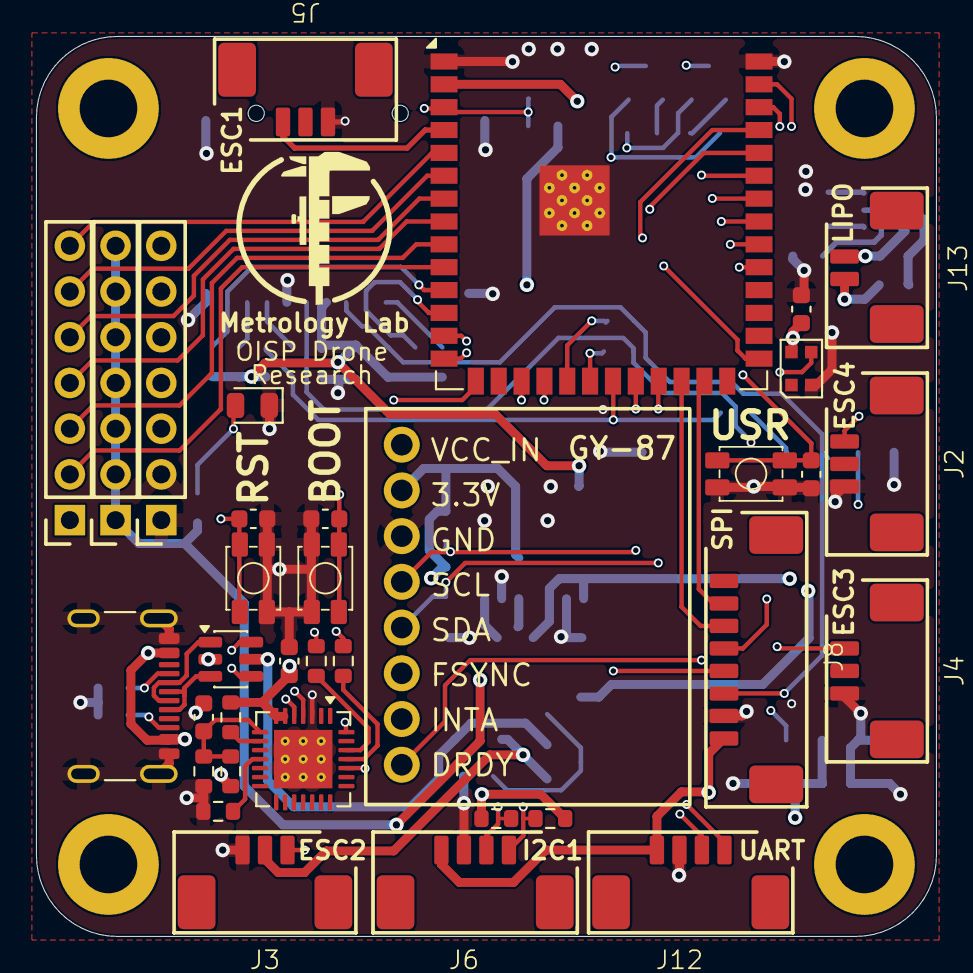
[picture p117: board FC_v02.kicad_pcb from above]

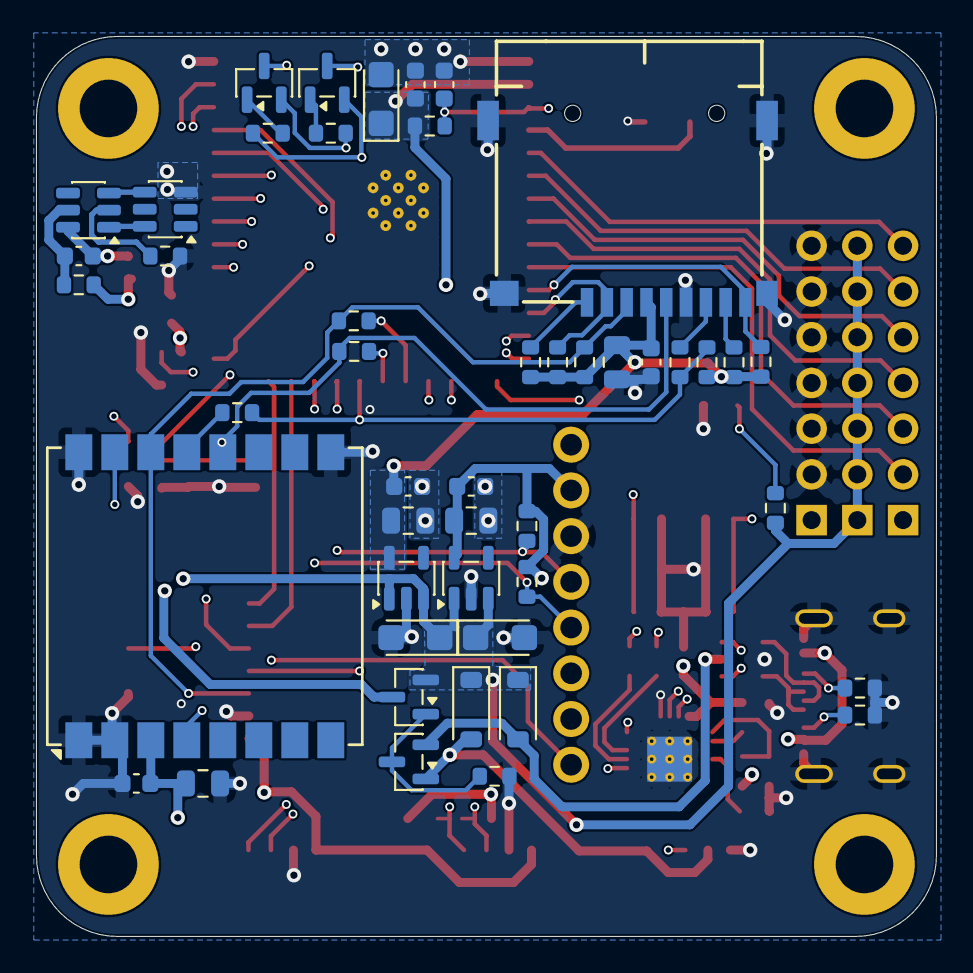
[picture p118: board FC_v02.kicad_pcb from below]

Board: 4 copper layers, 50.0 x 50.0 mm, 86 parts (47 on the bottom side), 67 nets.
