pacman314159/OISP-Drone-Research/pcb/Power_Monitor/Power_Monitor.kicad_pcb

## KiCad design pcb/Power_Monitor/Power_Monitor.kicad_pcb (2026-09-13)

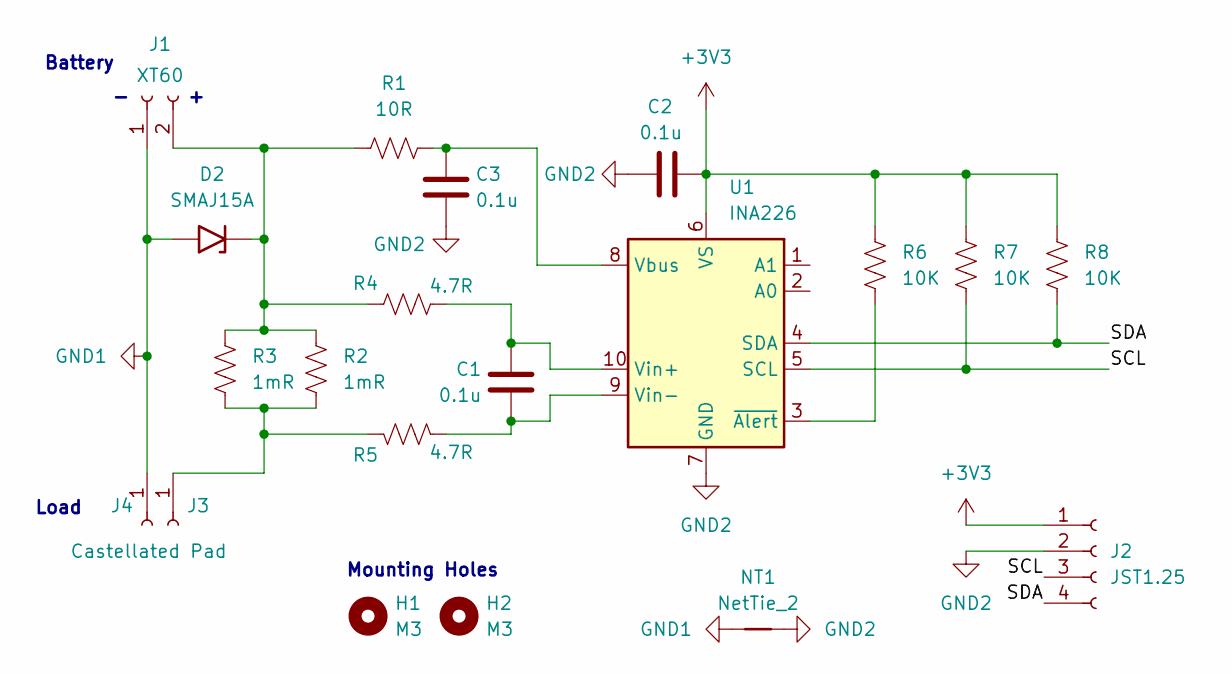
[picture p119: schematic Power_Monitor.kicad_sch, Modus Project: Power Monitor]

Parts:
C1, C2, C3: 0.1u; C_0402_1005Metric
D2: SMAJ15A; D_SMA
H1, H2: M3; MountingHole_3.2mm_M3_DIN965_Pad
J1: XT60; AMASS_XT60PW-M_1x02_P7.20mm_Horizontal
J2: JST1.25; JST_1.25mm_RA_SMD_4P
J3: Castellated Pad; Castellated_pad_high_side
J4: Castellated Pad; Castellated_pad_low_side
NT1: NetTie_2; NetTie-2_SMD_Pad0.5mm
R1: 10R; R_0402_1005Metric
R2, R3: 1mR; R_2512_6332Metric
R4, R5: 4.7R; R_0402_1005Metric
R6, R7, R8: 10K; R_0402_1005Metric
U1: INA226; TSSOP-10_3x3mm_P0.5mm

Connections:
+3V3: C2.1, J2.1, R6.2, R7.2, R8.2, U1.6 (VS)
/SCL: J2.3, R7.1, U1.5 (SCL)
/SDA: J2.4, R8.1, U1.4 (SDA)
GND1: D2.2 (A2), J1.1, J4.1 (Pin_1_1), NT1.1
GND2: C2.2, C3.2, J2.2, NT1.2, U1.7 (GND)
unnamed: D2.1 (A1), J1.2, R1.1, R2.1, R3.1, R4.1
unnamed: J3.1 (Pin_1_1), R2.2, R3.2, R5.1
unnamed: C3.1, R1.2, U1.8 (Vbus)
unnamed: C1.1, R4.2, U1.10 (Vin+)
unnamed: C1.2, R5.2, U1.9 (Vin-)
unnamed: R6.1, U1.3 (~Alert)

Notes on the sheet:
Mounting Holes
Load
Battery

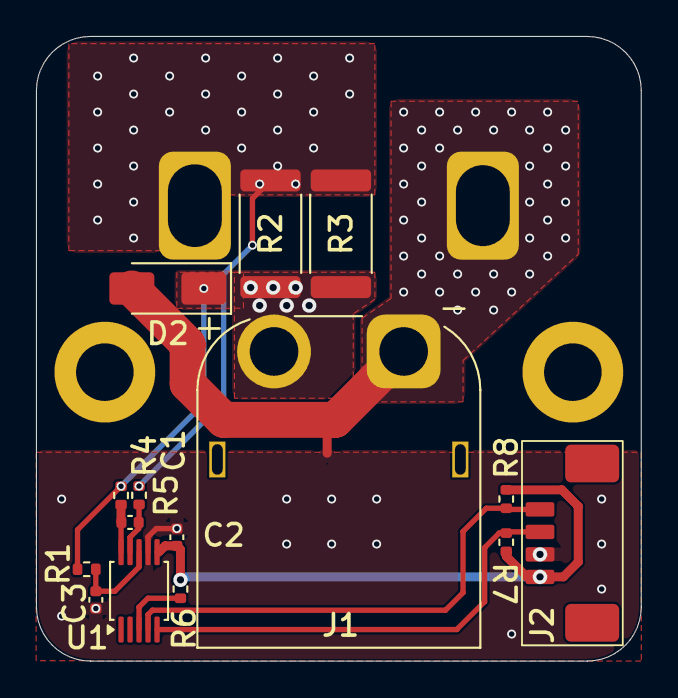
[picture p120: board Power_Monitor.kicad_pcb from above]

Board: 2 copper layers, 33.6 x 34.7 mm, 20 parts (0 on the bottom side), 11 nets.
