pacman314159/OISP-Drone-Research/firmware/FC_v01/src/main.cpp

#include <Arduino.h>
#include "config.h"
#include "freertos/projdefs.h"
#include "platforms/hal/hal_i2c.h"
#include "middleware/ipc.h"
#include "app/app.h"

extern "C" void app_main(){
  initArduino();

  init_ipc();

  Serial.begin(115200);
  HAL_I2C& i2c0 = get_i2c0_bus();
  i2c0.init(I2C_FREQ_HZ);

#if (!defined(DISABLE_I2C1_FOR_JTAG) || (DISABLE_I2C1_FOR_JTAG == 0))
  HAL_I2C& i2c1 = get_i2c1_bus();
  i2c1.init(I2C_FREQ_HZ);
#endif

  vTaskDelay(pdMS_TO_TICKS(50));

  app_start();
}
