pacman314159/OISP-Drone-Research/firmware/FC_v01/src/core/actuator/motor_tasks.h

#pragma once

// =============================================================================
// LAYER 4 FLIGHT CORE & ALGORITHMS - ACTUATOR & MOTOR MIXER TASK RUNNER
// =============================================================================

// High-Speed Motor Actuator Task Runner (250 Hz)
void motor_task(void* arg);
