pacman314159/OISP-Drone-Research/firmware/FC_v01/src/core/telemetry/telem_tasks.cpp

#include <Arduino.h>
#include "src/core/telemetry/telem_tasks.h"
#include "config.h"
#include "middleware/ipc.h"
#include "middleware/critical_section.h"
#include "middleware/sysview_tracing.h"
#include "drivers/telemetry/ble_driver.h"
#include "drivers/telemetry/ble_packet.h"

void ble_vec3_raw_trans_task(void* arg){
  const uint32_t task_id = TASK_BLE_VEC3_RAW_TRANS_ID;
  TelemSensorSource sensor_src = BLE_TELEM_SENSOR_SRC;
  uint32_t ts_snapshot[IMU_RAW_RING_BUF_SIZE];
  Vec3<float> vec3_snapshot[IMU_RAW_RING_BUF_SIZE];
  BleVec3Packet<float> ble_payload_buf[BLE_TELEM_SAMPLES_PER_PACKET];
  size_t ble_payload_count = 0;
  uint32_t last_ingested_ts = 0;

  TickType_t last_wake_time = xTaskGetTickCount();
  const TickType_t period_ticks = pdMS_TO_TICKS(1000 / TASK_BLE_VEC3_RAW_TRANS_FREQ_HZ);
  TickType_t last_packet_send_tick = xTaskGetTickCount();
  const TickType_t max_packet_interval_ticks = pdMS_TO_TICKS(1000 / BLE_TELEM_MIN_PACKET_FREQ_HZ);

  while(true){
    // Anti-windup overrun guard: if behind schedule reset it
    TickType_t now = xTaskGetTickCount();
    if((now - last_wake_time) > (period_ticks * 2))
      last_wake_time = now;
    vTaskDelayUntil(&last_wake_time, period_ticks);

    SYSVIEW_START(task_id); //=========================================================

    size_t ts_count = 0;
    size_t vec3_count = 0;

    switch(sensor_src){
      case TELEM_SENSOR_ACCEL:
        ts_count = raw_accel_gyro_timestamp.get_snapshot(ts_snapshot);
        vec3_count = accel_raw.get_snapshot(vec3_snapshot);
        break;
      case TELEM_SENSOR_MAG:
        ts_count = raw_mag_timestamp.get_snapshot(ts_snapshot);
        vec3_count = mag_raw.get_snapshot(vec3_snapshot);
        break;
      case TELEM_SENSOR_GYRO:
      default:
        ts_count = raw_accel_gyro_timestamp.get_snapshot(ts_snapshot);
        vec3_count = gyro_raw.get_snapshot(vec3_snapshot);
        break;
    }

    if(ts_count > 0 && vec3_count > 0){
      size_t sample_count = (ts_count < vec3_count) ? ts_count : vec3_count;
      for(size_t i = 0; i < sample_count; ++i){
        uint32_t current_ts = ts_snapshot[i];
        if(last_ingested_ts == 0 || static_cast<int32_t>(current_ts - last_ingested_ts) > 0){
          uint32_t ts_to_send = current_ts;
          if(BLE_TELEM_TIMESTAMP_UNIT == TIMESTAMP_UNIT_MILLISECONDS)
            ts_to_send = current_ts / 1000;

          ble_payload_buf[ble_payload_count++] = BleVec3Packet<float>(ts_to_send, vec3_snapshot[i]);
          last_ingested_ts = current_ts;

          if(ble_payload_count >= BLE_TELEM_SAMPLES_PER_PACKET){
            if(is_ble_connected())
              send_vec3_raw_telemetry_notification(reinterpret_cast<const uint8_t*>(ble_payload_buf), ble_payload_count * sizeof(BleVec3Packet<float>));
            ble_payload_count = 0;
            last_packet_send_tick = xTaskGetTickCount();
          }
        }
      }
    }

    TickType_t current_tick = xTaskGetTickCount();
    if(ble_payload_count > 0 && (current_tick - last_packet_send_tick) >= max_packet_interval_ticks){
      if(is_ble_connected())
        send_vec3_raw_telemetry_notification(reinterpret_cast<const uint8_t*>(ble_payload_buf), ble_payload_count * sizeof(BleVec3Packet<float>));
      ble_payload_count = 0;
      last_packet_send_tick = current_tick;
    }

    SYSVIEW_END(task_id); //=========================================================
  }
}

void ble_vec3_filtered_trans_task(void* arg){
  const uint32_t task_id = TASK_BLE_VEC3_FILT_TRANS_ID;
  TelemSensorSource sensor_src = BLE_TELEM_SENSOR_SRC;
  uint32_t ts_snapshot[IMU_FILT_RING_BUF_SIZE];
  Vec3<float> vec3_snapshot[IMU_FILT_RING_BUF_SIZE];
  BleVec3Packet<float> ble_payload_buf[BLE_TELEM_SAMPLES_PER_PACKET];
  size_t ble_payload_count = 0;
  uint32_t last_ingested_ts = 0;

  TickType_t last_wake_time = xTaskGetTickCount();
  const TickType_t period_ticks = pdMS_TO_TICKS(1000 / TASK_BLE_VEC3_FILT_TRANS_FREQ_HZ);
  TickType_t last_packet_send_tick = xTaskGetTickCount();
  const TickType_t max_packet_interval_ticks = pdMS_TO_TICKS(1000 / BLE_TELEM_MIN_PACKET_FREQ_HZ);

  while(true){
    TickType_t now = xTaskGetTickCount();
    if((now - last_wake_time) > (period_ticks * 2))
      last_wake_time = now;
    vTaskDelayUntil(&last_wake_time, period_ticks);

    SYSVIEW_START(task_id); //=========================================================

    size_t ts_count = 0;
    size_t vec3_count = 0;

    switch(sensor_src){
      case TELEM_SENSOR_ACCEL:
        ts_count = filtered_accel_gyro_timestamp.get_snapshot(ts_snapshot);
        vec3_count = accel_filtered.get_snapshot(vec3_snapshot);
        break;
      case TELEM_SENSOR_MAG:
        ts_count = filtered_mag_timestamp.get_snapshot(ts_snapshot);
        vec3_count = mag_filtered.get_snapshot(vec3_snapshot);
        break;
      case TELEM_SENSOR_GYRO:
      default:
        ts_count = filtered_accel_gyro_timestamp.get_snapshot(ts_snapshot);
        vec3_count = gyro_filtered.get_snapshot(vec3_snapshot);
        break;
    }

    if(ts_count > 0 && vec3_count > 0){
      size_t sample_count = (ts_count < vec3_count) ? ts_count : vec3_count;
      for(size_t i = 0; i < sample_count; ++i){
        uint32_t current_ts = ts_snapshot[i];
        if(last_ingested_ts == 0 || static_cast<int32_t>(current_ts - last_ingested_ts) > 0){
          uint32_t ts_to_send = current_ts;
          if(BLE_TELEM_TIMESTAMP_UNIT == TIMESTAMP_UNIT_MILLISECONDS)
            ts_to_send = current_ts / 1000;

          ble_payload_buf[ble_payload_count++] = BleVec3Packet<float>(ts_to_send, vec3_snapshot[i]);
          last_ingested_ts = current_ts;

          if(ble_payload_count >= BLE_TELEM_SAMPLES_PER_PACKET){
            if(is_ble_connected())
              send_vec3_filt_telemetry_notification(reinterpret_cast<const uint8_t*>(ble_payload_buf), ble_payload_count * sizeof(BleVec3Packet<float>));
            ble_payload_count = 0;
            last_packet_send_tick = xTaskGetTickCount();
          }
        }
      }
    }

    TickType_t current_tick = xTaskGetTickCount();
    if(ble_payload_count > 0 && (current_tick - last_packet_send_tick) >= max_packet_interval_ticks){
      if(is_ble_connected())
        send_vec3_filt_telemetry_notification(reinterpret_cast<const uint8_t*>(ble_payload_buf), ble_payload_count * sizeof(BleVec3Packet<float>));
      ble_payload_count = 0;
      last_packet_send_tick = current_tick;
    }

    SYSVIEW_END(task_id); //=========================================================
  }
}
