pacman314159/OISP-Drone-Research/firmware/FC_v01/src/core/math/estimator_tasks.h

#pragma once
#include "estimators.h"
#include "config.h"

// =============================================================================
// LAYER 4 FLIGHT CORE & ALGORITHMS - STATE ESTIMATOR TASK RUNNERS
// =============================================================================

// Layer 4 FreeRTOS Task Runners
void ekf_roll_pitch_task(void* arg);
void ekf_yaw_task(void* arg);
void ekf_altitude_task(void* arg);
