pacman314159/OISP-Drone-Research/firmware/FC_v01/src/platforms/targets/espressif/i2c_async.h

#pragma once
#include "platforms/hal/hal_i2c_async.h"
#include <driver/i2c_master.h>

class ESP32_I2C_ASYNC : public HAL_I2C_ASYNC {
public:
  ESP32_I2C_ASYNC(int port, int sda_pin, int scl_pin);
  ~ESP32_I2C_ASYNC() override;

  bool init(uint32_t frequency_hz = 400000) override;

  bool write_reg_async(uint8_t dev_addr, uint8_t reg_addr, uint8_t data, i2c_async_cb_t cb = nullptr, void* user_arg = nullptr) override;
  bool write_reg_multi_async(uint8_t dev_addr, uint8_t reg_addr, uint8_t* buf, size_t len, i2c_async_cb_t cb = nullptr, void* user_arg = nullptr) override;

  bool read_reg_async(uint8_t dev_addr, uint8_t reg_addr, uint8_t* out_data, i2c_async_cb_t cb = nullptr, void* user_arg = nullptr) override;
  bool read_reg_multi_async(uint8_t dev_addr, uint8_t reg_addr, uint8_t* buf, size_t len, i2c_async_cb_t cb = nullptr, void* user_arg = nullptr) override;

private:
  int                     _port;
  int                     _sda_pin;
  int                     _scl_pin;
  uint32_t                _frequency_hz;
  bool                    _initialized;
  i2c_master_bus_handle_t _bus_handle{nullptr};
};
