pacman314159/OISP-Drone-Research/firmware/FC_v01/src/core/sensor/daq_tasks.h

#pragma once
#include <freertos/FreeRTOS.h>
#include <freertos/task.h>

// Sensor Data Acquisition (DAQ) Task Functions
void accel_gyro_daq_task(void* arg);
void mag_daq_task(void* arg);
void baro_daq_task(void* arg);
void power_daq_task(void* arg);
