pacman314159/OISP-Drone-Research/(commit log)

2026-04-20 Add placeholder files to track empty directories
2026-04-21 Add PCB files
    [Drone.csv, Drone.kicad_pcb, Drone.kicad_sch]
2026-04-22 update pcb
    [Drone.kicad_sch]
2026-05-08 thrust testbench
2026-05-09 Add sensor firmware and testing framework
    - Created platformio.ini for ESP32-S3 SuperMini configuration.
    - Implemented GY87_MPU6050 sensor class for MPU6050 functionality.
    - Developed main application to read data from MPU6050 and HMC5883L sensors.
    - Added README for test directory explaining unit testing with PlatformIO.
    - Implemented LED test to verify FastLED functionality.
    - Created I2C scanner to detect connected devices.
    - Added timing test to measure performance of sensor readings.
    - Included various configuration functions for HMC5883L sensor.
    [HOLDER.3mf, HOLDER.gcode.3mf, HOLDER.ipt, HOLDER.stp]
2026-05-09 Add MPU6050 and BMP085 sensor integration with I2C communication
    - Implemented main functionality for reading accelerometer, gyroscope, and barometric pressure data using MPU6050 and BMP085 sensors.
    - Added functions for I2C device probing, reading/writing registers, and calculating temperature and pressure.
    - Initialized sensors in the setup function and configured their settings.
    - Implemented a loop to continuously read and print sensor data at specified intervals.
    - Created a README file for the test directory to provide information on unit testing with PlatformIO.
    [output.csv]
2026-05-09 Add initial project structure and sensor integration for ESP32-S3
2026-05-10 Refactor MPU6050 integration: add raw data storage and update setup for data reading
    [HOLDER.3mf, HOLDER.gcode.3mf, HOLDER.ipt, HOLDER.stp]
2026-05-10 Add main test code for MPU6050 sensor integration
2026-05-12 Refactor MPU6050 integration: replace MPU6050_clone with GY87_MPU6050, update initialization and data retrieval methods, and add timing test functionality.
    [timing.cpp]
2026-06-03 schematic: battery and power selection
    [Drone.kicad_sch]
2026-06-05 added footprints
    [Drone.kicad_pcb, Drone.kicad_sch]
2026-06-05 add footprints
2026-06-06 analyzer: imu distribution and fft
2026-06-13 power rail splitting
    [Drone.kicad_pcb, Drone.kicad_sch]
2026-06-13 added gy87
    [Drone.kicad_sch]
2026-06-19 (black box dont have footprint yet) (added rf module)
    [Drone.kicad_sch]
2026-06-20 [analyze] finish mag with pin interrupt
    [Drone.kicad_pcb, Drone.kicad_sch]
2026-06-21 Add GY87 MPU6050 and HMC5883L sensor classes with I2C communication
    - Implemented GY87_MPU6050 class for MPU6050 sensor with methods for initialization, configuration, and data retrieval.
    - Implemented GY87_HMC5883L class for HMC5883L sensor with methods for initialization, configuration, and data retrieval.
    - Created main application file to demonstrate sensor data acquisition.
    - Added test files for unit testing of MPU6050 and HMC5883L sensors.
    - Included README files for project structure and testing guidelines.
    - Implemented I2C scanner for detecting connected devices.
    - Added timing tests for performance evaluation of sensor data retrieval.
    [output.csv]
2026-07-08 FCDatMon feat successfully added: BLE
    [FCDatMon 2026-07-02_22-36.csv, FCDatMon 2026-07-05_23-40.csv, program_state_and_evts.xlsx]
2026-07-18 pcb layout: complete component positions
    [Bottom.step, Design 2.step, Drone.kicad_pcb, Drone.kicad_sch, Du toan.xlsx, GY87_10DOF_IMU.step, GY87_10DOF_IMU_NoPin.stp, MicroSD_Socket.STEP]
2026-07-18 pcb: complete component positions
2026-07-21 Add EKF sensor fusion components for GY87 sensor suite
    - Introduced Matrix class for mathematical operations, including matrix multiplication, addition, and inversion.
    - Implemented GY87_HMC5883L class for interfacing with the HMC5883L magnetometer, including methods for configuration and data retrieval.
    - Implemented GY87_MPU6050 class for interfacing with the MPU6050 accelerometer and gyroscope, including methods for configuration and data retrieval.
    - Added header files for both sensors to the include directory.
    - Created source files for both sensors to handle their respective functionalities.
2026-07-22 fc pcb: done; 3d model: initial frame and physical properties
    [Drone.kicad_pcb, Drone.kicad_sch, GY87_10DOF_IMU.step, GY87_10DOF_IMU_NoPin.stp, MEC-ASM-1000-F450_Frame.iam, MEC-PRT-1001-Base_Top.ipt, MEC-PRT-1002-Base_Bottom.ipt, MEC-PRT-1003-Arm_White.ipt]
2026-07-22 add README.md for Inventor Assembly
2026-07-23 Enhance I2C data handling and telemetry structure in EKF implementation
2026-07-30 development: 3d, power board, fc
    [AVI-PRT-5001-Propeller_10x45.ipt, BMP180.ipt, Brace^MicroSD_Socket.ipt, CP_EIA-1608-10_AVX-L.ipt, CP_EIA-3216-10_Kemet-I.ipt, C_0402_1005Metric.ipt, C_0603_1608Metric.ipt, C_0805_2012Metric.ipt]
2026-09-13 rtos architecture
    [BMP180.ipt, Bill of materials.xlsx, Brace^MicroSD_Socket.ipt, CP_EIA-1608-10_AVX-L.ipt, CP_EIA-3216-10_Kemet-I.ipt, C_0402_1005Metric.ipt, C_0603_1608Metric.ipt, C_0805_2012Metric.ipt]
2026-09-20 feat:ble telemetry
    [partitions.csv]
2026-10-13 feat(mag-calib): implement full 3D rotated ellipsoid SIMD calibration and system-wide updates
    - Implement 3D rotated and offset ellipsoid fitting (ellipsoid_fit.h/cpp) with Adam optimizer and analytical gradients
    - Enforce full hardware SIMD acceleration via Matrix and Vec3 overloaded operators
    - Normalize calibrated and filtered magnetometer output to unit sphere for EKF attitude estimation
    - Add continuous tumble acquisition with spatial-thinning distance gating in task_calib_mag
    - Forward user button clicks from FSM to signal calibration completion
    - Add Option 11 to universal_flight_analyzer.py with RMSE convergence and 3D projection plots
    - Consolidate firmware Layer 4 core directories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
